mhdelano-ai/ELISA/cad/out/assembly/section_port_insert_P_in_P_byp.png

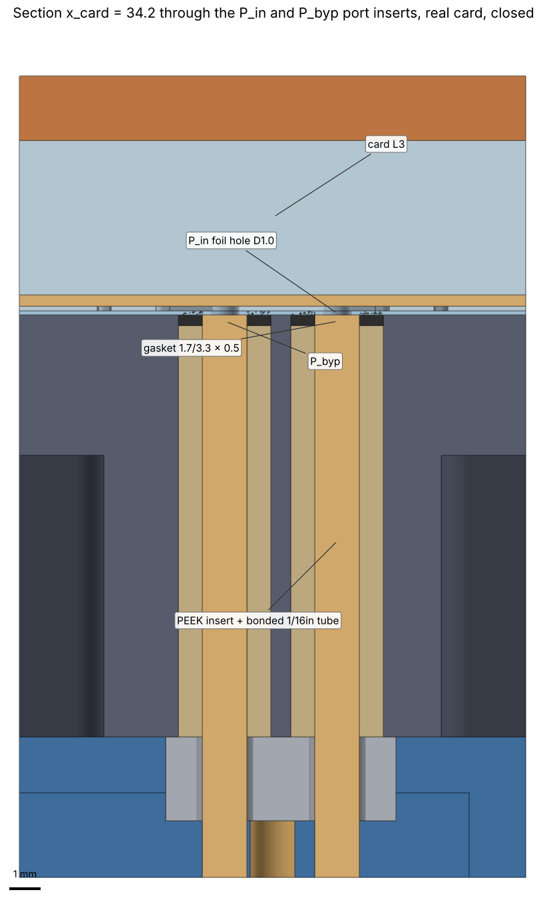
cad/out/assembly/section_port_insert_P_in_P_byp.png
