mhdelano-ai/ELISA/cad/out/assembly/section_cell_die_pogo_Md.png

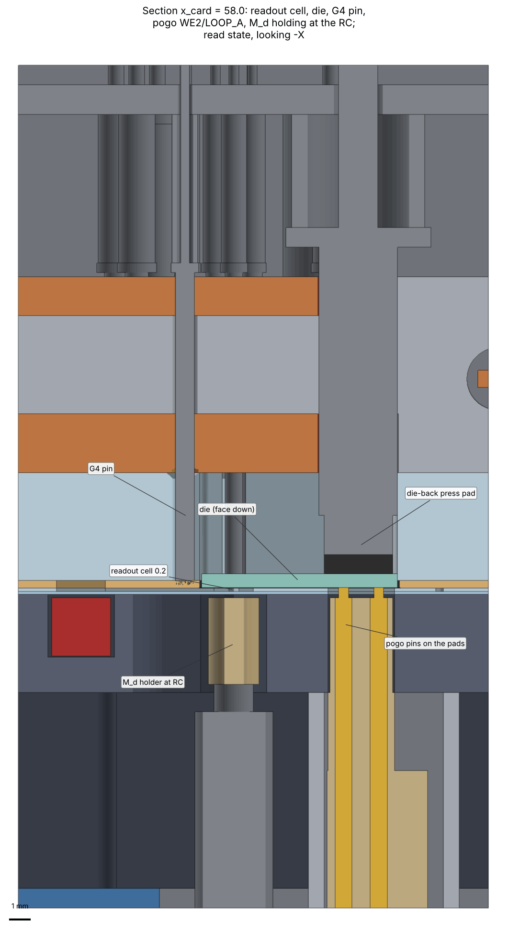
cad/out/assembly/section_cell_die_pogo_Md.png
