mhdelano-ai/ELISA/docs/25_session_record_physical_design.md

# Session record — physical design of cartridge A and its dock (2026-11-12/13)

A record of how docs/18–24 and `cad/` came about: what the user asked, every question put to the user and the answer
given, which agent did what, and where each output is. It contains no new technical claims; the authoritative tables
are in docs/23 (§8 choices, §9 deviations from docs/13, §10 open items) and docs/24 §8 (resolution of the review).

## 1. The request

> "Orchestrate Opus subagents to perform the physical design of the dock and the cartridges."

Followed by "Interview me if you have any questions." and, after the working branch was found to be behind `main`
(no cartridge documents yet), "Repo has been updated please retry".

## 2. Interview — every question and answer

| # | Question | Answer |
|---|---|---|
| 1 | Which cartridges? | A only (B and C′ not touched) |
| 2 | What is the deliverable? | 3D CAD, no automatic checks (STEP files, renders, design documents; one-off checks reported) |
| 3 | Which build stage? | C2 prototype (laminated card, CNC-milled COC upper body; dock from catalogue actuators and machined parts) |
| 4 | Which dock? | Dedicated A dock |
| 5 | Where does the dock stand? | Bench, beside the stack; no hard size limit, minimise footprint |
| 6 | How deep should the dock design go? | Mechanism + layout + enclosure (card bay detailed; pumps, bottles, electronics as placed envelope bodies) |
| 7 | Checkpoints? | No checkpoint (run to the end; agents' questions recorded as open items) |
| 8 | Who decides open points? | Agents decide and list the choices (docs/13 not edited; departures flagged as deviations) |

## 3. Agent tasks

All agents ran on the Opus model, in the background. `cad/elisa_cad/interface.py` was written first and is the single
source of truth for the geometry shared between the card and the dock.

| Phase | Agent task | Output |
|---|---|---|
| 1 | Card–dock interface definition | docs/18, `interface.py`, `cad/out/interface/` |
| 2 | Card physical design | docs/19, `cad/elisa_cad/card/` |
| 2 | Dock lid and head (valve plungers, pneumatics, clamp) | docs/20, `cad/elisa_cad/dock_upper/` |
| 2 | Dock lower bay (nest, anvil, magnets, electrode bay, thermal) | docs/21, `cad/elisa_cad/dock_lower/` |
| 2 | Dock base, fluidics layout, enclosure | docs/22, `cad/elisa_cad/dock_base/` |
| 3 | Integration: interface change requests, Revision B, top-level assembly, cross-module checks | docs/23, `cad/elisa_cad/assembly/` |
| 4 | Independent adversarial review (no edits to the design) | docs/24 §1–§7 |
| 5 | Resolution of the review findings, interface Revision C, full rebuild | docs/24 §8, edits in docs/18–23 and `cad/` |

Eight agent tasks. The four phase-2 agents worked in parallel against the phase-1 interface, which is why the
integration phase had about a dozen conflicts to settle (docs/23 §2).

## 4. Orchestrator decisions

The review ended with three questions for the user. Because the user had chosen "no checkpoint" and "agents decide",
the orchestrator set the direction for each and had them listed in docs/23 §8 as choices the user may overrule:

* **Carry-over:** the 1×10⁻⁴ criterion is fixed, so the design was changed until the paper budget of docs/13 §8.3
  closed again, rather than leaving the proof to the bench alone.
* **Reagent cold zone:** solve inside the 470 × 420 mm footprint first; a remote heat sink only as fallback.
* **Junction gates and drag slot:** local departures from docs/13 dimensions allowed, flagged as deviations.

## 5. Commits of the session

| Commit | Subject |
|---|---|
| `3d6dfdd` | Add card-dock interface definition for cartridge A (docs/18, cad/elisa_cad/interface.py) |
| `744bae3` | Add physical design of cartridge A for the C2 prototype (docs/19, cad/elisa_cad/card) |
| `39b167a` | Work in progress: dock lid, lower bay and base designs (agents still extending) |
| `2465d38` | Add dock lid and head design (docs/20, cad/elisa_cad/dock_upper); lower bay and base in progress |
| `853114a` | Work in progress: dock lower bay and base designs (agents still extending) |
| `e7f866e` | Add dock base, fluidics layout and enclosure design (docs/22, cad/elisa_cad/dock_base); lower bay in progress |
| `52fb70e` | Add dock lower bay design: nest, anvil, magnet bay, electrode bay (docs/21, cad/elisa_cad/dock_lower) |
| `d95b021` | Integrate card and dock modules (docs/23, interface Revision B, top-level assembly) |
| `7ed9bdc` | Add independent review of the dock and cartridge physical design (docs/24) |
| `fe7451d` | Resolve the review findings of the dock and cartridge design (interface Revision C, docs/24 §8) |

Plus the commit that adds this record and updates CLAUDE.md. Branch `claude/determined-hawking-8mvykx`; not merged
into `main`.

## 6. What is not in the repository

* The agents' full transcripts and the reviewer's scratch scripts (their results are in docs/24 §5).
* The optional `--all-states` STEP outputs (regenerate with the commands in `cad/README.md`); the default outputs in
  `cad/out/` match the code.
* Vendor pages and data sheets the agents opened (URLs are in the source sections of docs/18–24).
