mhdelano-ai/ELISA/results/design/inline_chamber.md

# One-step format with a timed in-line incubation chamber (approximation)

Revised after the final review (docs/08 S9, S13): thin-layer cell (Stage-3 default), stirred-capture factor sampled on [0.2, 1.0]/2.2 (mode 0.45), 1/0.96 transfer factor applied to every draw before P. '~' = chamber approximation.

| Variant | LOD nominal (pg/mL) | LOD median [5-95 %] | P(LOD<=1) | P(success) | time to result (min) | constraints |
|---|---|---|---|---|---|---|
| chamber, incubation 30 min, accumulation 10 min | 0.6 | 3.5 [0.51-1.6e+02] | ~0.17 | ~0.16 | 56.1 | ok |
| chamber, incubation 30 min, accumulation 7.5 min | 0.64 | 3.9 [0.54-1.8e+02] | ~0.16 | ~0.15 | 53.6 | ok |
| chamber, incubation 25 min, accumulation 10 min | 0.65 | 4.2 [0.57-1.7e+02] | ~0.15 | ~0.14 | 51.1 | ok |
| chamber, incubation 35 min, accumulation 5 min | 0.7 | 3.9 [0.55-1.9e+02] | ~0.16 | ~0.15 | 56.1 | ok |
