mhdelano-ai/ELISA/results/design/kill_thresholds.md

# Kill-threshold scenarios (bench-consistent; revised after the final review, docs/08 B3)

n = 1000; designs of final_designs.py (thin-layer default, S13 corrections). The decision rule is now on P (results/design/g1_decision_table.md); these thresholds are fast screens only.

| Design | Threshold scenario (bench-consistent) | LOD nominal | LOD median | P(success) |
|---|---|---|---|---|
| P-chamb | label factor 0.04 (docs/05 U1 confirm level) | 0.6 | 2.2 | 0.21 |
| P-chamb | label factor 0.15 (docs/05 U1 kill level) | 2 | 5.2 | 0.04 |
| P-chamb | free HQ 1e-4 (U3 kill) | 1.7 | 6.1 | 0.06 |
| P-chamb | free HQ 1e-5 (U3 accept) | 0.6 | 3 | 0.16 |
| B-bed | label factor 0.04 (docs/05 U1 confirm level) | 0.85 | 2.9 | 0.07 |
| B-bed | label factor 0.15 (docs/05 U1 kill level) | 2.8 | 8.3 | 0.01 |
| B-bed | free HQ 1e-4 (U3 kill) | 0.91 | 3.6 | 0.07 |
| B-bed | free HQ 1e-5 (U3 accept) | 0.85 | 3.3 | 0.09 |
| S-chamb | label factor 0.04 (docs/05 U1 confirm level) | 0.42 | 2 | 0.15 |
| S-chamb | label factor 0.15 (docs/05 U1 kill level) | 1.4 | 5.1 | 0.02 |
| S-chamb | free HQ 1e-4 (U3 kill) | 0.6 | 3.6 | 0.07 |
| S-chamb | free HQ 1e-5 (U3 accept) | 0.42 | 2.8 | 0.12 |
