mhdelano-ai/ELISA/results/design/recovery_options.md

# Automated recovery of simultaneous incubation (no reagent in sample vials)

n = 2000, seed 20261111; '~' = chamber approximation. Revised after the final review (docs/08 S9, S13): thin-layer cell, sampled stirring factor (route C keeps its pinned 0.09), 1/0.96 applied per draw before P.

| Option | Scenario | LOD nominal | LOD median [5-95 %] | P(LOD<=1) | P(success) | time to result |
|---|---|---|---|---|---|---|
| A SIA dispenser + stirred cup (one-step) | S0 audited | 0.6 | 3.5 [0.51-1.6e+02] | ~0.17 | ~0.16 | 56.1 |
| A SIA dispenser + stirred cup (one-step) | L6+L7 screening passed | 0.19 | 1.3 [0.34-9.3] | ~0.35 | ~0.32 | 56.1 |
| B SM-FL injects shared bead/conjugate vial into cup (bead dose CV 0.15) | S0 audited | 0.86 | 4.4 [0.63-1.6e+02] | ~0.12 | ~0.11 | 56.1 |
| B SM-FL injects shared bead/conjugate vial into cup (bead dose CV 0.15) | L6+L7 screening passed | 0.28 | 1.7 [0.42-15] | ~0.27 | ~0.25 | 56.1 |
| C unstirred held-up coil (capture factor 0.09) | S0 audited | 2.6 | 8.9 [1-3.3e+02] | ~0.04 | ~0.04 | 56.1 |
| C unstirred held-up coil (capture factor 0.09) | L6+L7 screening passed | 0.84 | 3.2 [0.66-26] | ~0.12 | ~0.12 | 56.1 |
| S sequential mode on hardware A | S0 audited | 0.42 | 3 [0.56-26] | ~0.16 | ~0.13 | 58.1 |
| S sequential mode on hardware A | L6+L7 screening passed | 0.34 | 2.1 [0.49-16] | ~0.21 | ~0.17 | 58.1 |
