mhdelano-ai/ELISA/results/design/final_designs.md

# Final candidate designs under the decisive scenarios

n = 2000, seed 20261111. Revised after the final review (docs/08). Detector: commercial single-channel thin-layer cell (Stage-3 default, docs/08 S9). '~': chamber approximation; stirred-capture factor sampled on [0.2, 1.0]/2.2 (mode 0.45) and the 1/0.96 transfer factor applied to every draw before P (S13). F-seq and P-vial put reagent in the sample vial (inadmissible, reference only).

| Design | Scenario | LOD nominal (pg/mL) | LOD median [5-95 %] (pg/mL) | P(LOD<=1) | P(success) | ULOQ nominal | time to result (min) | constraint flags |
|---|---|---|---|---|---|---|---|---|
| P-vial | S0 audited baseline | 0.33 | 1.4 [0.31-25] | 0.35 | 0.30 | 1.8e+03 | 59.5 | ok |
| P-vial | S2a detection reagent screened (koff 1e-4, <=1.9e-4 /s) | 0.14 | 0.96 [0.24-7] | 0.52 | 0.43 | 7.9e+02 | 59.5 | nominal ULOQ 794 < 1000 pg/mL |
| P-vial | S2b capture reagent unscreened (koff to 8.3e-3 /s) | 0.33 | 2 [0.36-45] | 0.28 | 0.24 | 1.8e+03 | 59.5 | ok |
| P-vial | S1 old NSB rate (label factor 1.0, 0.3-3; x25) | 7.9 | 23 [2.3-4.4e+02] | 0.01 | 0.00 | 1.8e+03 | 59.5 | ok |
| P-vial | S3a NSB partly reversible, fraction removed by washes = ma.design_levers.nsb_fra | 0.19 | 1.1 [0.24-17] | 0.47 | 0.41 | 1.8e+03 | 59.5 | ok |
| P-vial | S3b NSB irreversible and surfaces at high bound (tubing factor 30) | 0.51 | 1.8 [0.36-30] | 0.30 | 0.25 | 1.8e+03 | 59.5 | ok |
| P-vial | S4a free HQ in substrate 1e-3 (high bound) | 6.2 | 11 [1.2-1.9e+02] | 0.03 | 0.02 | 1.8e+03 | 59.5 | ok |
| P-vial | S4b free HQ in substrate 1e-7 (low bound) | 0.33 | 1.2 [0.28-16] | 0.41 | 0.35 | 1.8e+03 | 59.5 | ok |
| P-vial | S5 <=100 uL DRAWN: PLNO 75 uL on the 100 uL loop | 0.35 | 1.6 [0.33-25] | 0.33 | 0.29 | 3e+03 | 59.5 | ok |
| P-vial | C1 human-IgG contamination of blanks up to 1 pg/mL-equivalent (6.7 fM; nominal 0 | 0.33 | 2 [0.44-25] | 0.20 | 0.16 | 1.8e+03 | 59.5 | ok |
| P-vial | L6+L7 (reagent + substrate screening) | 0.14 | 0.86 [0.22-4.5] | 0.59 | 0.49 | 7.9e+02 | 59.5 | nominal ULOQ 794 < 1000 pg/mL |
| P-vial | L1+L3+L6+L7 | 0.074 | 0.68 [0.16-2.3] | 0.74 | 0.64 | 7.9e+02 | 59.5 | nominal ULOQ 794 < 1000 pg/mL |
| P-vial | L4 immune-complex transfer: NSB x0.1 / signal x0.7 => label factor x0.14 [OUTSID | 0.12 | 0.81 [0.16-11] | 0.60 | 0.54 | 1.8e+03 | 59.5 | ok |
| P-chamb | S0 audited baseline | 0.6 | 3.5 [0.51-1.6e+02] | ~0.17 | ~0.16 | 5.2e+03 | 56.1 | ok |
| P-chamb | S2a detection reagent screened (koff 1e-4, <=1.9e-4 /s) | 0.2 | 1.7 [0.39-18] | ~0.29 | ~0.26 | 1.8e+03 | 56.1 | ok |
| P-chamb | S2b capture reagent unscreened (koff to 8.3e-3 /s) | 0.6 | 5.8 [0.6-3.8e+02] | ~0.13 | ~0.12 | 5.2e+03 | 56.1 | ok |
| P-chamb | S1 old NSB rate (label factor 1.0, 0.3-3; x25) | 13 | 54 [4.5-2.4e+03] | ~0.00 | ~0.00 | 5.2e+03 | 56.1 | ok |
| P-chamb | S3a NSB partly reversible, fraction removed by washes = ma.design_levers.nsb_fra | 0.38 | 2.3 [0.4-1e+02] | ~0.24 | ~0.22 | 5.2e+03 | 56.1 | ok |
| P-chamb | S3b NSB irreversible and surfaces at high bound (tubing factor 30) | 0.9 | 4.4 [0.59-1.9e+02] | ~0.14 | ~0.13 | 5.2e+03 | 56.1 | ok |
| P-chamb | S4a free HQ in substrate 1e-3 (high bound) | 16 | 38 [3.1-1.3e+03] | ~0.00 | ~0.00 | 5.2e+03 | 56.1 | ok |
| P-chamb | S4b free HQ in substrate 1e-7 (low bound) | 0.58 | 2.6 [0.44-89] | ~0.21 | ~0.20 | 5.2e+03 | 56.1 | ok |
| P-chamb | S5 <=100 uL DRAWN: PLNO 75 uL on the 100 uL loop | 0.65 | 3.8 [0.55-1.5e+02] | ~0.14 | ~0.13 | 6.8e+03 | 56.1 | ok |
| P-chamb | C1 human-IgG contamination of blanks up to 1 pg/mL-equivalent (6.7 fM; nominal 0 | 0.6 | 3.6 [0.71-1.6e+02] | ~0.10 | ~0.09 | 5.2e+03 | 56.1 | ok |
| P-chamb | L6+L7 (reagent + substrate screening) | 0.19 | 1.3 [0.34-9.3] | ~0.35 | ~0.32 | 1.8e+03 | 56.1 | ok |
| P-chamb | L1+L3+L6+L7 | 0.11 | 0.98 [0.25-4.9] | ~0.51 | ~0.48 | 1.8e+03 | 56.1 | ok |
| P-chamb | L4 immune-complex transfer: NSB x0.1 / signal x0.7 => label factor x0.14 [OUTSID | 0.29 | 1.5 [0.28-70] | ~0.35 | ~0.33 | 5.2e+03 | 56.1 | ok |
| B-bed | S0 audited baseline | 0.85 | 3.4 [0.65-33] | 0.12 | 0.09 | 1e+03 | 51.5 | ok |
| B-bed | S2a detection reagent screened (koff 1e-4, <=1.9e-4 /s) | 0.71 | 3 [0.6-25] | 0.15 | 0.11 | 7.9e+02 | 51.5 | nominal ULOQ 794 < 1000 pg/mL |
| B-bed | S2b capture reagent unscreened (koff to 8.3e-3 /s) | 0.85 | 4.9 [0.78-1e+02] | 0.09 | 0.06 | 1e+03 | 51.5 | ok |
| B-bed | S1 old NSB rate (label factor 1.0, 0.3-3; x25) | 19 | 64 [6.6-7.8e+02] | 0.00 | 0.00 | 1e+03 | 51.5 | ok |
| B-bed | S3a NSB partly reversible, fraction removed by washes = ma.design_levers.nsb_fra | 0.57 | 2.3 [0.51-19] | 0.20 | 0.14 | 1e+03 | 51.5 | ok |
| B-bed | S3b NSB irreversible and surfaces at high bound (tubing factor 30) | 1.5 | 5 [0.87-45] | 0.06 | 0.04 | 1e+03 | 51.5 | ok |
| B-bed | S4a free HQ in substrate 1e-3 (high bound) | 3.2 | 9.3 [1.5-76] | 0.02 | 0.01 | 1e+03 | 51.5 | ok |
| B-bed | S4b free HQ in substrate 1e-7 (low bound) | 0.85 | 3.3 [0.67-29] | 0.13 | 0.09 | 1e+03 | 51.5 | ok |
| B-bed | S5 <=100 uL DRAWN: PLNO 75 uL on the 100 uL loop | 1.1 | 4.6 [0.88-42] | 0.07 | 0.06 | 1.4e+03 | 51.5 | ok |
| B-bed | C1 human-IgG contamination of blanks up to 1 pg/mL-equivalent (6.7 fM; nominal 0 | 0.85 | 3.6 [0.9-33] | 0.07 | 0.05 | 1e+03 | 51.5 | ok |
| B-bed | L6+L7 (reagent + substrate screening) | 0.71 | 2.8 [0.59-23] | 0.15 | 0.11 | 7.9e+02 | 51.5 | nominal ULOQ 794 < 1000 pg/mL |
| B-bed | L1+L3+L6+L7 | 0.46 | 1.7 [0.43-13] | 0.28 | 0.20 | 7.9e+02 | 51.5 | nominal ULOQ 794 < 1000 pg/mL |
| B-bed | L4 immune-complex transfer: NSB x0.1 / signal x0.7 => label factor x0.14 [OUTSID | 0.44 | 1.4 [0.36-10] | 0.34 | 0.26 | 1e+03 | 51.5 | ok |
| F-seq | S0 audited baseline | 0.36 | 1.8 [0.41-14] | 0.26 | 0.21 | 1.4e+03 | 58.5 | ok |
| F-seq | S2a detection reagent screened (koff 1e-4, <=1.9e-4 /s) | 0.29 | 1.5 [0.38-11] | 0.31 | 0.24 | 1e+03 | 58.5 | ok |
| F-seq | S2b capture reagent unscreened (koff to 8.3e-3 /s) | 0.36 | 2.7 [0.48-71] | 0.19 | 0.15 | 1.4e+03 | 58.5 | ok |
| F-seq | S1 old NSB rate (label factor 1.0, 0.3-3; x25) | 7.5 | 28 [3.4-2.8e+02] | 0.00 | 0.00 | 1.4e+03 | 58.5 | ok |
| F-seq | S3a NSB partly reversible, fraction removed by washes = ma.design_levers.nsb_fra | 0.24 | 1.3 [0.32-9.4] | 0.38 | 0.32 | 1e+03 | 58.5 | ok |
| F-seq | S3b NSB irreversible and surfaces at high bound (tubing factor 30) | 1.3 | 3.9 [0.71-33] | 0.10 | 0.07 | 1.4e+03 | 58.5 | ok |
| F-seq | S4a free HQ in substrate 1e-3 (high bound) | 3.7 | 8.2 [1.3-69] | 0.02 | 0.01 | 1.4e+03 | 58.5 | ok |
| F-seq | S4b free HQ in substrate 1e-7 (low bound) | 0.35 | 1.5 [0.4-11] | 0.30 | 0.24 | 1.4e+03 | 58.5 | ok |
| F-seq | S5 <=100 uL DRAWN: PLNO 75 uL on the 100 uL loop | 0.43 | 2 [0.49-16] | 0.21 | 0.18 | 1.8e+03 | 58.5 | ok |
| F-seq | C1 human-IgG contamination of blanks up to 1 pg/mL-equivalent (6.7 fM; nominal 0 | 0.36 | 2.3 [0.6-14] | 0.15 | 0.11 | 1.4e+03 | 58.5 | ok |
| F-seq | L6+L7 (reagent + substrate screening) | 0.29 | 1.3 [0.36-8.5] | 0.35 | 0.28 | 1e+03 | 58.5 | ok |
| F-seq | L1+L3+L6+L7 | 0.18 | 0.91 [0.26-3.6] | 0.57 | 0.48 | 1e+03 | 58.5 | ok |
| F-seq | L4 immune-complex transfer: NSB x0.1 / signal x0.7 => label factor x0.14 [OUTSID | 0.2 | 0.95 [0.24-6.3] | 0.53 | 0.45 | 1e+03 | 58.5 | ok |
| S-chamb | S0 audited baseline | 0.42 | 3 [0.56-26] | ~0.16 | ~0.13 | 1.4e+03 | 58.1 | ok |
| S-chamb | S2a detection reagent screened (koff 1e-4, <=1.9e-4 /s) | 0.35 | 2.4 [0.5-21] | ~0.19 | ~0.16 | 1e+03 | 58.1 | ok |
| S-chamb | S2b capture reagent unscreened (koff to 8.3e-3 /s) | 0.42 | 4.6 [0.64-2.3e+02] | ~0.11 | ~0.09 | 1.4e+03 | 58.1 | ok |
| S-chamb | S1 old NSB rate (label factor 1.0, 0.3-3; x25) | 9 | 47 [5.3-5.4e+02] | ~0.00 | ~0.00 | 1.4e+03 | 58.1 | ok |
| S-chamb | S3a NSB partly reversible, fraction removed by washes = ma.design_levers.nsb_fra | 0.29 | 2 [0.42-16] | ~0.24 | ~0.21 | 1.4e+03 | 58.1 | ok |
| S-chamb | S3b NSB irreversible and surfaces at high bound (tubing factor 30) | 1.5 | 6.4 [0.99-62] | ~0.05 | ~0.04 | 1.4e+03 | 58.1 | ok |
| S-chamb | S4a free HQ in substrate 1e-3 (high bound) | 4.3 | 14 [2-1.2e+02] | ~0.01 | ~0.00 | 1.4e+03 | 58.1 | ok |
| S-chamb | S4b free HQ in substrate 1e-7 (low bound) | 0.42 | 2.4 [0.55-20] | ~0.17 | ~0.14 | 1.4e+03 | 58.1 | ok |
| S-chamb | S5 <=100 uL DRAWN: PLNO 75 uL on the 100 uL loop | 0.5 | 3.3 [0.64-30] | ~0.12 | ~0.11 | 1.8e+03 | 58.1 | ok |
| S-chamb | C1 human-IgG contamination of blanks up to 1 pg/mL-equivalent (6.7 fM; nominal 0 | 0.42 | 3.2 [0.78-26] | ~0.09 | ~0.07 | 1.4e+03 | 58.1 | ok |
| S-chamb | L6+L7 (reagent + substrate screening) | 0.34 | 2.1 [0.49-16] | ~0.21 | ~0.17 | 1e+03 | 58.1 | ok |
| S-chamb | L1+L3+L6+L7 | 0.21 | 1.2 [0.34-6.9] | ~0.39 | ~0.33 | 1e+03 | 58.1 | ok |
| S-chamb | L4 immune-complex transfer: NSB x0.1 / signal x0.7 => label factor x0.14 [OUTSID | 0.23 | 1.3 [0.32-12] | ~0.38 | ~0.33 | 1.4e+03 | 58.1 | ok |
