mhdelano-ai/ELISA/results/design/gain_decomposition.md

# Cumulative gain decomposition of the optimised designs

n = 1000 per row.

## OS: One-step magnetic beads (beads + conjugate in the vial), flow IDA

| Step (cumulative) | value | LOD nominal | MC median | P(success) | feasible | gain rests on |
|---|---|---|---|---|---|---|
| audited baseline | - | 0.56 | 2.3 | 0.21 | yes | - |
| ma.geometry.reactor_connection_length | 0.01 | 0.45 | 1.9 | 0.25 | yes | tubing NSB surface factor UNVERIFIED (direction certain, size not) |
| chem.antibodies.conc_detection_antibody_typical | 3e-10 | 0.51 | 2 | 0.26 | yes | linear NSB (UNVERIFIED) and detection-antibody KD; in OS also keeps ULOQ >= 1000 via Pi inhibition (Ki INHERITED) |
| ma.geometry.magnetic_trap_tube_inner_diameter | 1.5 | 0.49 | 2 | 0.27 | yes | trap-wall NSB uses the tubing surface factor (UNVERIFIED) |
| hw.smfl.loop_flush_volumes_for_transfer | 2 | 0.48 | 1.9 | 0.27 | yes | loop-transfer model (verified vs Task 2 table); time saved is re-used elsewhere |
| hw.timing.accumulation_time | 15 | 0.4 | 1.7 | 0.30 | yes | more product vs fixed free-HQ impurity and drift (both UNVERIFIED); limited by Pi inhibition (ULOQ) |
| ma.readout.sweep_flow | 10 | 0.34 | 1.6 | 0.32 | yes | flow-IDA generator conversion (slit solution, verified limits) x IDA amplification held flow-independent (empirical) |
| hw.timing.readout_time | 1 | 0.33 | 1.5 | 0.33 | yes | shorter window = less integrated noise/drift; elution in window from tanks-in-series (UNVERIFIED tanks) |
| ma.timing.in_vial_incubation | 35 | 0.32 | 1.4 | 0.34 | yes | NSB assumed linear in time (UNVERIFIED); unstirred capture factor UNVERIFIED |

## SQ: Sequential magnetic beads (beads in the vial, conjugate injected), flow IDA

| Step (cumulative) | value | LOD nominal | MC median | P(success) | feasible | gain rests on |
|---|---|---|---|---|---|---|
| audited baseline | - | 2.6 | 12 | 0.02 | no | - |
| ma.timing.in_vial_incubation | 35 | 2.3 | 11 | 0.03 | no: time to result 65.5 min > 60 | NSB assumed linear in time (UNVERIFIED); unstirred capture factor UNVERIFIED |
| chem.antibodies.conc_detection_antibody_typical | 3e-09 | 2.3 | 9.4 | 0.04 | no: time to result 65.5 min > 60 | linear NSB (UNVERIFIED) and detection-antibody KD; in OS also keeps ULOQ >= 1000 via Pi inhibition (Ki INHERITED) |
| ma.geometry.magnetic_trap_volume | 0.5 | 1.8 | 7.2 | 0.04 | no: time to result 65.5 min > 60; nominal ULOQ 794 < 1000 pg/mL | trap efficiency at smaller volume UNVERIFIED |
| ma.geometry.magnetic_trap_tube_inner_diameter | 0.75 | 1.8 | 7 | 0.04 | no: time to result 65.5 min > 60; nominal ULOQ 794 < 1000 pg/mL | trap-wall NSB uses the tubing surface factor (UNVERIFIED) |
| hw.timing.accumulation_time | 5 | 1.8 | 7.6 | 0.03 | no: time to result 60.5 min > 60 | more product vs fixed free-HQ impurity and drift (both UNVERIFIED); limited by Pi inhibition (ULOQ) |
| ma.readout.sweep_flow | 10 | 1.7 | 7.1 | 0.04 | no: time to result 60.5 min > 60 | flow-IDA generator conversion (slit solution, verified limits) x IDA amplification held flow-independent (empirical) |
| hw.timing.readout_time | 1 | 1.7 | 7 | 0.05 | yes | shorter window = less integrated noise/drift; elution in window from tanks-in-series (UNVERIFIED tanks) |
| ma.geometry.reactor_connection_length | 0.01 | 0.39 | 1.9 | 0.25 | yes | tubing NSB surface factor UNVERIFIED (direction certain, size not) |
| chem.surfaces.bead_number_per_100uL_digital_ELISA | 1.5e+06 | 0.33 | 1.5 | 0.30 | no: nominal ULOQ 794 < 1000 pg/mL | bead NSB surface factor and unstirred capture factor UNVERIFIED |
| hw.timing.conjugate_stopped_flow_incubation | 3 | 0.31 | 1.5 | 0.32 | yes | linear irreversible NSB vs equilibrating labelling (koff_detection, unscreened) |
| hw.smfl.loop_flush_volumes_for_transfer | 4 | 0.3 | 1.5 | 0.32 | yes | loop-transfer model (verified vs Task 2 table); time saved is re-used elsewhere |

## FRB: Fixed packed micro-bed (regenerated), Scheme B, flow IDA

| Step (cumulative) | value | LOD nominal | MC median | P(success) | feasible | gain rests on |
|---|---|---|---|---|---|---|
| audited baseline | - | 19 | 49 | 0.00 | yes | - |
| hw.reactors.packed_microbed_10uL.bed_volume | 0.5 | 7.2 | 30 | 0.00 | yes | packed-bed surface factor UNVERIFIED |
| ma.geometry.packed_bed_column_inner_diameter | 0.25 | 6.9 | 29 | 0.00 | yes | geometry only (W-G film transfer); small effect |
| ma.geometry.reactor_connection_length | 0.01 | 5.1 | 19 | 0.01 | yes | tubing NSB surface factor UNVERIFIED (direction certain, size not) |
| hw.timing.sample_load_flow | 15 | 1.4 | 4.6 | 0.06 | no: nominal ULOQ 464 < 1000 pg/mL | bead traps: trap efficiency vs flow UNVERIFIED; beds: Wilson-Geankoplis (recalled) + kon/density |
| hw.timing.conjugate_stopped_flow_incubation | 2 | 1.6 | 4.9 | 0.06 | yes | linear irreversible NSB vs equilibrating labelling (koff_detection, unscreened) |
| hw.timing.accumulation_time | 15 | 1.4 | 4.5 | 0.06 | no: nominal ULOQ 794 < 1000 pg/mL | more product vs fixed free-HQ impurity and drift (both UNVERIFIED); limited by Pi inhibition (ULOQ) |
| hw.reactors.packed_microbed_10uL.bead_diameter | 50 | 1.5 | 4.9 | 0.06 | yes | packed-bed surface factor UNVERIFIED; capture via Wilson-Geankoplis |
| ma.readout.sweep_flow | 10 | 1 | 4.1 | 0.09 | yes | flow-IDA generator conversion (slit solution, verified limits) x IDA amplification held flow-independent (empirical) |
| hw.timing.readout_time | 1 | 0.94 | 3.8 | 0.11 | yes | shorter window = less integrated noise/drift; elution in window from tanks-in-series (UNVERIFIED tanks) |

## FRC: Fixed chip bead bed upstream of an on-chip IDA (regenerated), Scheme C

| Step (cumulative) | value | LOD nominal | MC median | P(success) | feasible | gain rests on |
|---|---|---|---|---|---|---|
| audited baseline | - | 8.7 | 34 | 0.00 | yes | - |
| ma.geometry.chip_bead_bed_inner_diameter | 0.2 | 8.5 | 33 | 0.00 | yes | geometry only (bed area unchanged); small effect |
| ma.geometry.chip_channel_length | 3 | 7.6 | 29 | 0.00 | yes | chip-wall NSB area (chip surface factor UNVERIFIED, 1-100) |
| ma.geometry.chip_channel_width | 0.2 | 7.4 | 27 | 0.00 | yes | chip-wall NSB area (chip surface factor UNVERIFIED, 1-100) |
| hw.timing.sample_load_flow | 10 | 2.9 | 7.5 | 0.03 | no: time to result 60.5 min > 60; nominal ULOQ 794 < 1000 pg/mL | bead traps: trap efficiency vs flow UNVERIFIED; beds: Wilson-Geankoplis (recalled) + kon/density |
| ma.delivery.conjugate_injection_volume | 10 | 2.9 | 7.7 | 0.04 | no: time to result 60.5 min > 60 | linear NSB (UNVERIFIED); plug dispersion from loop model (verified) |
| hw.timing.conjugate_stopped_flow_incubation | 2 | 2.7 | 7.9 | 0.03 | yes | linear irreversible NSB vs equilibrating labelling (koff_detection, unscreened) |
| ma.geometry.chip_bead_bed_volume | 0.1 | 0.92 | 4 | 0.11 | yes | packed-bed and chip surface factors UNVERIFIED |
| hw.reactors.packed_microbed_10uL.bead_diameter | 10 | 0.97 | 3.6 | 0.11 | no: nominal ULOQ 794 < 1000 pg/mL | packed-bed surface factor UNVERIFIED; capture via Wilson-Geankoplis |
| hw.smfl.loop_flush_volumes_for_transfer | 2 | 0.94 | 3.6 | 0.11 | no: nominal ULOQ 794 < 1000 pg/mL | loop-transfer model (verified vs Task 2 table); time saved is re-used elsewhere |
| hw.timing.accumulation_time | 7.5 | 0.95 | 3.7 | 0.11 | yes | more product vs fixed free-HQ impurity and drift (both UNVERIFIED); limited by Pi inhibition (ULOQ) |
