mhdelano-ai/ELISA/cad/out/card/card_exploded.png

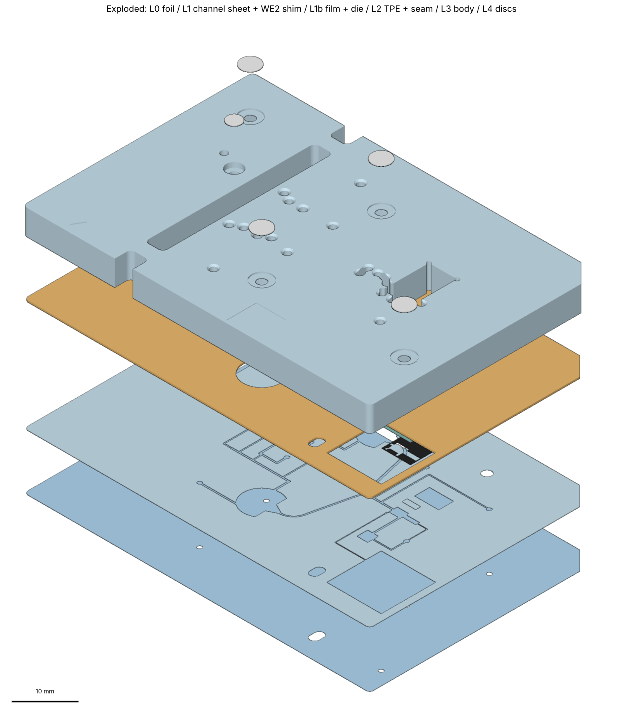
cad/out/card/card_exploded.png
