mhdelano-ai/ELISA/cad/out/card/card_iso_bottom.png

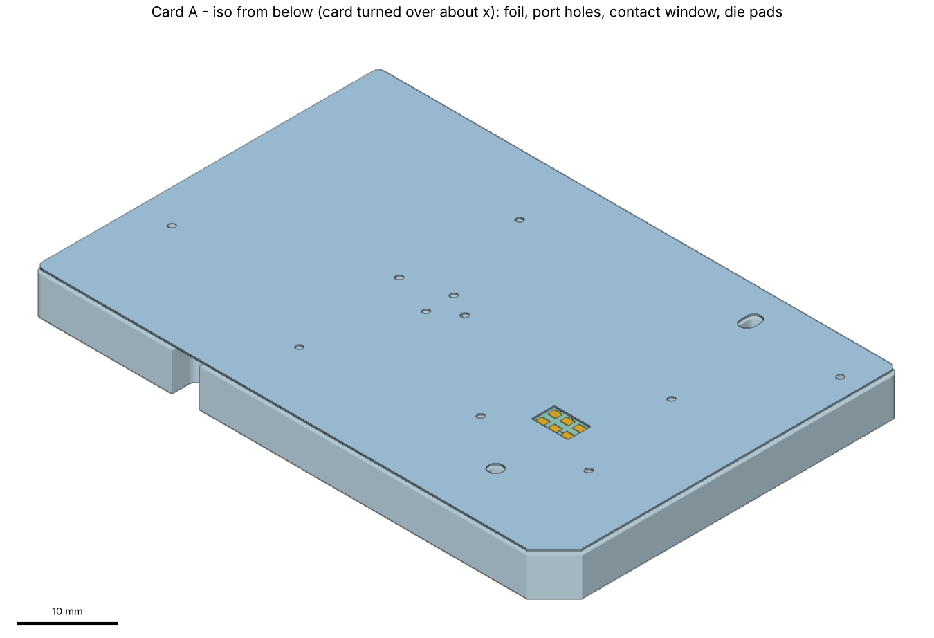
cad/out/card/card_iso_bottom.png
