mhdelano-ai/ELISA/cad/out/card/card_iso_top.png

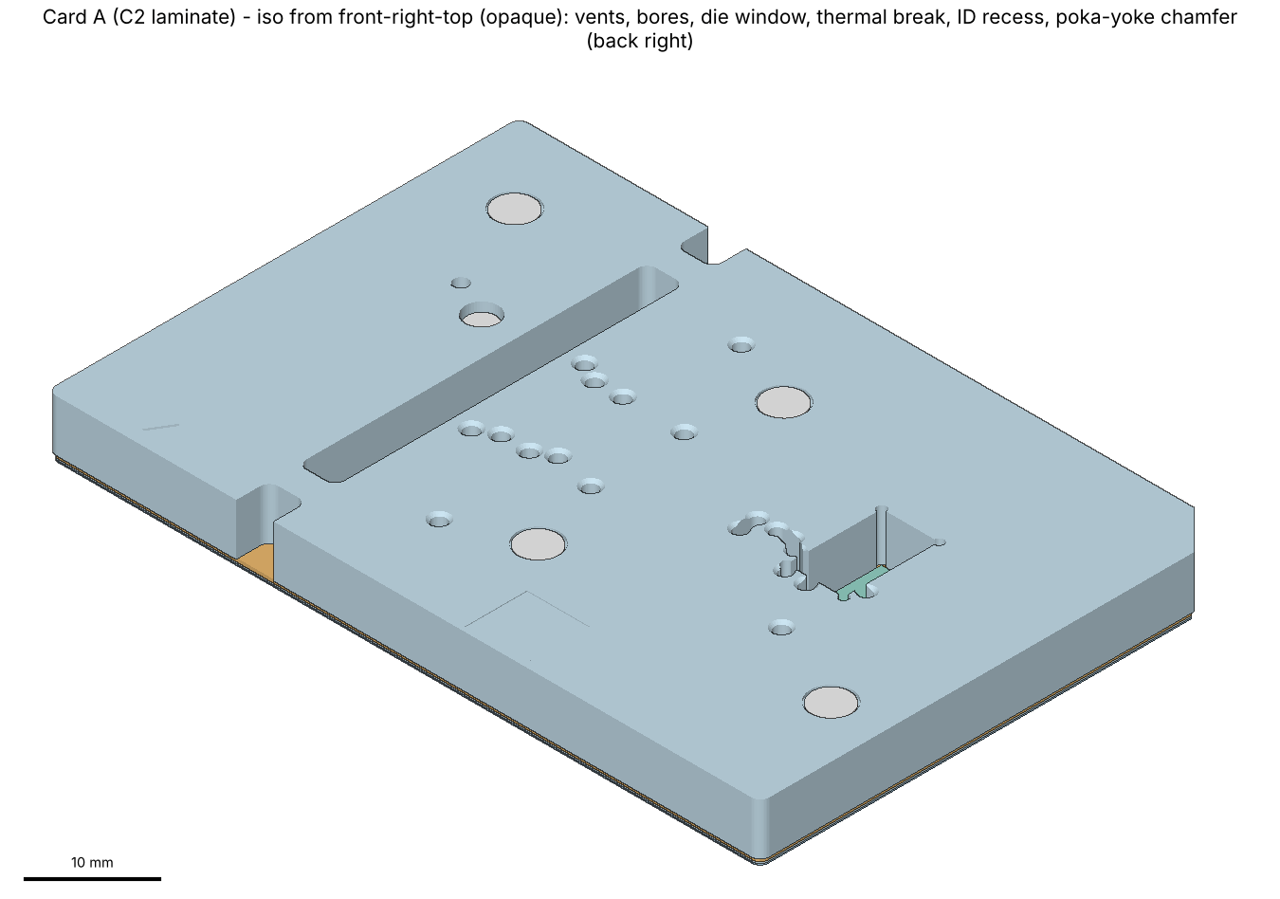
cad/out/card/card_iso_top.png
