mhdelano-ai/ELISA/cad/out/card/plan_L1.png

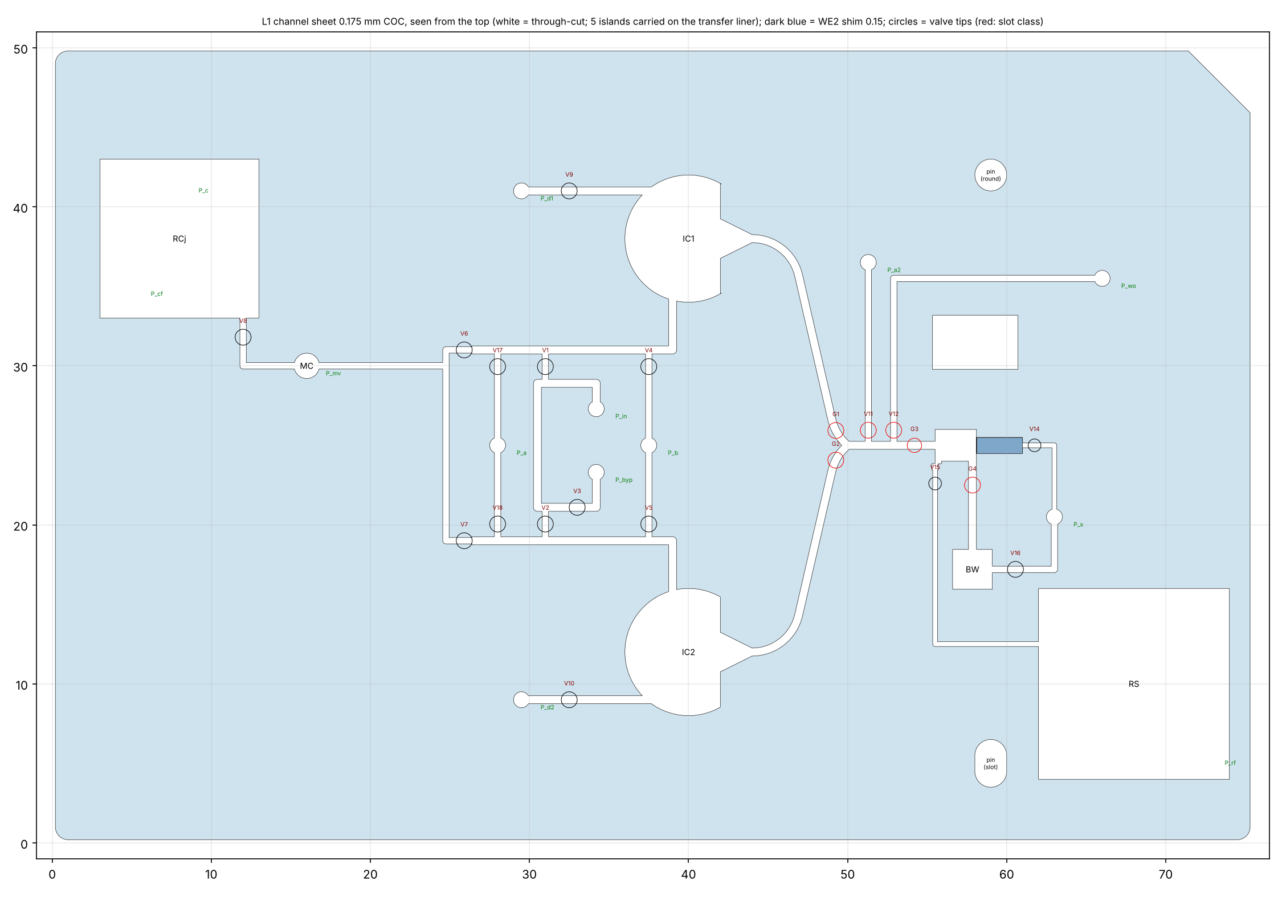
cad/out/card/plan_L1.png
