mhdelano-ai/ELISA/cad/out/card/section_cell_y25.png

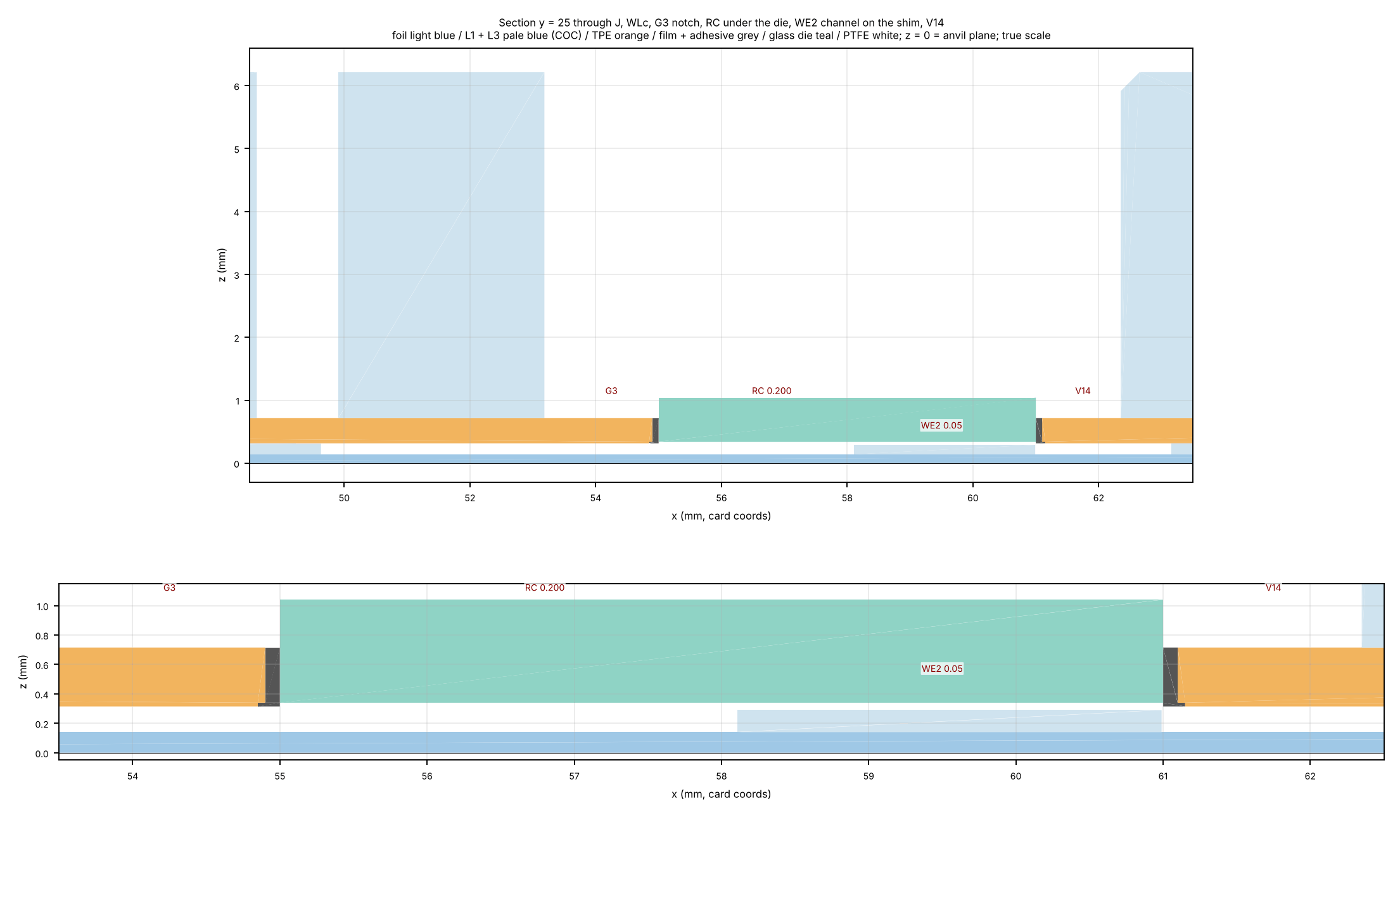
cad/out/card/section_cell_y25.png
