mhdelano-ai/ELISA/cad/out/card/section_chamber_IC1_y38.6.png

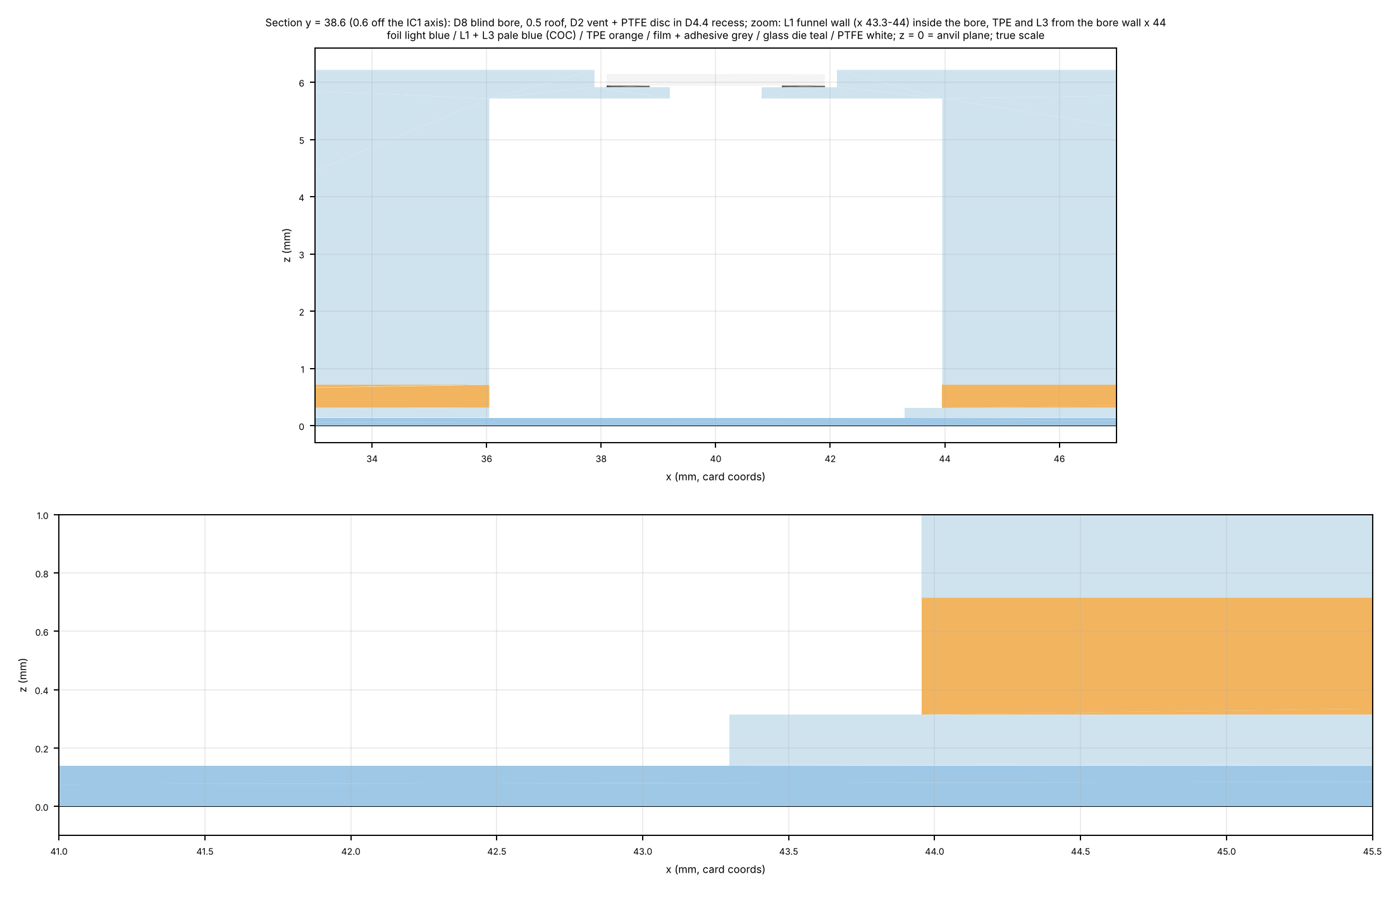
cad/out/card/section_chamber_IC1_y38.6.png
