mhdelano-ai/ELISA/cad/out/card/section_die_x57.85.png

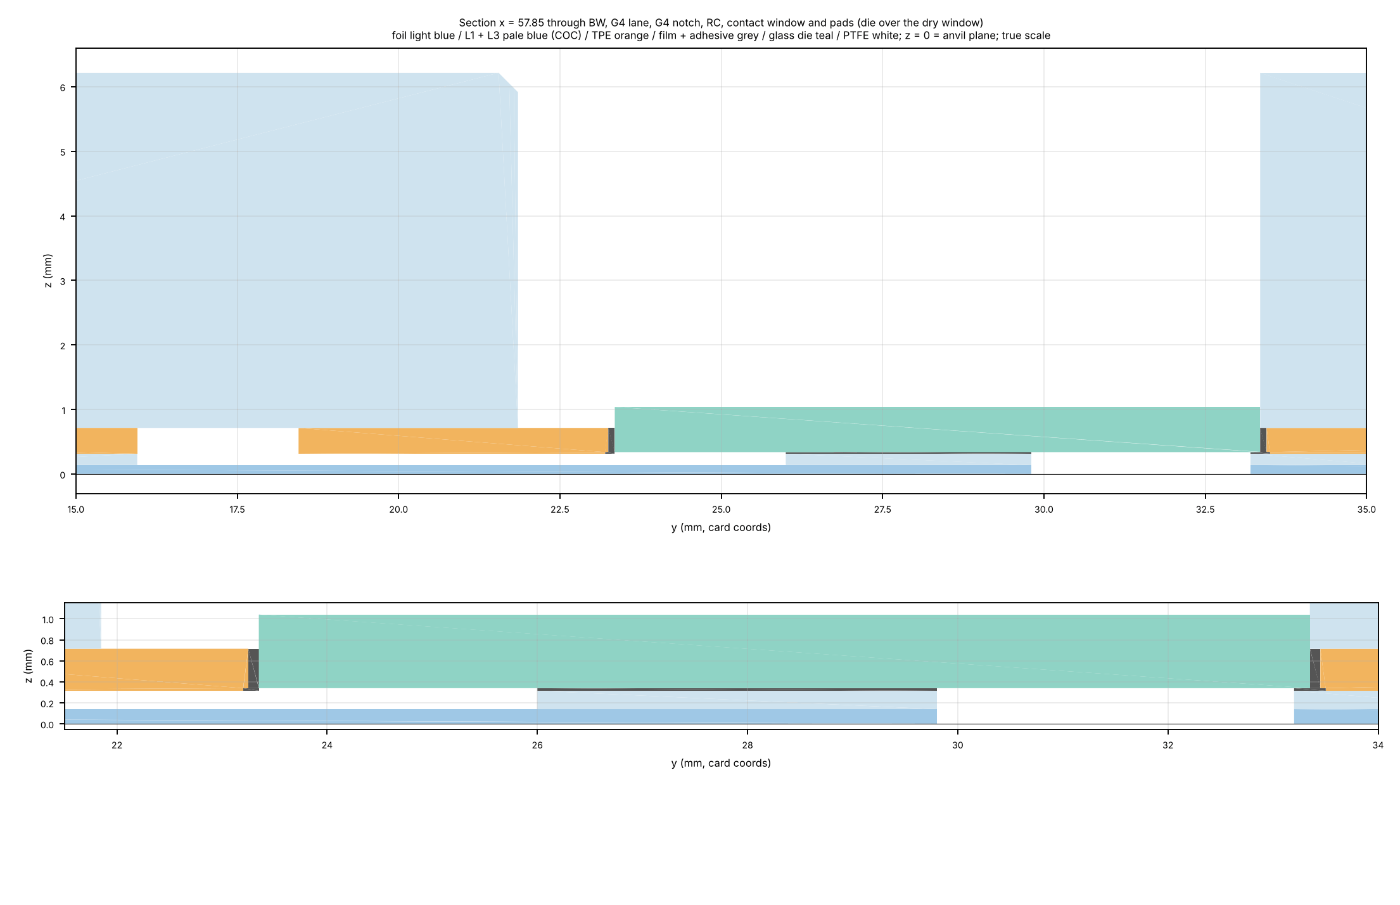
cad/out/card/section_die_x57.85.png
