mhdelano-ai/ELISA/cad/out/card/section_valves_y29.95.png

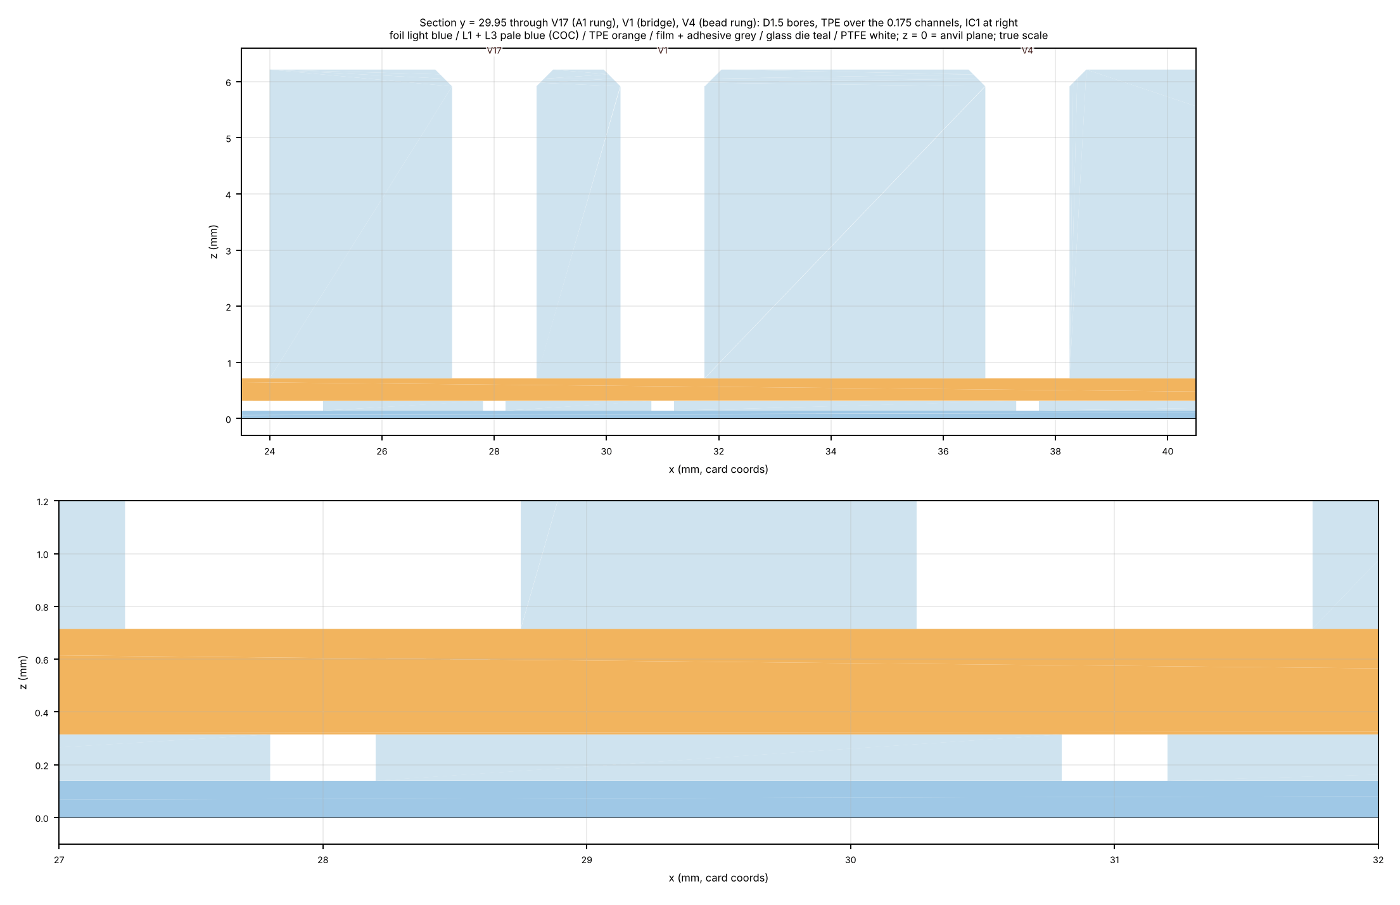
cad/out/card/section_valves_y29.95.png
