mhdelano-ai/ELISA/cad/out/card/zoom_cell_electrodes.png

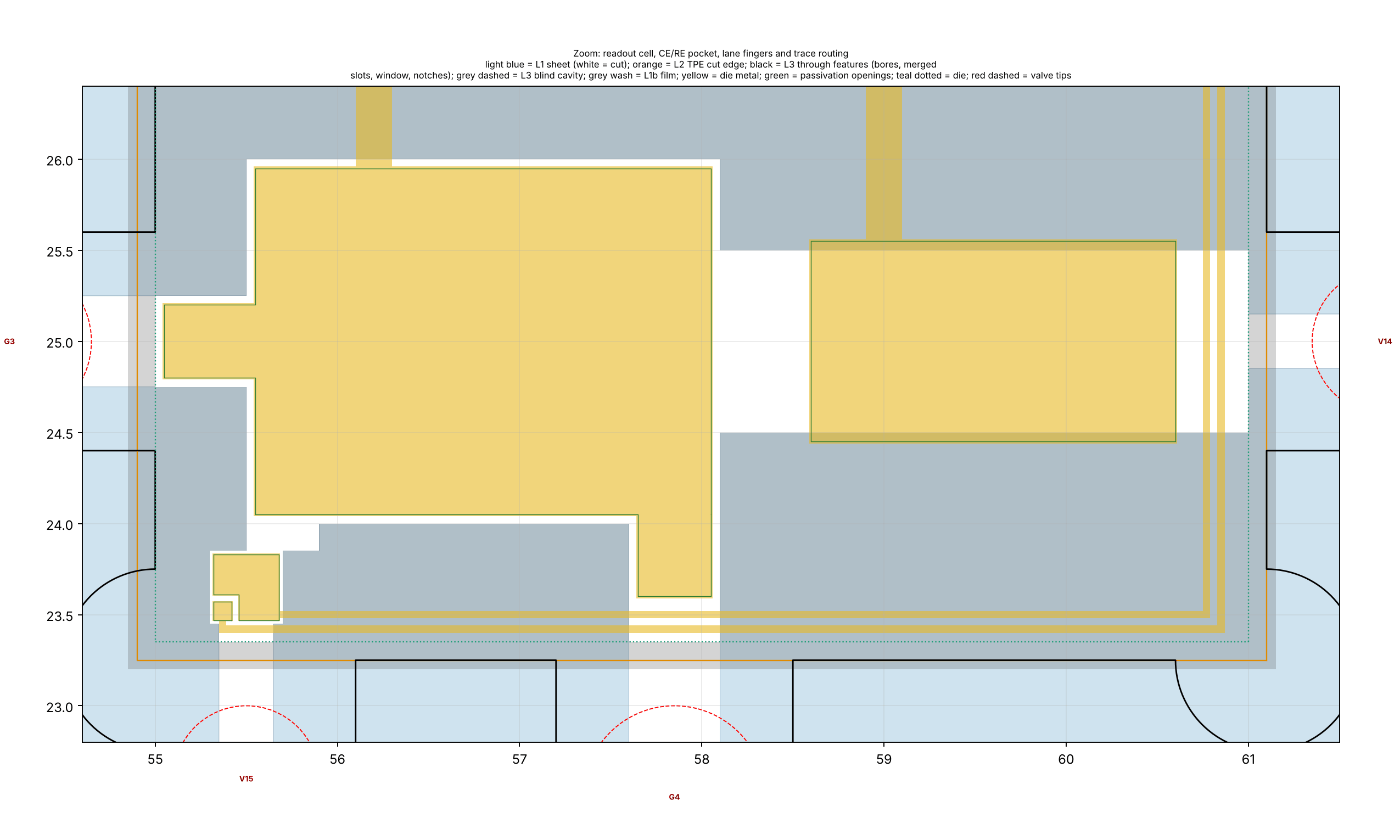
cad/out/card/zoom_cell_electrodes.png
