mhdelano-ai/ELISA/cad/out/card/zoom_junction_cell.png

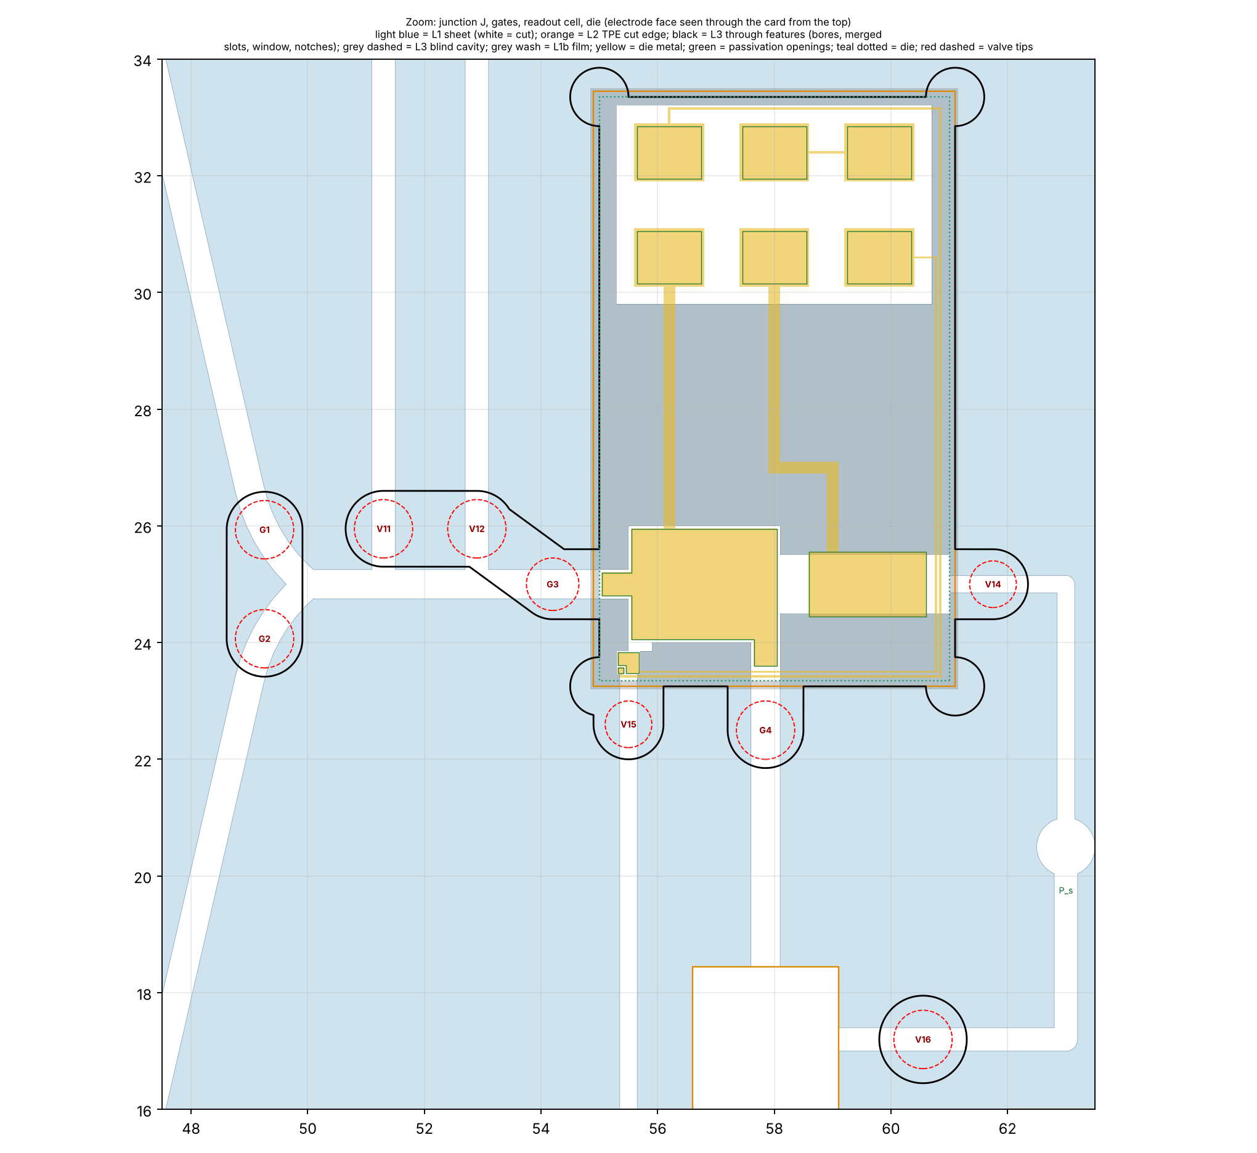
cad/out/card/zoom_junction_cell.png
