mhdelano-ai/ELISA/cad/out/card/zoom_valve_island.png

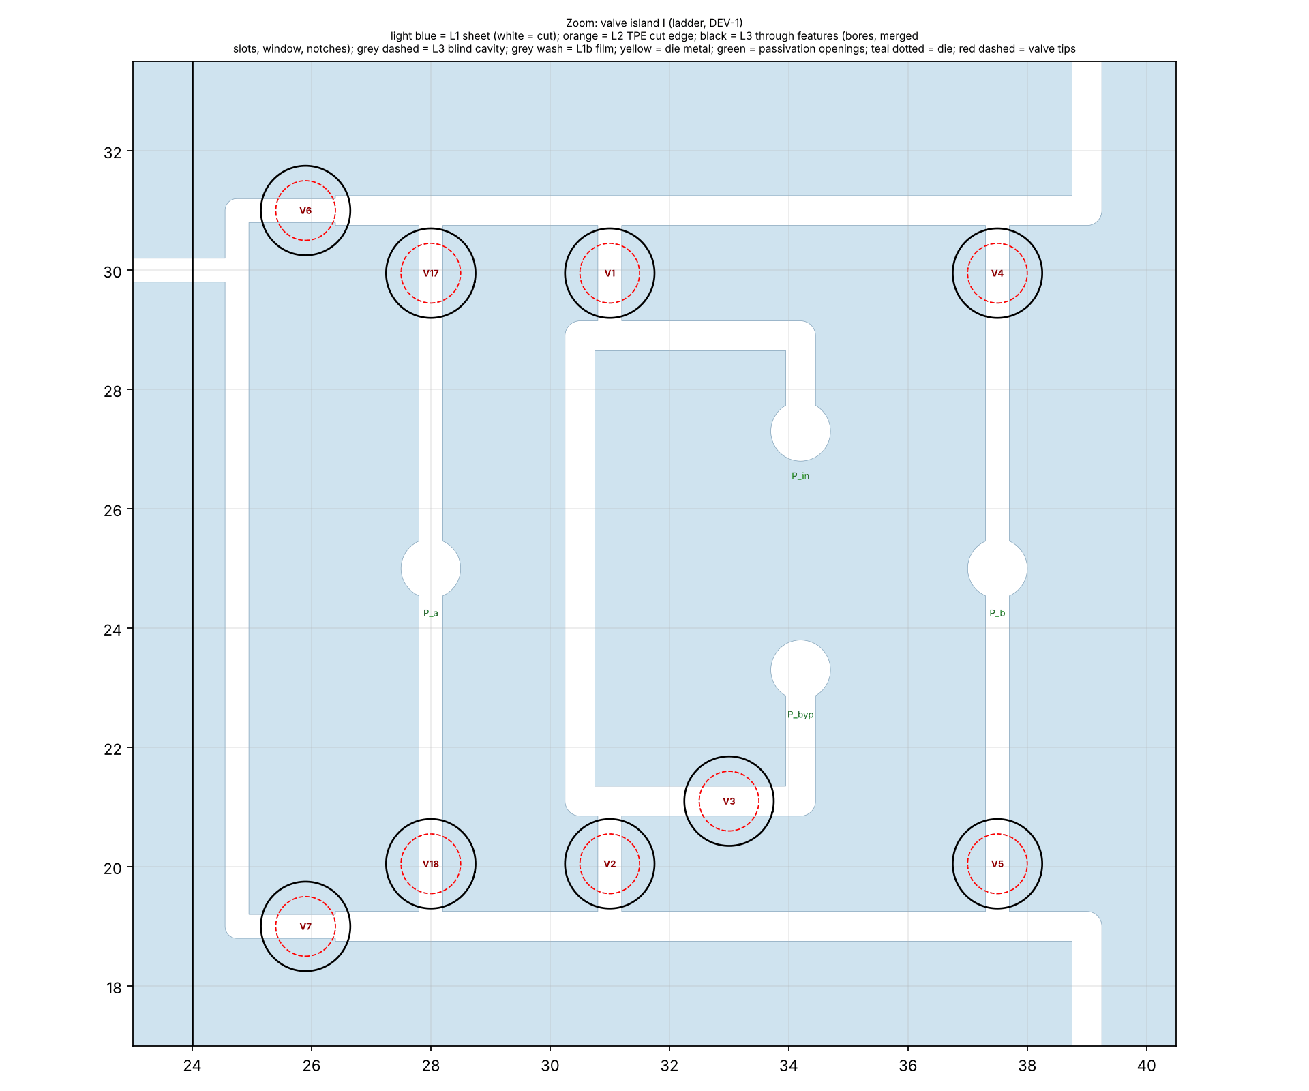
cad/out/card/zoom_valve_island.png
