mhdelano-ai/ELISA/cad/out/dock_base/fluidic_schematic.png

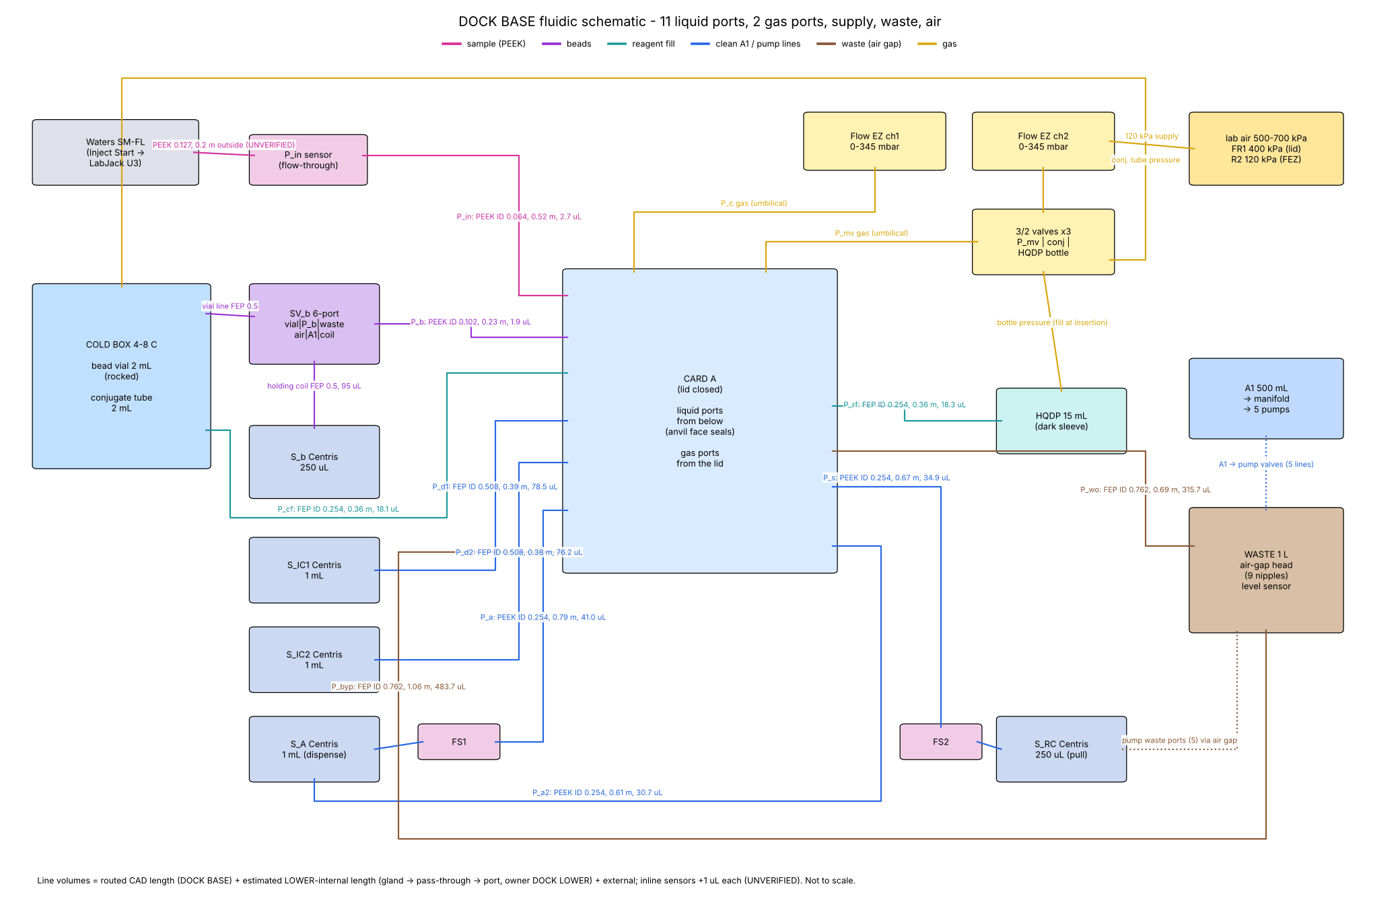
cad/out/dock_base/fluidic_schematic.png
