mhdelano-ai/ELISA/cad/out/dock_base/plan_bench_layout.png

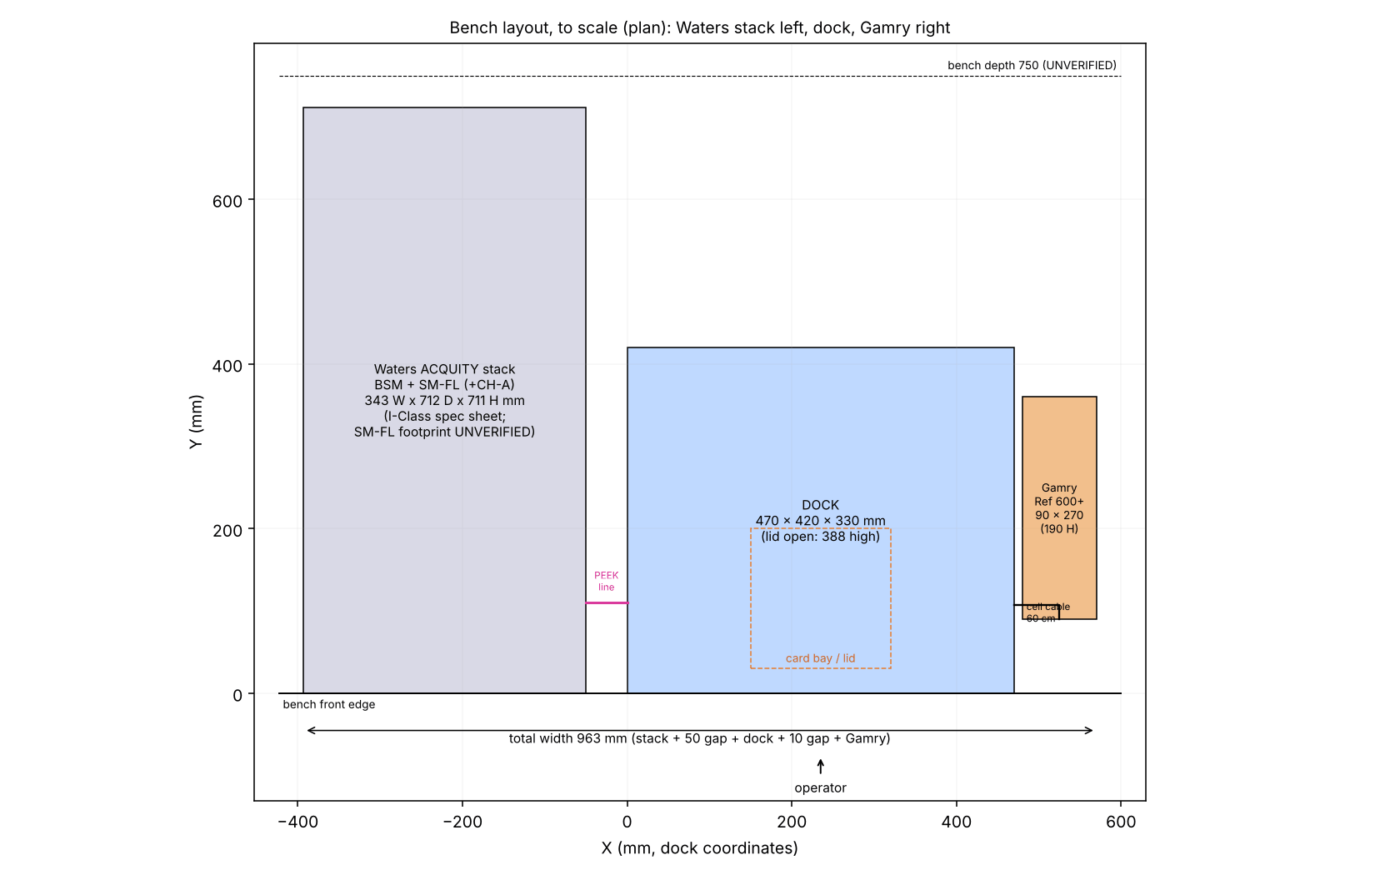
cad/out/dock_base/plan_bench_layout.png
