mhdelano-ai/ELISA/cad/out/dock_base/plan_top_labelled.png

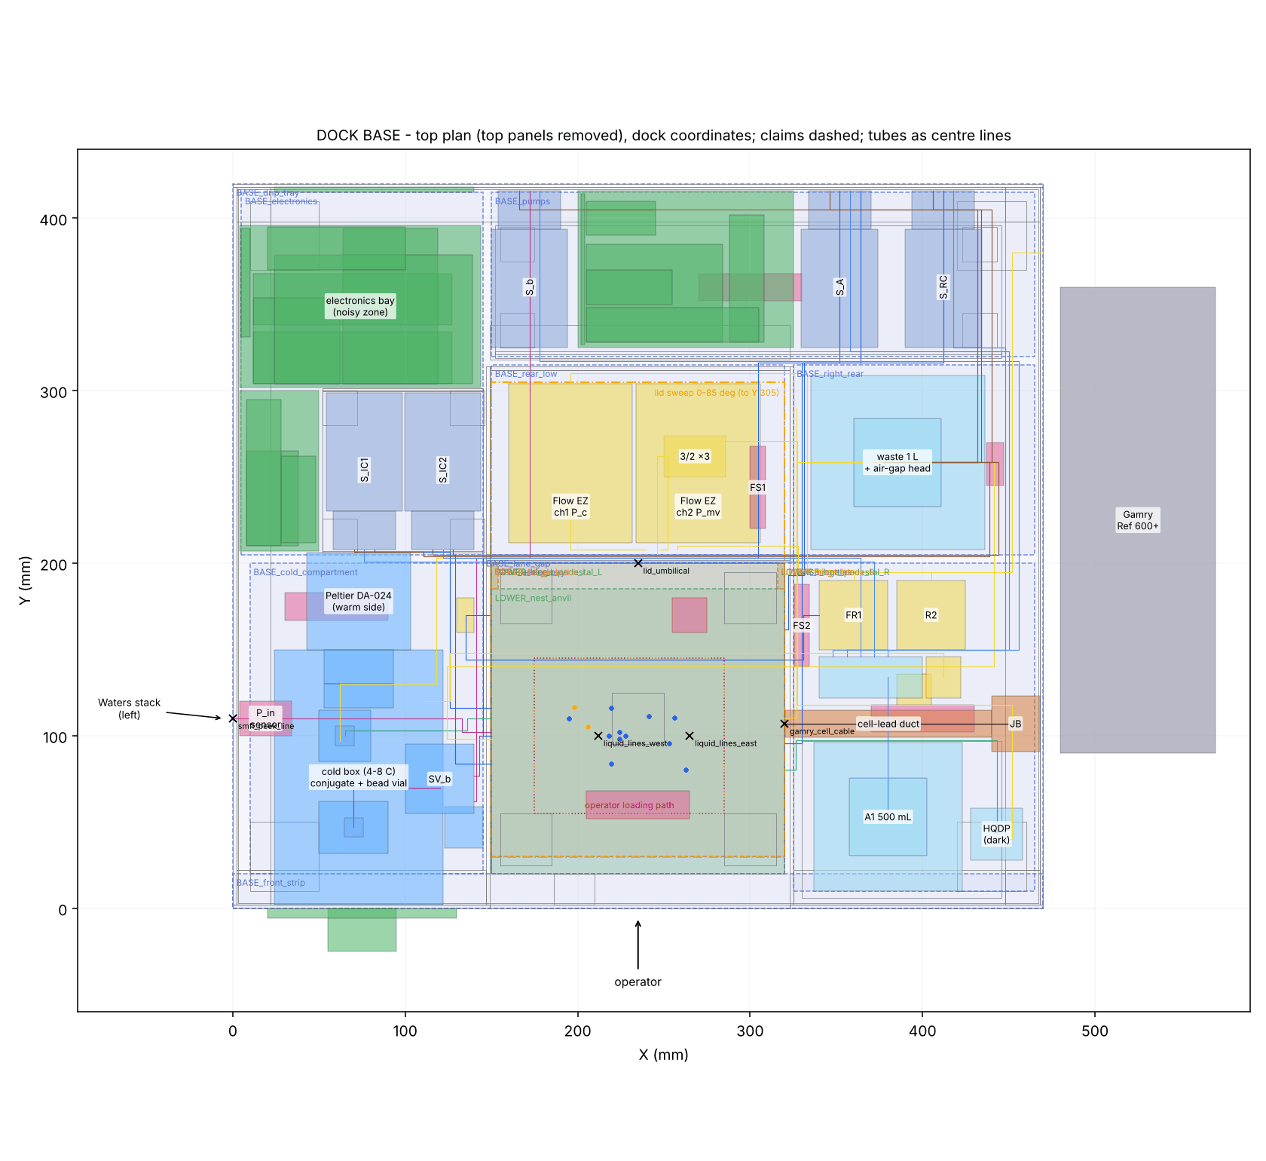
cad/out/dock_base/plan_top_labelled.png
