mhdelano-ai/ELISA/cad/out/dock_base/view_cold_compartment.png

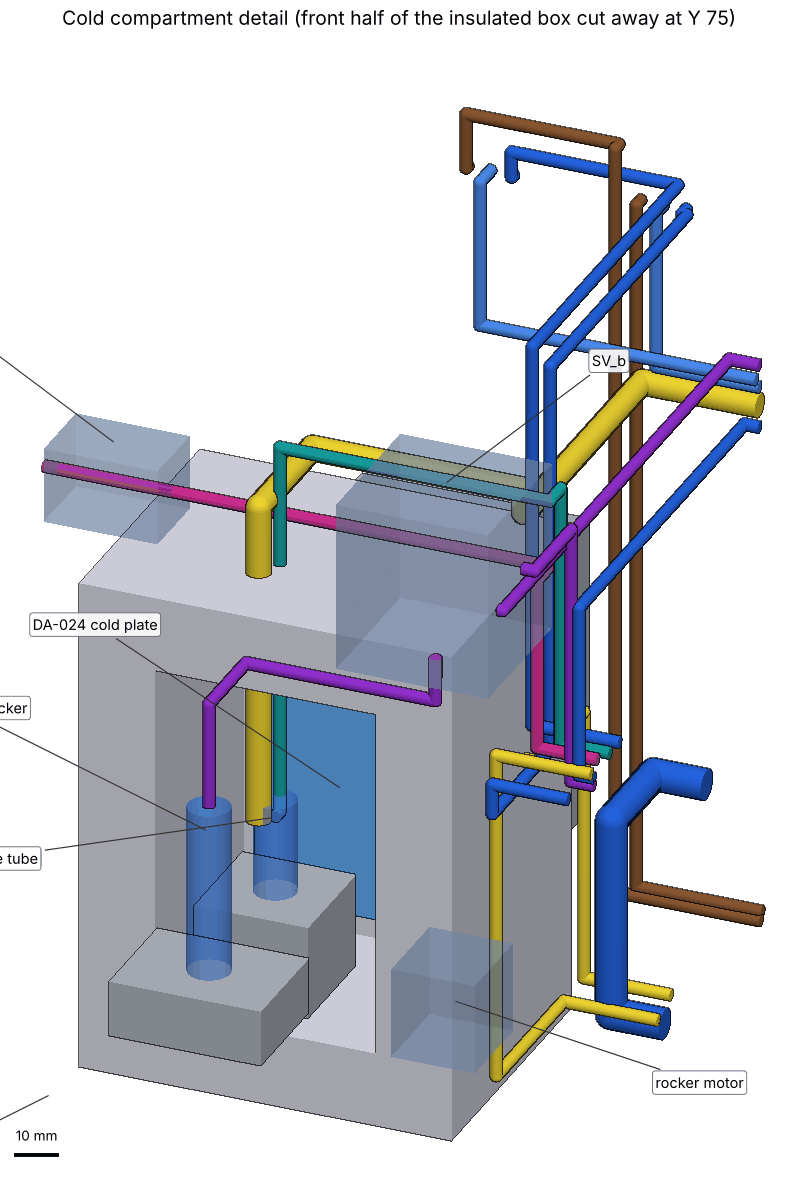
cad/out/dock_base/view_cold_compartment.png
