mhdelano-ai/ELISA/cad/out/dock_base/view_electronics_bay.png

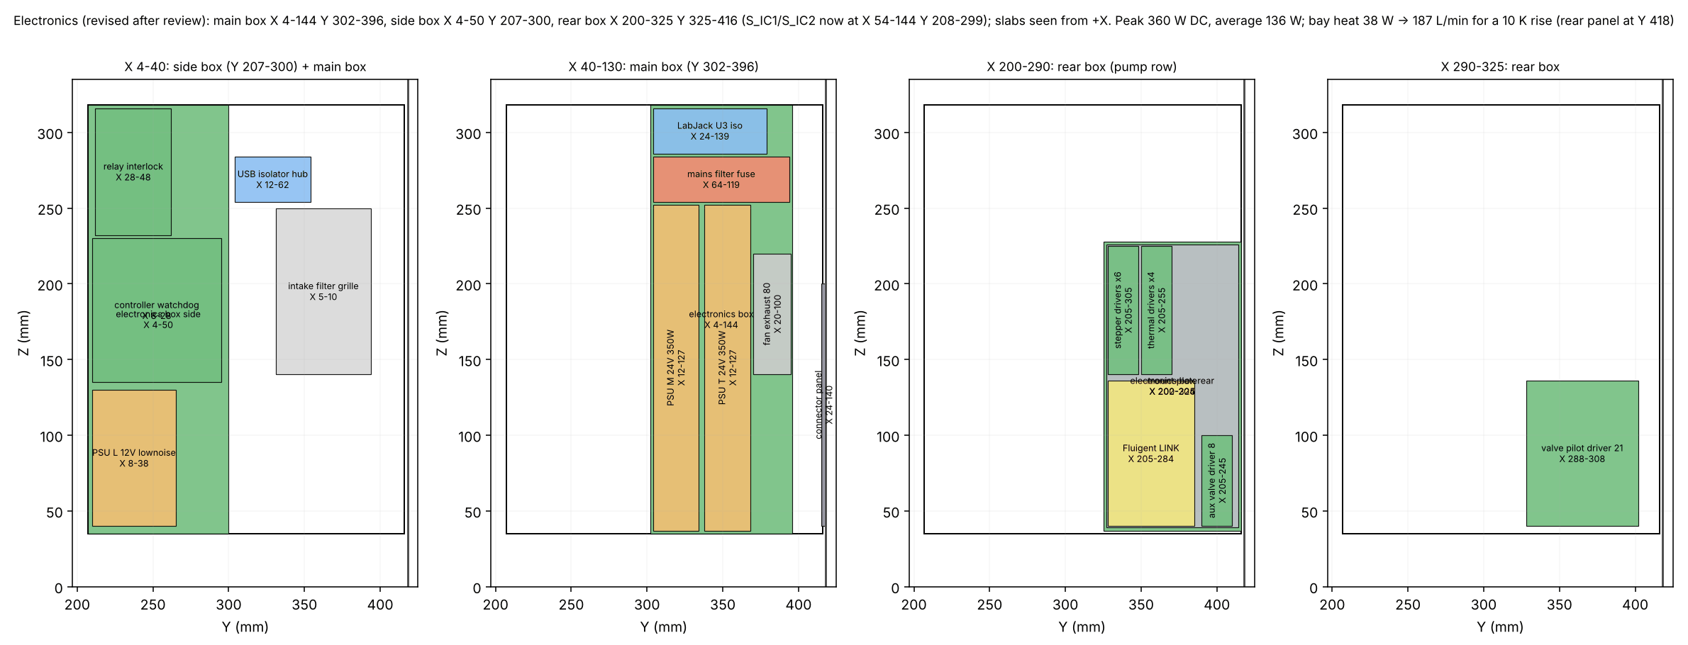
cad/out/dock_base/view_electronics_bay.png
