mhdelano-ai/ELISA/cad/out/dock_base/view_fluidics_no_enclosure.png

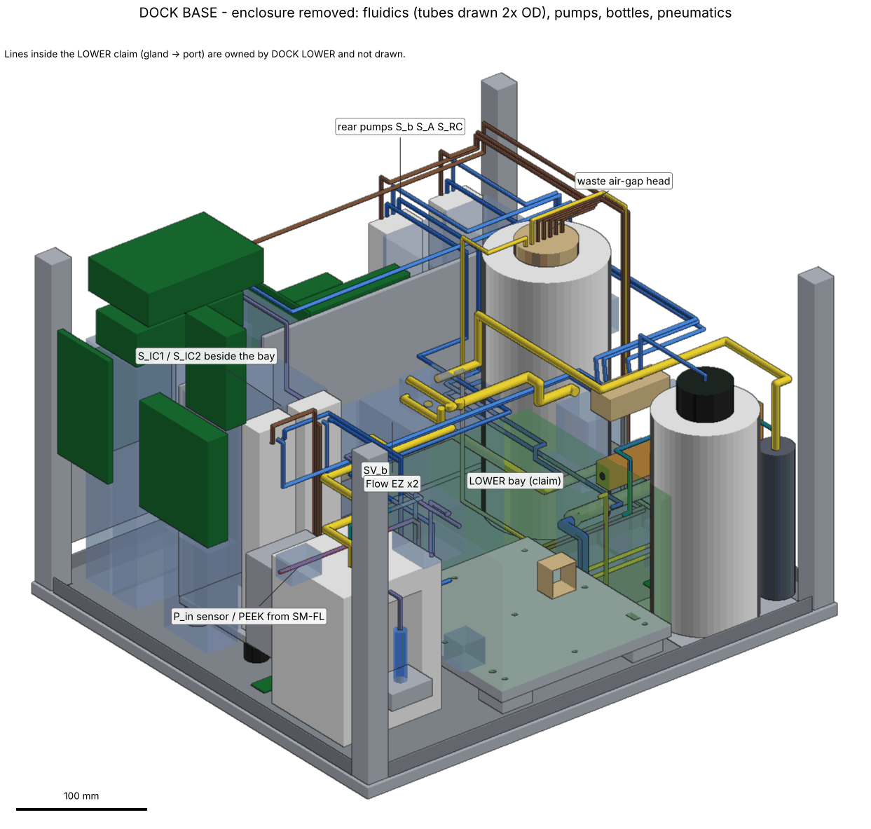
cad/out/dock_base/view_fluidics_no_enclosure.png
