mhdelano-ai/ELISA/cad/out/dock_base/view_fluidics_rear_left.png

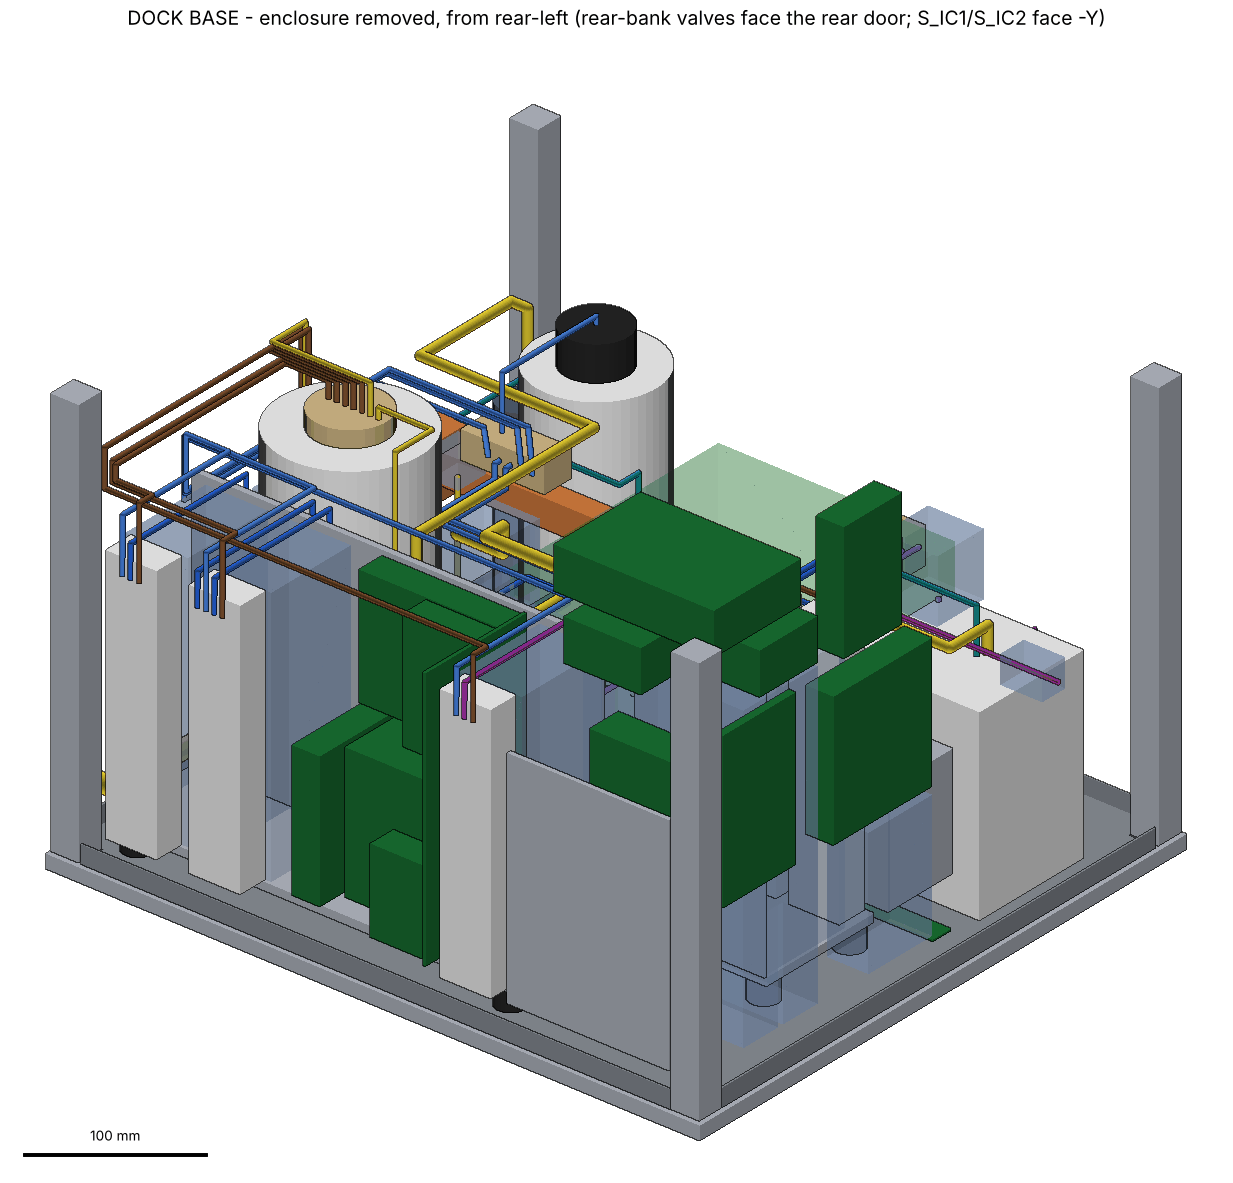
cad/out/dock_base/view_fluidics_rear_left.png
