mhdelano-ai/ELISA/cad/out/dock_base/view_front_elevation.png

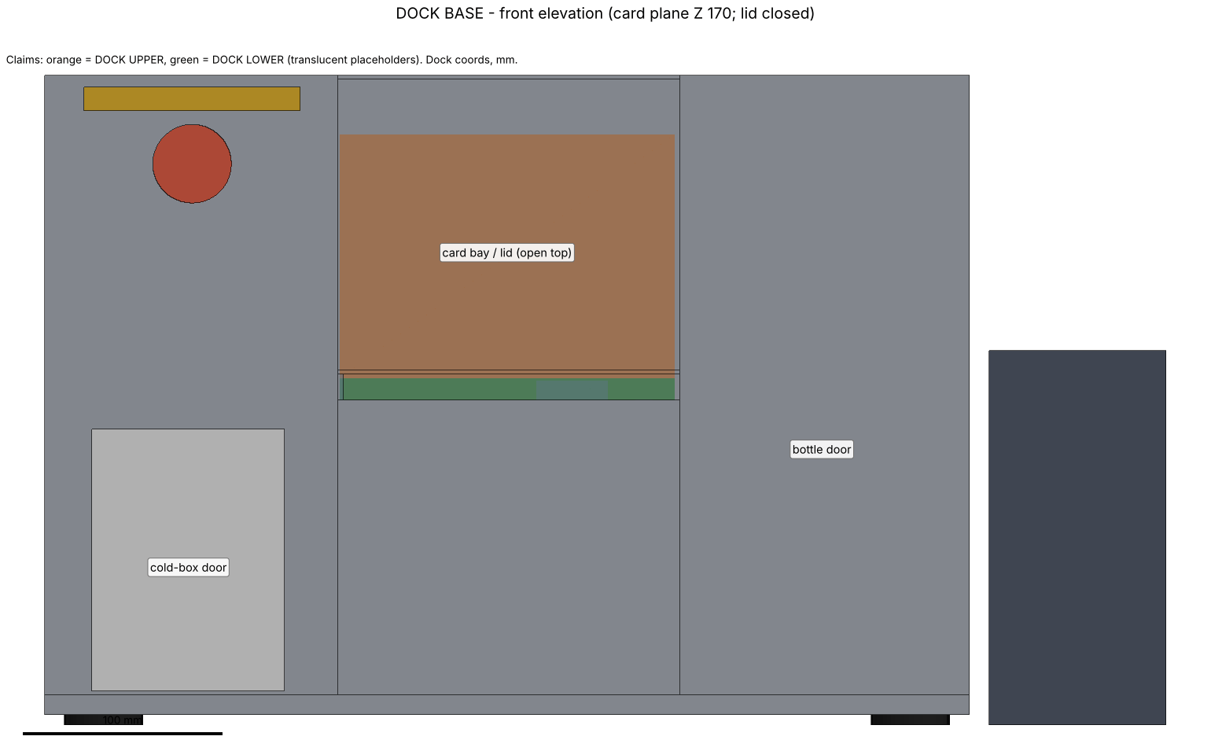
cad/out/dock_base/view_front_elevation.png
