mhdelano-ai/ELISA/cad/out/dock_base/view_iso_front_left.png

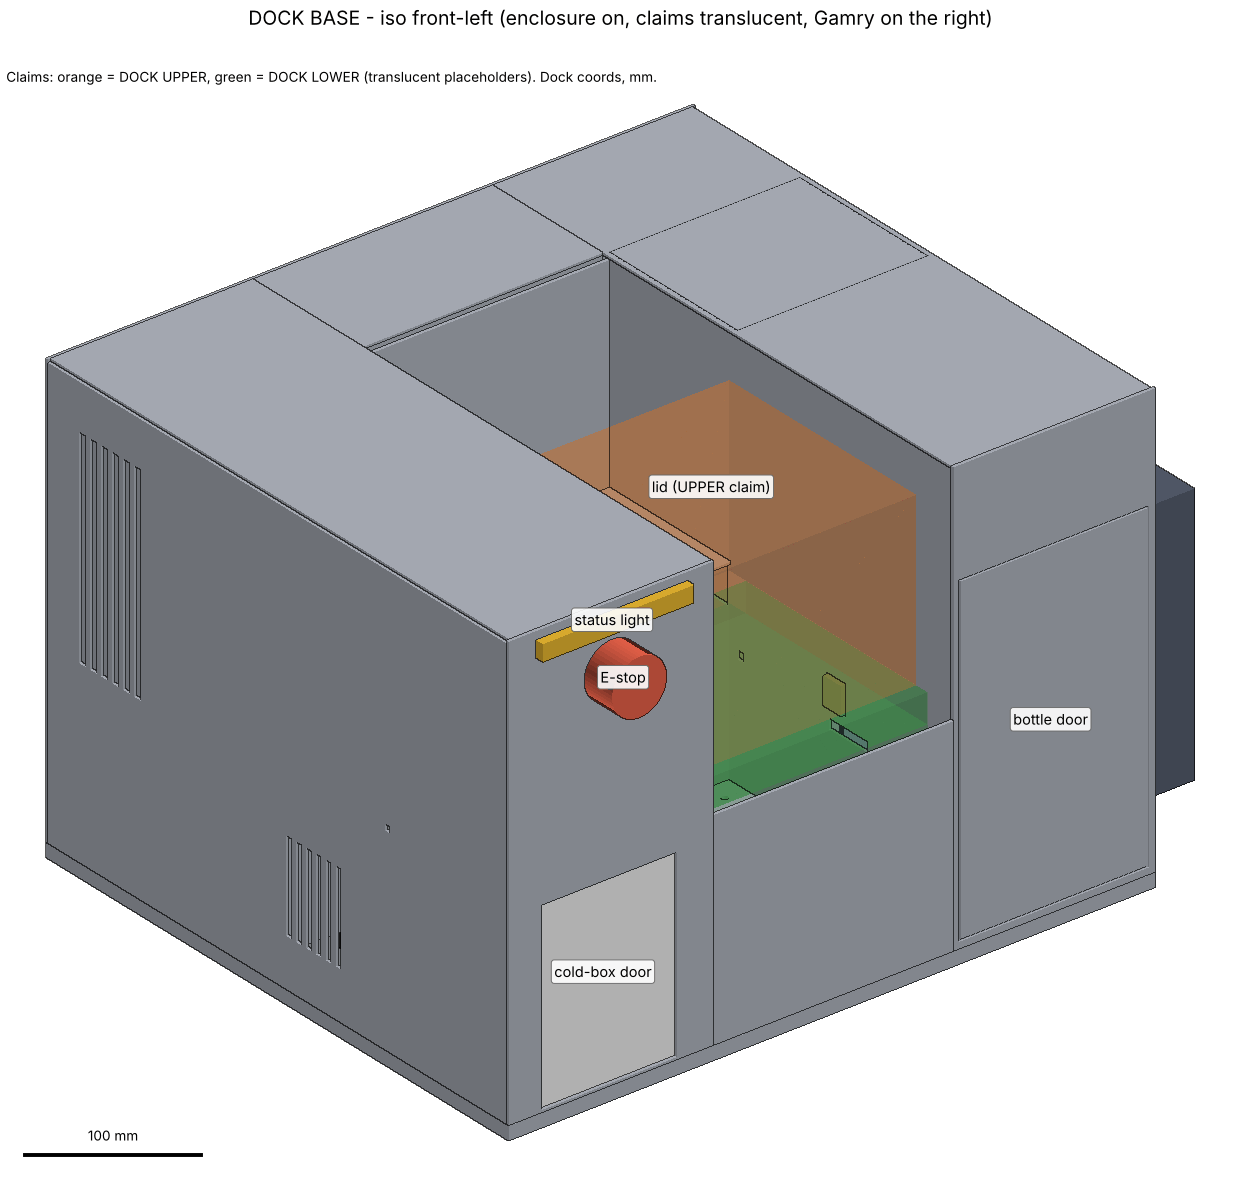
cad/out/dock_base/view_iso_front_left.png
