mhdelano-ai/ELISA/cad/out/dock_base/view_iso_front_right.png

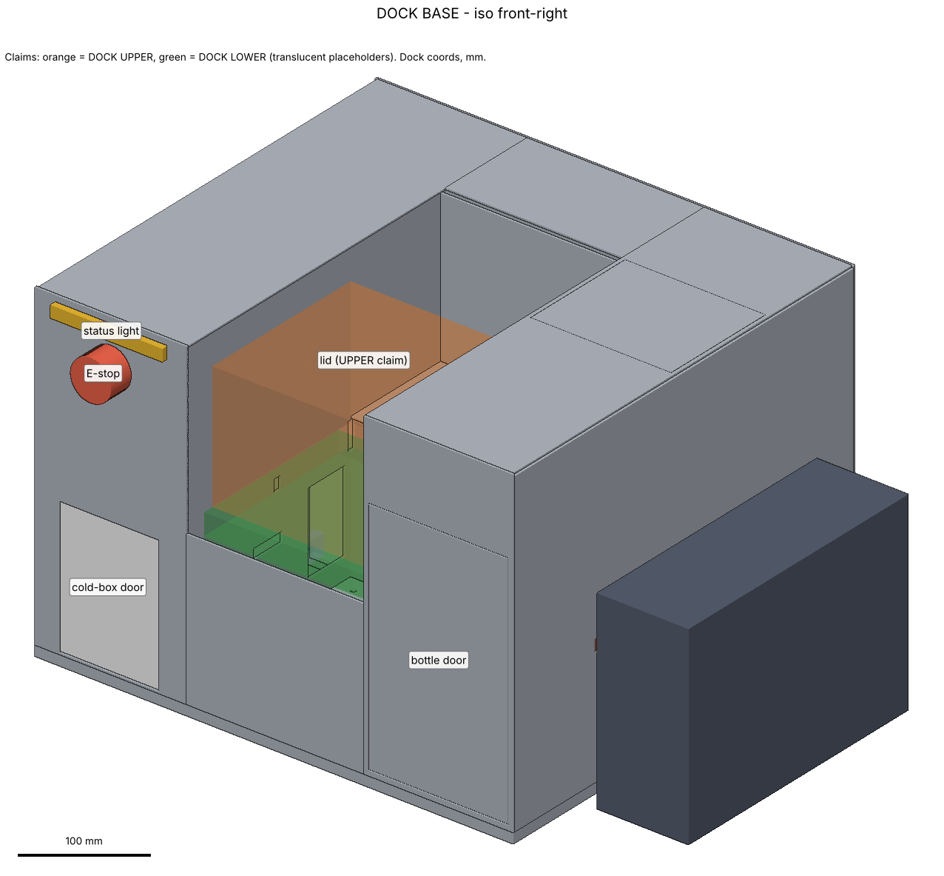
cad/out/dock_base/view_iso_front_right.png
