mhdelano-ai/ELISA/cad/out/dock_base/view_rear.png

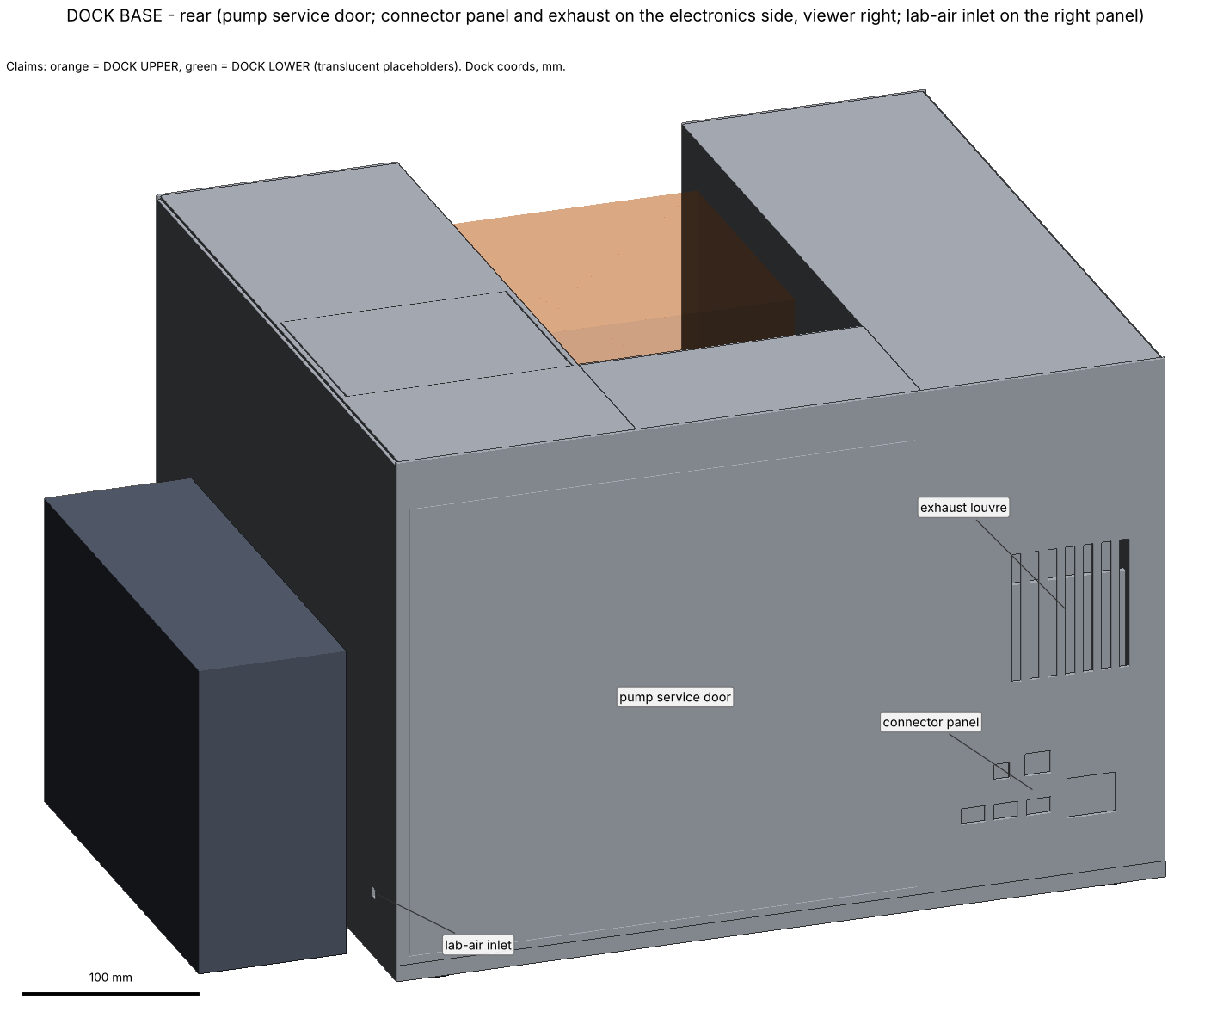
cad/out/dock_base/view_rear.png
