mhdelano-ai/ELISA/cad/out/dock_base/view_right_elevation_lid_sweep.png

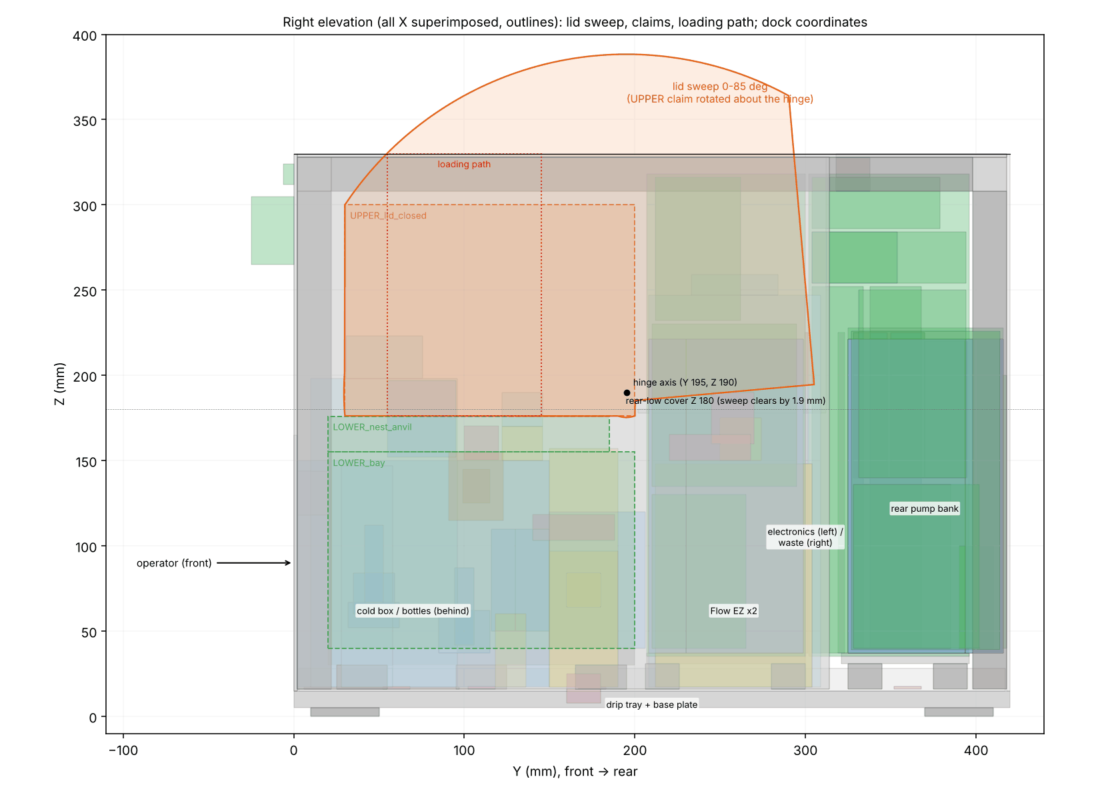
cad/out/dock_base/view_right_elevation_lid_sweep.png
