mhdelano-ai/ELISA/cad/out/dock_lower/anvil_plan.png

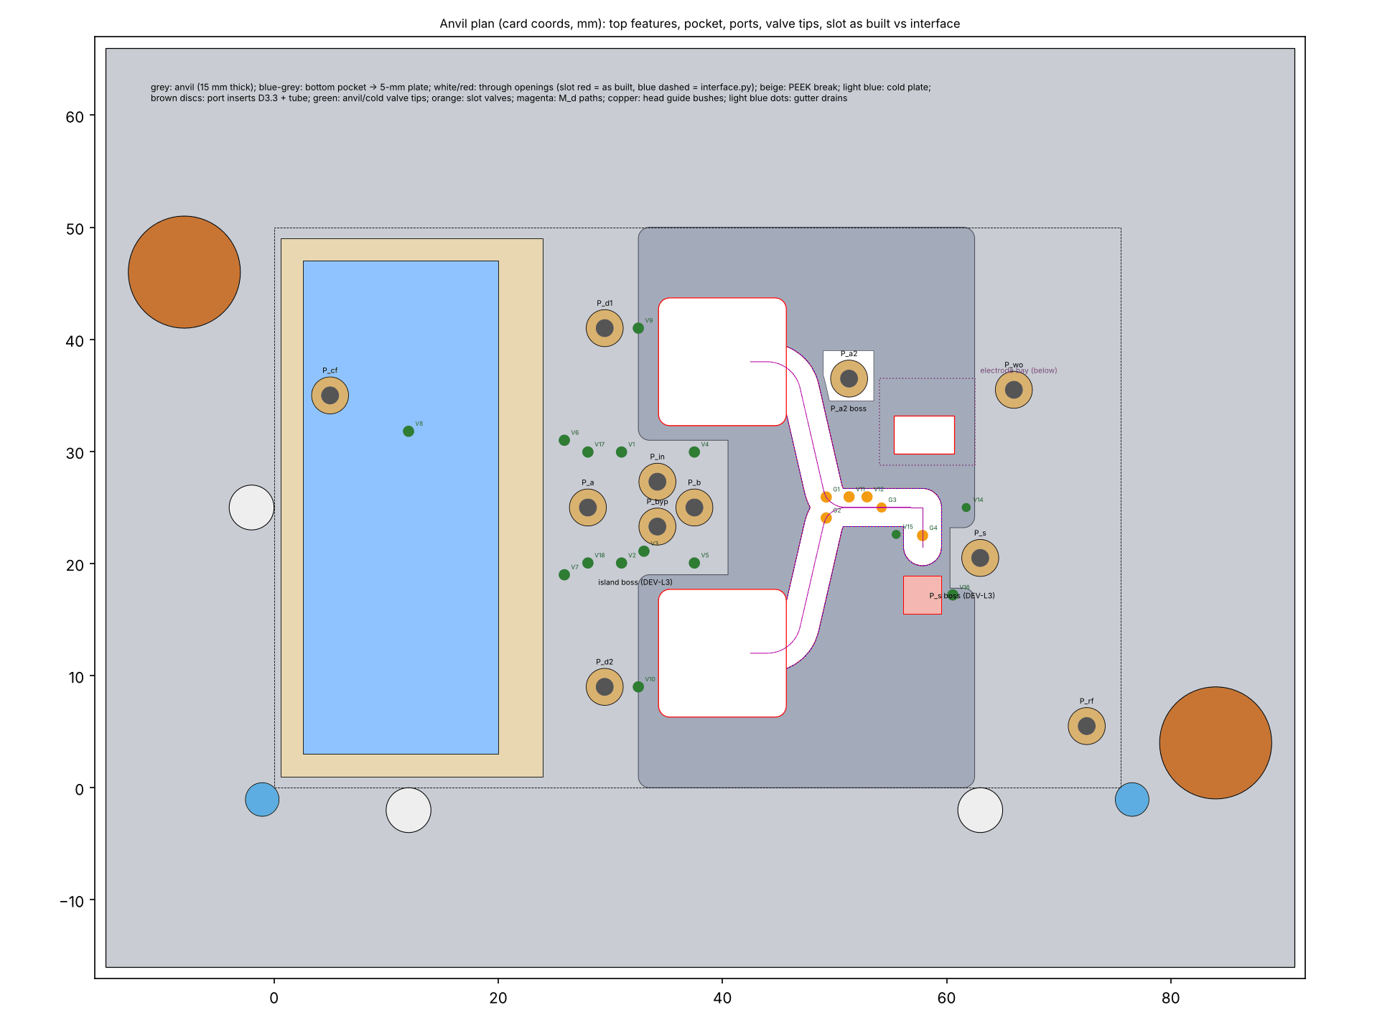
cad/out/dock_lower/anvil_plan.png
