mhdelano-ai/ELISA/cad/out/dock_lower/anvil_underside.png

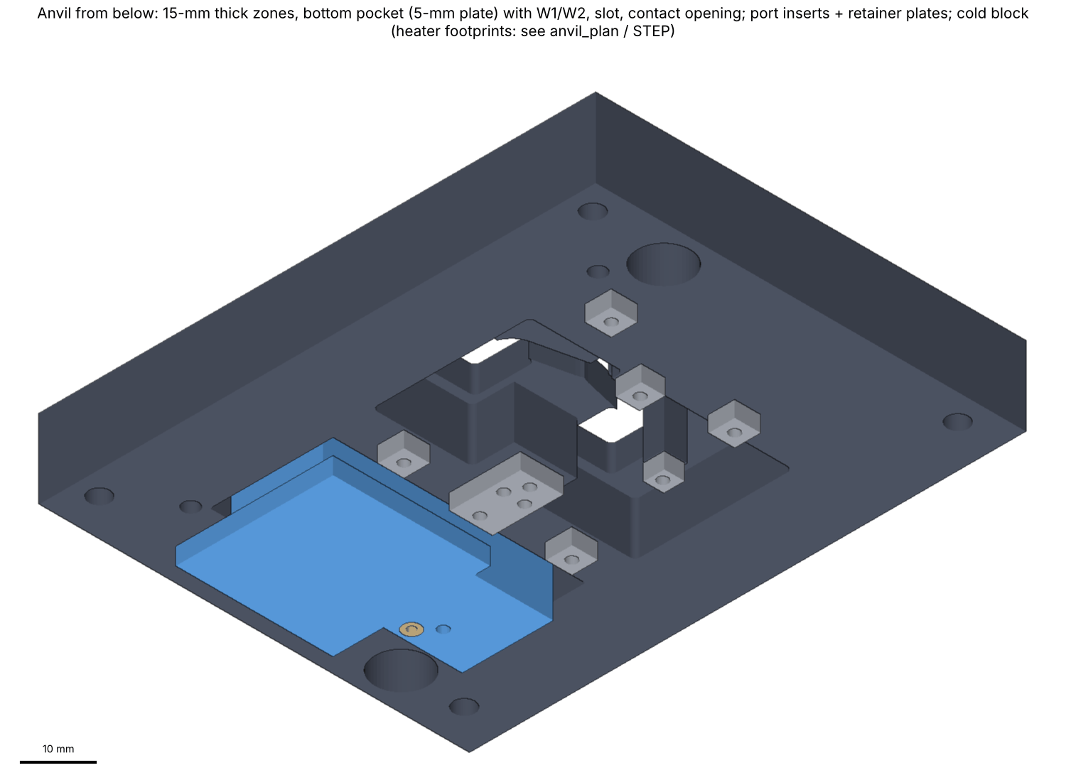
cad/out/dock_lower/anvil_underside.png
