mhdelano-ai/ELISA/cad/out/dock_lower/exploded_iso.png

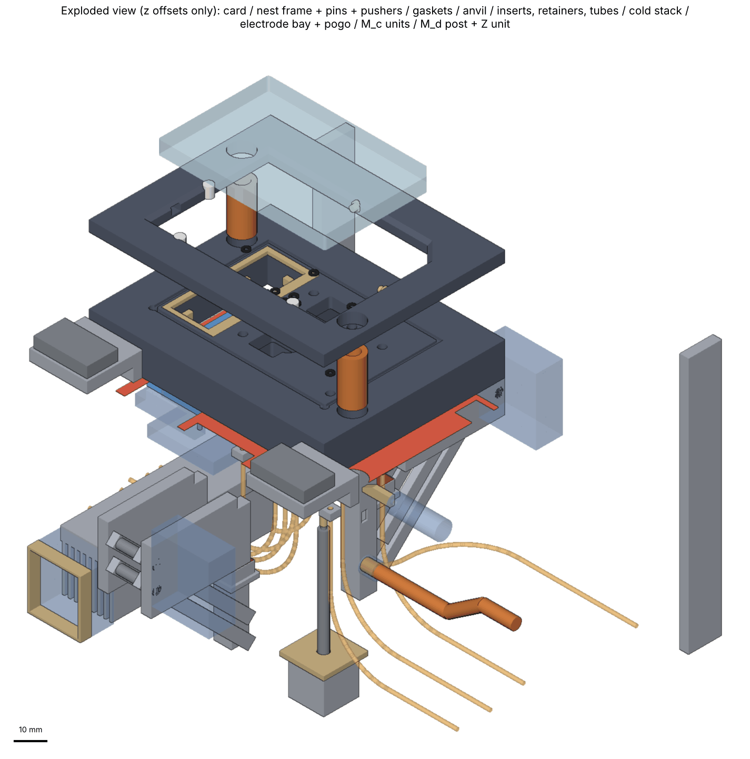
cad/out/dock_lower/exploded_iso.png
