mhdelano-ai/ELISA/cad/out/dock_lower/magnet_bay_iso_collect_IC1.png

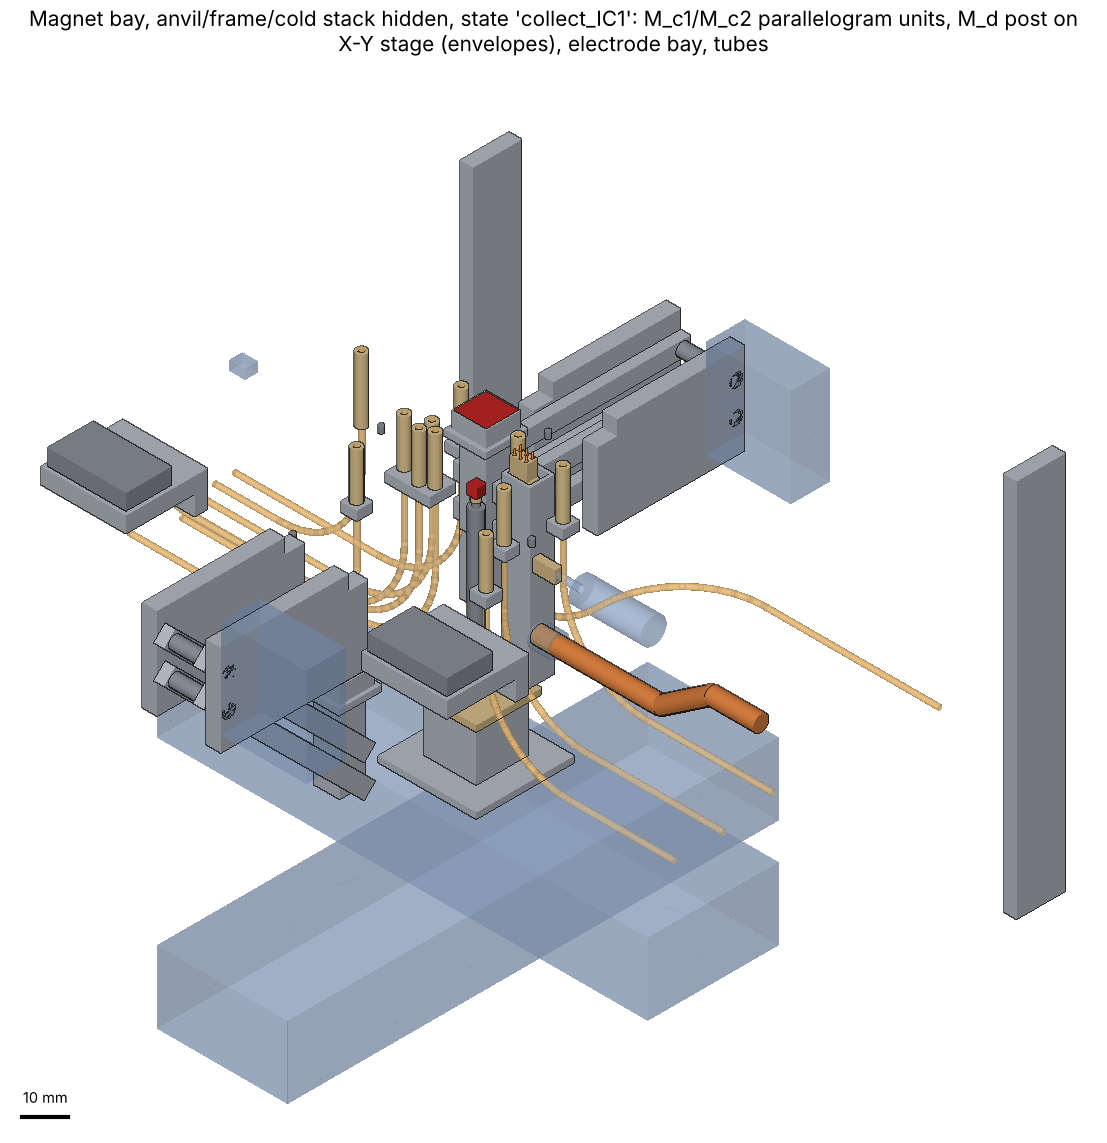
cad/out/dock_lower/magnet_bay_iso_collect_IC1.png
