mhdelano-ai/ELISA/cad/out/dock_lower/nest_anvil_iso.png

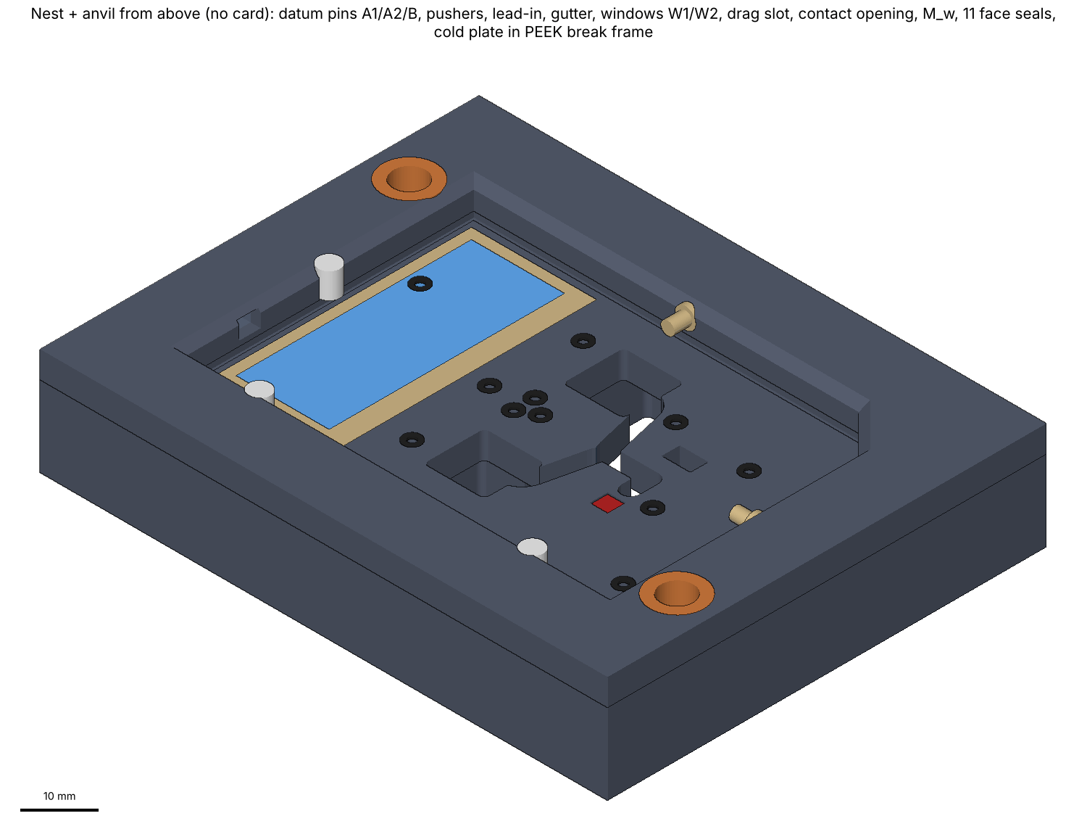
cad/out/dock_lower/nest_anvil_iso.png
