mhdelano-ai/ELISA/cad/out/dock_lower/section_beadout_Mw_ebay.png

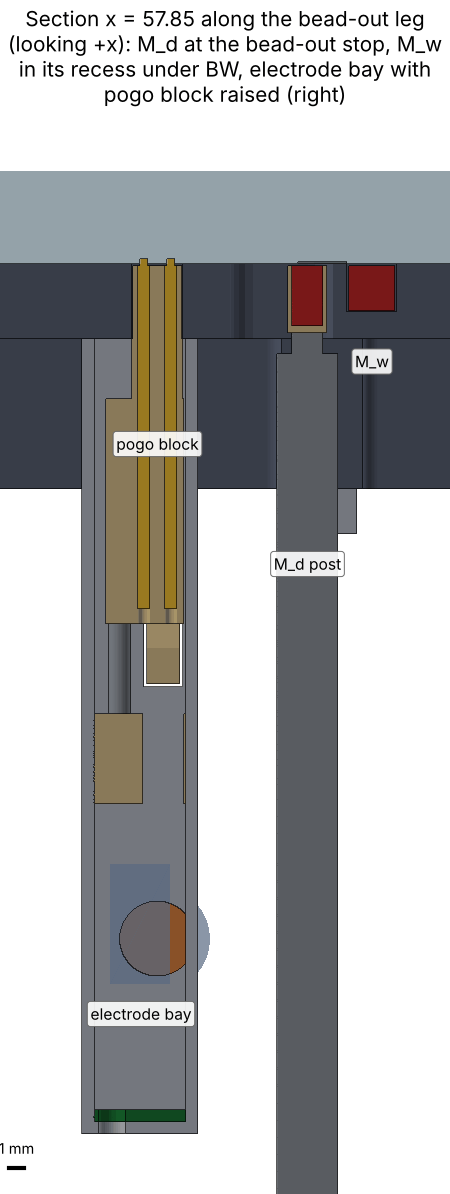
cad/out/dock_lower/section_beadout_Mw_ebay.png
