mhdelano-ai/ELISA/cad/out/dock_lower/section_cold_stack.png

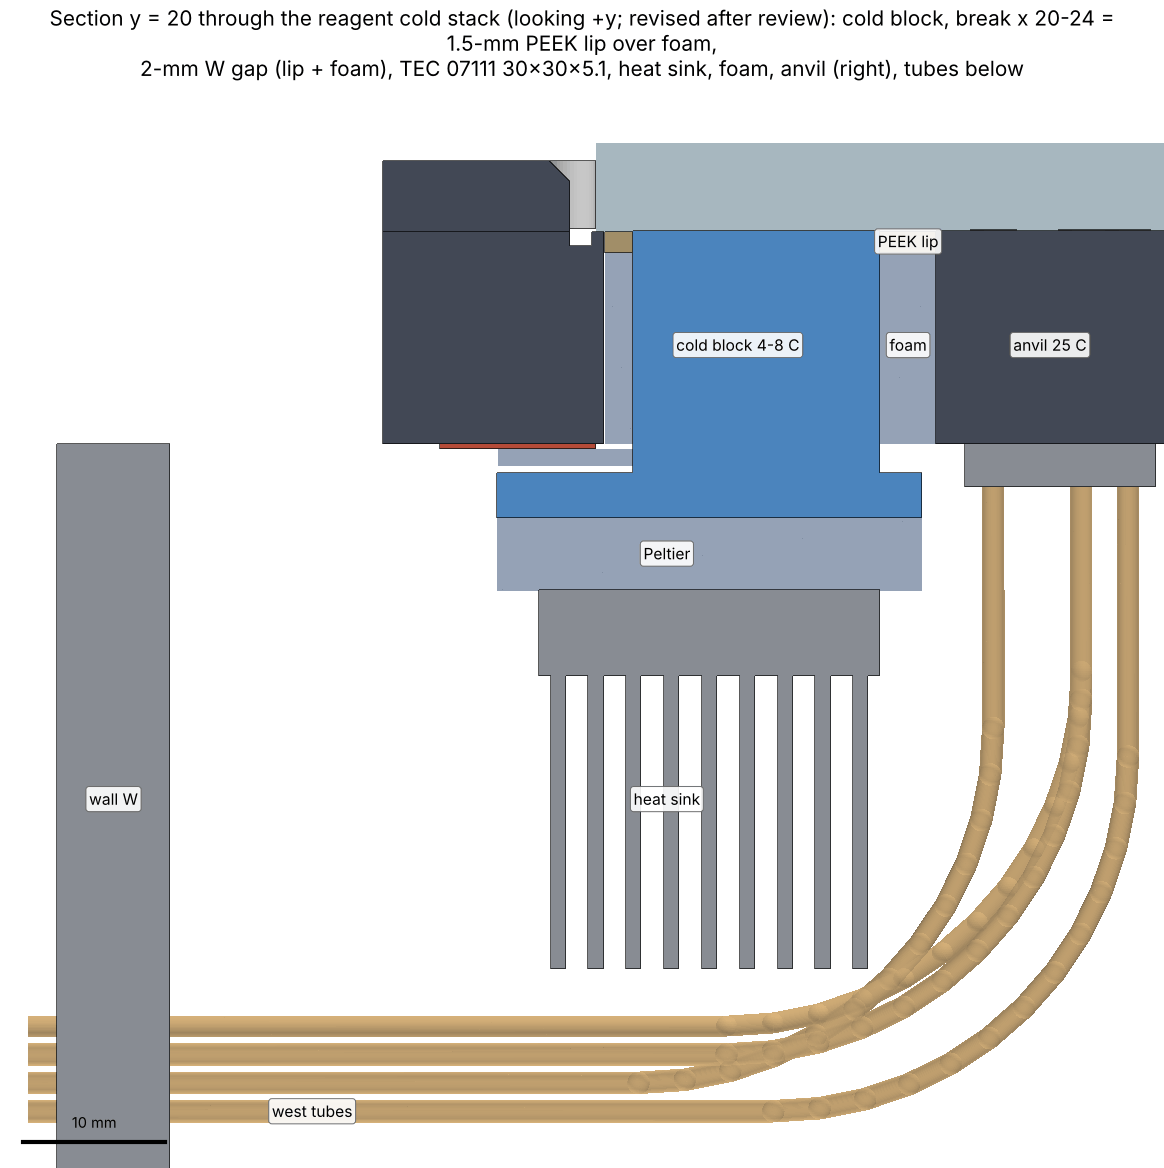
cad/out/dock_lower/section_cold_stack.png
