mhdelano-ai/ELISA/cad/out/dock_lower/section_drag_slot_Md_hold.png

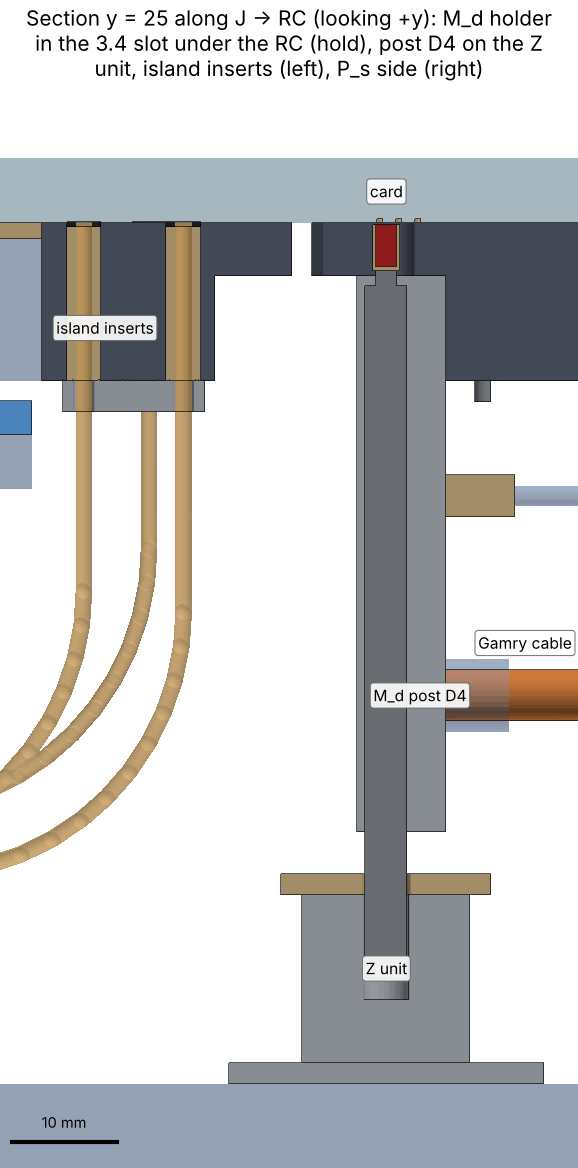
cad/out/dock_lower/section_drag_slot_Md_hold.png
