mhdelano-ai/ELISA/cad/out/dock_lower/section_ebay_pogo_down.png

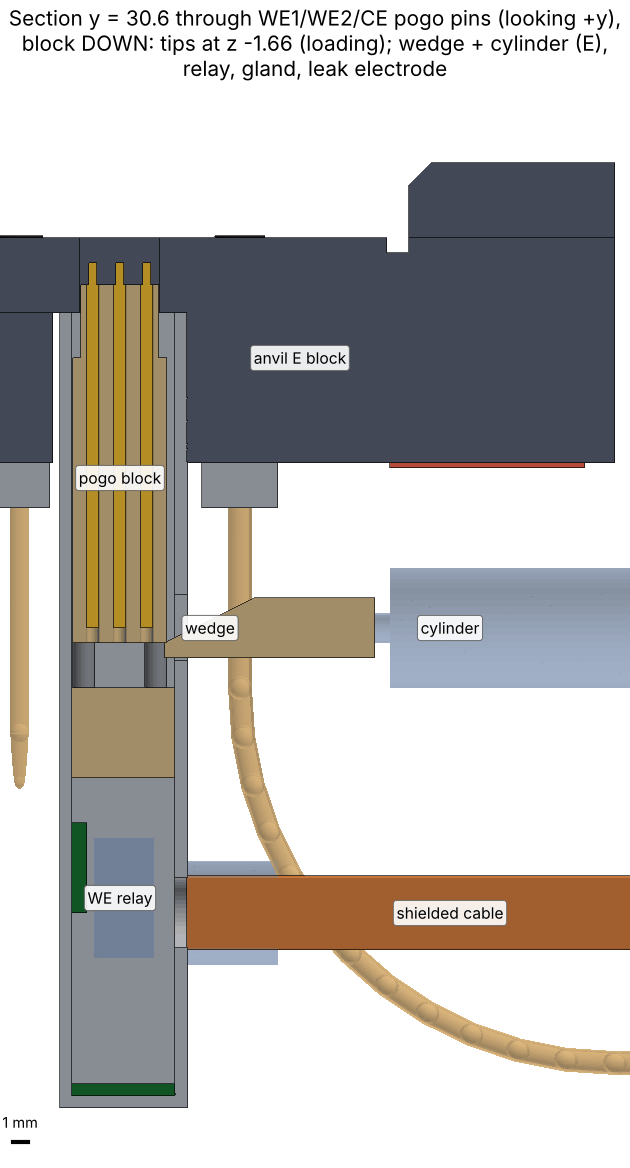
cad/out/dock_lower/section_ebay_pogo_down.png
