mhdelano-ai/ELISA/cad/out/dock_lower/section_port_insert.png

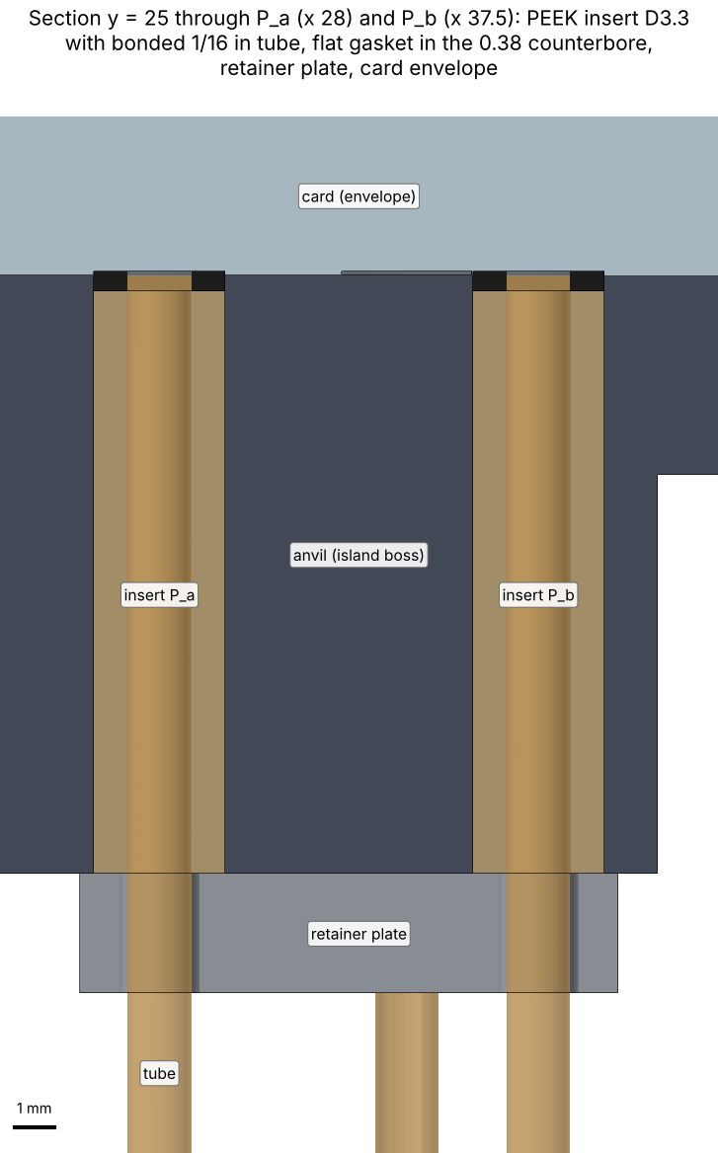
cad/out/dock_lower/section_port_insert.png
