mhdelano-ai/ELISA/cad/out/dock_lower/section_W1_Mc_up.png

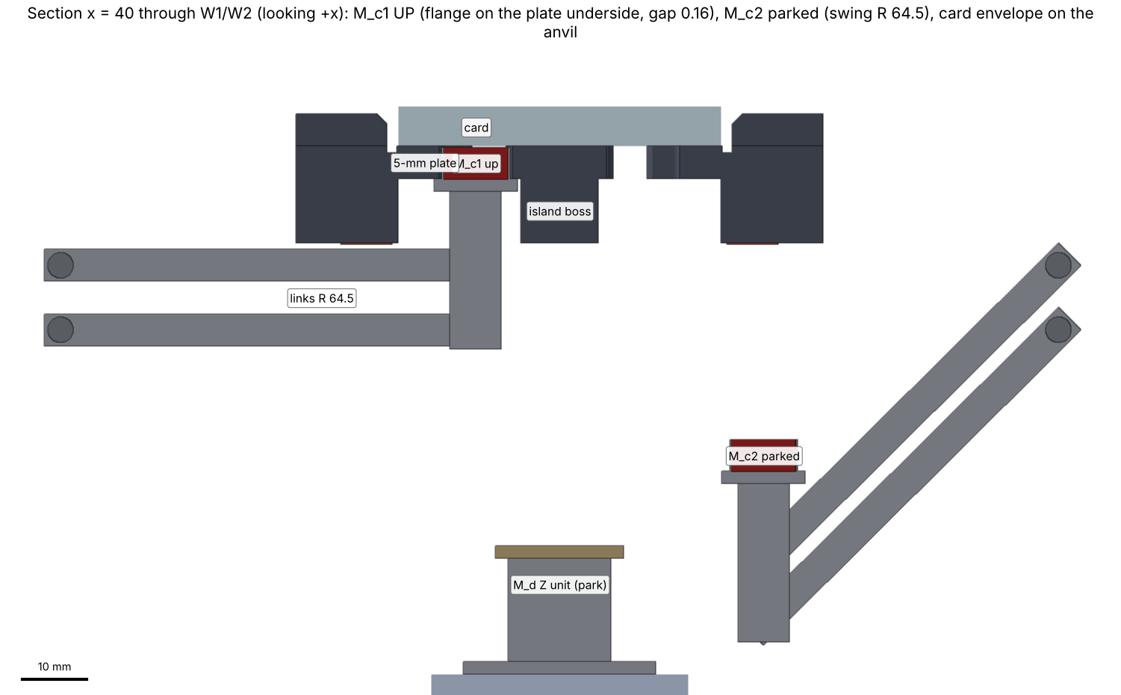
cad/out/dock_lower/section_W1_Mc_up.png
