mhdelano-ai/ELISA/cad/out/dock_upper/exploded_head.png

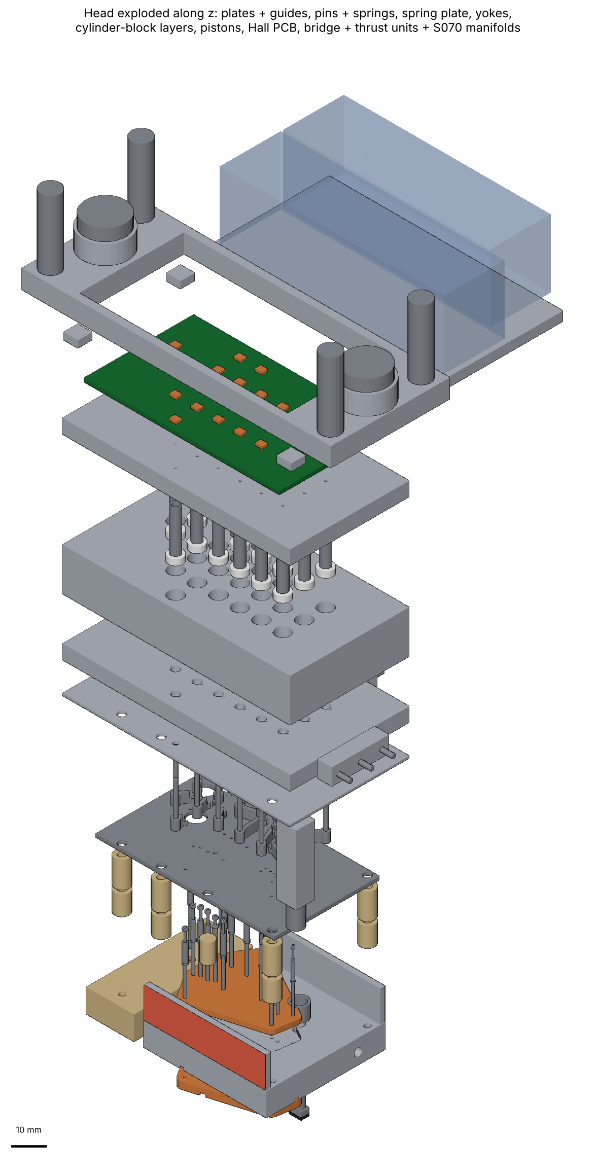
cad/out/dock_upper/exploded_head.png
