mhdelano-ai/ELISA/cad/out/dock_upper/head_underside.png

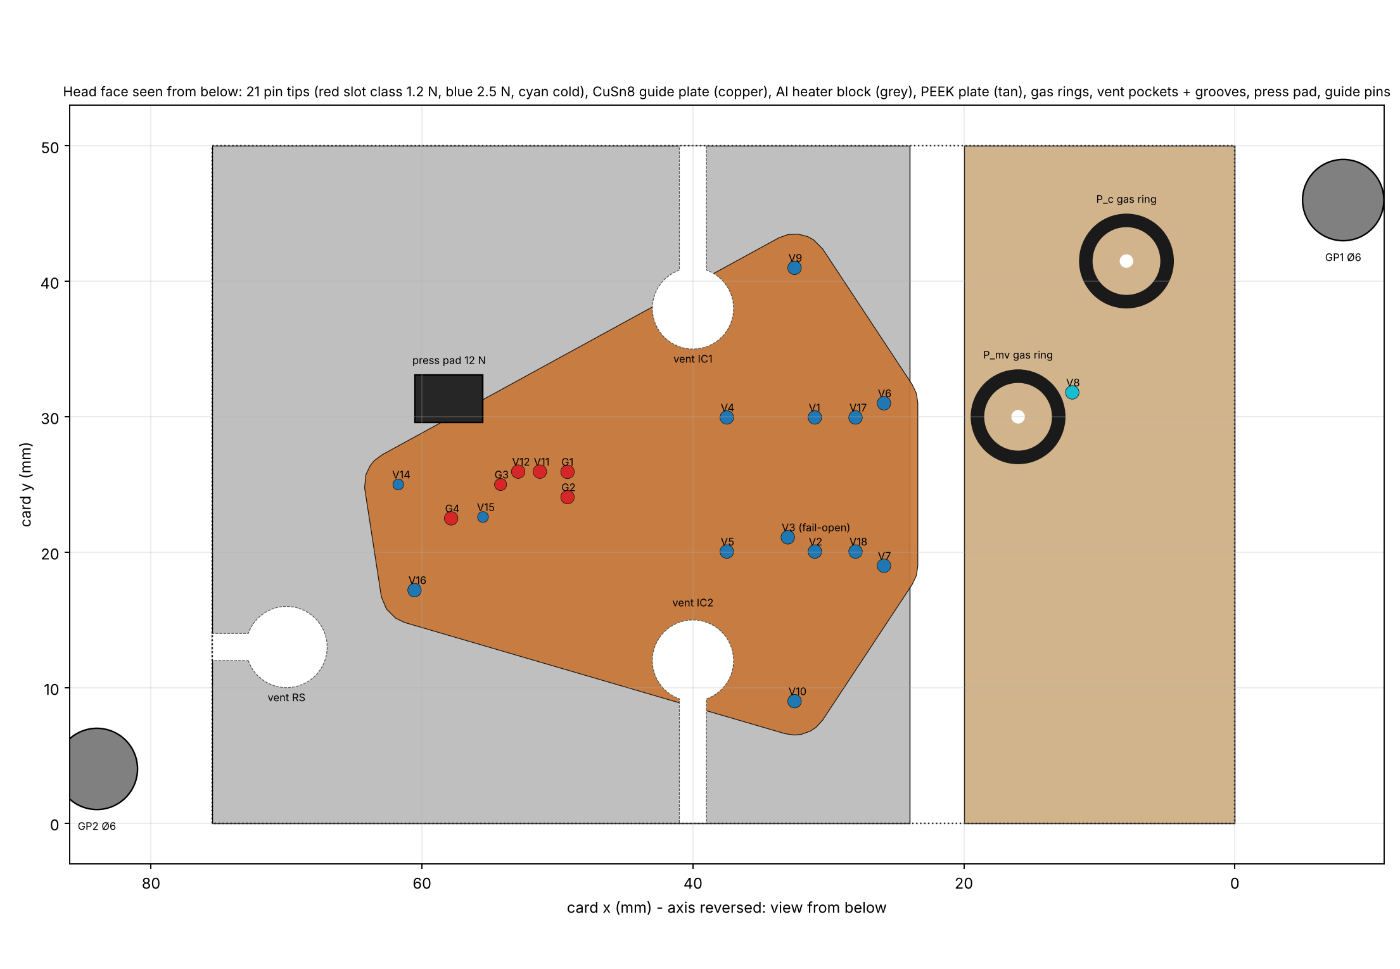
cad/out/dock_upper/head_underside.png
