mhdelano-ai/ELISA/cad/out/dock_upper/head_underside_zoom_J_cell.png

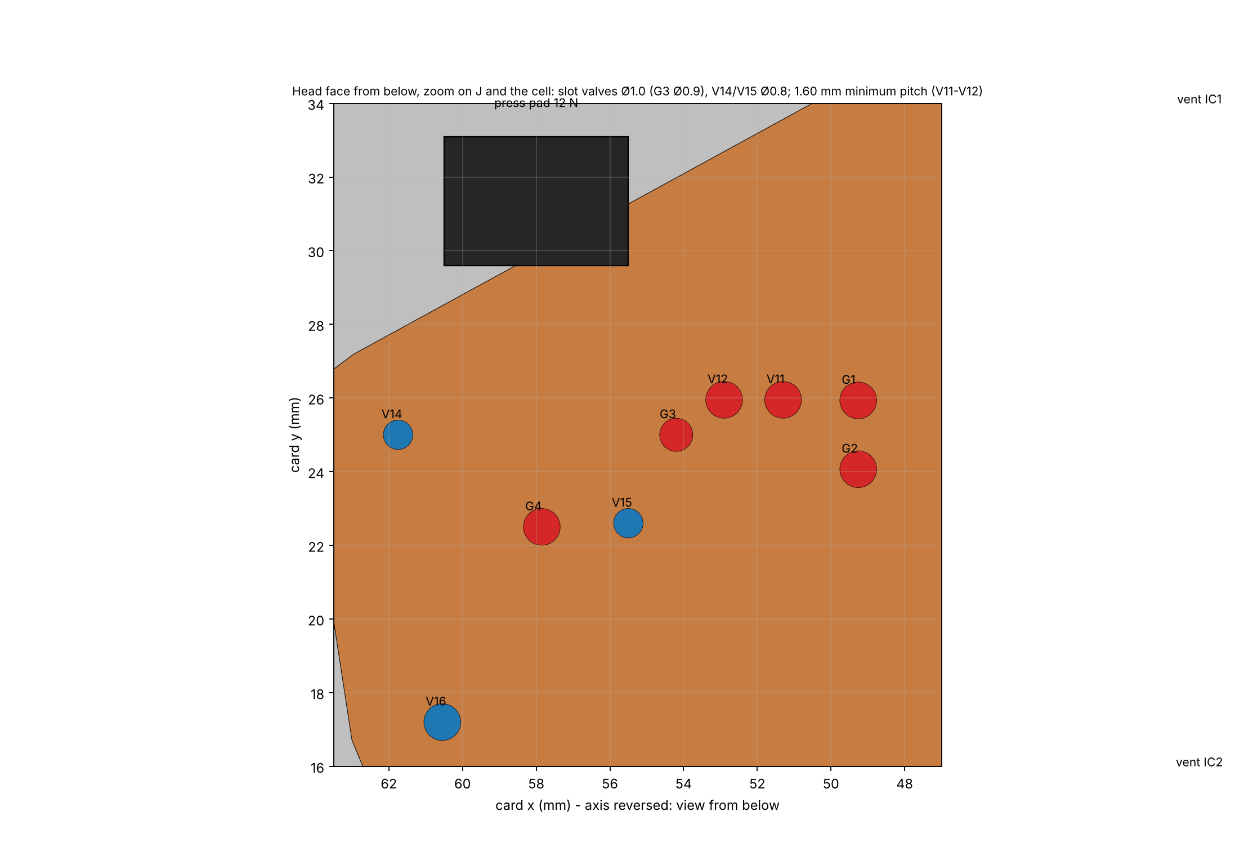
cad/out/dock_upper/head_underside_zoom_J_cell.png
