mhdelano-ai/ELISA/cad/out/dock_upper/iso_closed.png

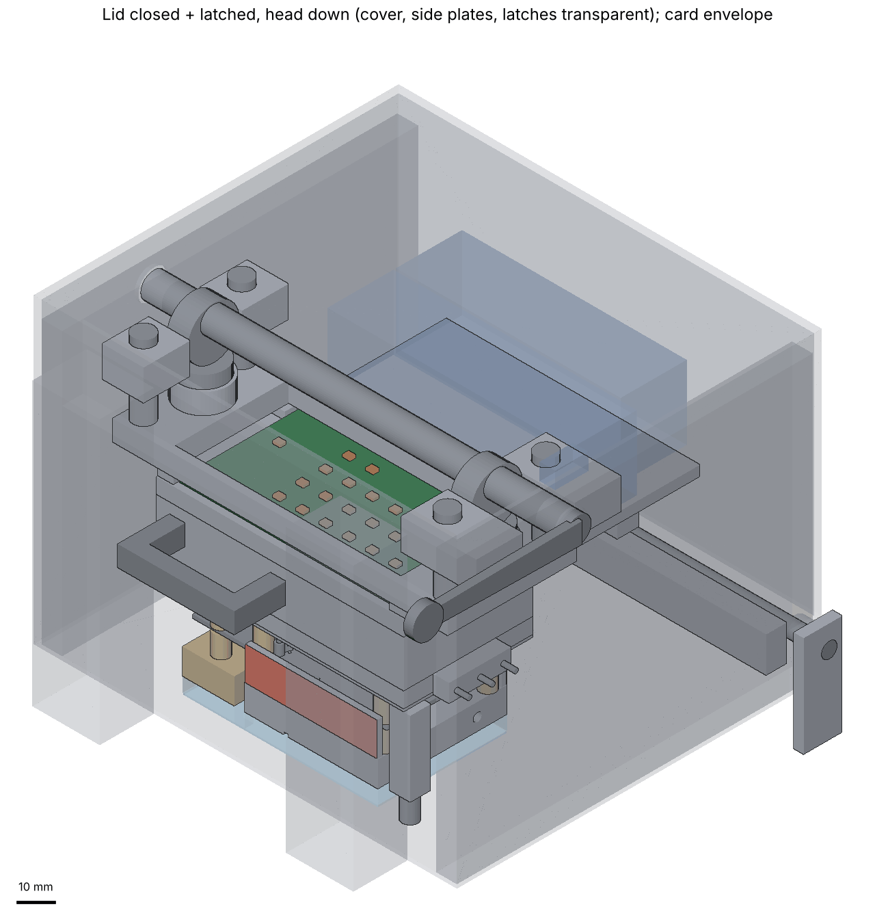
cad/out/dock_upper/iso_closed.png
