mhdelano-ai/ELISA/cad/out/dock_upper/iso_head_closed.png

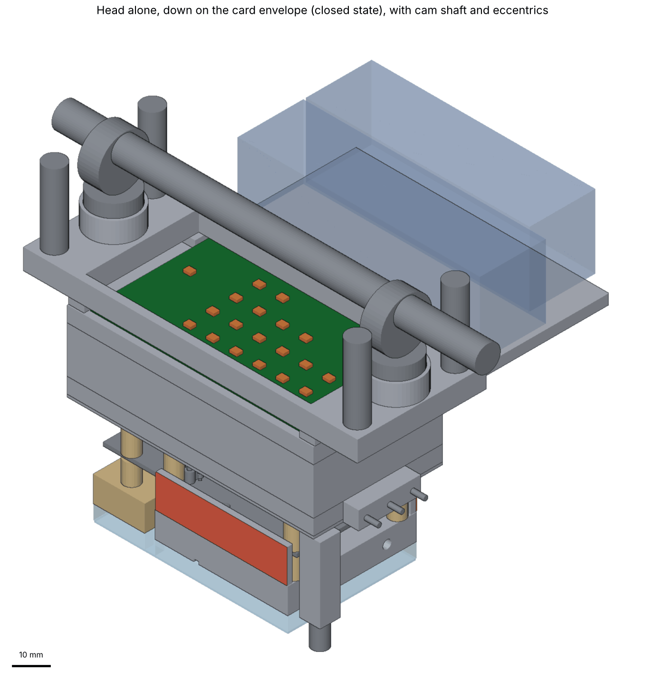
cad/out/dock_upper/iso_head_closed.png
