mhdelano-ai/ELISA/cad/out/dock_upper/iso_open.png

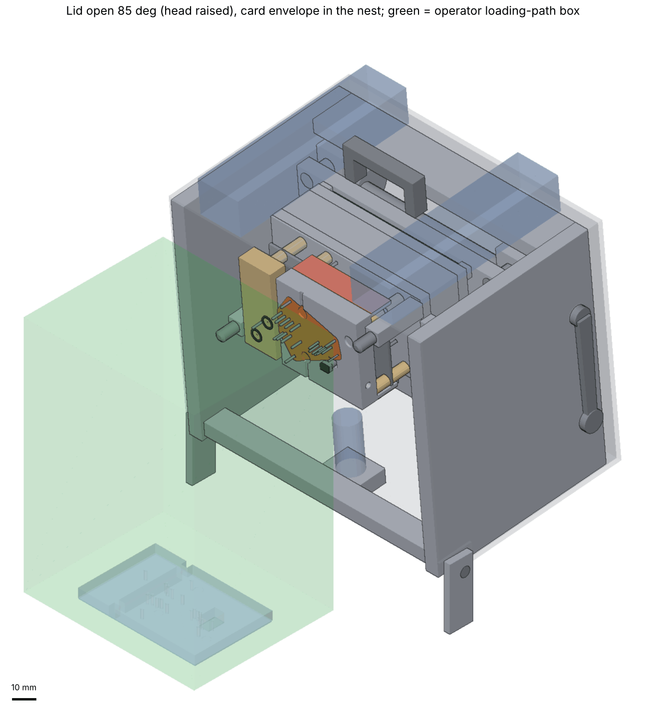
cad/out/dock_upper/iso_open.png
