mhdelano-ai/ELISA/cad/out/dock_upper/kinematics_side.png

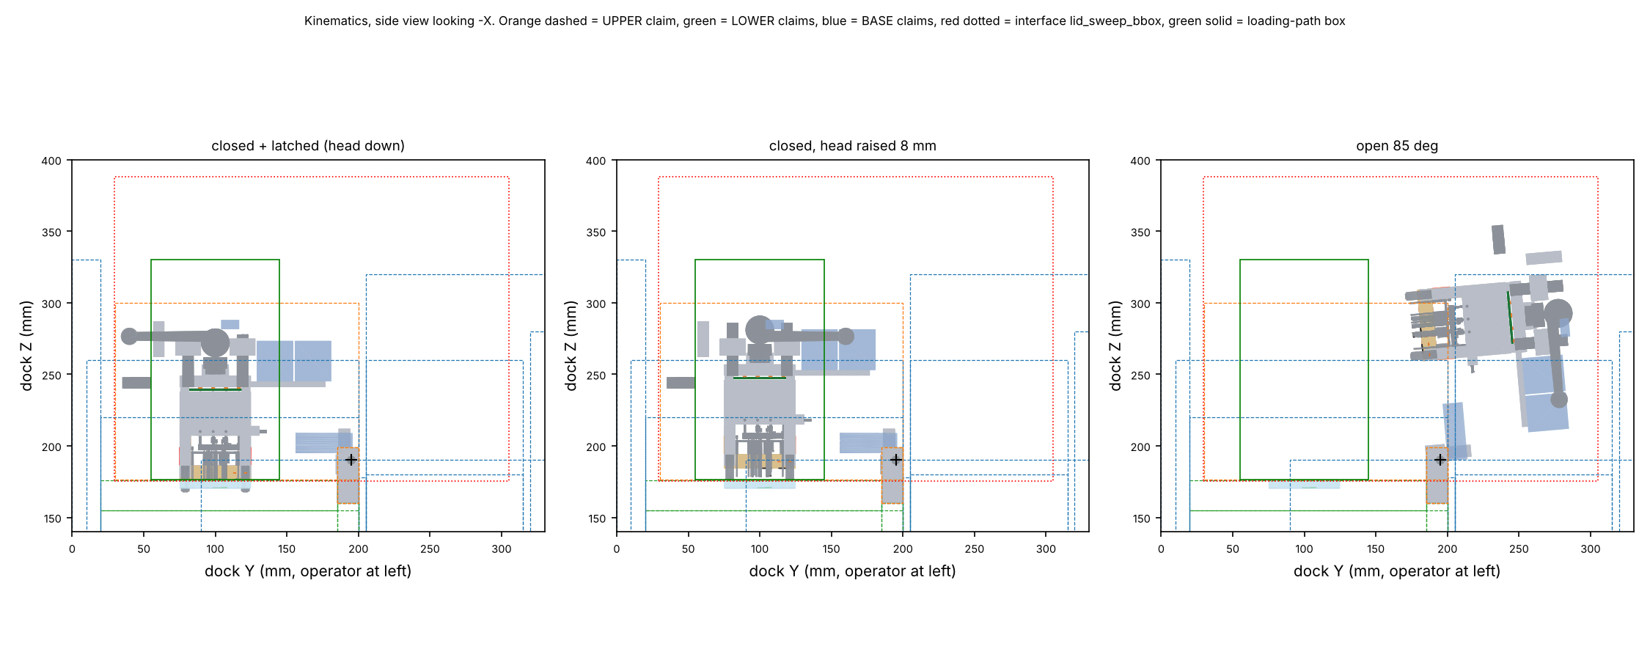
cad/out/dock_upper/kinematics_side.png
