mhdelano-ai/ELISA/cad/out/dock_upper/plan_air_galleries.png

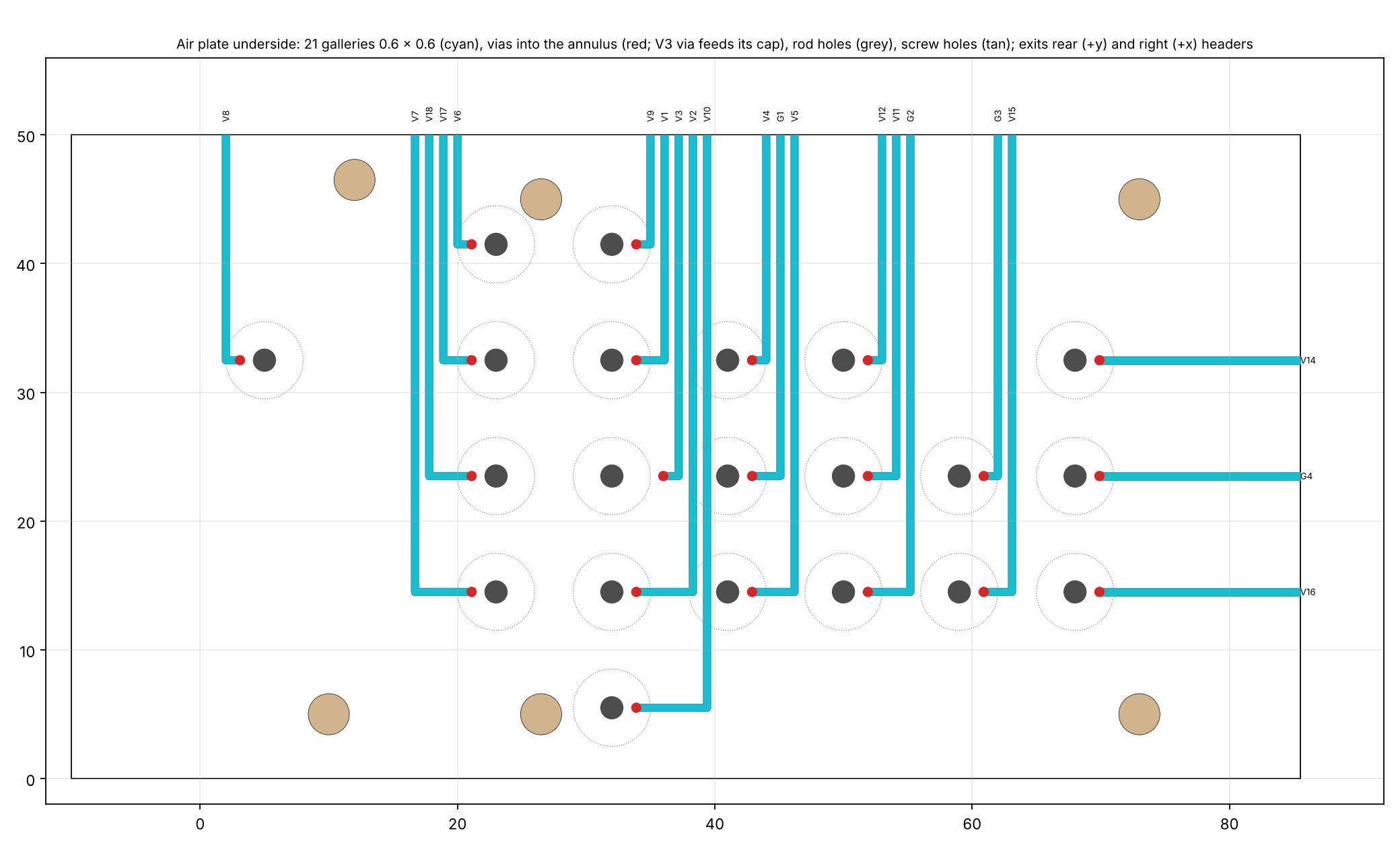
cad/out/dock_upper/plan_air_galleries.png
