mhdelano-ai/ELISA/cad/out/dock_upper/plan_cylinders_yokes.png

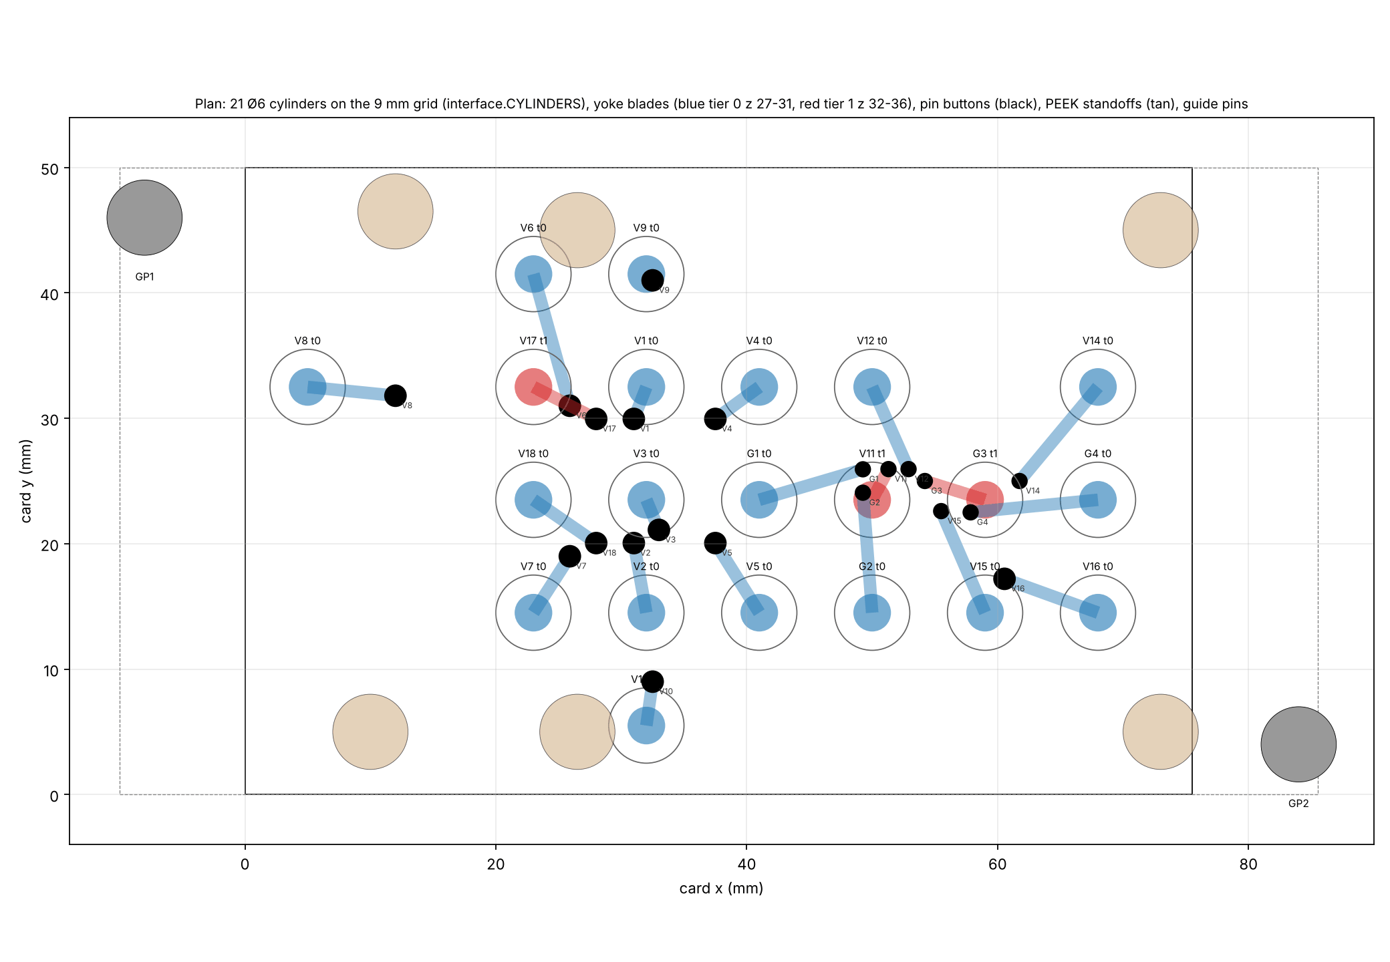
cad/out/dock_upper/plan_cylinders_yokes.png
