mhdelano-ai/ELISA/cad/out/dock_upper/section_pin_G4.png

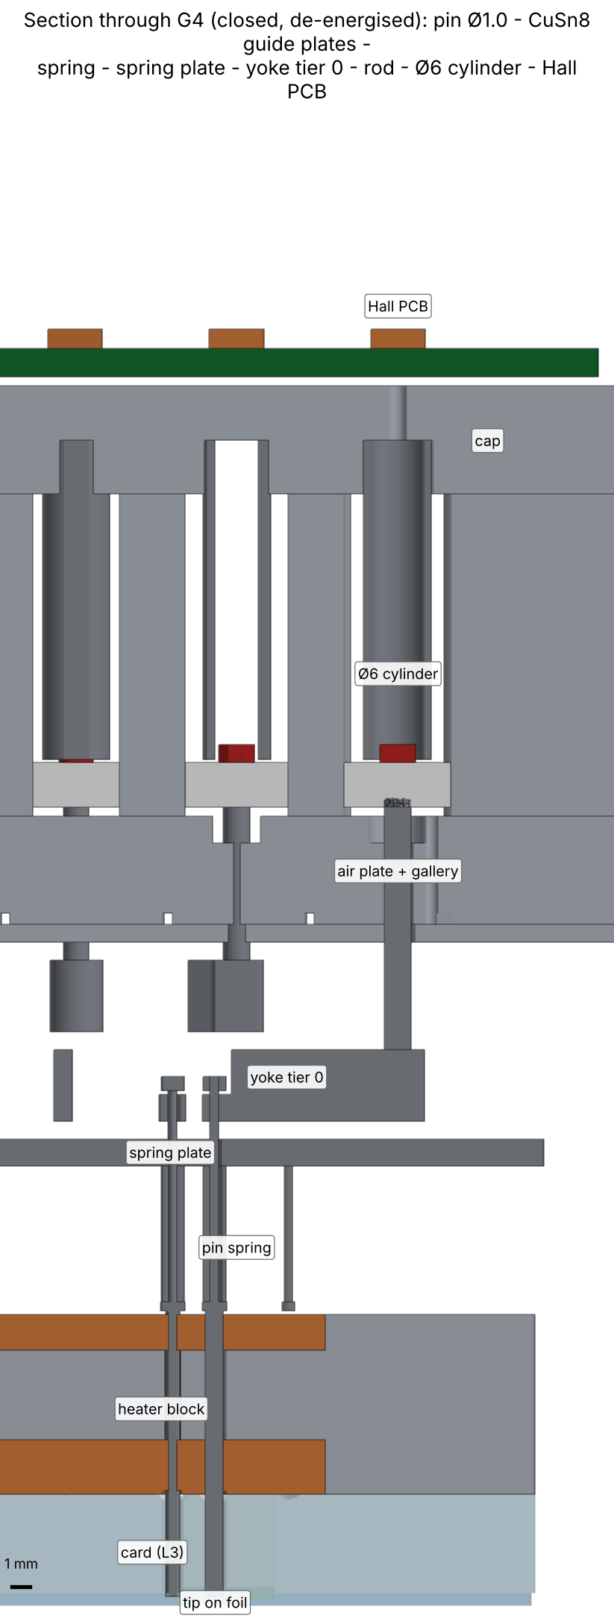
cad/out/dock_upper/section_pin_G4.png
