mhdelano-ai/ELISA/cad/out/dock_upper/section_tightest_pair_V11_V12.png

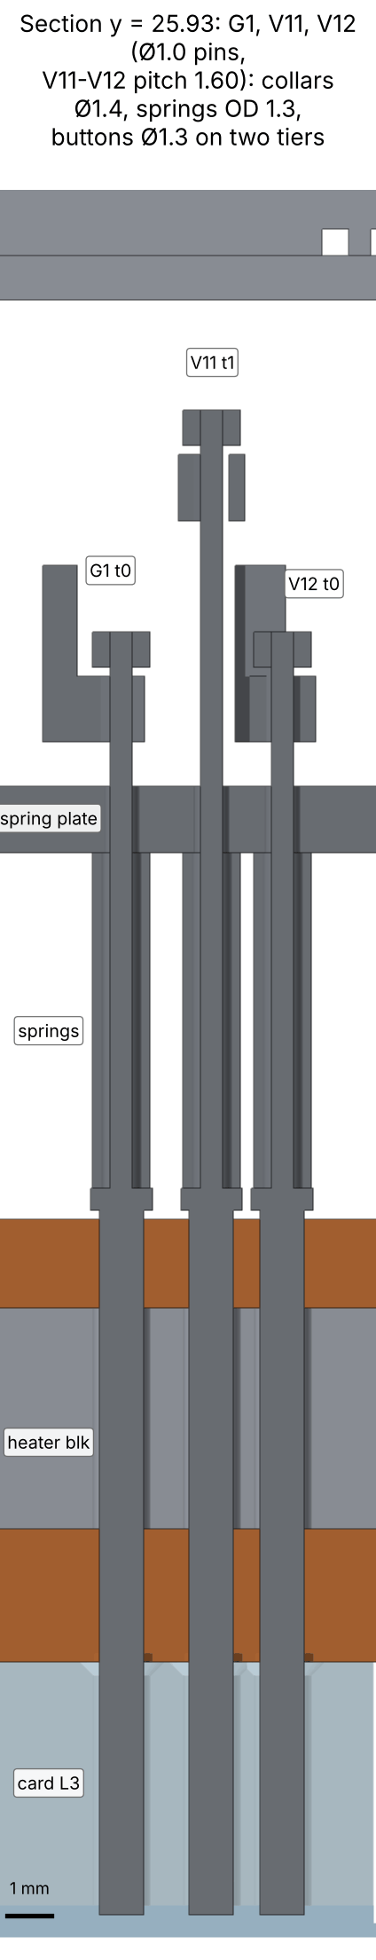
cad/out/dock_upper/section_tightest_pair_V11_V12.png
