mhdelano-ai/ELISA/cad/out/interface/card_envelope_iso.png

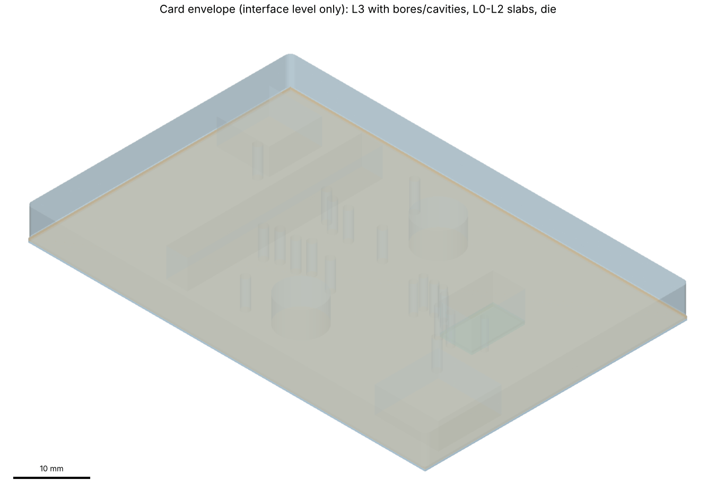
cad/out/interface/card_envelope_iso.png
