mhdelano-ai/ELISA/cad/out/interface/card_interface_plan.png

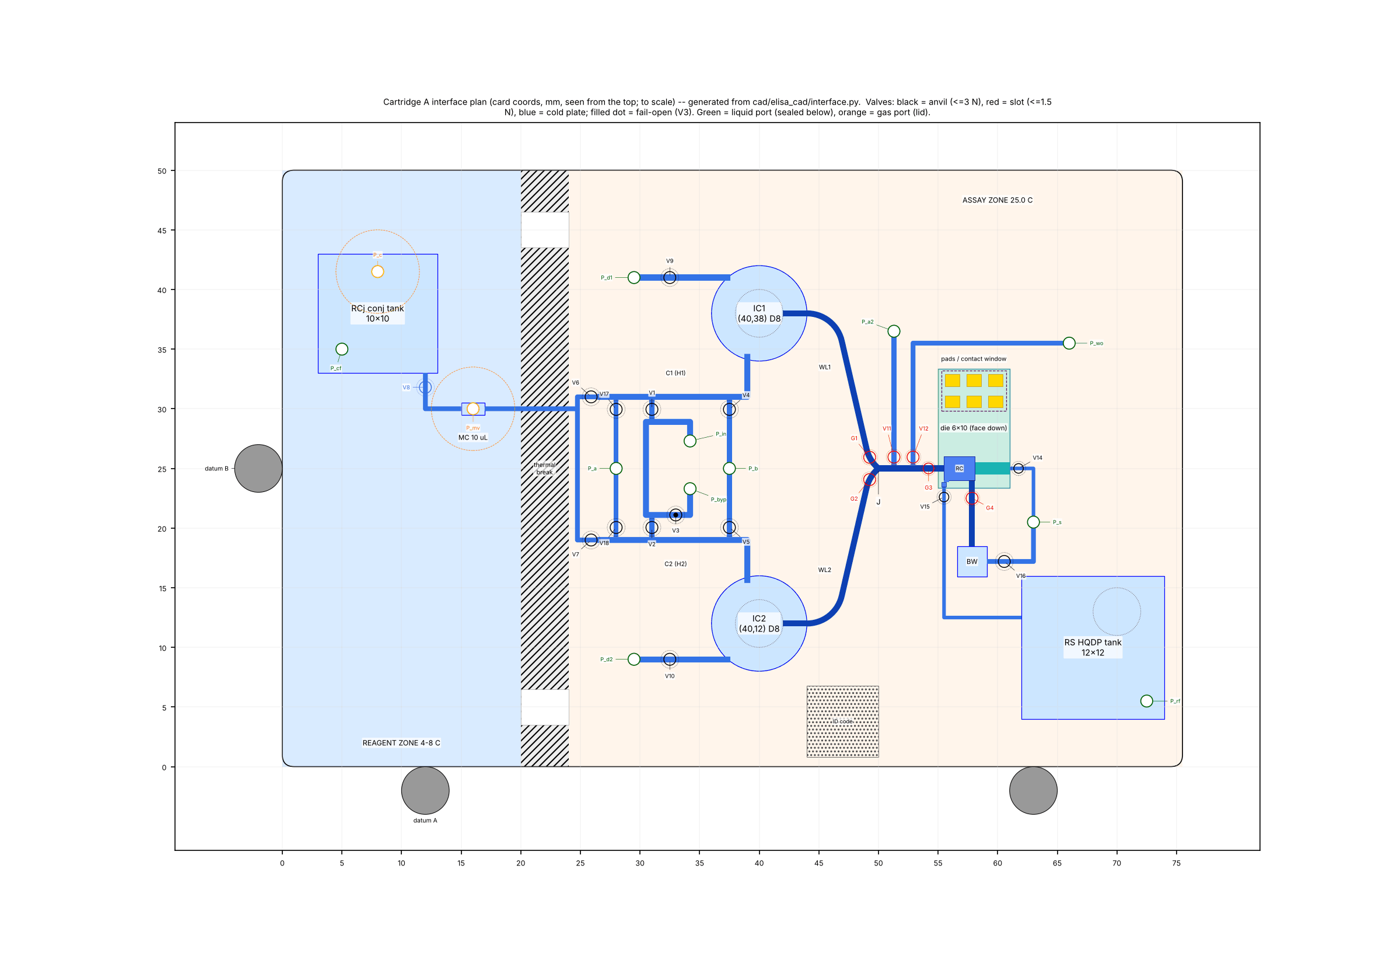
cad/out/interface/card_interface_plan.png
