mhdelano-ai/ELISA/cad/out/interface/dock_overlay_plan.png

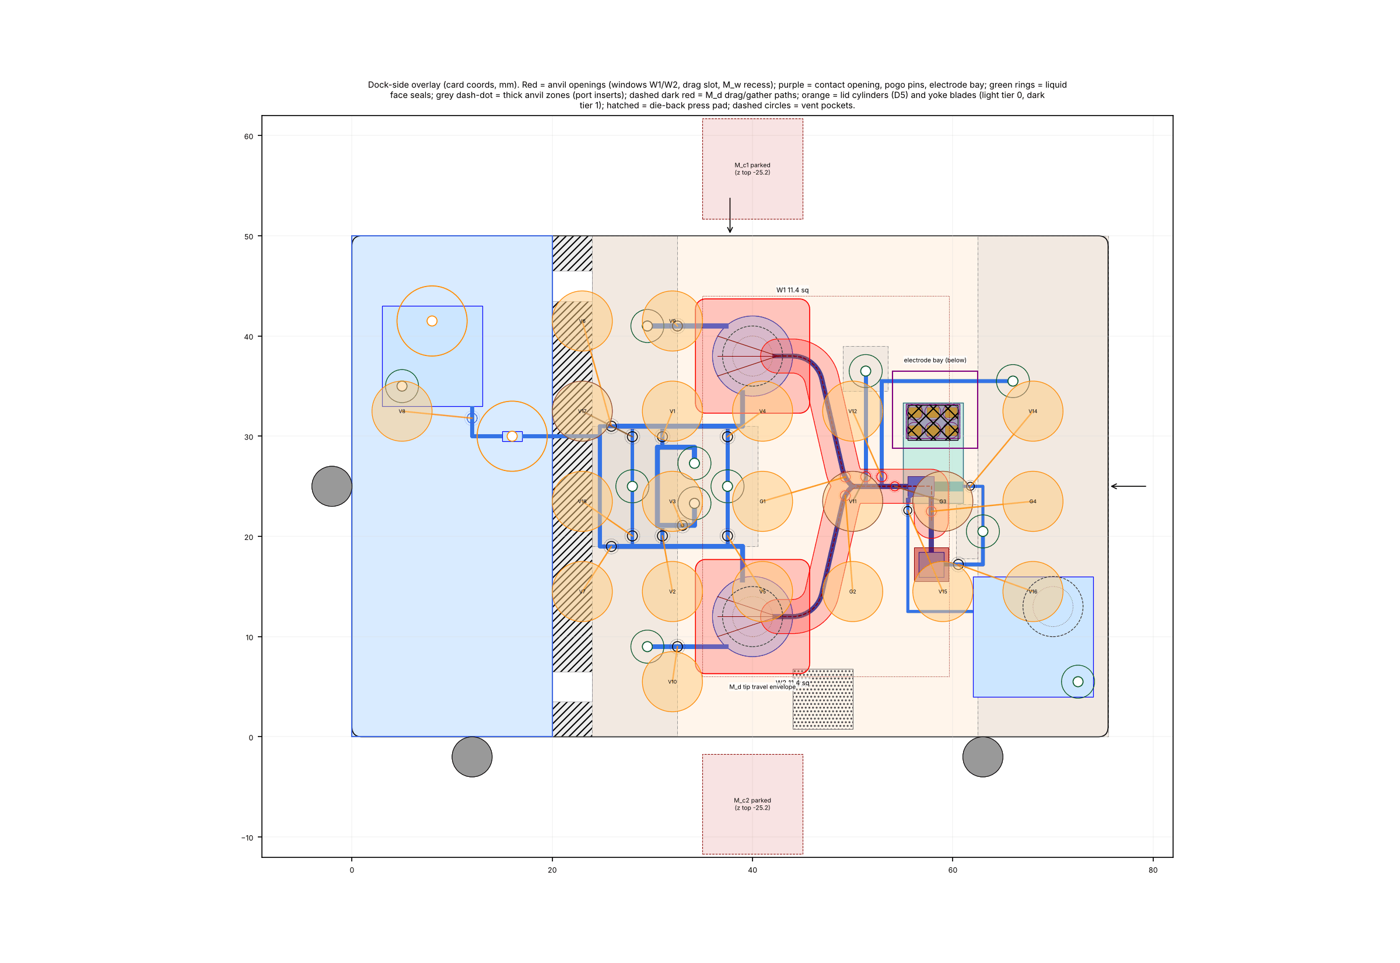
cad/out/interface/dock_overlay_plan.png
