mhdelano-ai/ELISA/cad/out/interface/dock_space_claims_iso.png

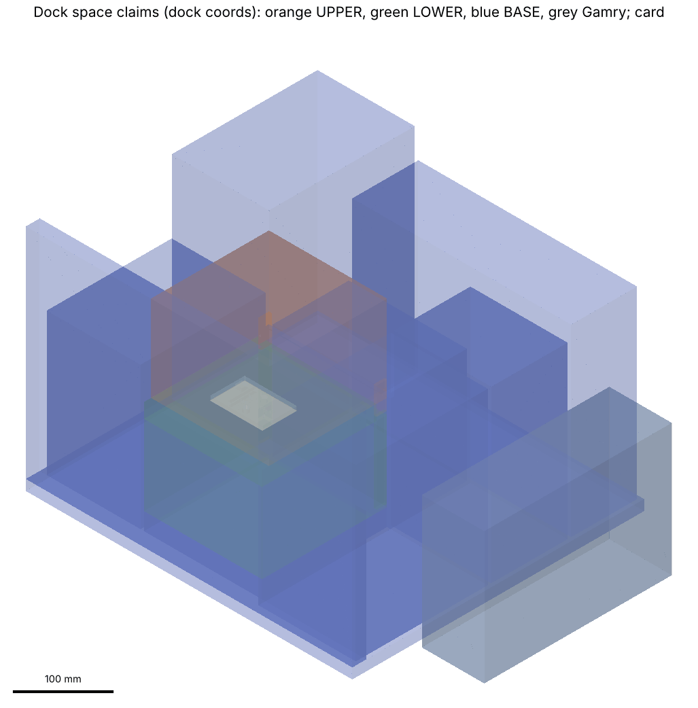
cad/out/interface/dock_space_claims_iso.png
