mhdelano-ai/ELISA/cad/out/interface/dock_space_claims_right.png

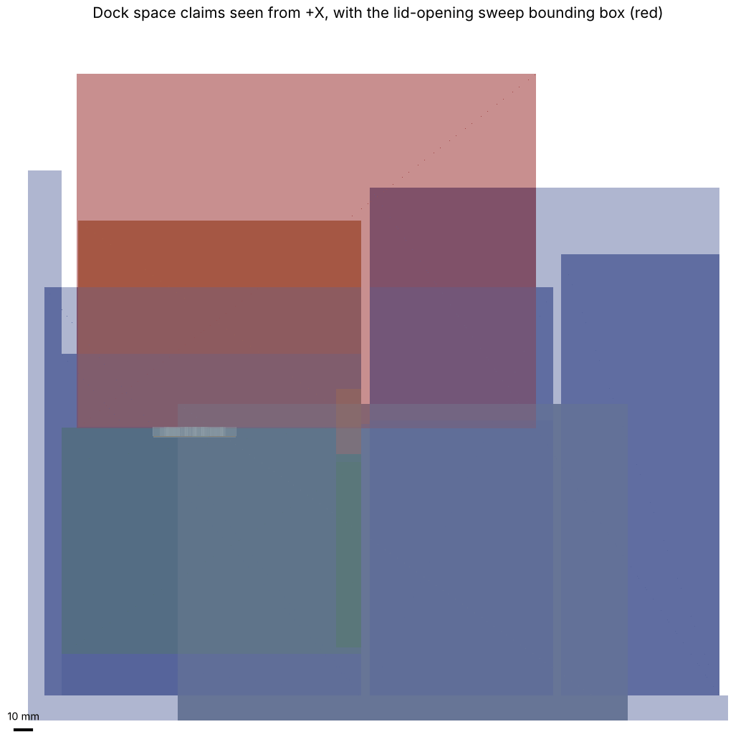
cad/out/interface/dock_space_claims_right.png
