mhdelano-ai/ELISA/cad/out/interface/zoom_cell_J.png

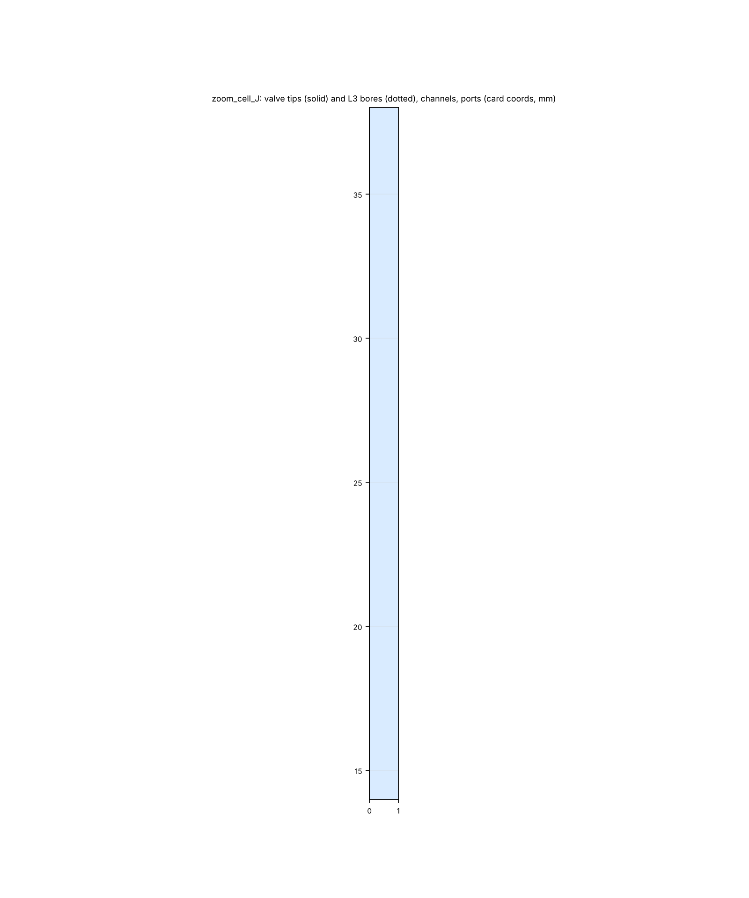
cad/out/interface/zoom_cell_J.png
