mhdelano-ai/ELISA/cad/out/dock_upper/lid_assembly_closed.step

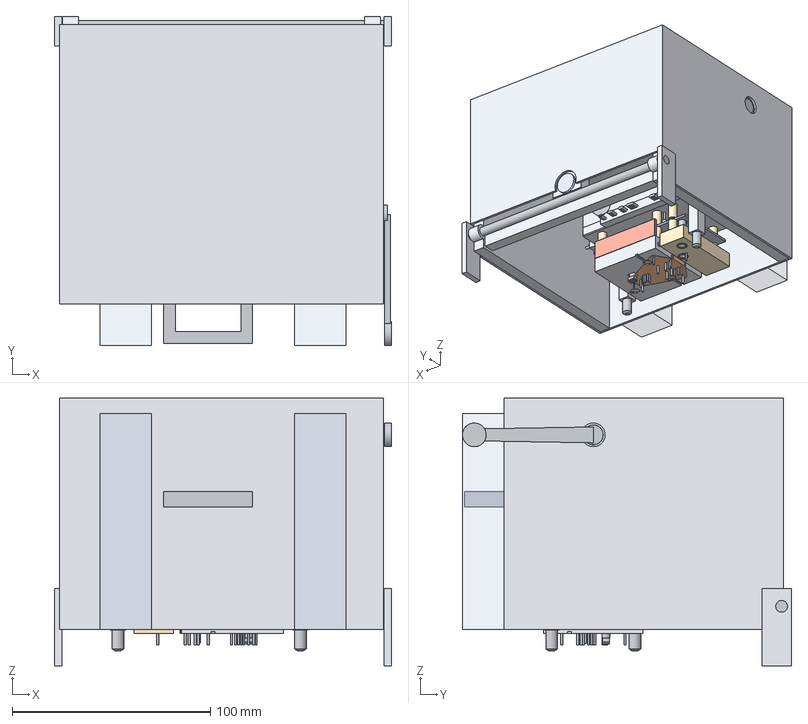
[picture p54: CAD file, 2026-11-13]
cad/out/dock_upper/lid_assembly_closed.step
170.0 x 166.0 x 135.0 mm
heater_block
guide_plate_lower
guide_plate_upper
peek_plate
V8_bush
spring_plate
standoff_00
standoff_01
standoff_02
standoff_03
standoff_04
standoff_05
standoff_06
standoff_07
standoff_08
standoff_09
standoff_10
standoff_11
standoff_12
standoff_13
ENV_gas_ring_P_c_ID5_OD7_t1
ENV_gas_ring_P_mv_ID5_OD7_t1
ENV_gas_barb_M3_P_c
ENV_gas_barb_M3_P_mv
press_pad_stem_foot
press_pad_silicone
ENV_press_pad_spring
pin_V1
button_V1
ENV_spring_V1
yoke_V1
pin_V2
button_V2
ENV_spring_V2
yoke_V2
pin_V3
button_V3
ENV_spring_V3
yoke_V3
pin_V4
button_V4
ENV_spring_V4
yoke_V4
pin_V5
button_V5
ENV_spring_V5
yoke_V5
pin_V6
button_V6
ENV_spring_V6
yoke_V6
pin_V7
button_V7
ENV_spring_V7
yoke_V7
pin_V8
button_V8
ENV_spring_V8
yoke_V8
pin_V9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
