mhdelano-ai/ELISA/cad/out/dock_upper/subassy_lid_frame_closed.step

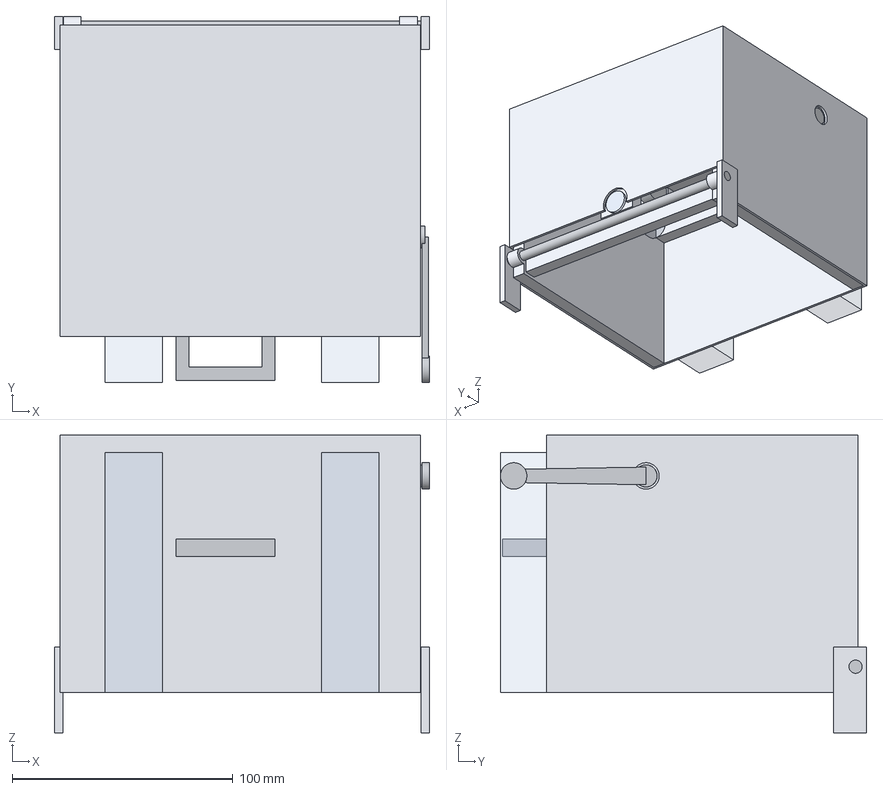
[picture p55: CAD file, 2026-11-13]
cad/out/dock_upper/subassy_lid_frame_closed.step
170.0 x 166.0 x 135.0 mm
lid_side_plate_L
lid_side_plate_R
lid_front_beam
lid_rear_beam
lid_post_block_-21_6
lid_post_block_-21_44
lid_post_block_96_6
lid_post_block_96_44
cover
cam_shaft
cam_eccentrics
cam_lever
lid_handle
ENV_latch_Kipp_K0045.1541092_X173
ENV_latch_Kipp_K0045.1541092_X271
ENV_lid_switch_Omron_D2F-class
umbilical_clamp
ENV_umbilical_bundle_D14
hinge_block_L
hinge_block_R
hinge_pin_D6
