mhdelano-ai/ELISA/cad/out/card/card_A_assembly.step

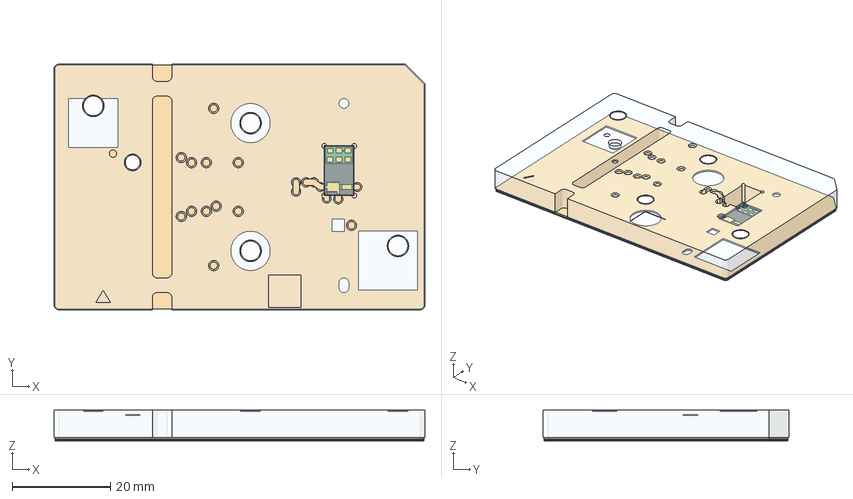
[picture p56: CAD file, 2026-11-13]
cad/out/card/card_A_assembly.step
75.5 x 50.0 x 6.21 mm
L0_foil
L1_channel_sheet
L1s_WE2_shim
L1b_die_film
L2_TPE
seam_adhesive
L3_body
die_glass
die_metal
die_passivation
L4_vent_IC1_adh
L4_vent_IC1
L4_vent_IC2_adh
L4_vent_IC2
L4_vent_RS_adh
L4_vent_RS
L4_vent_P_c_adh
L4_vent_P_c
L4_MC_stop_adh
L4_MC_stop
