mhdelano-ai/ELISA/cad/out/dock_lower/assy_lower_bay_hold_RC.step

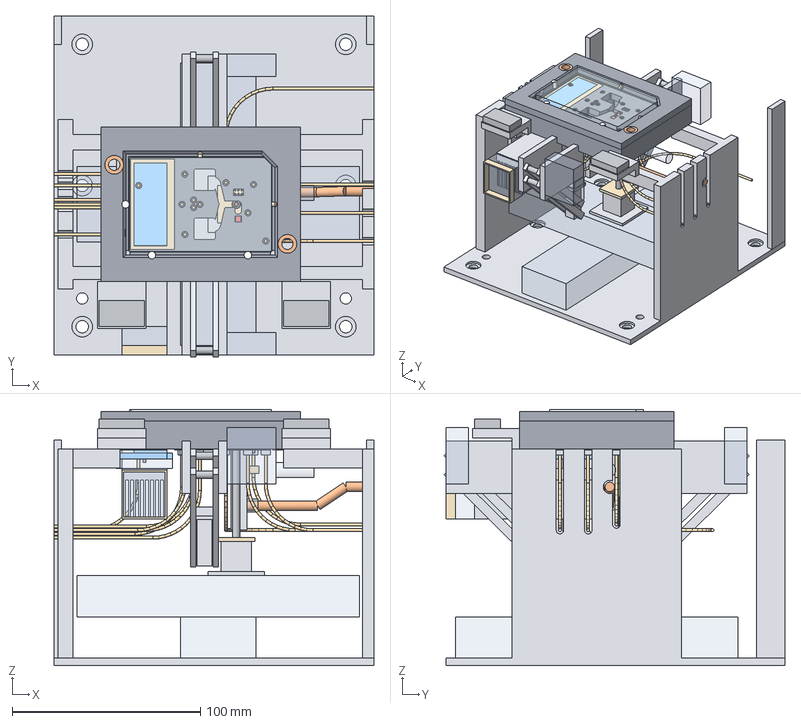
[picture p57: CAD file, 2026-11-13]
cad/out/dock_lower/assy_lower_bay_hold_RC.step
170.0 x 181.0 x 136.2 mm
anvil
nest_frame
peek_break_frame
cold_block
peltier_module
heatsink_env
fan_env
exhaust_duct
foam_insulation
M_w_magnet
bay_frame
ebay_enclosure
gamry_cable
card_presence_env
latch_bracket_1
latch_catch_plate_env_1
latch_bracket_2
latch_catch_plate_env_2
hinge_pedestal_L
hinge_pedestal_R
heater_hW
heater_hE
heater_hS
heater_hN
datum_pin_A1
datum_pin_A2
datum_pin_B
guide_bush_1
guide_bush_2
insert_P_in
gasket_P_in
tube_P_in
insert_P_byp
gasket_P_byp
tube_P_byp
insert_P_b
gasket_P_b
tube_P_b
insert_P_a
gasket_P_a
tube_P_a
insert_P_a2
gasket_P_a2
tube_P_a2
insert_P_d1
gasket_P_d1
tube_P_d1
insert_P_d2
gasket_P_d2
tube_P_d2
insert_P_wo
gasket_P_wo
tube_P_wo
insert_P_s
gasket_P_s
tube_P_s
insert_P_rf
gasket_P_rf
tube_P_rf
insert_P_cf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
