mhdelano-ai/ELISA/cad/out/card/cut_L1b_die_film.dxf

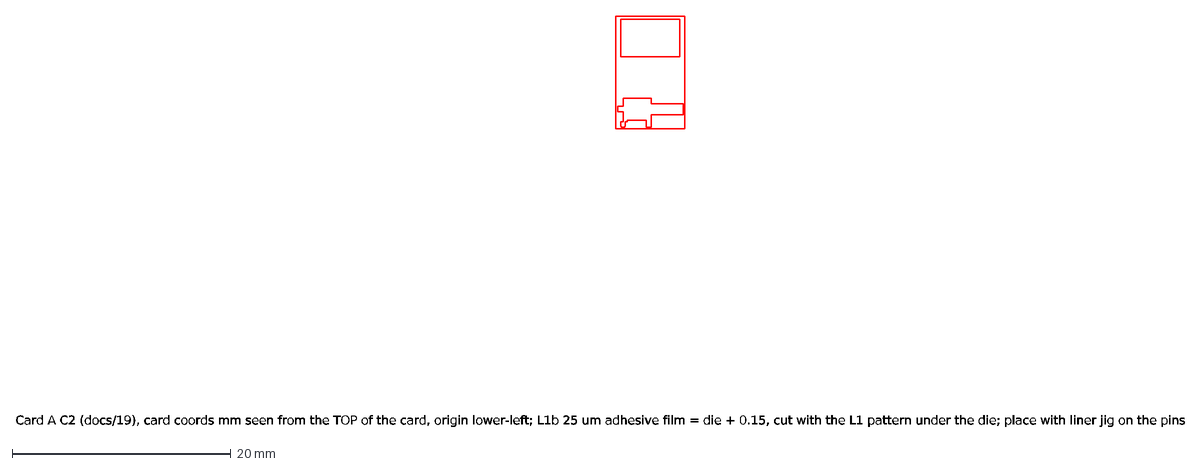
[picture p59: CAD file, 2026-11-13]
cad/out/card/cut_L1b_die_film.dxf
Card A C2 (docs/19), card coords mm seen from the TOP of the card, origin lower-left; L1b 25 um adhesive film = die + 0.15, cut with the L1 pattern under the di
