mhdelano-ai/ELISA/cad/out/dock_base/base_pumps.step

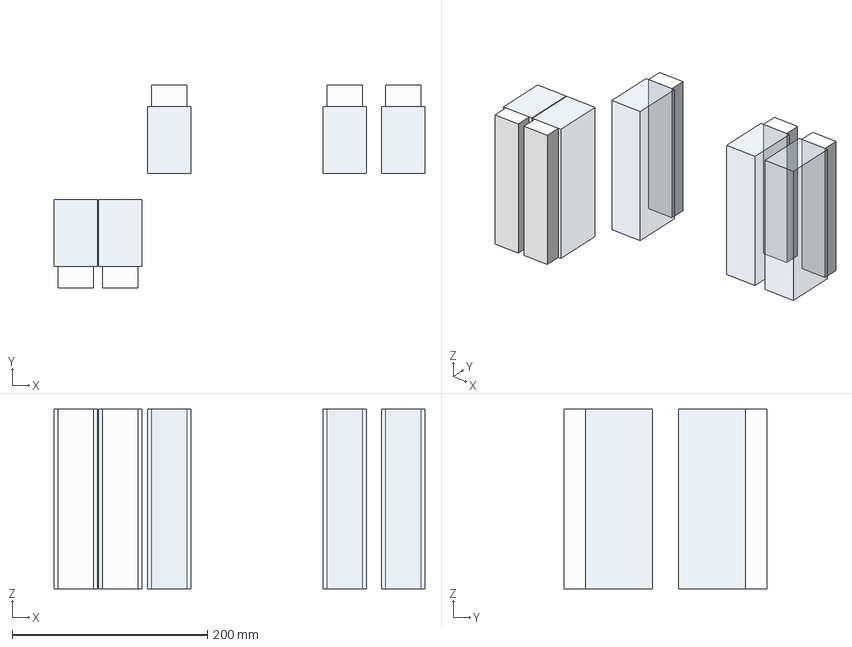
[picture p60: CAD file, 2026-11-13]
cad/out/dock_base/base_pumps.step
380.2 x 207.8 x 184.2 mm
S_IC1_body
S_IC1_valve_syringe
S_IC2_body
S_IC2_valve_syringe
S_b_body
S_b_valve_syringe
S_A_body
S_A_valve_syringe
S_RC_body
S_RC_valve_syringe
