mhdelano-ai/ELISA/cad/out/dock_lower/part_exhaust_duct.step

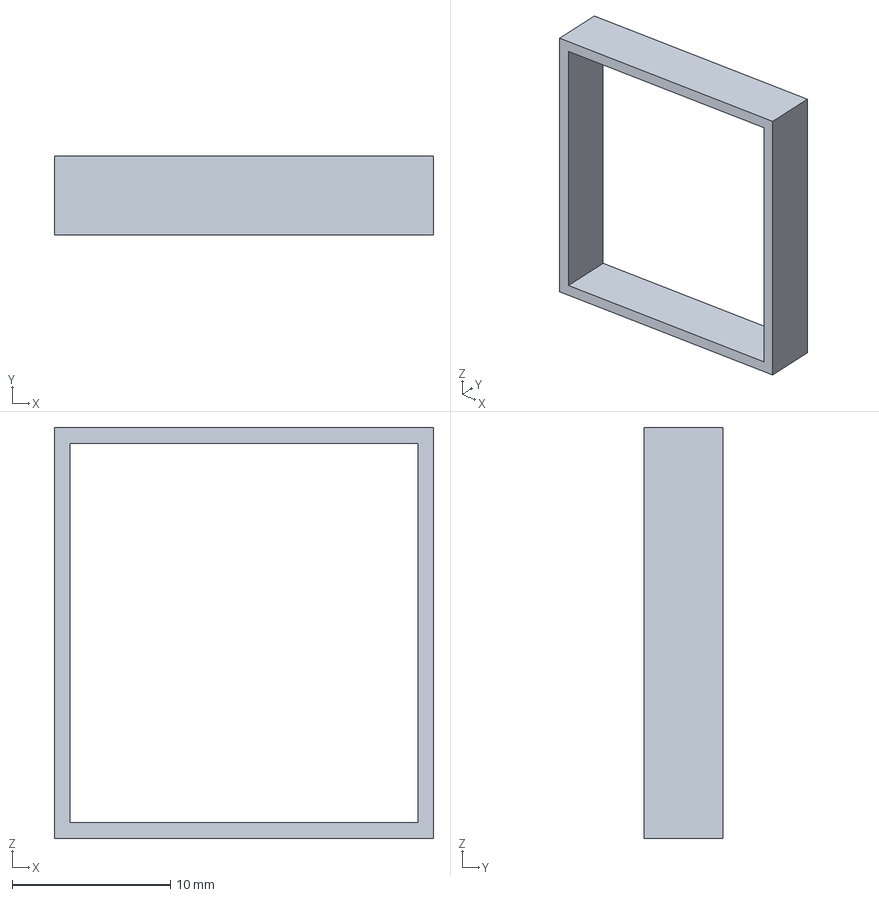
[picture p61: CAD file, 2026-11-13]
cad/out/dock_lower/part_exhaust_duct.step
24.0 x 5.00 x 26.0 mm
