mhdelano-ai/ELISA/cad/out/dock_upper/parts/thrust_family.step

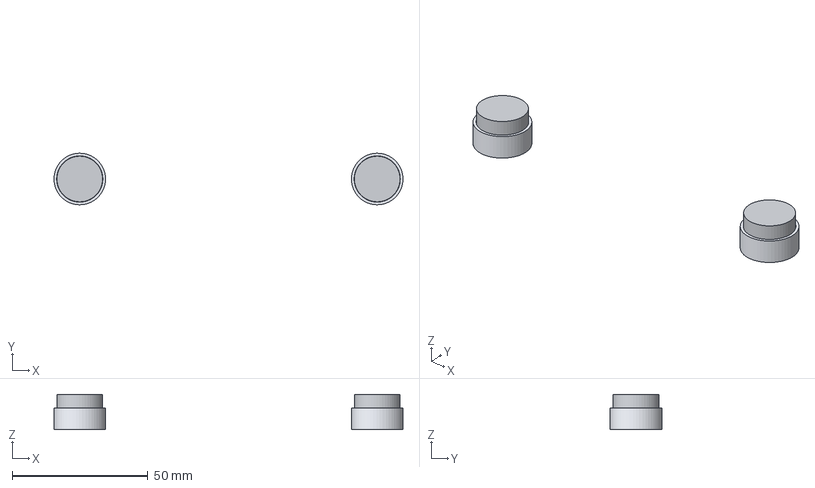
[picture p62: CAD file, 2026-11-13]
cad/out/dock_upper/parts/thrust_family.step
128.5 x 19.0 x 13.0 mm
thrust_housing_0
thrust_cap_0
thrust_housing_1
thrust_cap_1
