mhdelano-ai/ELISA/cad/out/interface/card_envelope.step

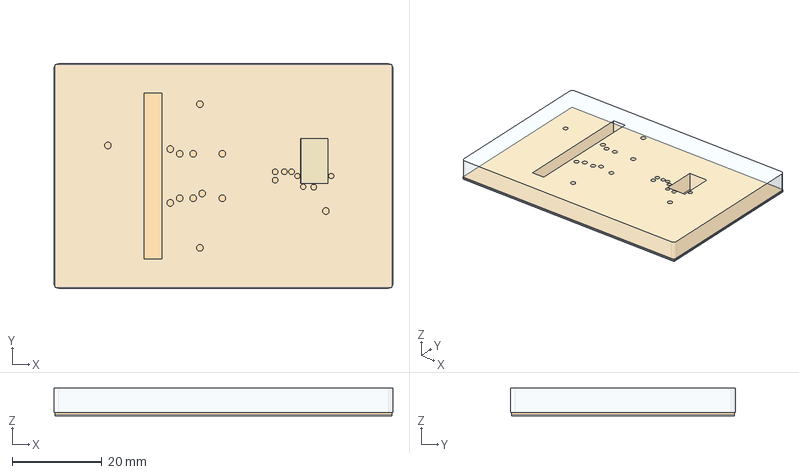
[picture p63: CAD file, 2026-11-13]
cad/out/interface/card_envelope.step
75.5 x 50.0 x 6.21 mm
card_L3_envelope
L0
L1
L2
die
