mhdelano-ai/ELISA/cad/out/assembly/dock_open_loading.step

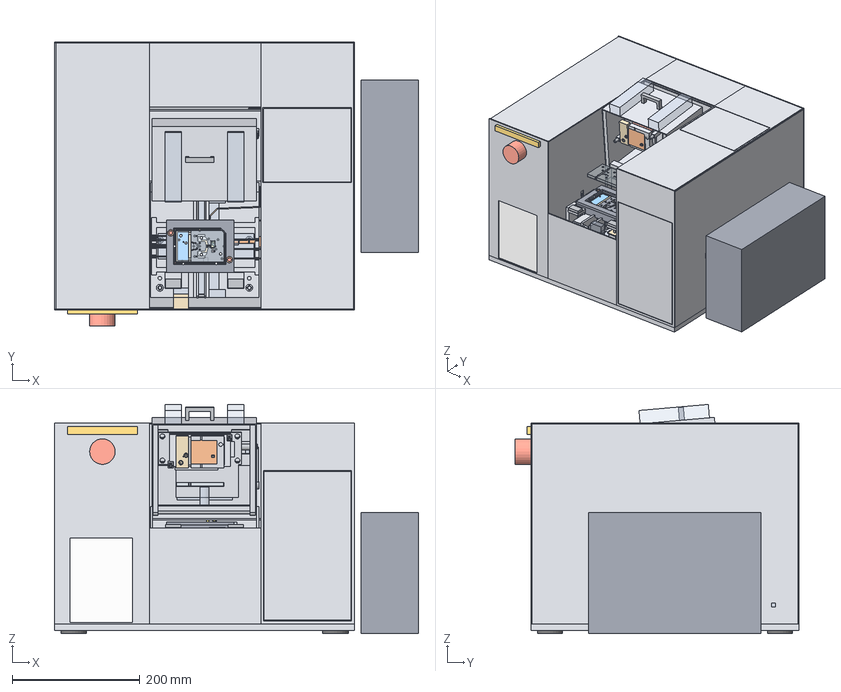
[picture p64: CAD file, 2026-11-13]
cad/out/assembly/dock_open_loading.step
570.0 x 445.0 x 358.9 mm
LOWER__anvil_slot_simplified
LOWER__nest_frame
LOWER__peek_break_frame
LOWER__cold_block
LOWER__peltier_module
LOWER__heatsink_env_envelope
LOWER__fan_env
LOWER__exhaust_duct
LOWER__foam_insulation
LOWER__M_w_magnet
LOWER__bay_frame
LOWER__ebay_enclosure
LOWER__gamry_cable
LOWER__card_presence_env
LOWER__latch_bracket_1
LOWER__latch_catch_plate_env_1
LOWER__latch_bracket_2
LOWER__latch_catch_plate_env_2
LOWER__hinge_pedestal_L
LOWER__hinge_pedestal_R
LOWER__heater_hW_envelope
LOWER__heater_hE_envelope
LOWER__heater_hS_envelope
LOWER__heater_hN_envelope
LOWER__datum_pin_A1
LOWER__datum_pin_A2
LOWER__datum_pin_B
LOWER__guide_bush_1
LOWER__guide_bush_2
LOWER__insert_P_in
LOWER__gasket_P_in
LOWER__tube_P_in
LOWER__insert_P_byp
LOWER__gasket_P_byp
LOWER__tube_P_byp
LOWER__insert_P_b
LOWER__gasket_P_b
LOWER__tube_P_b
LOWER__insert_P_a
LOWER__gasket_P_a
LOWER__tube_P_a
LOWER__insert_P_a2
LOWER__gasket_P_a2
LOWER__tube_P_a2
LOWER__insert_P_d1
LOWER__gasket_P_d1
LOWER__tube_P_d1
LOWER__insert_P_d2
LOWER__gasket_P_d2
LOWER__tube_P_d2
LOWER__insert_P_wo
LOWER__gasket_P_wo
LOWER__tube_P_wo
LOWER__insert_P_s
LOWER__gasket_P_s
LOWER__tube_P_s
LOWER__insert_P_rf
LOWER__gasket_P_rf
LOWER__tube_P_rf
LOWER__insert_P_cf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
