mhdelano-ai/ELISA/cad/out/card/die_mask_layers.dxf

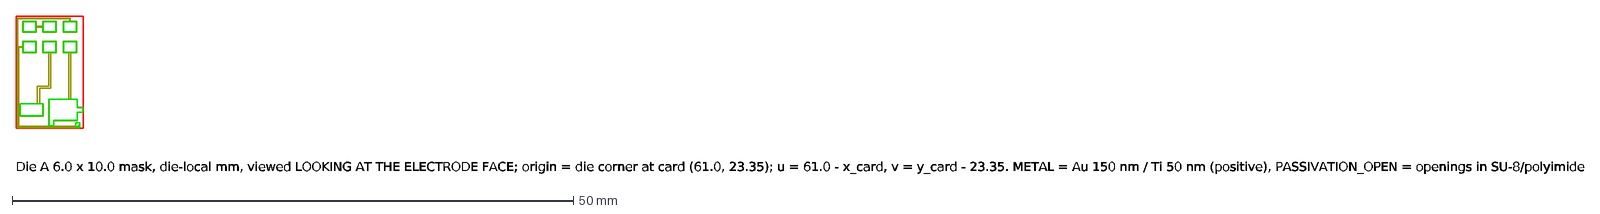
[picture p65: CAD file, 2026-11-13]
cad/out/card/die_mask_layers.dxf
Die A 6.0 x 10.0 mask, die-local mm, viewed LOOKING AT THE ELECTRODE FACE; origin = die corner at card (61.0, 23.35); u = 61.0 - x_card, v = y_card - 23.35. MET
