mhdelano-ai/ELISA/cad/out/dock_base/base_tubing.step

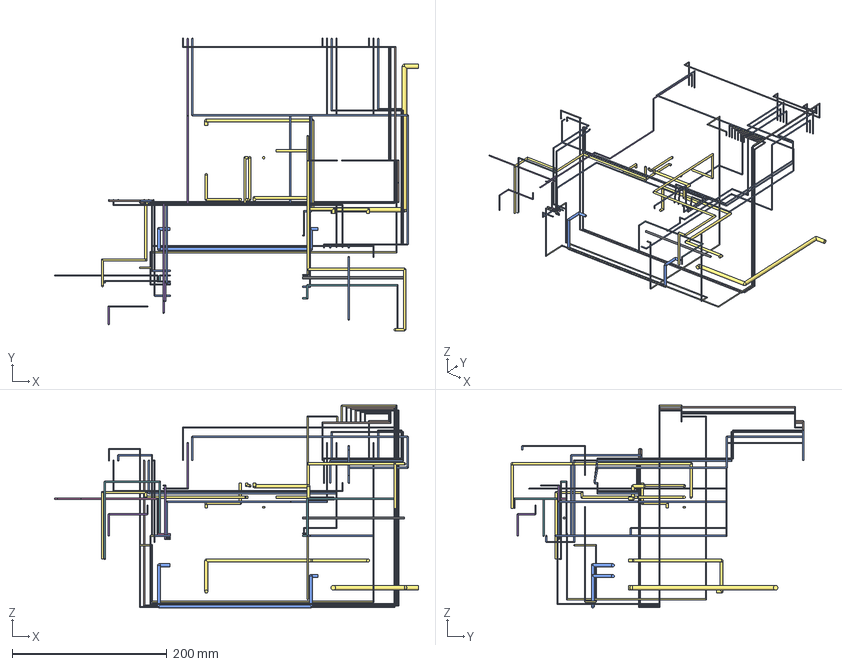
[picture p66: CAD file, 2026-11-13]
cad/out/dock_base/base_tubing.step
470.0 x 378.2 x 261.8 mm
P_in
P_b
P_cf
P_d1_coil
P_d2_coil
P_a
P_byp
P_s
P_a2
P_wo
P_rf
P_c_gas
P_mv_gas
gas_-_conjugate_tube
gas_-_HQDP_tube
S_b_holding_coil
vial_line
A1_-_S_IC1
S_IC1_-_waste
A1_-_S_IC2
S_IC2_-_waste
A1_-_S_b
S_b_-_waste
A1_-_S_A
S_A_-_waste
A1_-_S_RC
S_RC_-_waste
A1_bottle_-_manifold
lab_air_-_FR1
FR1_400_kPa_-_lid_pilots
R2_120_kPa_-_Flow_EZ_supplies
Flow_EZ_ch2_-_switch_valves
FR1_400_kPa_-_pogo-lift_valve_-_LOWER_cable_window
dry-air_purge_-_cold_box
cell_leads
