mhdelano-ai/ELISA/cad/out/dock_lower/part_Md_post.step

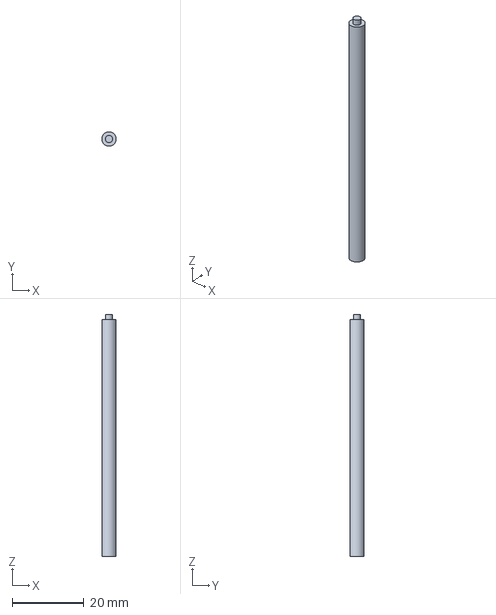
[picture p67: CAD file, 2026-11-13]
cad/out/dock_lower/part_Md_post.step
4.00 x 4.00 x 67.4 mm
