mhdelano-ai/ELISA/cad/out/dock_upper/parts/lid_post_block_family.step

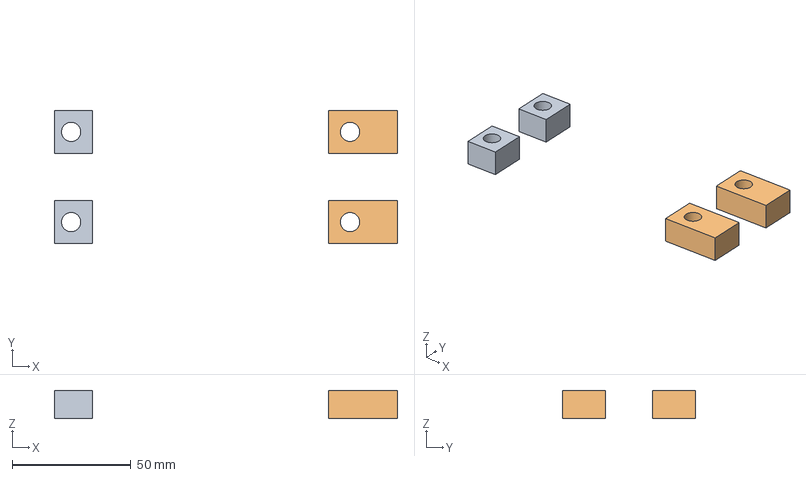
[picture p68: CAD file, 2026-11-13]
cad/out/dock_upper/parts/lid_post_block_family.step
144.5 x 56.0 x 12.0 mm
lid_post_block_-21_6
lid_post_block_-21_44
lid_post_block_96_6
lid_post_block_96_44
