mhdelano-ai/ELISA/cad/out/interface/dock_space_claims.step

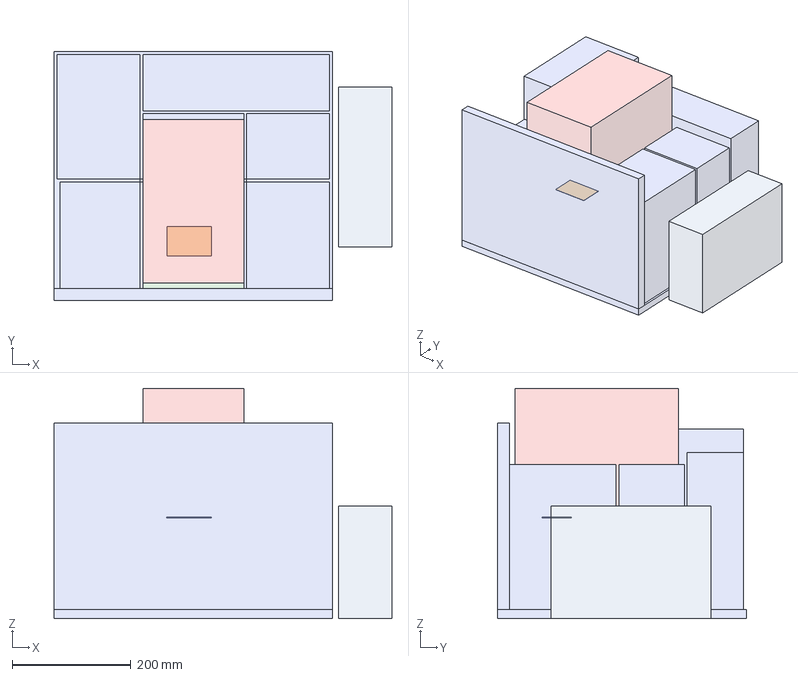
[picture p69: CAD file, 2026-11-13]
cad/out/interface/dock_space_claims.step
570.0 x 420.0 x 388.2 mm
UPPER_lid_closed
LOWER_nest_anvil
LOWER_bay
BASE_drip_tray
BASE_cold_compartment
BASE_under_bay
BASE_bottles
BASE_rear_low
BASE_pumps
BASE_electronics
BASE_right_rear
BENCH_gamry
BASE_front_strip
BASE_lane_gap
LOWER_hinge_pedestal_L
LOWER_hinge_pedestal_R
UPPER_hinge_block_L
UPPER_hinge_block_R
UPPER_lid_open_sweep_bbox
card_L3_envelope
L0
L1
L2
die
