mhdelano-ai/ELISA/cad/out/card/card_L1_channel_sheet.step

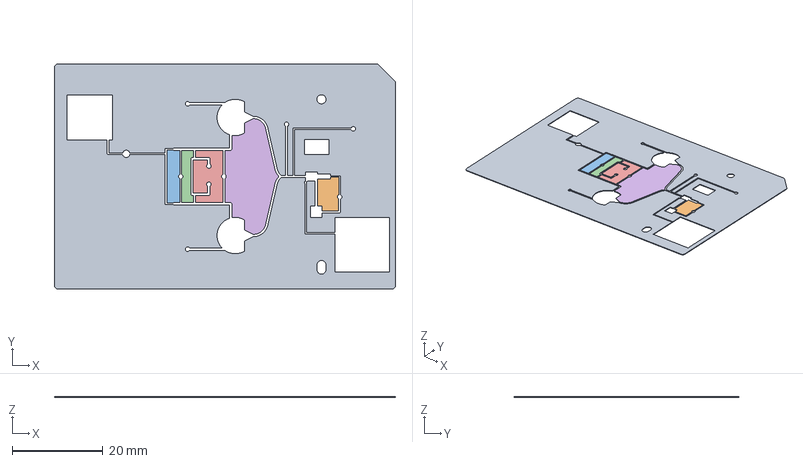
[picture p70: CAD file, 2026-11-13]
cad/out/card/card_L1_channel_sheet.step
75.1 x 49.6 x 0.175 mm
