mhdelano-ai/ELISA/cad/out/dock_base/base_frame.step

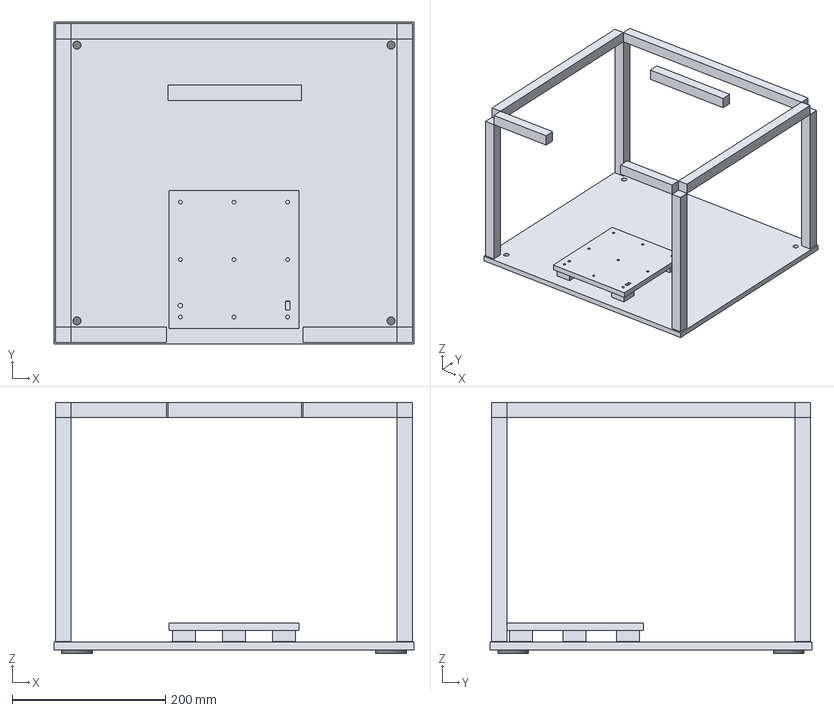
[picture p71: CAD file, 2026-11-13]
cad/out/dock_base/base_frame.step
470.0 x 420.0 x 328.0 mm
base_plate
foot_1
foot_2
foot_3
foot_4
post_1
post_2
post_3
post_4
rail_left
rail_right
rail_rear
rail_front_left
rail_front_right
rail_well_rear
bay_deck
deck_spacer_1
deck_spacer_2
deck_spacer_3
deck_spacer_4
deck_spacer_5
