mhdelano-ai/ELISA/cad/out/dock_lower/part_Mc1_carrier.step

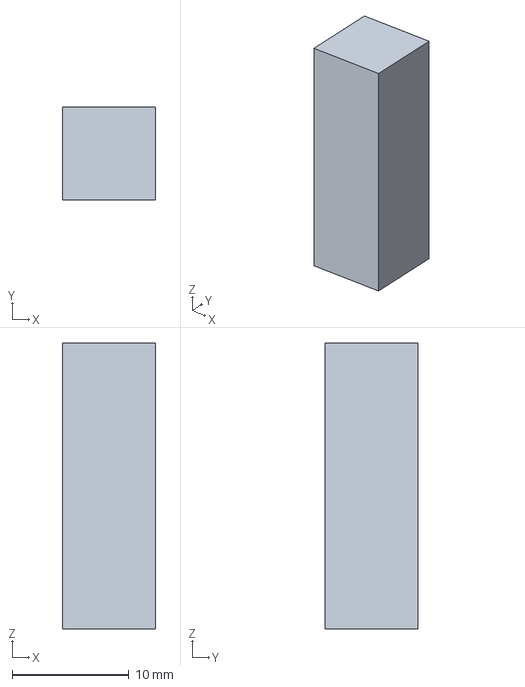
[picture p72: CAD file, 2026-11-13]
cad/out/dock_lower/part_Mc1_carrier.step
8.00 x 8.00 x 24.5 mm
