mhdelano-ai/ELISA/cad/out/dock_upper/card_envelope_ref.step

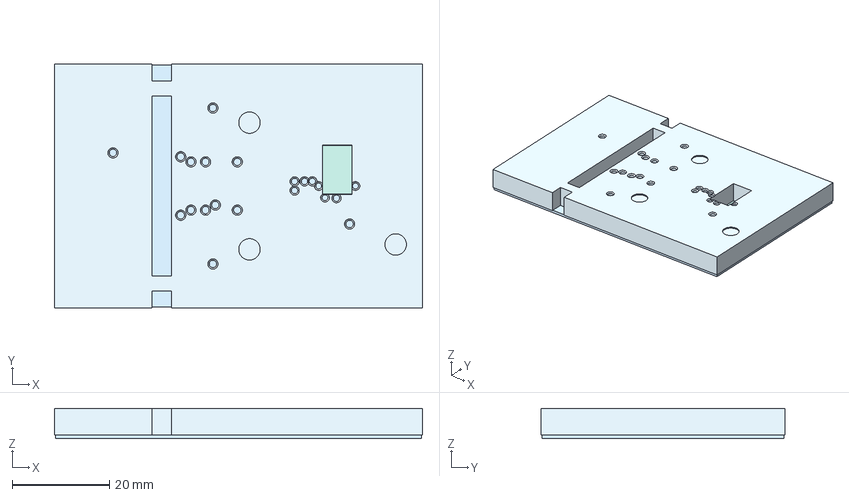
[picture p73: CAD file, 2026-11-13]
cad/out/dock_upper/card_envelope_ref.step
75.5 x 50.0 x 6.22 mm
CARD_ENV_L3
CARD_ENV_L0-L2
CARD_ENV_die
