mhdelano-ai/ELISA/cad/out/dock_upper/parts/guide_post_family.step

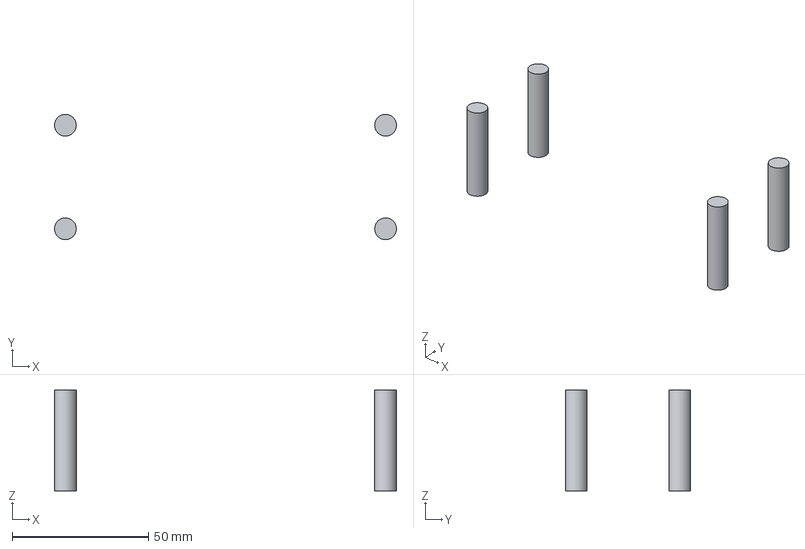
[picture p74: CAD file, 2026-11-13]
cad/out/dock_upper/parts/guide_post_family.step
125.5 x 46.0 x 37.0 mm
guide_post_0
guide_post_1
guide_post_2
guide_post_3
