mhdelano-ai/ELISA/cad/out/card/card_L1s_WE2_shim.step

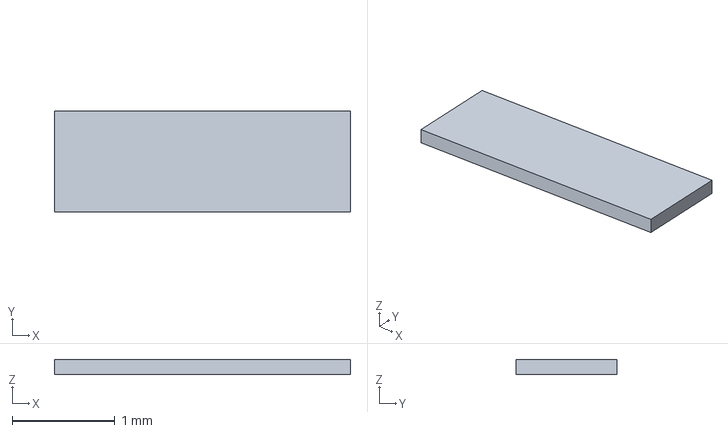
[picture p75: CAD file, 2026-11-13]
cad/out/card/card_L1s_WE2_shim.step
2.88 x 0.98 x 0.15 mm
