mhdelano-ai/ELISA/cad/out/dock_base/base_sensors.step

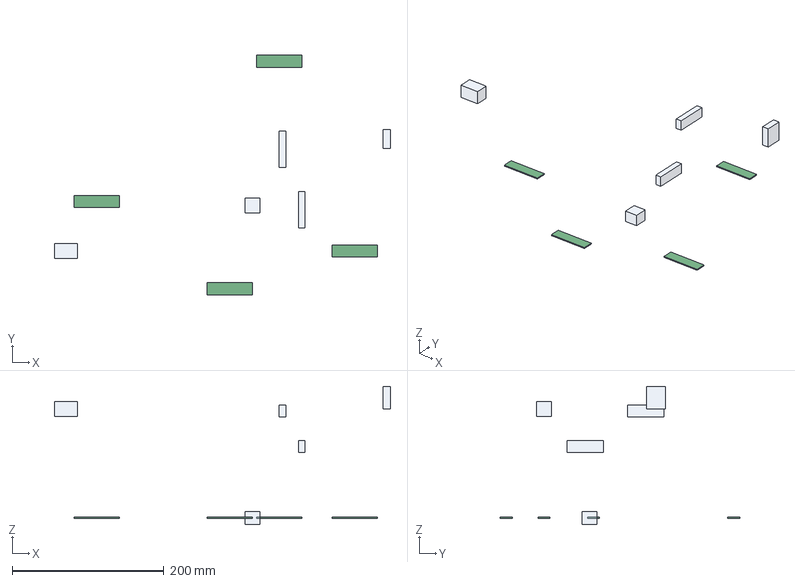
[picture p76: CAD file, 2026-11-13]
cad/out/dock_base/base_sensors.step
443.0 x 316.0 x 182.0 mm
leak_level_switch
leak_electrode_1
leak_electrode_2
leak_electrode_3
leak_electrode_4
P_in_pressure_sensor
waste_level_sensor
FS1_SLF3S_P_a
FS2_P_s
