mhdelano-ai/ELISA/cad/out/dock_lower/part_hinge_pedestal.step

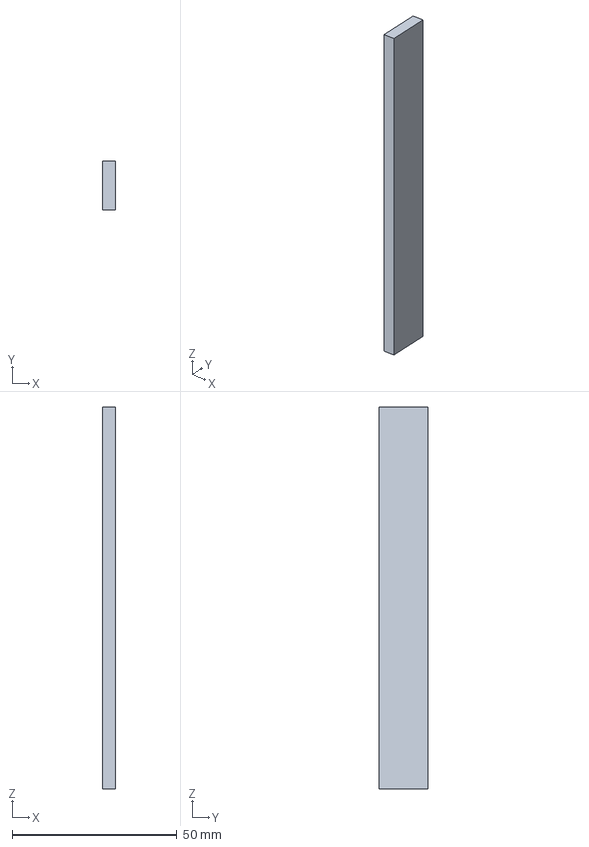
[picture p77: CAD file, 2026-11-13]
cad/out/dock_lower/part_hinge_pedestal.step
4.00 x 15.0 x 116.0 mm
