mhdelano-ai/ELISA/cad/out/dock_upper/parts/guide_ear_family.step

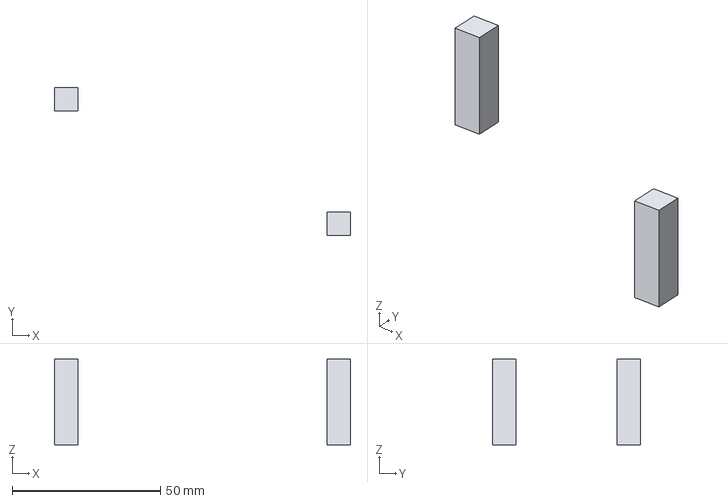
[picture p78: CAD file, 2026-11-13]
cad/out/dock_upper/parts/guide_ear_family.step
100.0 x 50.0 x 29.0 mm
guide_ear_GP1
guide_ear_GP2
