mhdelano-ai/ELISA/cad/out/card/card_L0_foil.step

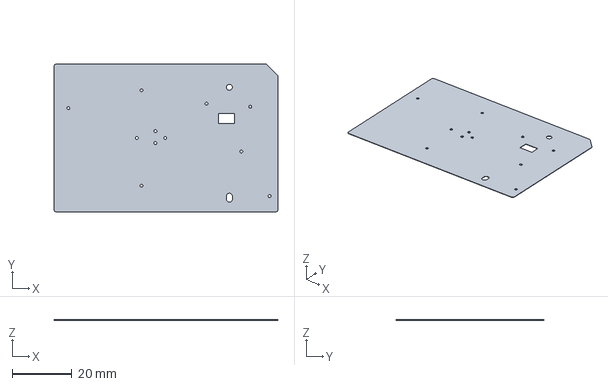
[picture p79: CAD file, 2026-11-13]
cad/out/card/card_L0_foil.step
75.1 x 49.6 x 0.14 mm
