mhdelano-ai/ELISA/cad/out/dock_base/base_electronics.step

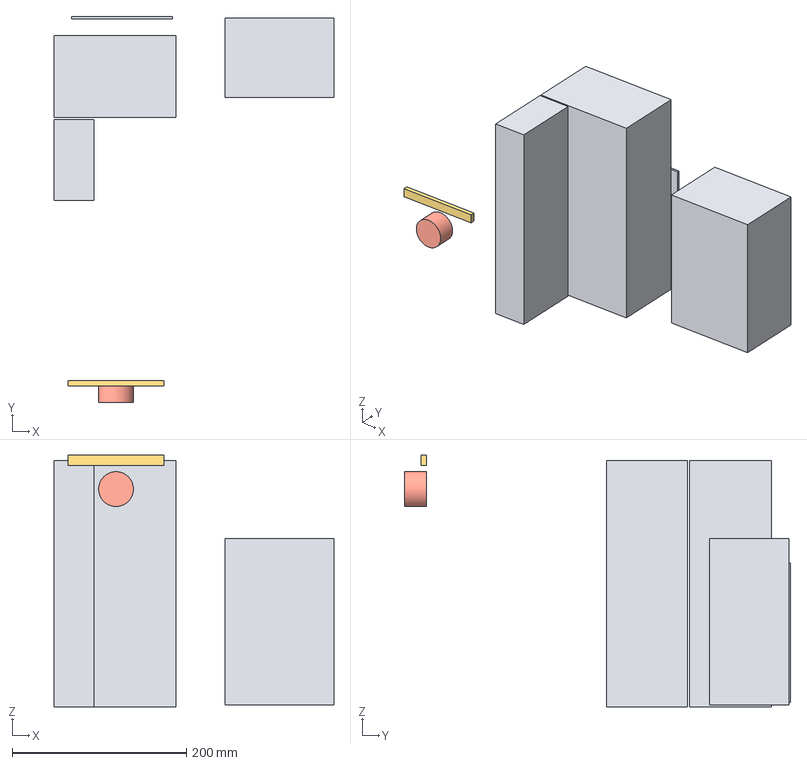
[picture p80: CAD file, 2026-11-13]
cad/out/dock_base/base_electronics.step
321.0 x 443.0 x 289.0 mm
electronics_box
electronics_box_side
electronics_box_rear
PSU_M_24V_350W
PSU_T_24V_350W
USB_isolator_hub
mains_filter_fuse
LabJack_U3_iso
intake_filter_grille
fan_exhaust_80
PSU_L_12V_lownoise
controller_watchdog
relay_interlock
mount_plate
Fluigent_LINK
valve_pilot_driver_21
aux_valve_driver_8
stepper_drivers_x6
thermal_drivers_x4
connector_panel
estop
status_light
