mhdelano-ai/ELISA/cad/out/dock_lower/part_face_gasket.step

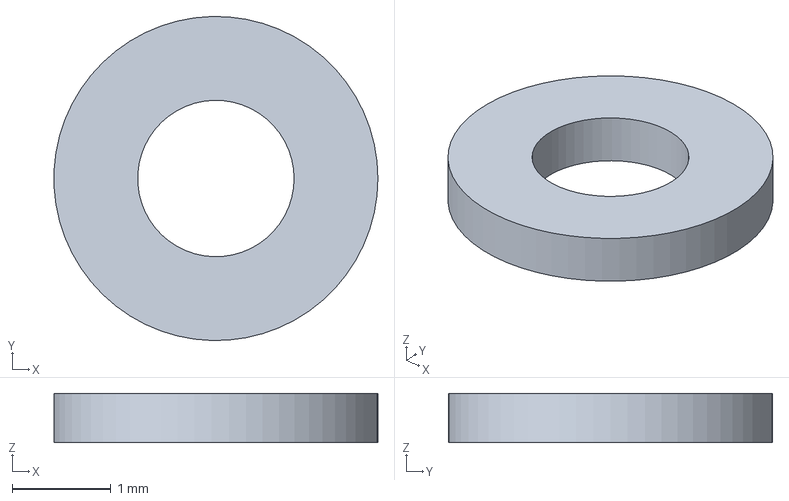
[picture p81: CAD file, 2026-11-13]
cad/out/dock_lower/part_face_gasket.step
3.29 x 3.29 x 0.5 mm
