mhdelano-ai/ELISA/cad/out/dock_upper/parts/peek_plate.step

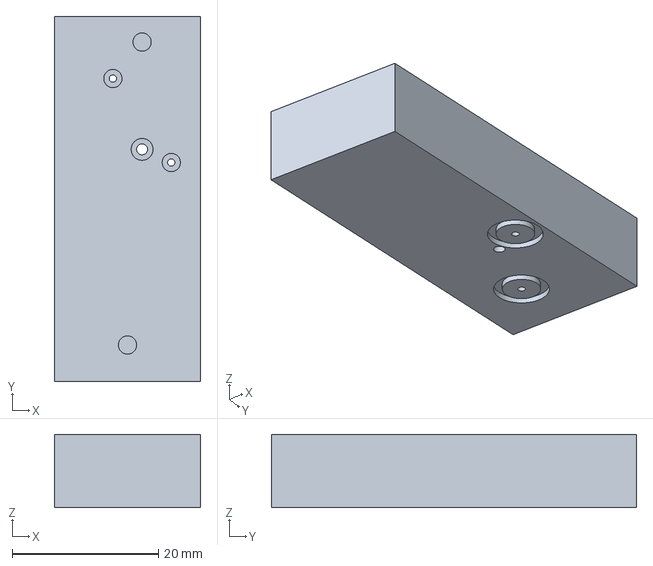
[picture p82: CAD file, 2026-11-13]
cad/out/dock_upper/parts/peek_plate.step
20.0 x 50.0 x 10.0 mm
