mhdelano-ai/ELISA/cad/out/dock_base/base_bottles_pneumatics.step

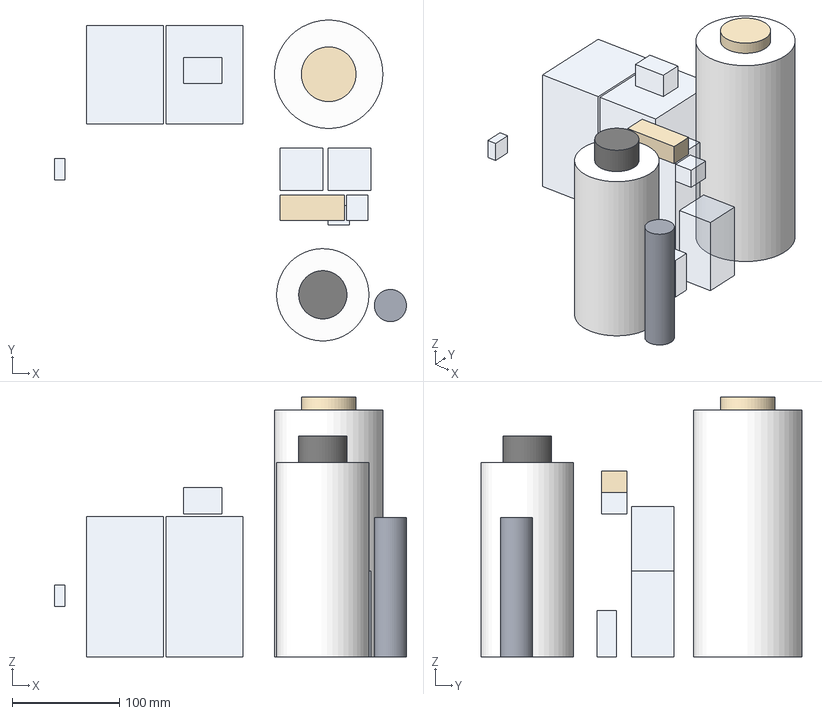
[picture p83: CAD file, 2026-11-13]
cad/out/dock_base/base_bottles_pneumatics.step
328.0 x 299.0 x 242.0 mm
A1_bottle_500mL
A1_cap
HQDP_holder
waste_bottle_1L
waste_airgap_head
FR1_filter_regulator
R2_precision_reg
air_pressure_switch
pogo_lift_valve
switch_valves_3x3-2
A1_manifold
purge_restrictor
FEZ_ch1_P_c
FEZ_ch2_P_mv_bottles
