mhdelano-ai/ELISA/cad/out/dock_lower/part_Md_umbrella.step

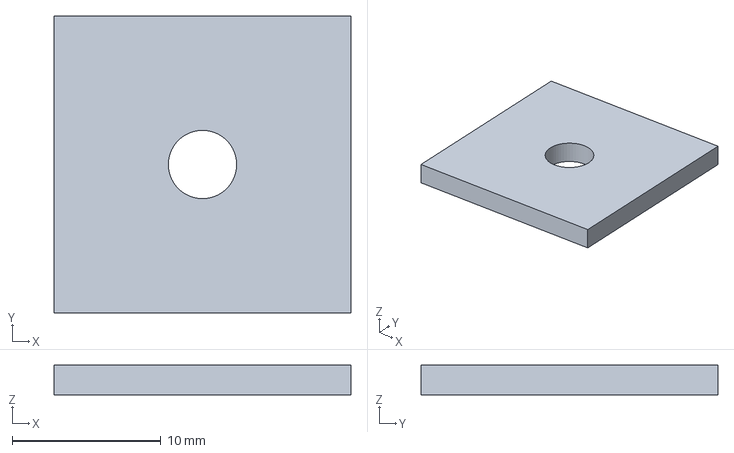
[picture p84: CAD file, 2026-11-13]
cad/out/dock_lower/part_Md_umbrella.step
20.0 x 20.0 x 2.00 mm
