mhdelano-ai/ELISA/cad/out/dock_upper/parts/gallery_header_right.step

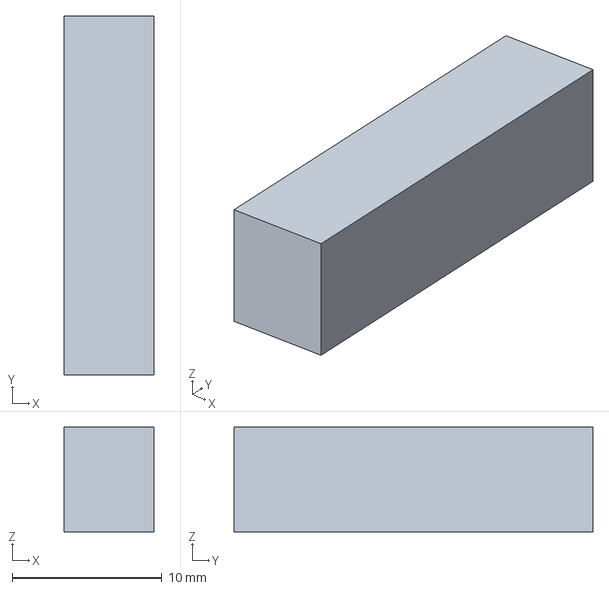
[picture p85: CAD file, 2026-11-13]
cad/out/dock_upper/parts/gallery_header_right.step
6.00 x 24.0 x 7.00 mm
