mhdelano-ai/ELISA/cad/out/card/cut_L2_TPE.dxf

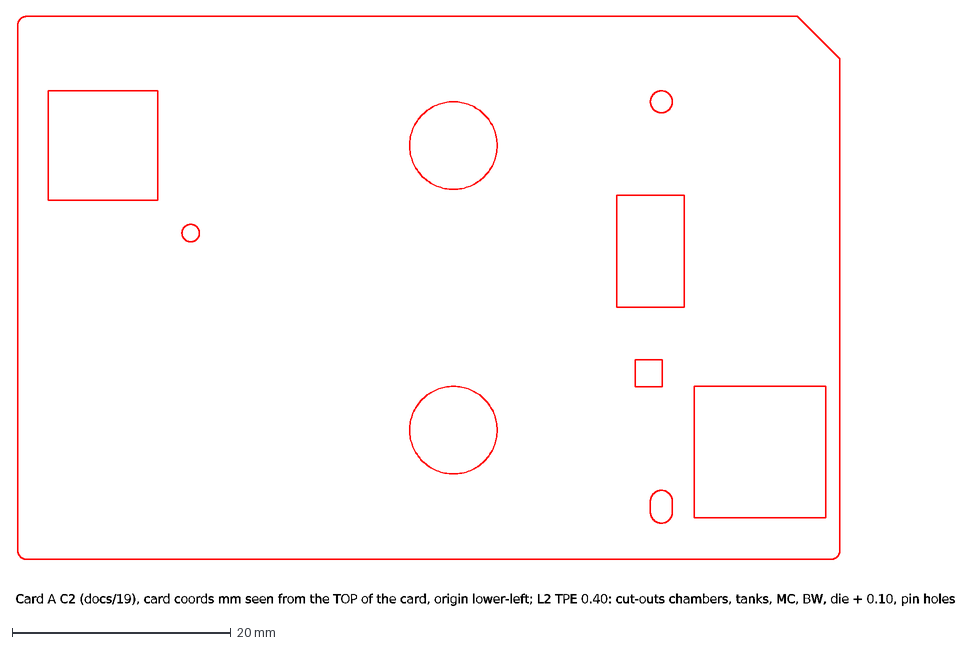
[picture p86: CAD file, 2026-11-13]
cad/out/card/cut_L2_TPE.dxf
Card A C2 (docs/19), card coords mm seen from the TOP of the card, origin lower-left; L2 TPE 0.40: cut-outs chambers, tanks, MC, BW, die + 0.10, pin holes
