mhdelano-ai/ELISA/cad/out/dock_base/base_brackets.step

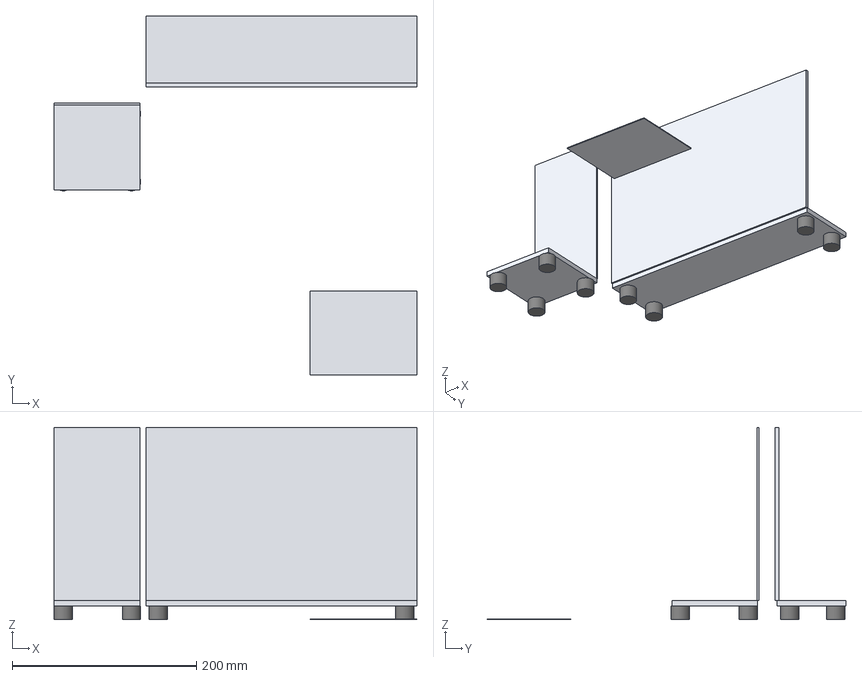
[picture p87: CAD file, 2026-11-13]
cad/out/dock_base/base_brackets.step
394.0 x 390.0 x 209.0 mm
pump_shelf
pump_back_plate
pump_isolator_1
pump_isolator_2
pump_isolator_3
pump_isolator_4
pump_shelf_front
pump_back_plate_front
pump_isolator_front_1
pump_isolator_front_2
pump_isolator_front_3
pump_isolator_front_4
bottle_rack
