mhdelano-ai/ELISA/cad/out/dock_lower/part_ebay_leak_electrode.step

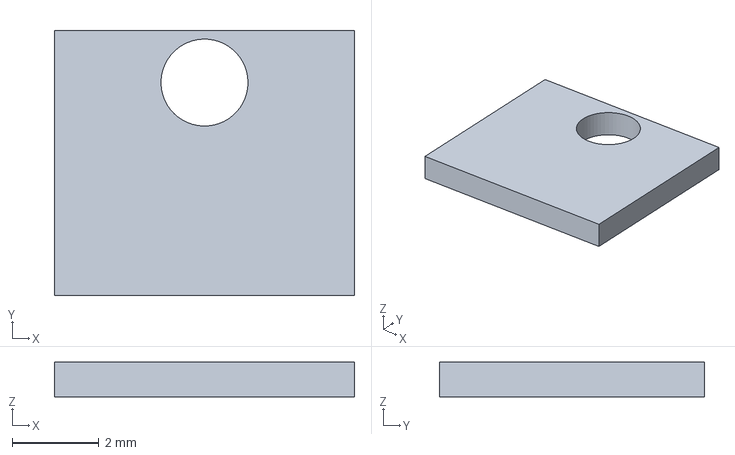
[picture p88: CAD file, 2026-11-13]
cad/out/dock_lower/part_ebay_leak_electrode.step
6.90 x 6.10 x 0.8 mm
