mhdelano-ai/ELISA/cad/out/dock_upper/parts/bridge_spacers.step

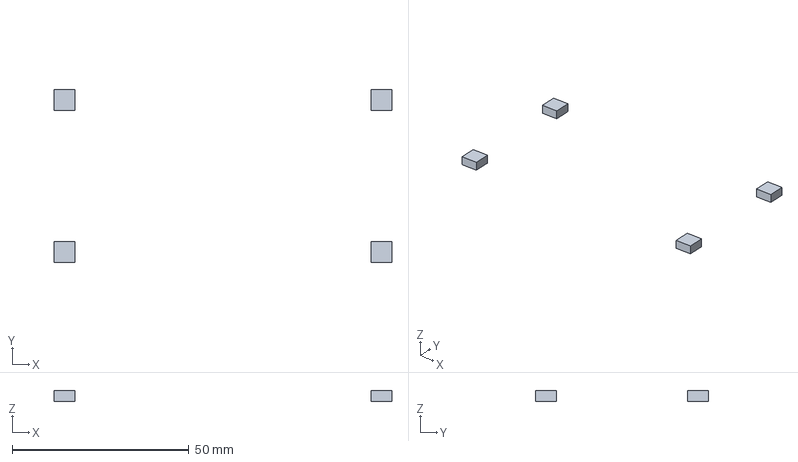
[picture p89: CAD file, 2026-11-13]
cad/out/dock_upper/parts/bridge_spacers.step
95.5 x 49.0 x 3.00 mm
