mhdelano-ai/ELISA/cad/out/card/cut_L1s_WE2_shim.dxf

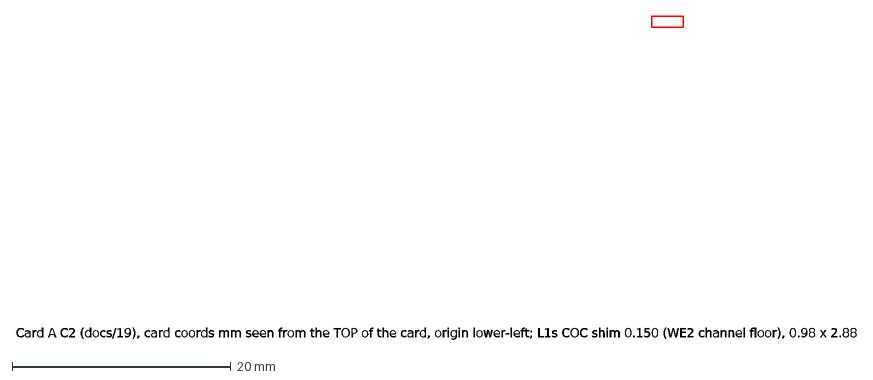
[picture p90: CAD file, 2026-11-13]
cad/out/card/cut_L1s_WE2_shim.dxf
Card A C2 (docs/19), card coords mm seen from the TOP of the card, origin lower-left; L1s COC shim 0.150 (WE2 channel floor), 0.98 x 2.88
