mhdelano-ai/ELISA/cad/out/dock_base/base_enclosure_panels.step

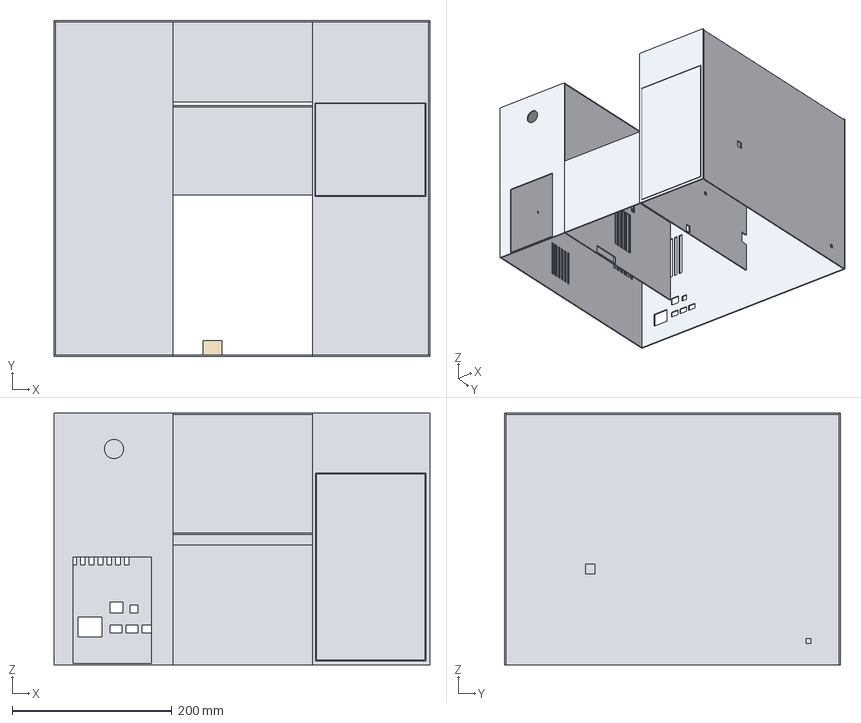
[picture p91: CAD file, 2026-11-13]
cad/out/dock_base/base_enclosure_panels.step
470.0 x 420.0 x 315.0 mm
partition_left
partition_right
rear_low_cover
well_rear_wall
panel_left
panel_right
panel_front_left
panel_front_bay
peltier_exhaust_ext
panel_front_right
panel_rear
panel_top_left
panel_top_right
panel_top_rear
