mhdelano-ai/ELISA/cad/out/dock_lower/part_retainer_island.step

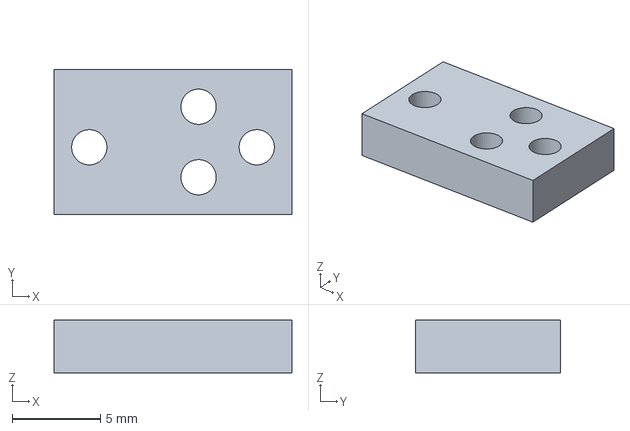
[picture p92: CAD file, 2026-11-13]
cad/out/dock_lower/part_retainer_island.step
13.5 x 8.20 x 3.00 mm
