mhdelano-ai/ELISA/cad/out/dock_upper/parts/V8_bush.step

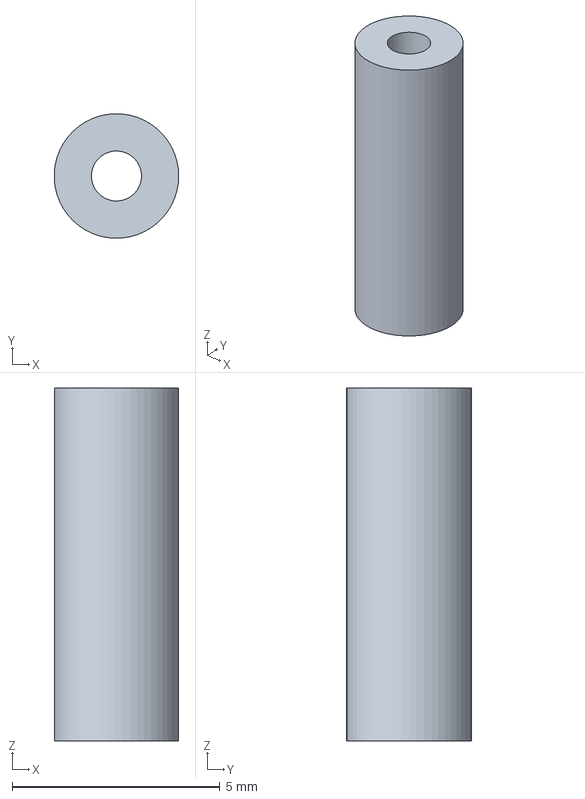
[picture p93: CAD file, 2026-11-13]
cad/out/dock_upper/parts/V8_bush.step
3.00 x 3.00 x 8.50 mm
