mhdelano-ai/ELISA/cad/out/card/cut_L0_foil.dxf

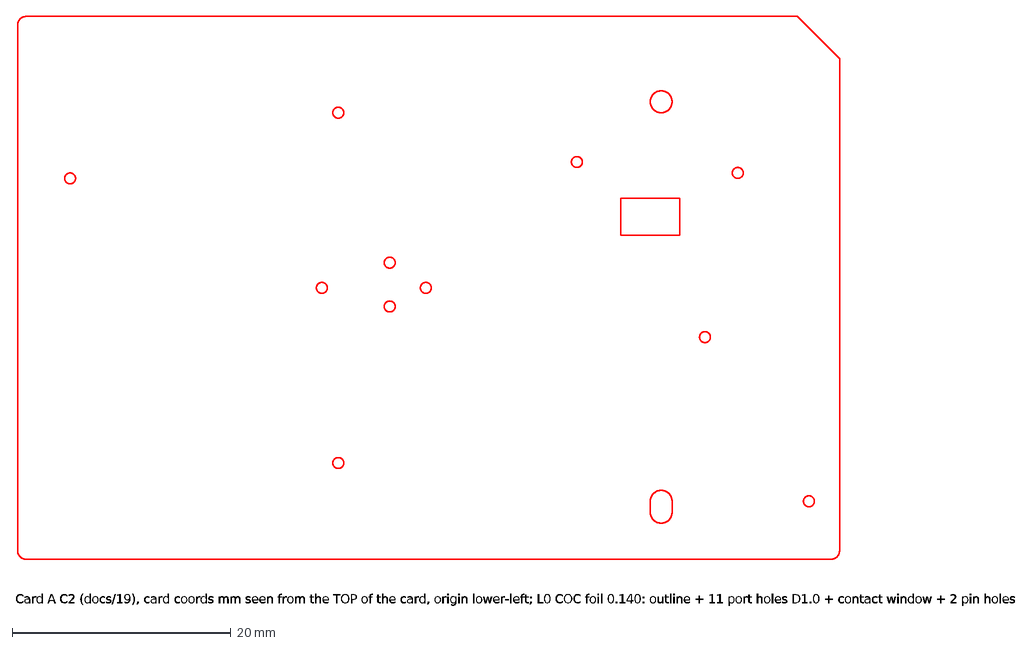
[picture p94: CAD file, 2026-11-13]
cad/out/card/cut_L0_foil.dxf
Card A C2 (docs/19), card coords mm seen from the TOP of the card, origin lower-left; L0 COC foil 0.140: outline + 11 port holes D1.0 + contact window + 2 pin h
