mhdelano-ai/ELISA/cad/out/dock_base/base_gamry_route_bench.step

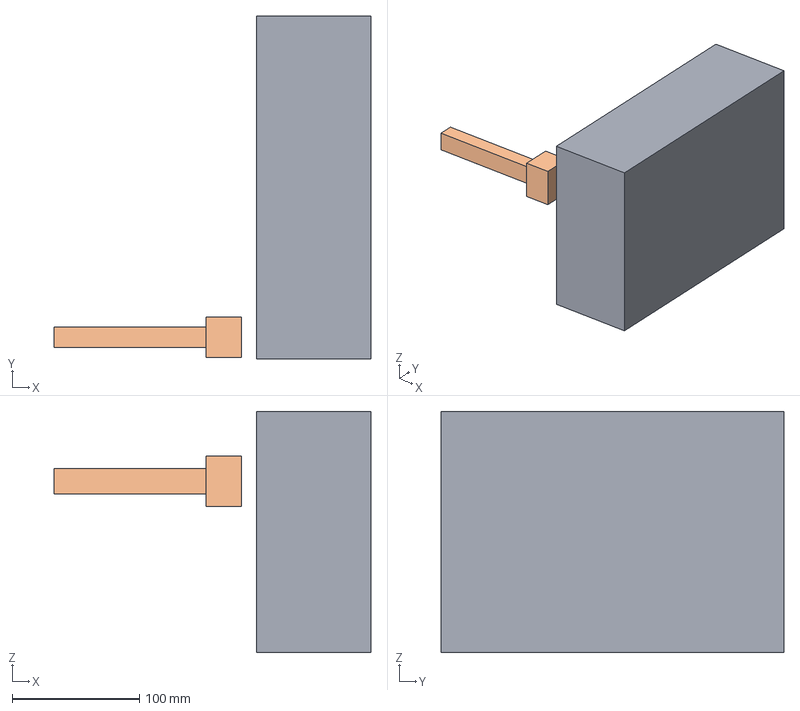
[picture p95: CAD file, 2026-11-13]
cad/out/dock_base/base_gamry_route_bench.step
249.5 x 270.0 x 190.0 mm
gamry_lead_duct
gamry_junction_box
Gamry_Ref600plus
