mhdelano-ai/ELISA/cad/out/dock_lower/part_pogo_block.step

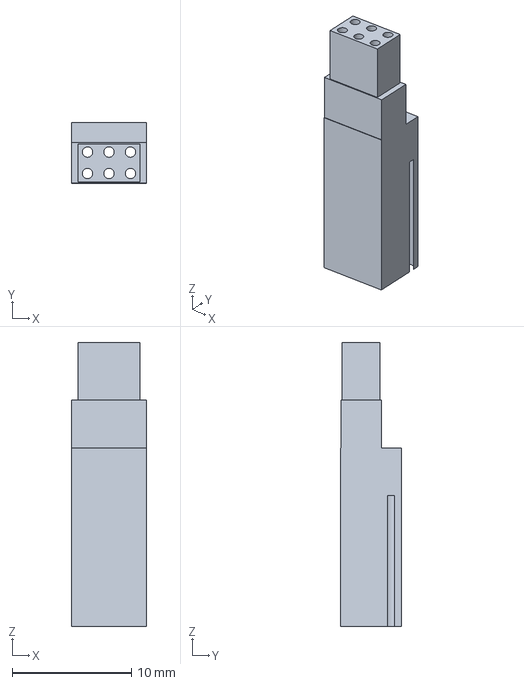
[picture p96: CAD file, 2026-11-13]
cad/out/dock_lower/part_pogo_block.step
6.30 x 5.15 x 23.8 mm
