mhdelano-ai/ELISA/cad/out/dock_upper/parts/piston_family.step

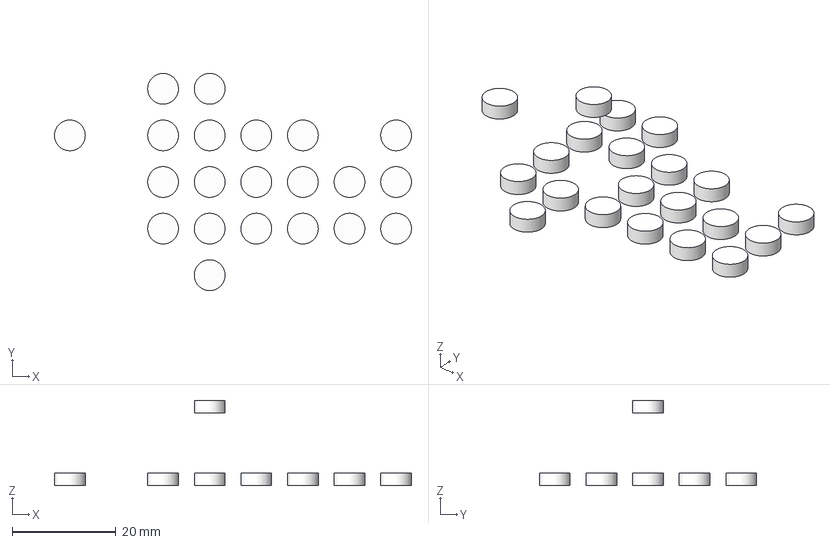
[picture p97: CAD file, 2026-11-13]
cad/out/dock_upper/parts/piston_family.step
68.9 x 41.9 x 16.5 mm
piston_V1
piston_V2
piston_V3
piston_V4
piston_V5
piston_V6
piston_V7
piston_V8
piston_V9
piston_V10
piston_V11
piston_V12
piston_V14
piston_V15
piston_V16
piston_V17
piston_V18
piston_G1
piston_G2
piston_G3
piston_G4
