mhdelano-ai/ELISA/cad/out/card/card_L3_body.step

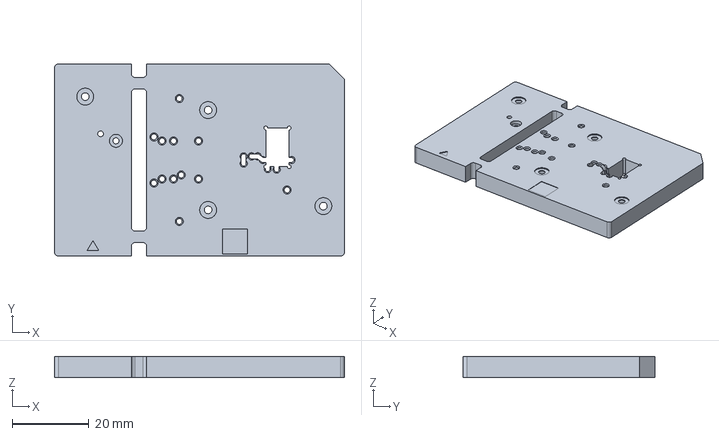
[picture p98: CAD file, 2026-11-13]
cad/out/card/card_L3_body.step
75.5 x 50.0 x 5.50 mm
