mhdelano-ai/ELISA/cad/out/dock_base/base_cold_compartment.step

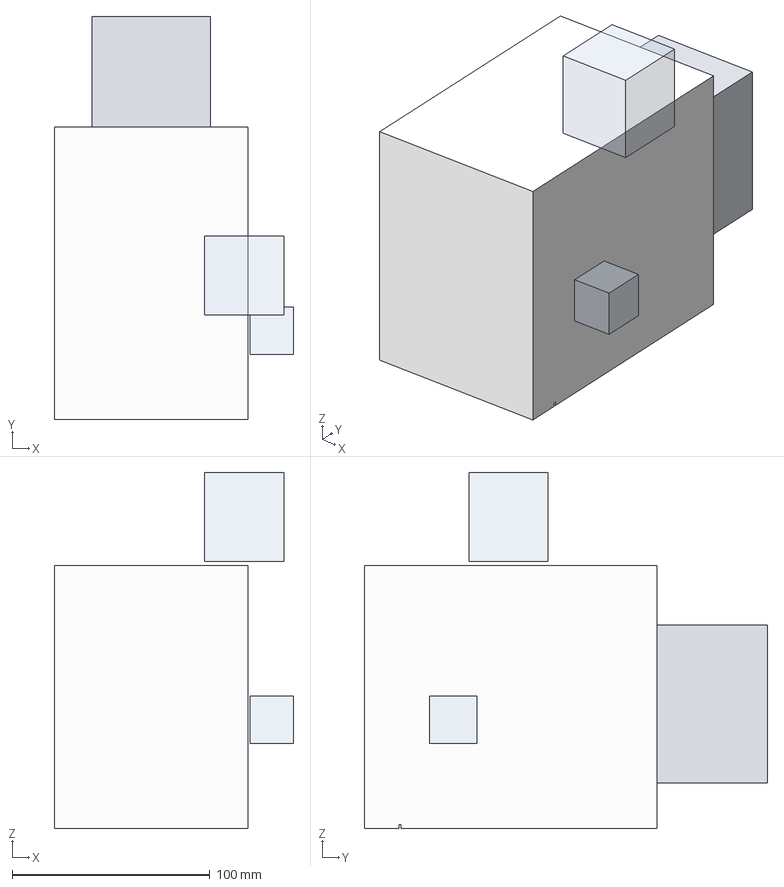
[picture p99: CAD file, 2026-11-13]
cad/out/dock_base/base_cold_compartment.step
121.0 x 204.0 x 180.0 mm
cold_box
cooler_DA024_warm
cooler_DA024_cold
cooler_spacer
bead_rocker_cradle
bead_vial_2mL
rocker_motor
conj_holder_block
conj_tube_2mL
SV_b_selection_valve
