mhdelano-ai/ELISA/cad/out/dock_lower/part_anvil.step

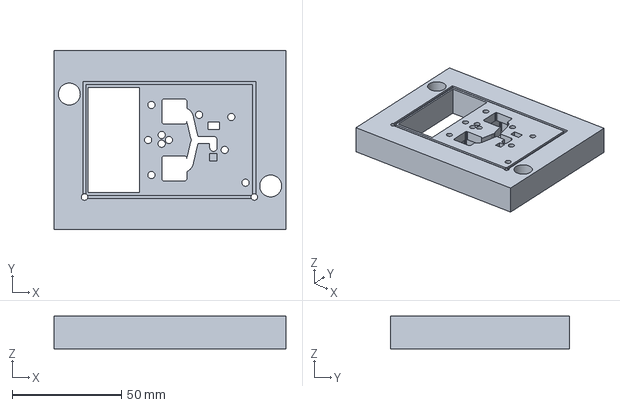
[picture p100: CAD file, 2026-11-13]
cad/out/dock_lower/part_anvil.step
106.0 x 82.0 x 15.0 mm
