mhdelano-ai/ELISA/cad/out/dock_upper/parts/cyl_block_family.step

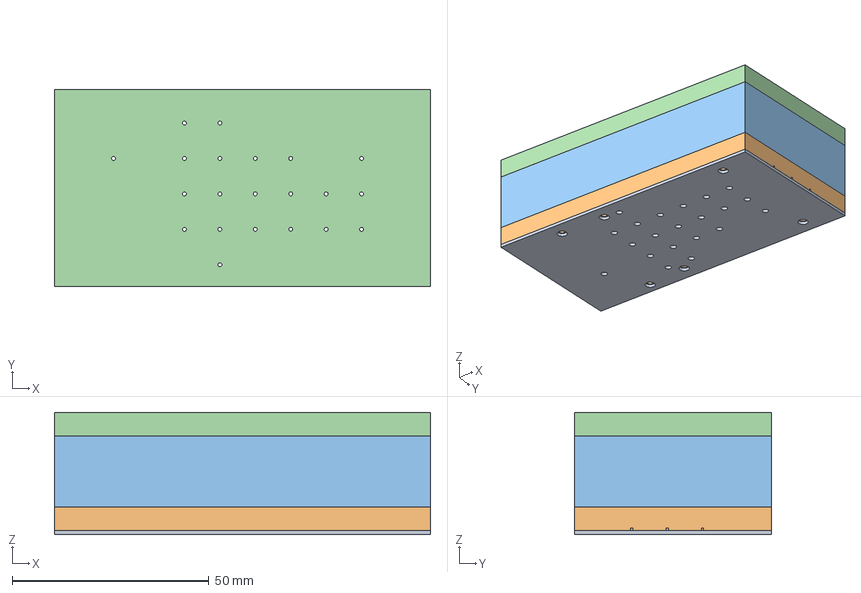
[picture p101: CAD file, 2026-11-13]
cad/out/dock_upper/parts/cyl_block_family.step
95.5 x 50.0 x 31.0 mm
cyl_block_cover
cyl_block_air_plate
cyl_block_bore_block
cyl_block_cap
