mhdelano-ai/ELISA/cad/out/card/card_L1b_die_film.step

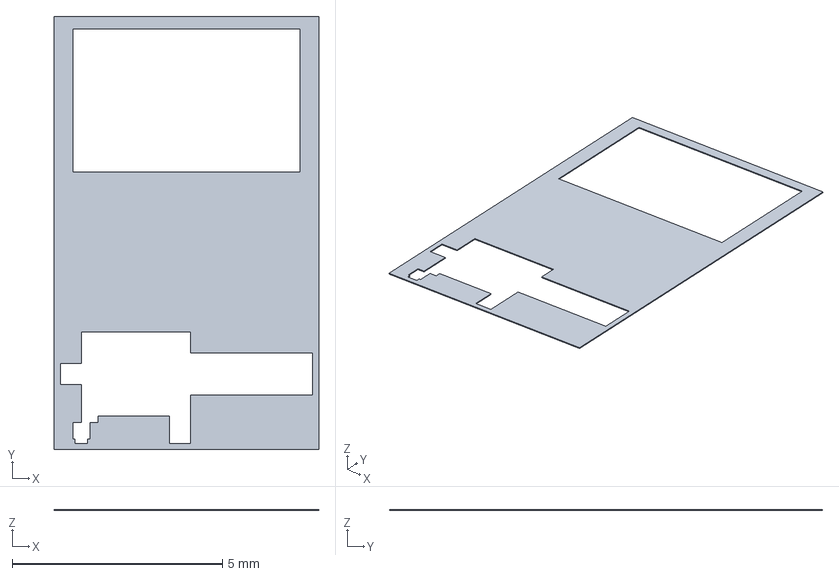
[picture p102: CAD file, 2026-11-13]
cad/out/card/card_L1b_die_film.step
6.30 x 10.3 x 0.025 mm
