mhdelano-ai/ELISA/cad/out/dock_base/base_drip_tray.step

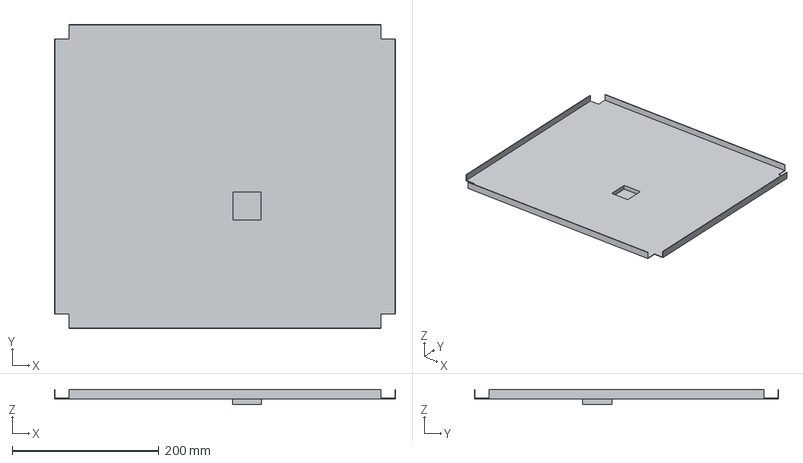
[picture p103: CAD file, 2026-11-13]
cad/out/dock_base/base_drip_tray.step
464.0 x 414.0 x 21.0 mm
