mhdelano-ai/ELISA/cad/out/dock_lower/part_latch_bracket.step

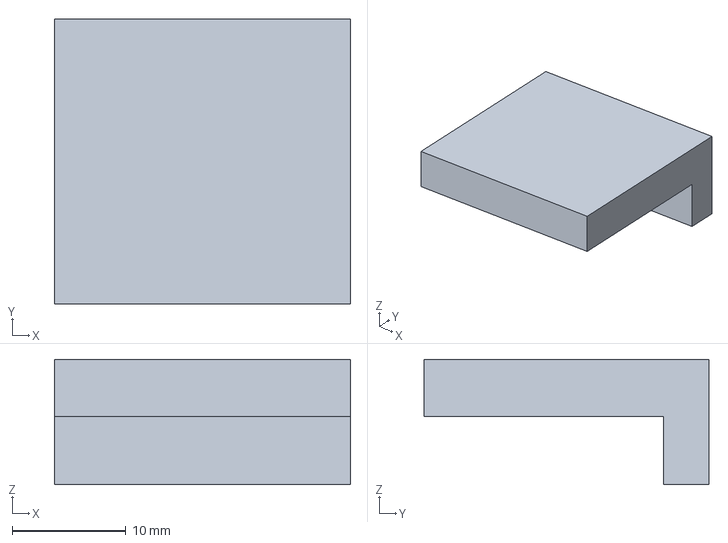
[picture p104: CAD file, 2026-11-13]
cad/out/dock_lower/part_latch_bracket.step
26.0 x 25.0 x 11.0 mm
