mhdelano-ai/ELISA/cad/out/dock_upper/parts/rod_family.step

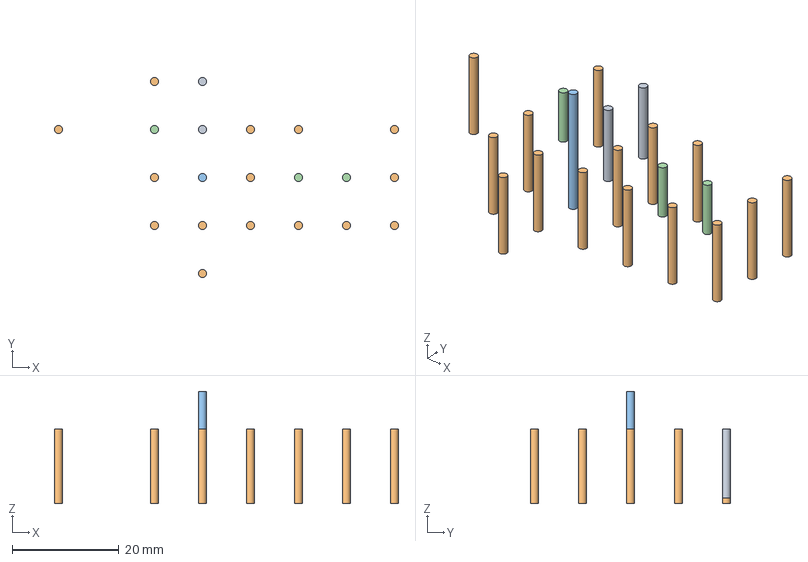
[picture p105: CAD file, 2026-11-13]
cad/out/dock_upper/parts/rod_family.step
64.5 x 37.5 x 21.0 mm
rod_V1
rod_V2
rod_V3
rod_V4
rod_V5
rod_V6
rod_V7
rod_V8
rod_V9
rod_V10
rod_V11
rod_V12
rod_V14
rod_V15
rod_V16
rod_V17
rod_V18
rod_G1
rod_G2
rod_G3
rod_G4
