mhdelano-ai/ELISA/cad/out/card/card_die.step

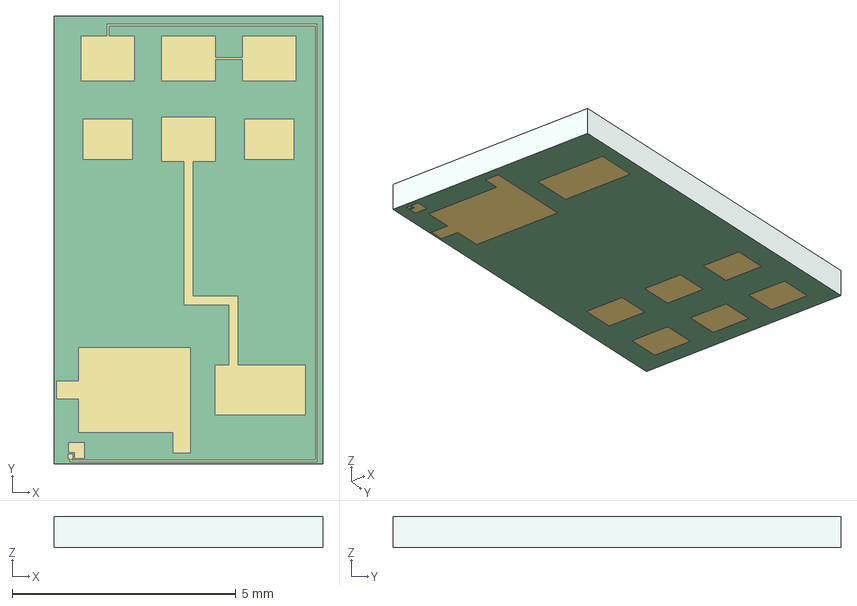
[picture p106: CAD file, 2026-11-13]
cad/out/card/card_die.step
6.00 x 10.0 x 0.701 mm
die_glass
die_metal
die_passivation
