mhdelano-ai/ELISA/cad/out/dock_lower/part_guide_bush.step

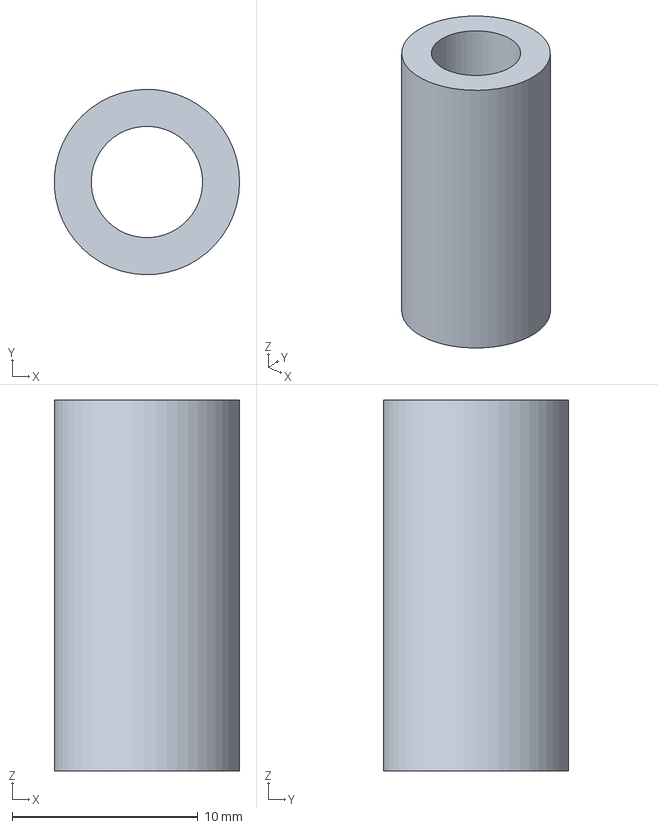
[picture p107: CAD file, 2026-11-13]
cad/out/dock_lower/part_guide_bush.step
9.98 x 9.99 x 20.0 mm
