mhdelano-ai/ELISA/cad/out/dock_upper/parts/lid_front_beam.step

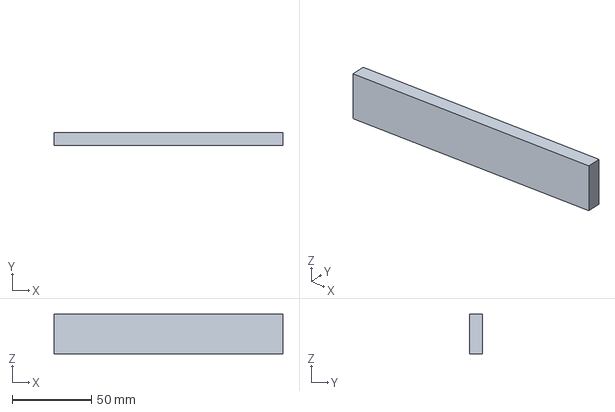
[picture p108: CAD file, 2026-11-13]
cad/out/dock_upper/parts/lid_front_beam.step
144.5 x 8.00 x 25.0 mm
