mhdelano-ai/ELISA/cad/out/card/card_L4_discs.step

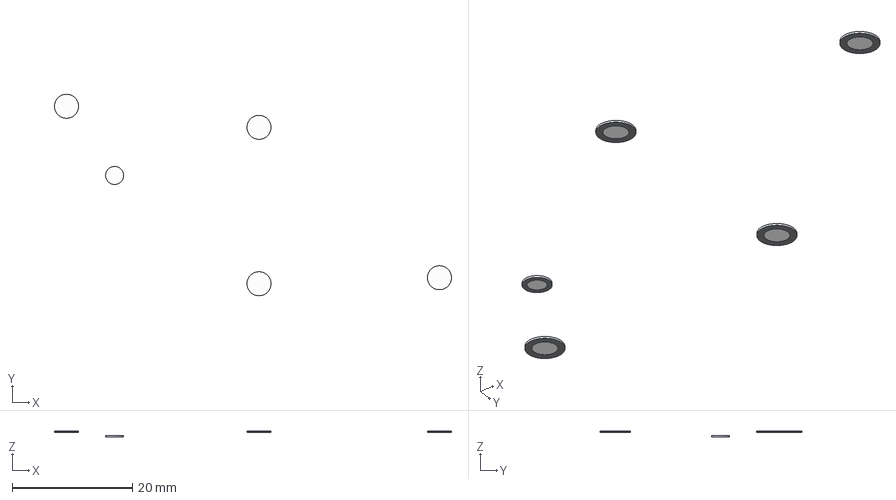
[picture p109: CAD file, 2026-11-13]
cad/out/card/card_L4_discs.step
66.0 x 33.5 x 1.02 mm
L4_vent_IC1_adh
L4_vent_IC1
L4_vent_IC2_adh
L4_vent_IC2
L4_vent_RS_adh
L4_vent_RS
L4_vent_P_c_adh
L4_vent_P_c
L4_MC_stop_adh
L4_MC_stop
