mhdelano-ai/ELISA/cad/out/dock_lower/part_Mc1_holder.step

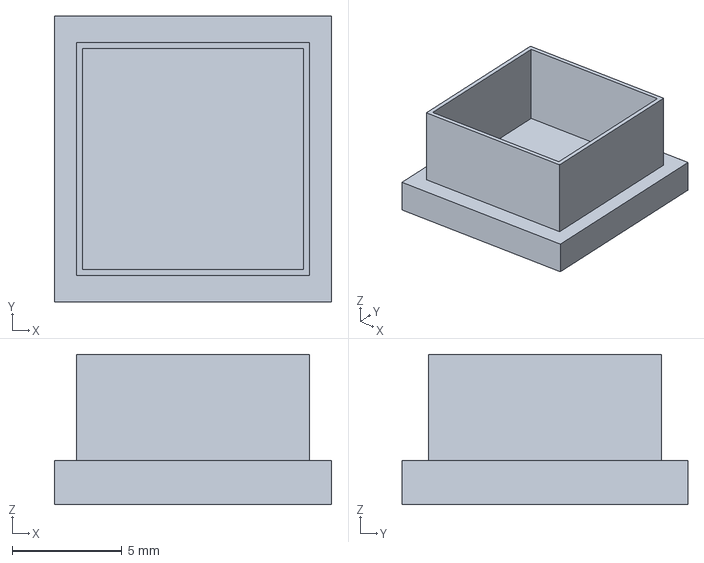
[picture p110: CAD file, 2026-11-13]
cad/out/dock_lower/part_Mc1_holder.step
12.6 x 13.0 x 6.84 mm
