mhdelano-ai/ELISA/cad/out/dock_upper/parts/lid_side_plate_family.step

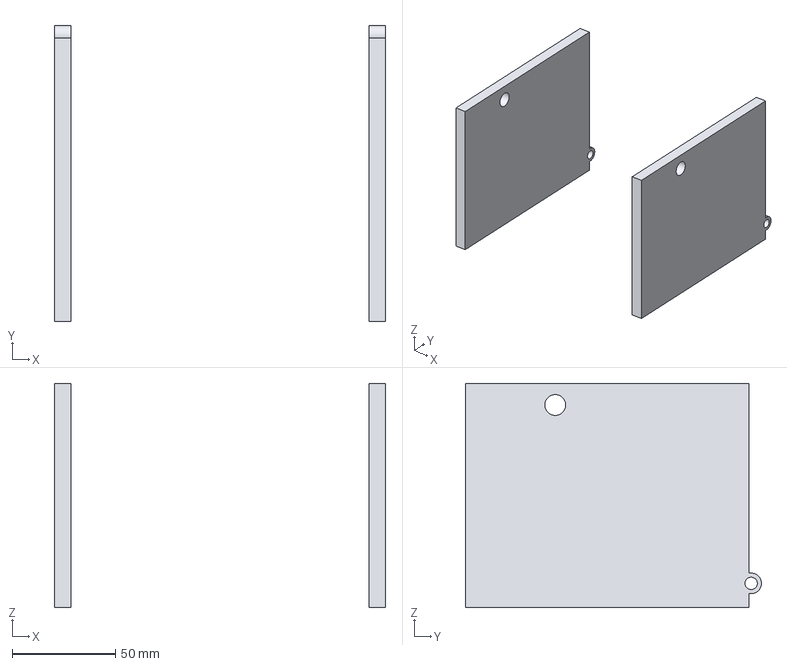
[picture p111: CAD file, 2026-11-13]
cad/out/dock_upper/parts/lid_side_plate_family.step
160.5 x 143.5 x 108.8 mm
lid_side_plate_L
lid_side_plate_R
