mhdelano-ai/ELISA/cad/out/card/cut_L1_channel_sheet.dxf

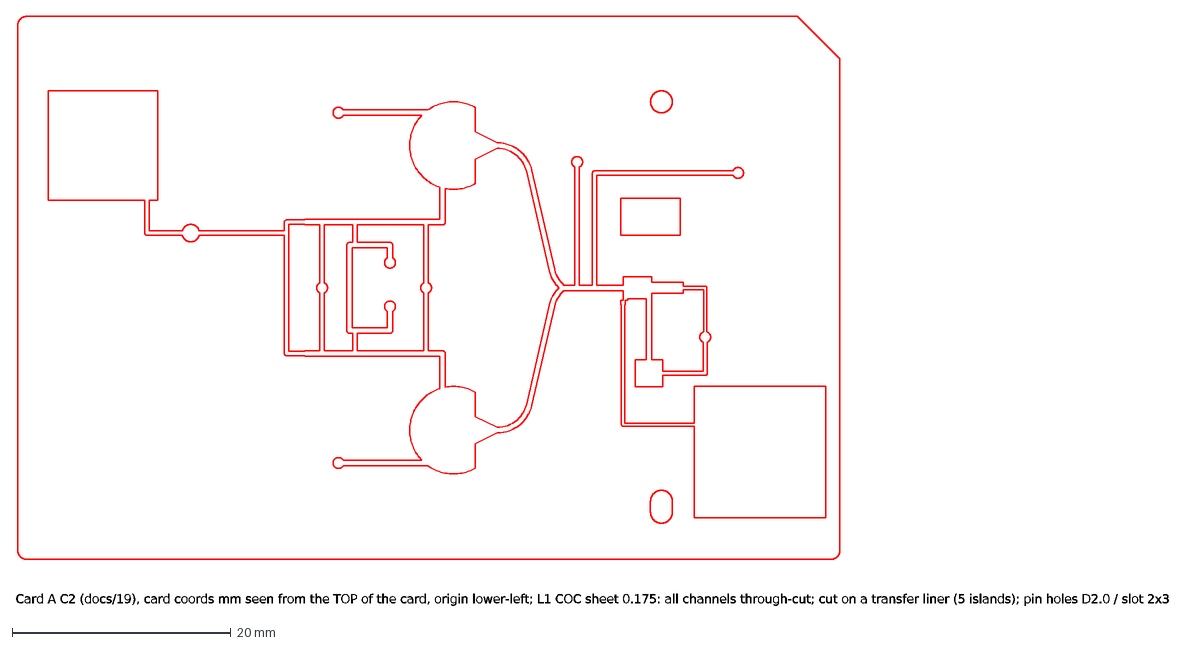
[picture p112: CAD file, 2026-11-13]
cad/out/card/cut_L1_channel_sheet.dxf
Card A C2 (docs/19), card coords mm seen from the TOP of the card, origin lower-left; L1 COC sheet 0.175: all channels through-cut; cut on a transfer liner (5 i
