mhdelano-ai/ELISA/cad/out/dock_lower/part_peek_break_frame.step

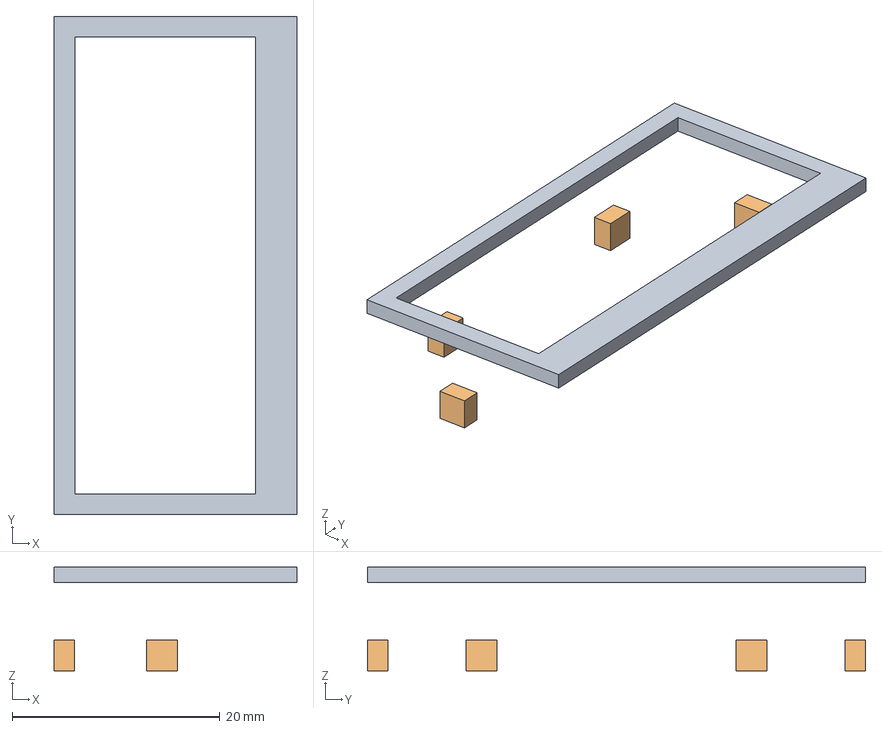
[picture p113: CAD file, 2026-11-13]
cad/out/dock_lower/part_peek_break_frame.step
23.4 x 48.0 x 10.0 mm
