mhdelano-ai/ELISA/cad/out/dock_upper/parts/umbilical_clamp.step

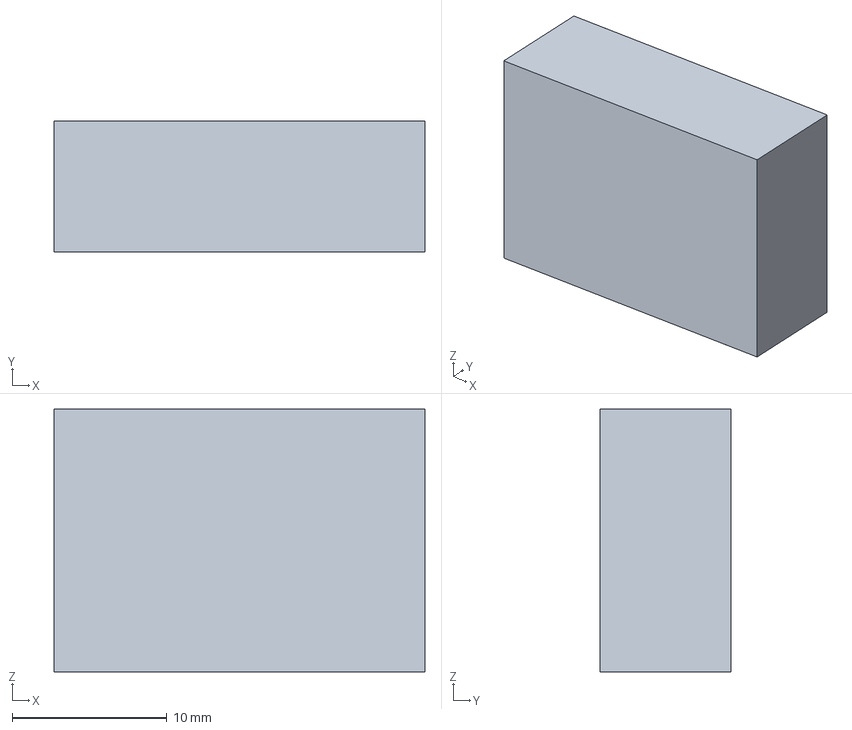
[picture p114: CAD file, 2026-11-13]
cad/out/dock_upper/parts/umbilical_clamp.step
24.0 x 8.50 x 17.0 mm
