mhdelano-ai/ELISA/cad/out/card/card_L2_TPE.step

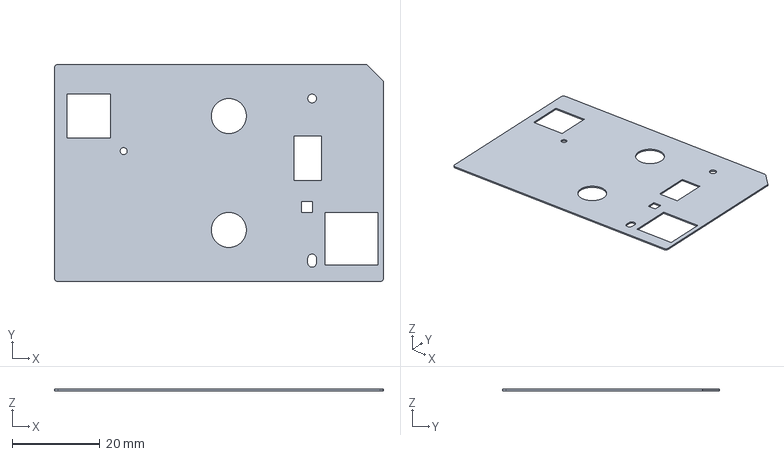
[picture p115: CAD file, 2026-11-13]
cad/out/card/card_L2_TPE.step
75.1 x 49.6 x 0.4 mm
