mhdelano-ai/ELISA/cad/out/dock_lower/part_Md_adapter.step

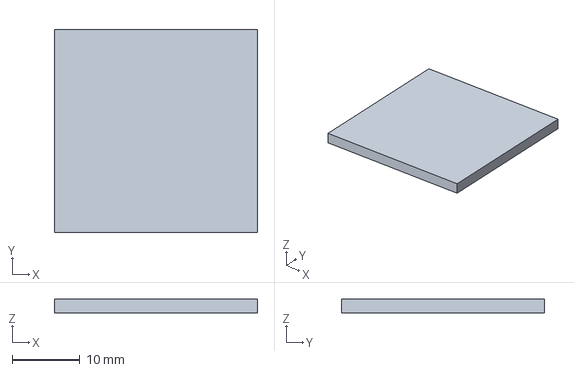
[picture p116: CAD file, 2026-11-13]
cad/out/dock_lower/part_Md_adapter.step
30.0 x 30.0 x 2.00 mm
