mhdelano-ai/ELISA/cad/out/dock_upper/parts/lid_handle.step

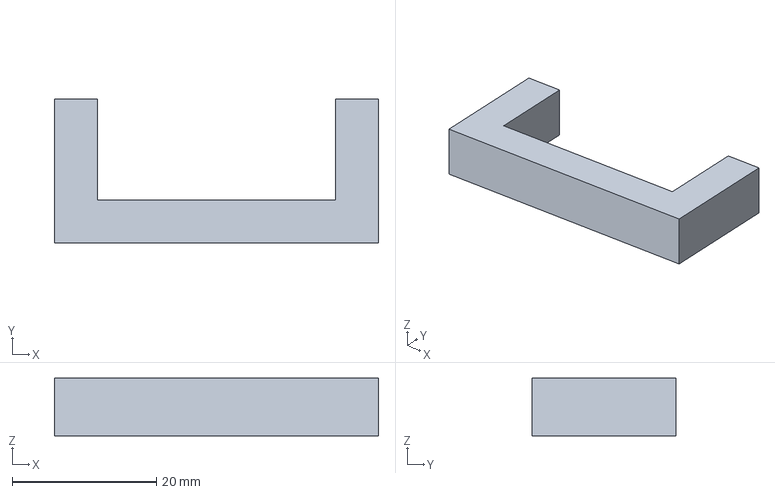
[picture p117: CAD file, 2026-11-13]
cad/out/dock_upper/parts/lid_handle.step
45.0 x 20.0 x 8.00 mm
