mhdelano-ai/ELISA/cad/out/card/card_seam_adhesive.step

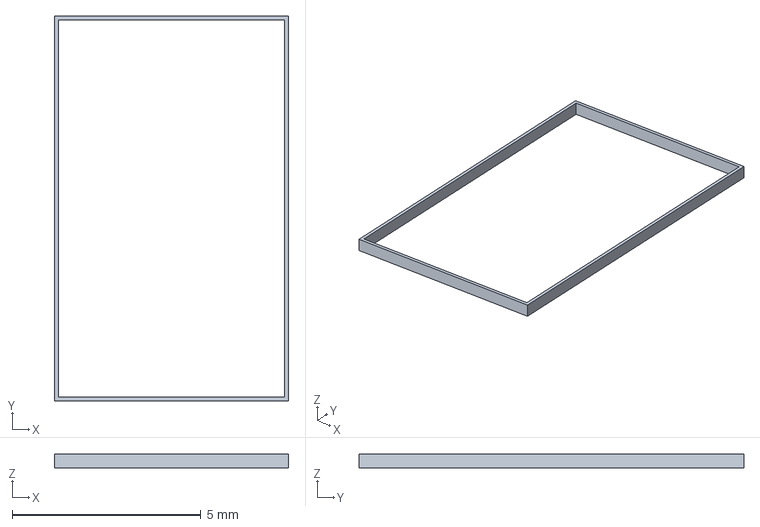
[picture p118: CAD file, 2026-11-13]
cad/out/card/card_seam_adhesive.step
6.20 x 10.2 x 0.375 mm
