mhdelano-ai/ELISA/cad/out/dock_lower/part_Mc1_link_lower.step

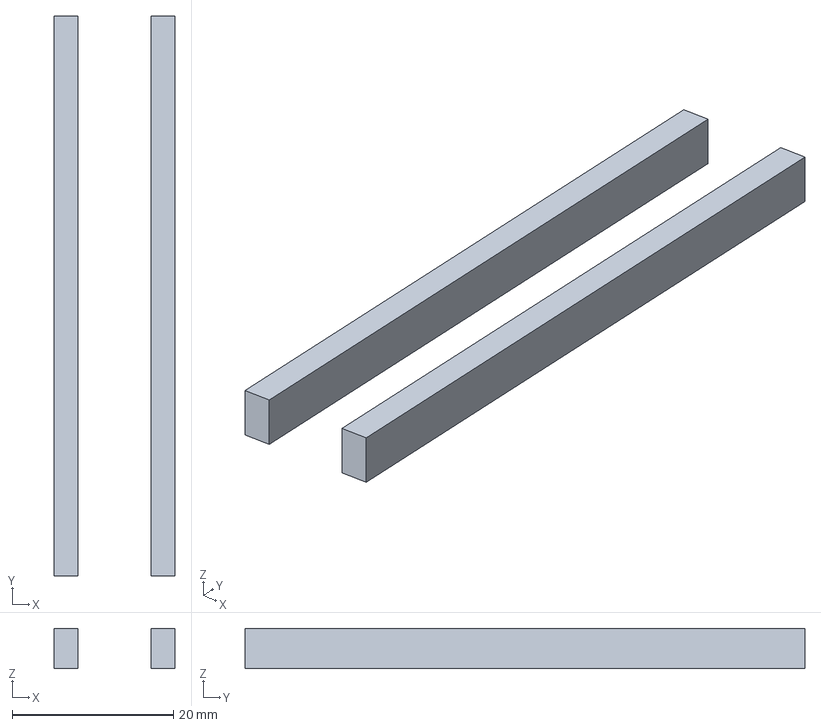
[picture p119: CAD file, 2026-11-13]
cad/out/dock_lower/part_Mc1_link_lower.step
15.0 x 69.5 x 5.00 mm
