mhdelano-ai/ELISA/cad/out/dock_upper/parts/heater_block.step

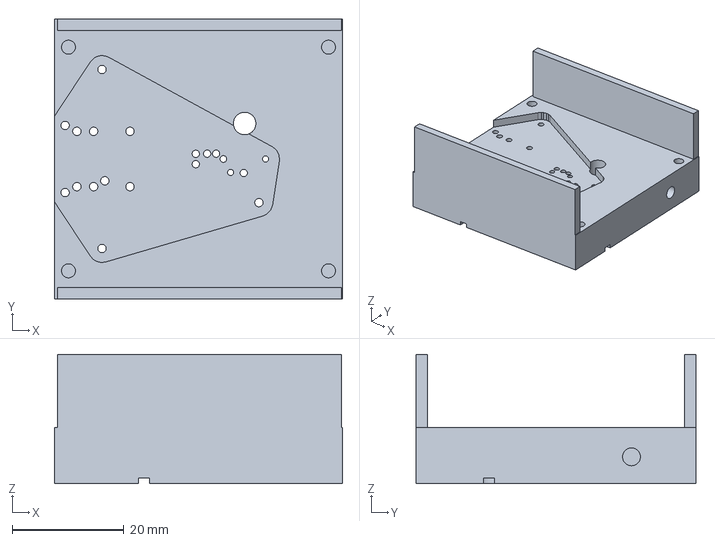
[picture p120: CAD file, 2026-11-13]
cad/out/dock_upper/parts/heater_block.step
51.5 x 50.0 x 23.1 mm
