mhdelano-ai/ELISA/cad/out/dock_lower/part_bay_frame.step

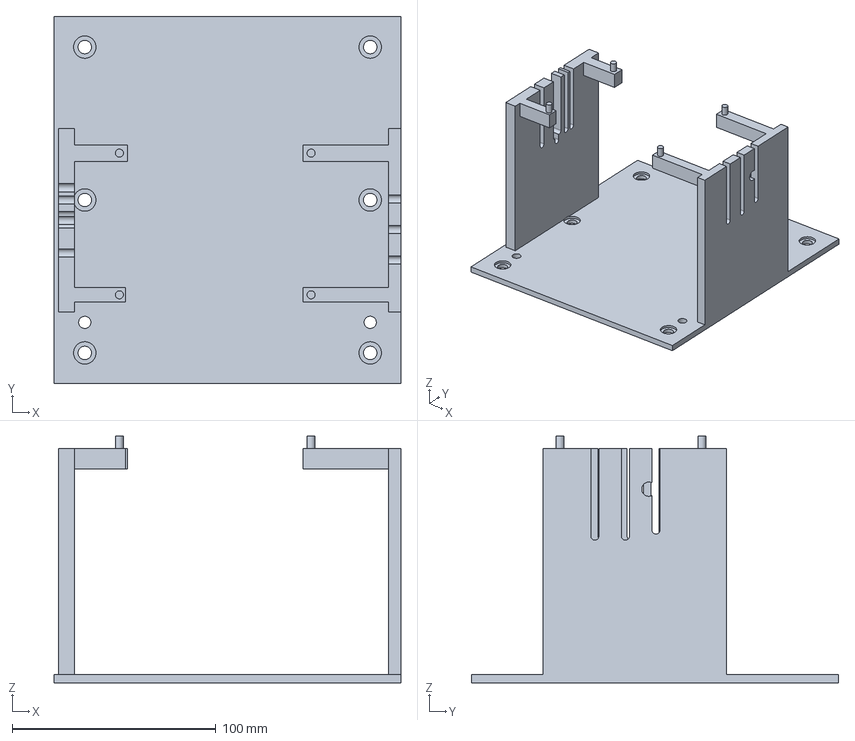
[picture p121: CAD file, 2026-11-13]
cad/out/dock_lower/part_bay_frame.step
170.0 x 180.0 x 121.0 mm
