mhdelano-ai/ELISA/cad/out/dock_upper/parts/hinge_block_family.step

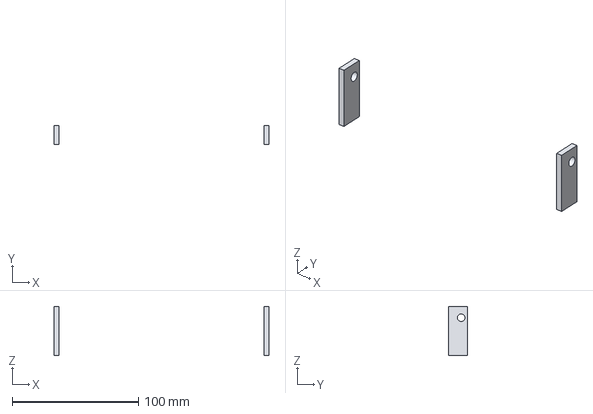
[picture p122: CAD file, 2026-11-13]
cad/out/dock_upper/parts/hinge_block_family.step
170.0 x 15.0 x 39.0 mm
hinge_block_L
hinge_block_R
