mhdelano-ai/ELISA/cad/out/dock_lower/part_pogo_wedge.step

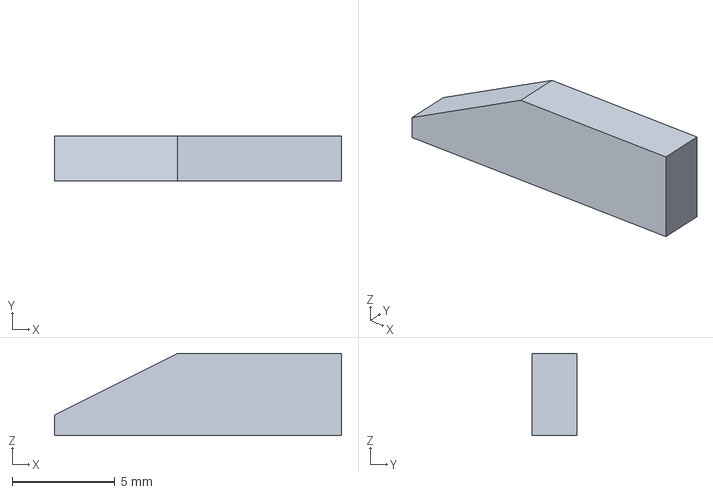
[picture p123: CAD file, 2026-11-13]
cad/out/dock_lower/part_pogo_wedge.step
14.0 x 2.20 x 4.00 mm
