mhdelano-ai/ELISA/cad/out/dock_upper/parts/standoff_family.step

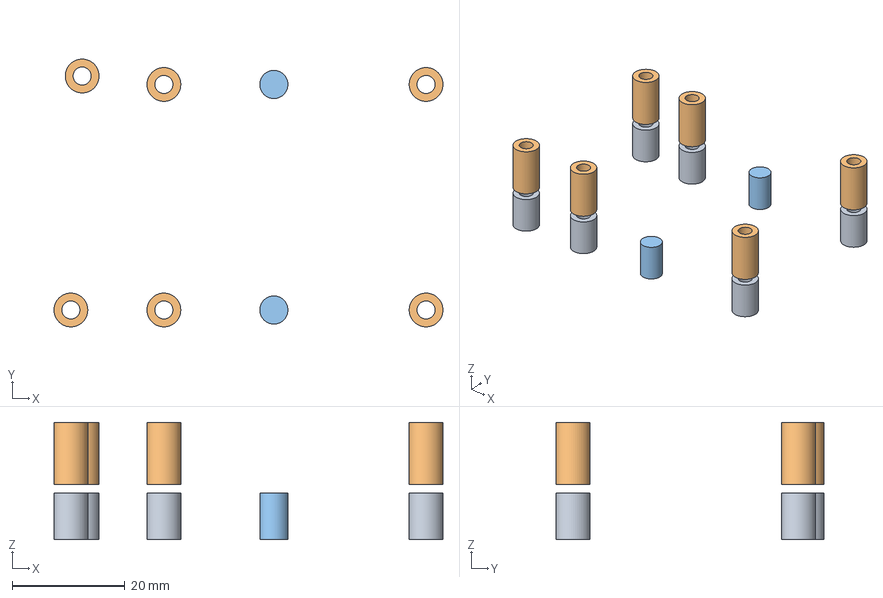
[picture p124: CAD file, 2026-11-13]
cad/out/dock_upper/parts/standoff_family.step
69.0 x 47.5 x 20.8 mm
standoff_00
standoff_01
standoff_02
standoff_03
standoff_04
standoff_05
standoff_06
standoff_07
standoff_08
standoff_09
standoff_10
standoff_11
standoff_12
standoff_13
