mhdelano-ai/ELISA/cad/out/dock_lower/part_nest_frame.step

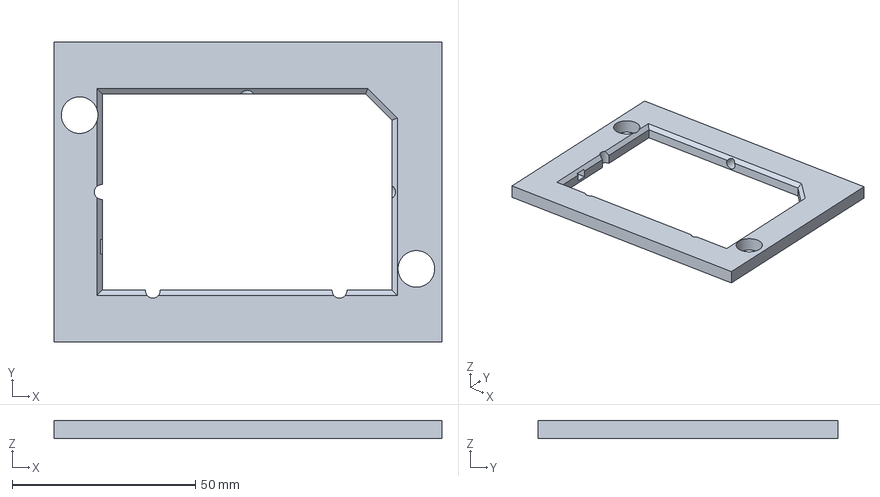
[picture p125: CAD file, 2026-11-13]
cad/out/dock_lower/part_nest_frame.step
106.0 x 82.0 x 5.00 mm
