mhdelano-ai/ELISA/cad/out/dock_upper/parts/cam_lever.step

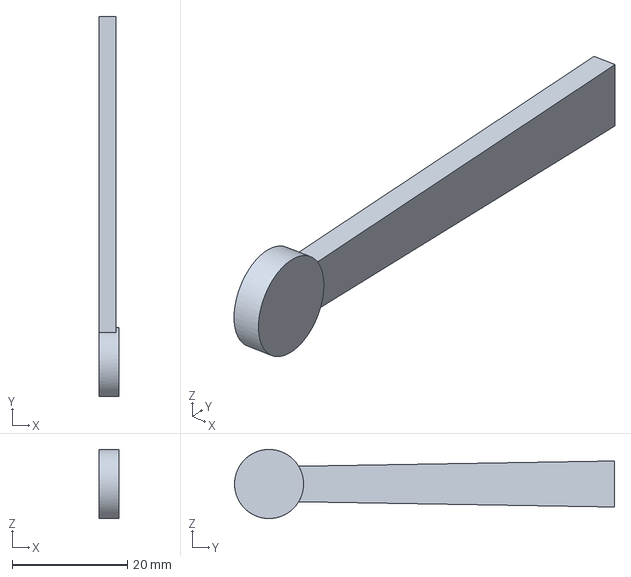
[picture p126: CAD file, 2026-11-13]
cad/out/dock_upper/parts/cam_lever.step
3.50 x 66.0 x 12.0 mm
