mhdelano-ai/ELISA/cad/out/dock_lower/part_port_insert_P_cf.step

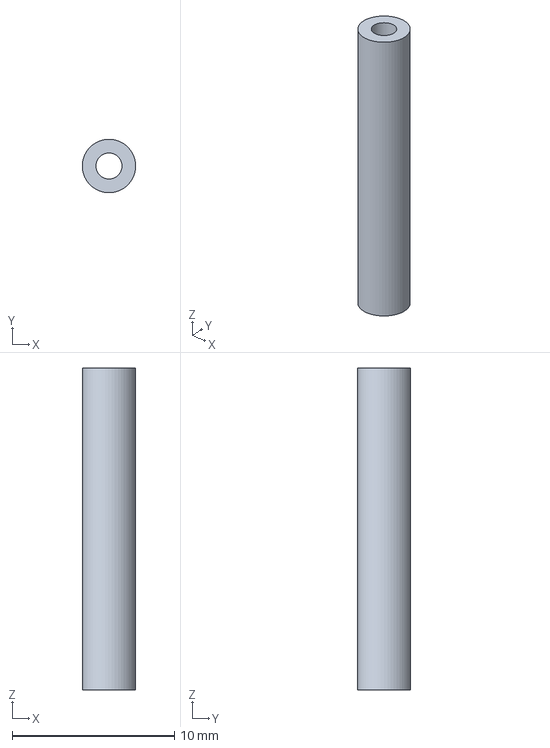
[picture p127: CAD file, 2026-11-13]
cad/out/dock_lower/part_port_insert_P_cf.step
3.29 x 3.29 x 19.8 mm
