mhdelano-ai/ELISA/cad/out/dock_upper/parts/spring_plate.step

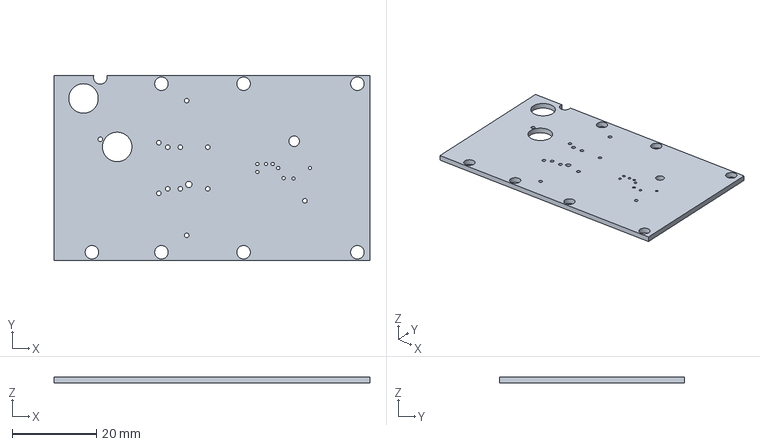
[picture p128: CAD file, 2026-11-13]
cad/out/dock_upper/parts/spring_plate.step
75.0 x 44.0 x 1.50 mm
