mhdelano-ai/ELISA/cad/out/dock_lower/part_cold_block.step

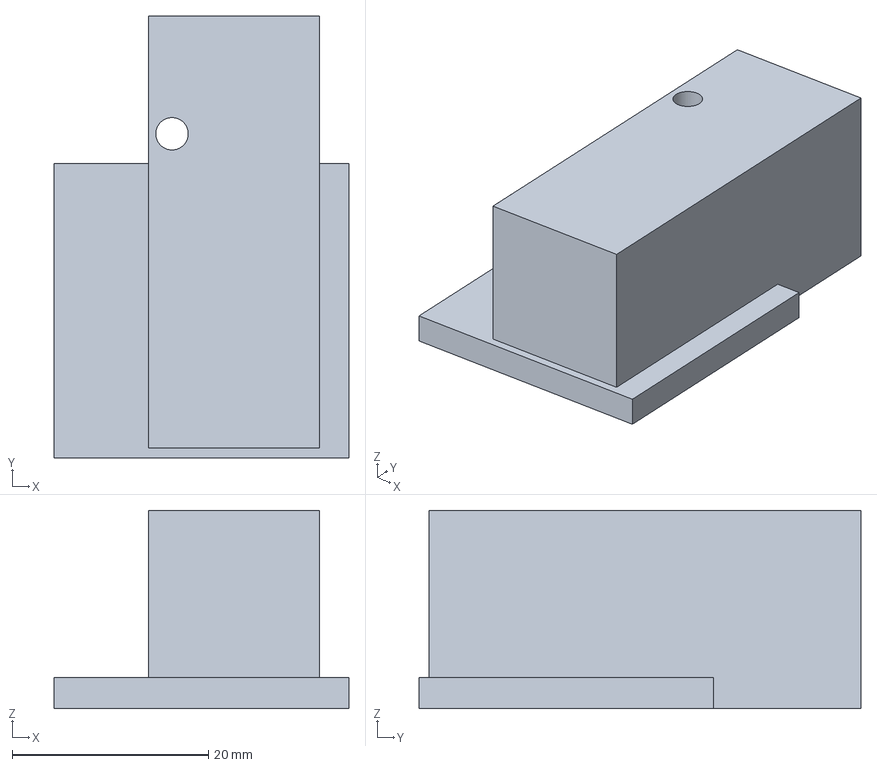
[picture p129: CAD file, 2026-11-13]
cad/out/dock_lower/part_cold_block.step
30.0 x 45.0 x 20.2 mm
