mhdelano-ai/ELISA/cad/out/dock_upper/parts/cover.step

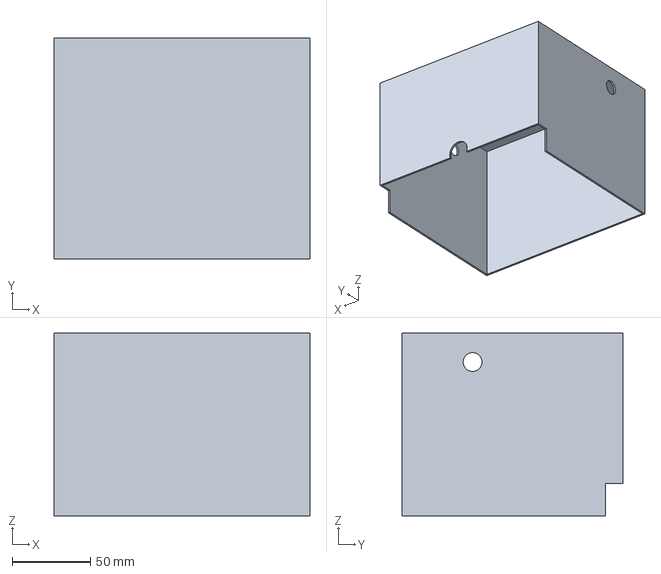
[picture p130: CAD file, 2026-11-13]
cad/out/dock_upper/parts/cover.step
163.5 x 141.0 x 116.8 mm
