mhdelano-ai/ELISA/cad/out/dock_lower/part_Md_holder.step

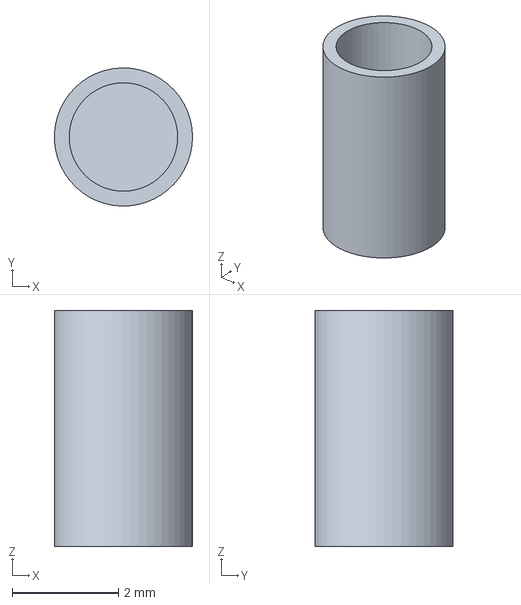
[picture p131: CAD file, 2026-11-13]
cad/out/dock_lower/part_Md_holder.step
2.60 x 2.60 x 4.44 mm
