mhdelano-ai/ELISA/cad/out/dock_upper/parts/cam_shaft.step

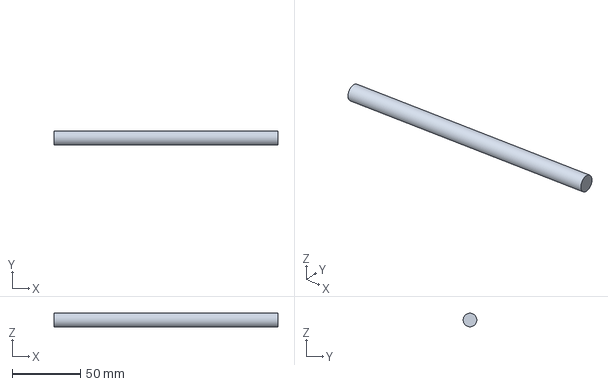
[picture p132: CAD file, 2026-11-13]
cad/out/dock_upper/parts/cam_shaft.step
164.0 x 9.99 x 10.00 mm
