mhdelano-ai/ELISA/cad/out/dock_lower/part_foam_insulation.step

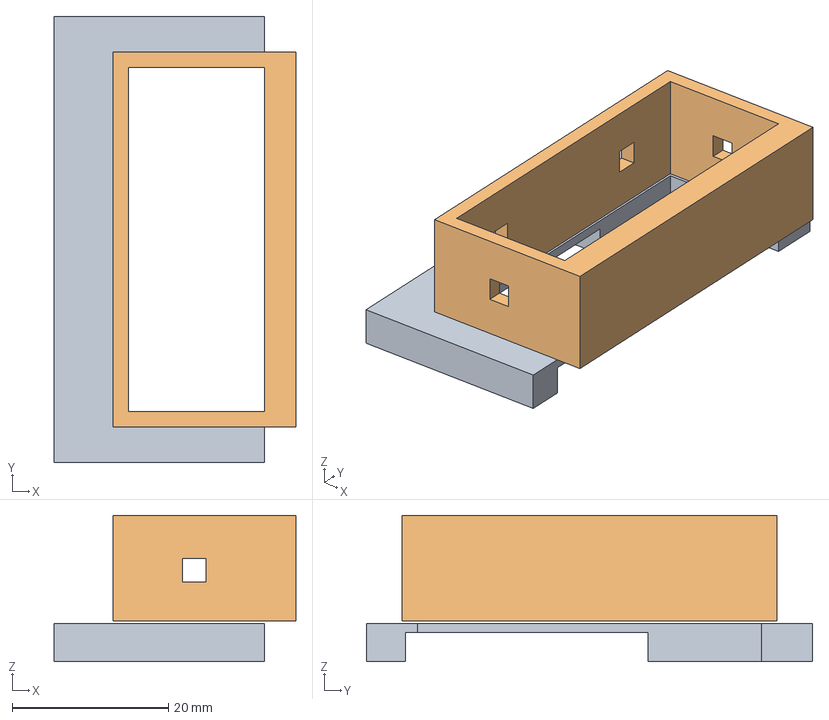
[picture p133: CAD file, 2026-11-13]
cad/out/dock_lower/part_foam_insulation.step
30.9 x 57.0 x 18.7 mm
