mhdelano-ai/ELISA/cad/out/dock_upper/parts/yoke_family.step

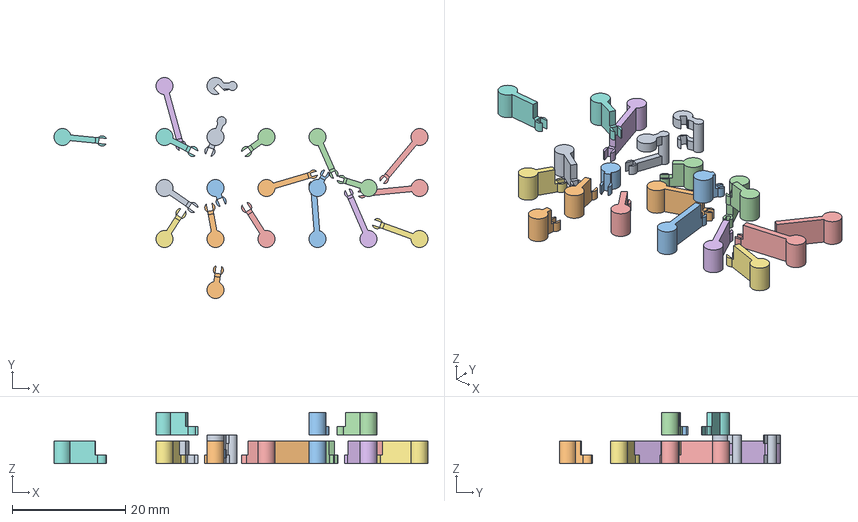
[picture p134: CAD file, 2026-11-13]
cad/out/dock_upper/parts/yoke_family.step
66.0 x 39.0 x 9.00 mm
yoke_V1
yoke_V2
yoke_V3
yoke_V4
yoke_V5
yoke_V6
yoke_V7
yoke_V8
yoke_V9
yoke_V10
yoke_V11
yoke_V12
yoke_V14
yoke_V15
yoke_V16
yoke_V17
yoke_V18
yoke_G1
yoke_G2
yoke_G3
yoke_G4
