mhdelano-ai/ELISA/cad/out/dock_upper/parts/gallery_header_rear.step

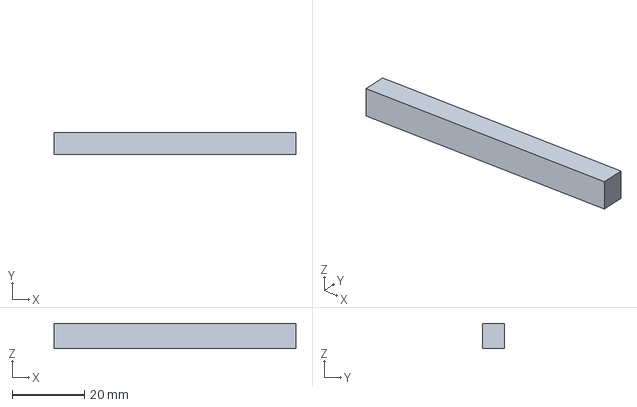
[picture p135: CAD file, 2026-11-13]
cad/out/dock_upper/parts/gallery_header_rear.step
67.1 x 6.00 x 7.00 mm
