mhdelano-ai/ELISA/cad/out/dock_lower/part_Md_Zunit.step

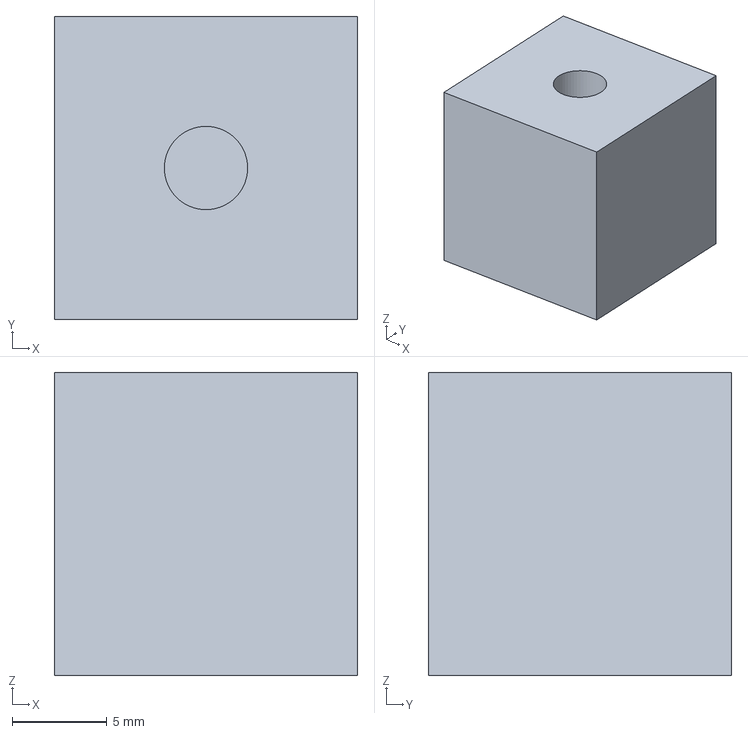
[picture p136: CAD file, 2026-11-13]
cad/out/dock_lower/part_Md_Zunit.step
16.0 x 16.0 x 16.0 mm
