mhdelano-ai/ELISA/cad/out/dock_upper/parts/press_pad_silicone.step

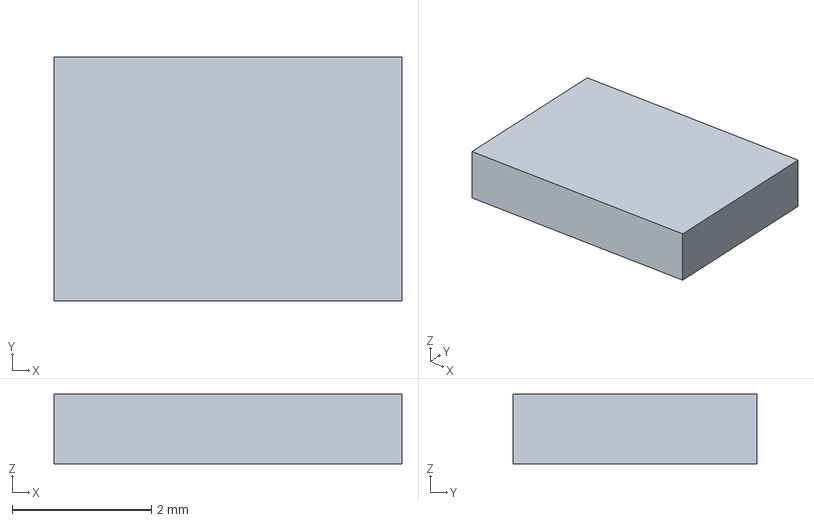
[picture p137: CAD file, 2026-11-13]
cad/out/dock_upper/parts/press_pad_silicone.step
5.00 x 3.50 x 1.00 mm
