mhdelano-ai/ELISA/cad/out/dock_lower/part_port_insert_P_in.step

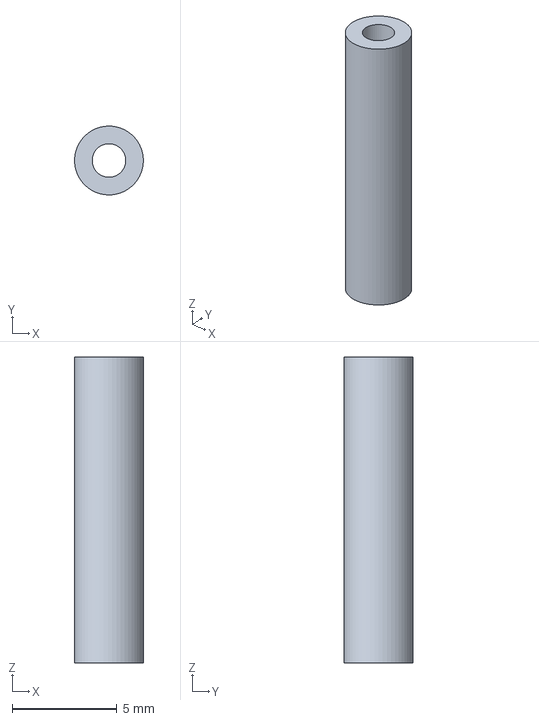
[picture p138: CAD file, 2026-11-13]
cad/out/dock_lower/part_port_insert_P_in.step
3.29 x 3.29 x 14.6 mm
