mhdelano-ai/ELISA/cad/out/dock_upper/parts/lid_rear_beam.step

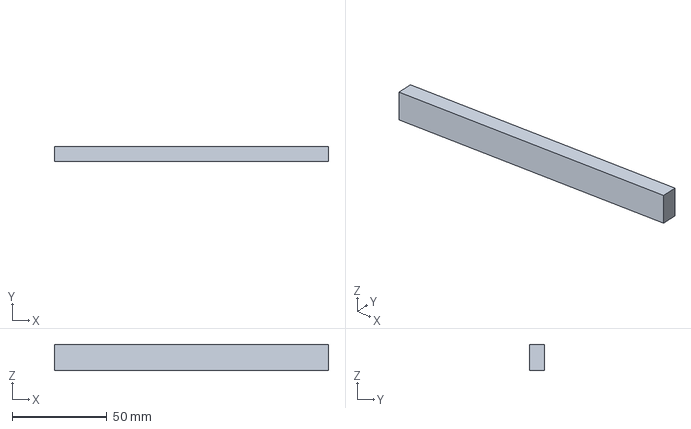
[picture p139: CAD file, 2026-11-13]
cad/out/dock_upper/parts/lid_rear_beam.step
144.5 x 8.00 x 13.8 mm
