mhdelano-ai/ELISA/cad/out/dock_lower/part_pogo_guide_block.step

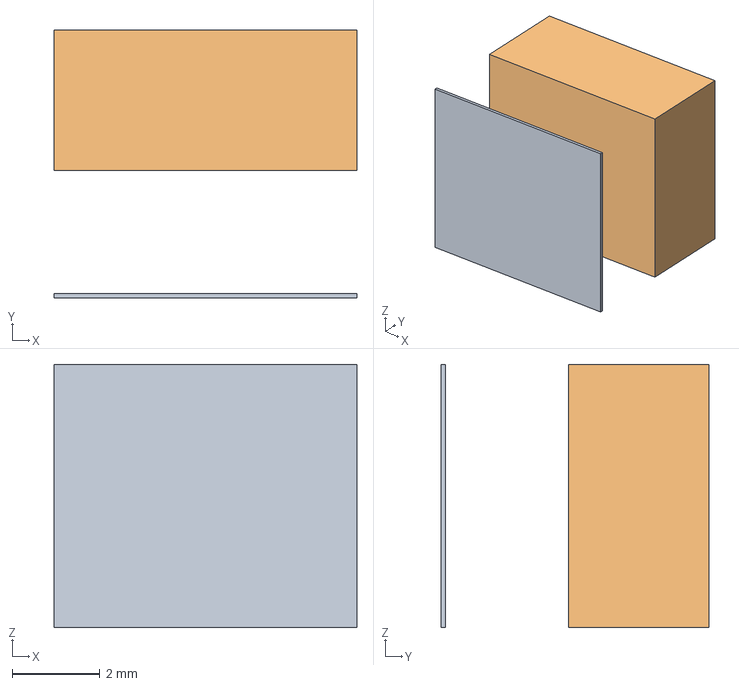
[picture p140: CAD file, 2026-11-13]
cad/out/dock_lower/part_pogo_guide_block.step
6.90 x 6.10 x 6.00 mm
