mhdelano-ai/ELISA/cad/out/dock_upper/parts/bridge.step

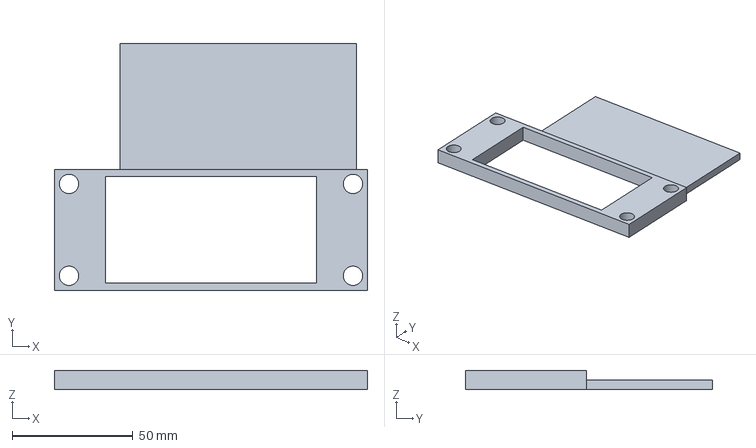
[picture p141: CAD file, 2026-11-13]
cad/out/dock_upper/parts/bridge.step
129.5 x 102.0 x 8.00 mm
