mhdelano-ai/ELISA/cad/out/dock_lower/part_retainer_Ps.step

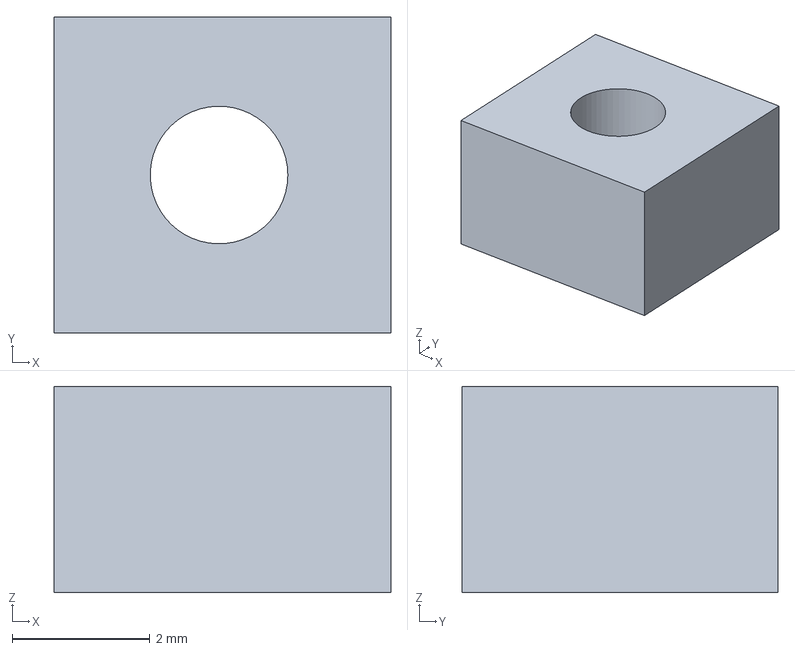
[picture p142: CAD file, 2026-11-13]
cad/out/dock_lower/part_retainer_Ps.step
4.90 x 4.60 x 3.00 mm
