mhdelano-ai/ELISA/cad/out/dock_upper/parts/hinge_pin_D6.step

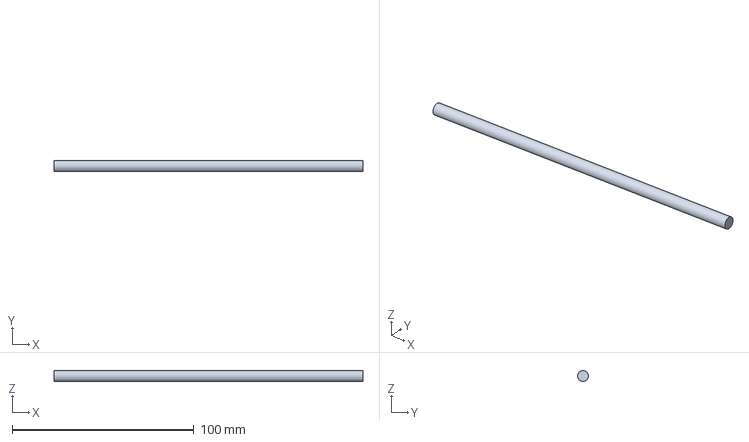
[picture p143: CAD file, 2026-11-13]
cad/out/dock_upper/parts/hinge_pin_D6.step
170.0 x 5.99 x 6.00 mm
