mhdelano-ai/ELISA/cad/out/dock_lower/part_Mc1_bracket.step

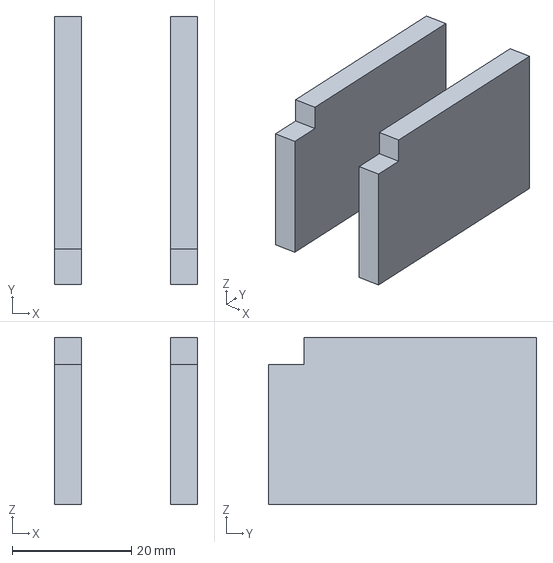
[picture p144: CAD file, 2026-11-13]
cad/out/dock_lower/part_Mc1_bracket.step
24.0 x 45.0 x 28.0 mm
