mhdelano-ai/ELISA/cad/out/dock_upper/parts/guide_plate_lower.step

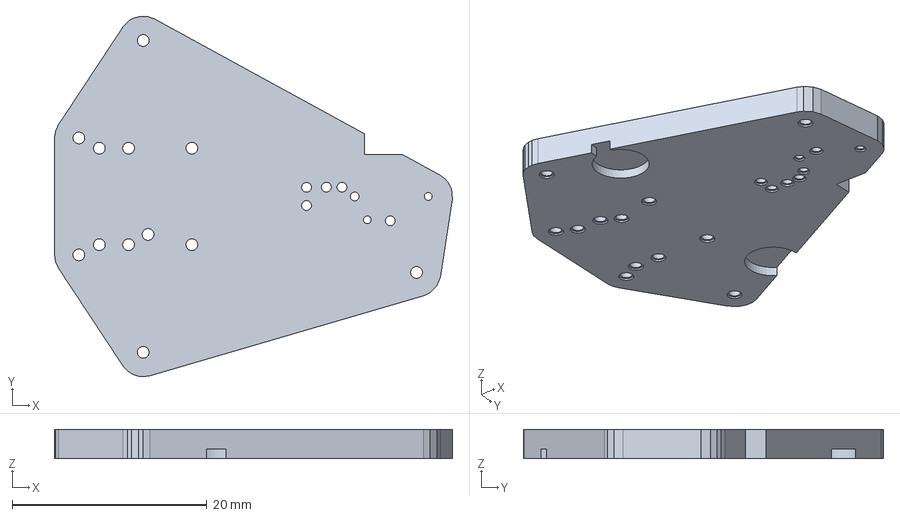
[picture p145: CAD file, 2026-11-13]
cad/out/dock_upper/parts/guide_plate_lower.step
40.8 x 37.0 x 3.00 mm
