mhdelano-ai/ELISA/cad/out/dock_upper/parts/pin_family.step

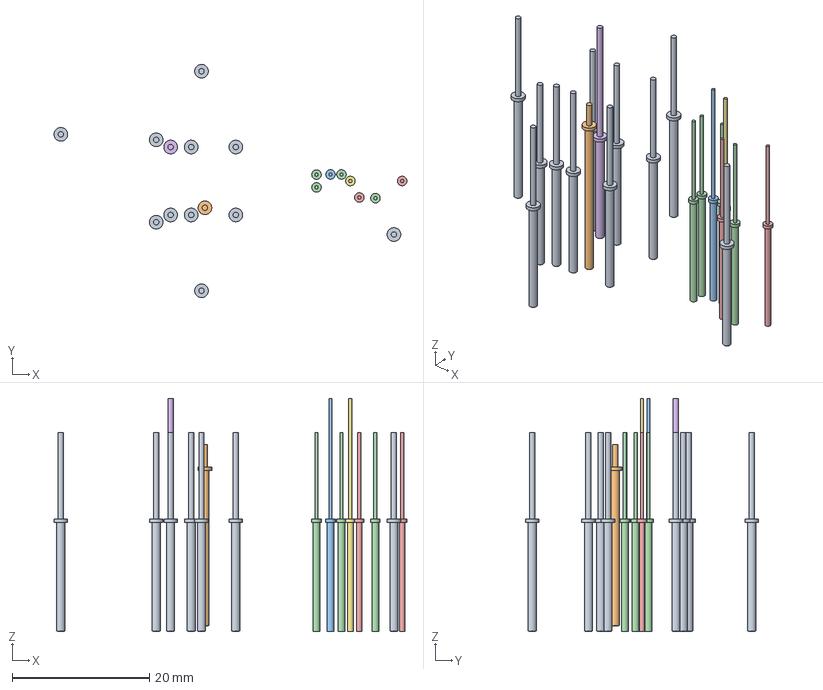
[picture p146: CAD file, 2026-11-13]
cad/out/dock_upper/parts/pin_family.step
51.4 x 34.0 x 34.0 mm
pin_V1
pin_V2
pin_V3
pin_V4
pin_V5
pin_V6
pin_V7
pin_V8
pin_V9
pin_V10
pin_V11
pin_V12
pin_V14
pin_V15
pin_V16
pin_V17
pin_V18
pin_G1
pin_G2
pin_G3
pin_G4
