mhdelano-ai/ELISA/cad/out/dock_lower/part_ebay_enclosure.step

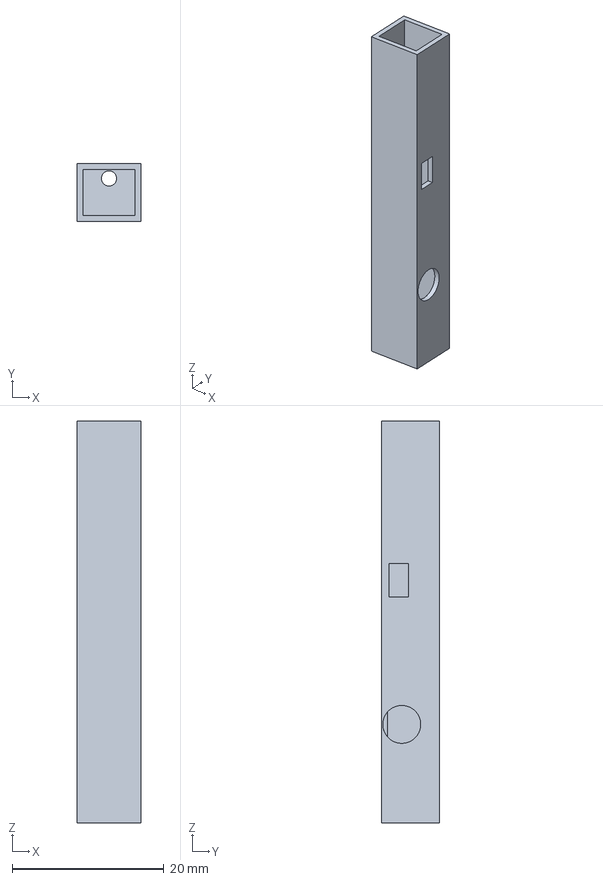
[picture p147: CAD file, 2026-11-13]
cad/out/dock_lower/part_ebay_enclosure.step
8.50 x 7.70 x 53.0 mm
