mhdelano-ai/ELISA/cad/out/dock_upper/parts/guide_plate_upper.step

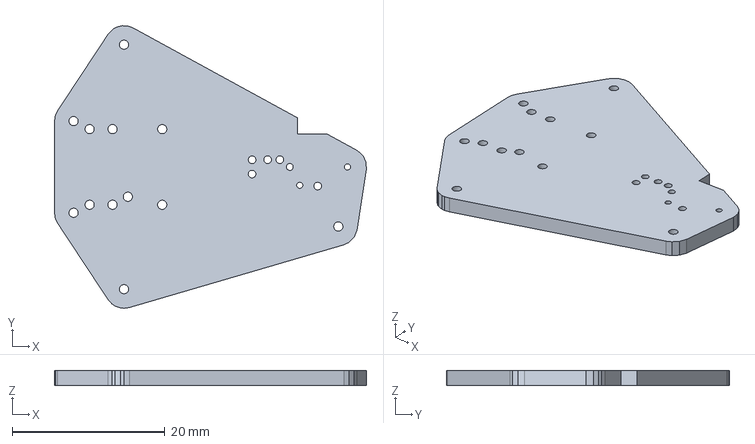
[picture p148: CAD file, 2026-11-13]
cad/out/dock_upper/parts/guide_plate_upper.step
40.8 x 37.0 x 2.00 mm
