mhdelano-ai/ELISA/cad/out/dock_upper/parts/button_family.step

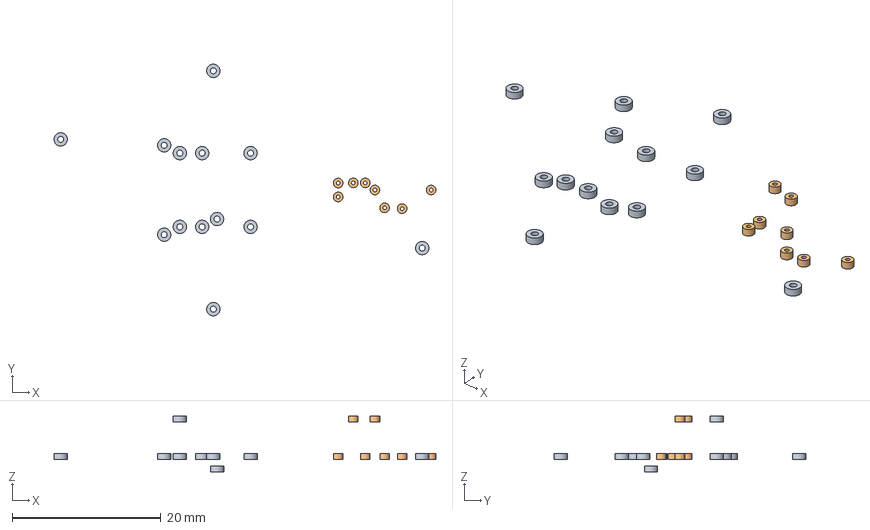
[picture p149: CAD file, 2026-11-13]
cad/out/dock_upper/parts/button_family.step
51.3 x 33.8 x 7.50 mm
button_V1
button_V2
button_V3
button_V4
button_V5
button_V6
button_V7
button_V8
button_V9
button_V10
button_V11
button_V12
button_V14
button_V15
button_V16
button_V17
button_V18
button_G1
button_G2
button_G3
button_G4
