mhdelano-ai/ELISA/cad/out/dock_upper/parts/cam_eccentrics.step

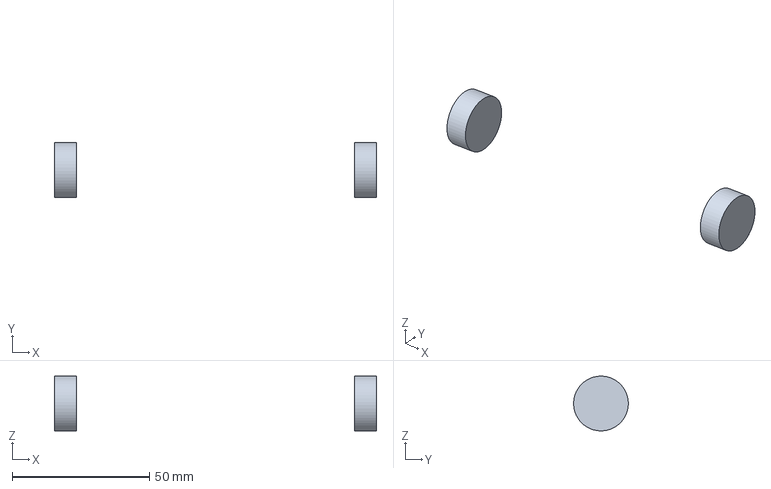
[picture p150: CAD file, 2026-11-13]
cad/out/dock_upper/parts/cam_eccentrics.step
117.5 x 20.0 x 20.0 mm
