mhdelano-ai/ELISA/cad/out/dock_upper/parts/press_pad_stem_foot.step

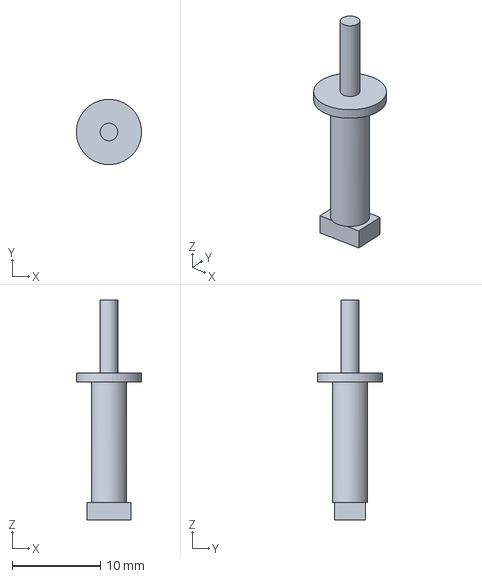
[picture p151: CAD file, 2026-11-13]
cad/out/dock_upper/parts/press_pad_stem_foot.step
7.39 x 7.40 x 25.0 mm
