mhdelano-ai/ELISA/cad/out/dock_upper/parts/guide_pin_family.step

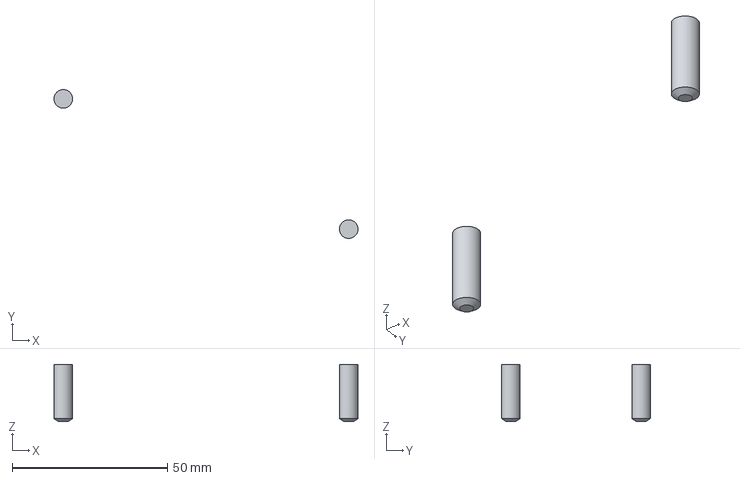
[picture p152: CAD file, 2026-11-13]
cad/out/dock_upper/parts/guide_pin_family.step
98.0 x 48.0 x 18.5 mm
guide_pin_GP1
guide_pin_GP2
