mhdelano-ai/ELISA/(list of files, cad)

Other CAD files:
cad/out/dock_lower/part_Mc1_link_upper.step
