mhdelano-ai/ELISA/cad/out/assembly/bench_layout_top.png

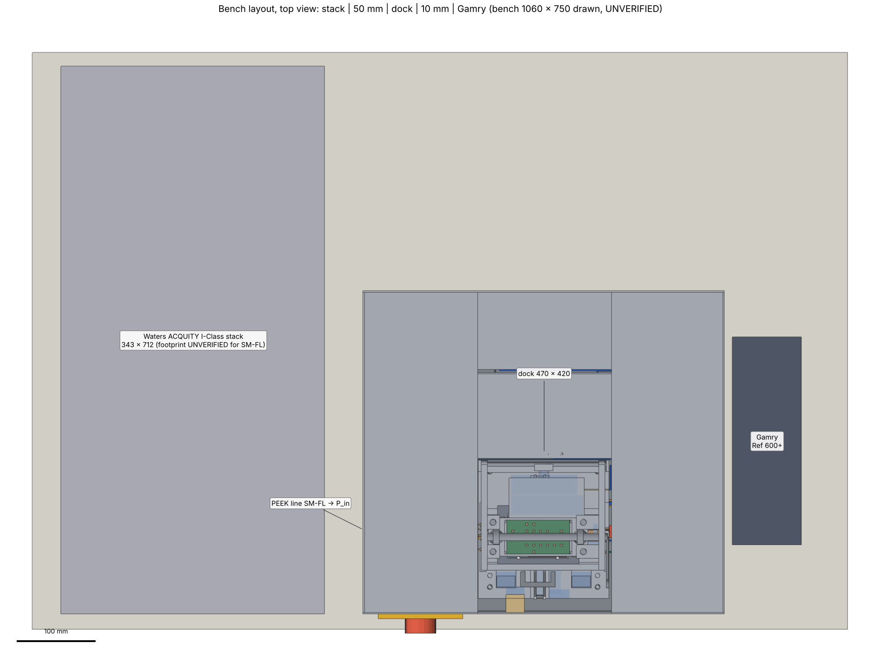
cad/out/assembly/bench_layout_top.png
