mhdelano-ai/ELISA/cad/out/assembly/dock_open_loading.png

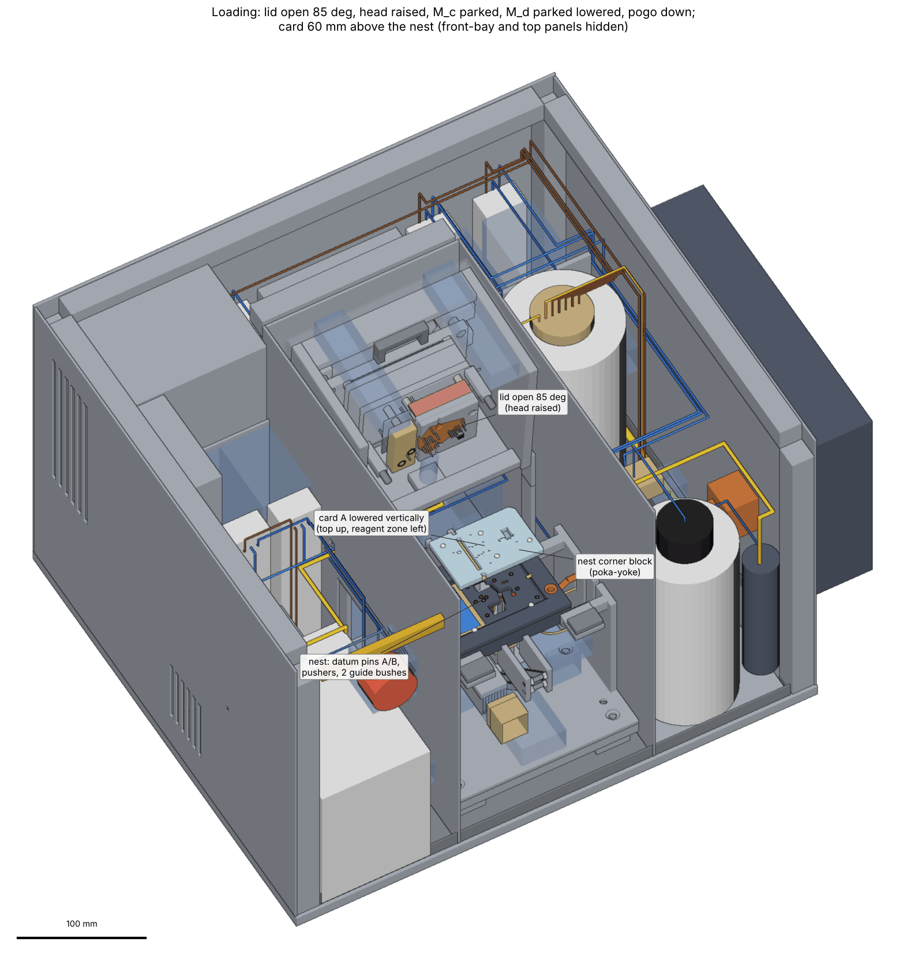
cad/out/assembly/dock_open_loading.png
