mhdelano-ai/ELISA/cad/out/assembly/exploded_four_modules.png

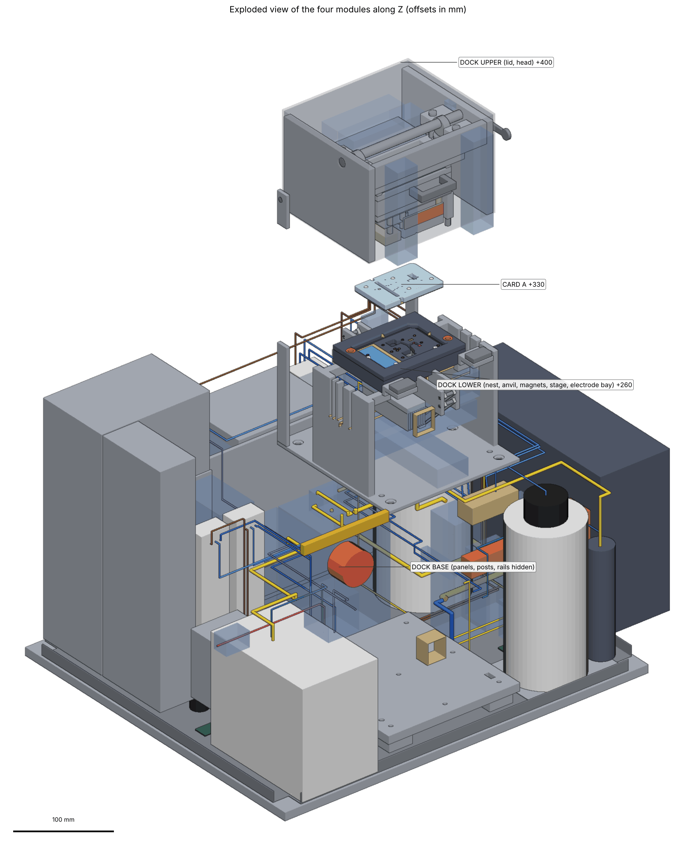
cad/out/assembly/exploded_four_modules.png
