mhdelano-ai/ELISA/cad/out/assembly/section_chamber_full_height.png

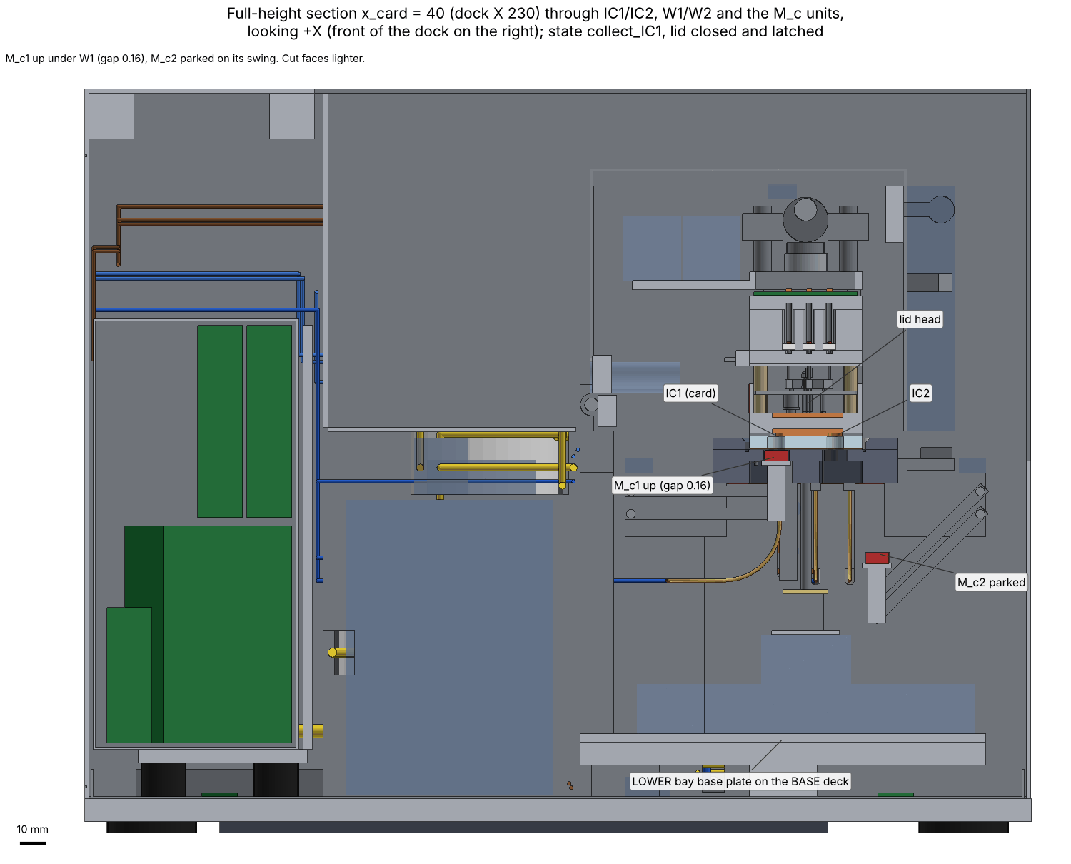
cad/out/assembly/section_chamber_full_height.png
