mhdelano-ai/ELISA/cad/out/assembly/section_chamber_zoom_collect_IC1.png

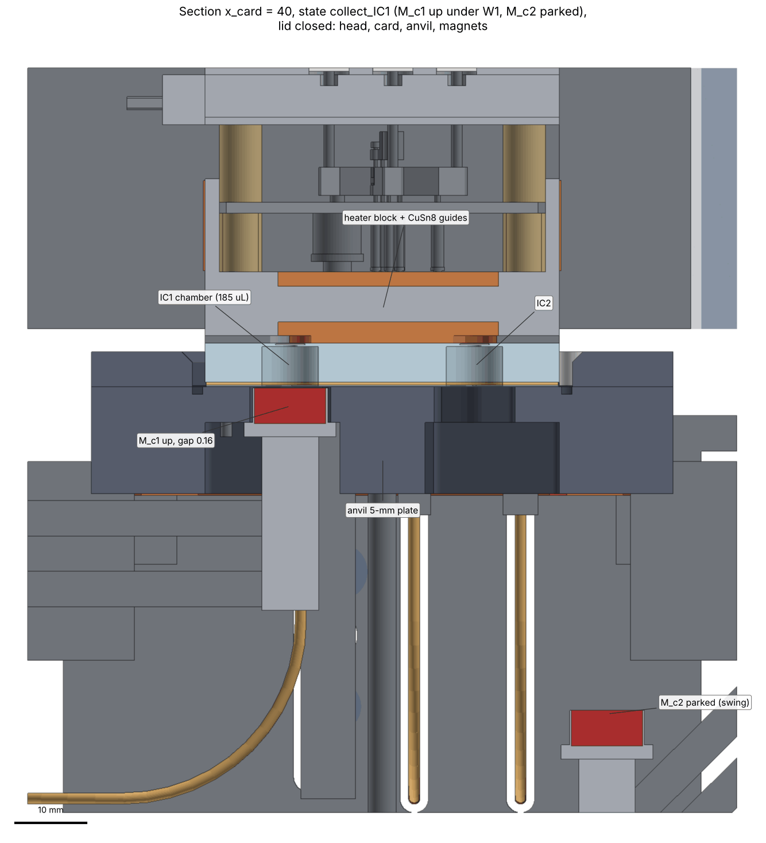
cad/out/assembly/section_chamber_zoom_collect_IC1.png
