mhdelano-ai/ELISA/results/baseline_table.md

| Architecture | LOD nominal (pg/mL) | LOD median [5-95 %] (pg/mL) | P(LOD<=1) | LOD, SbG-equivalent NSB (pre-audit, pg/mL) | Blank equiv. B (pg/mL) | ULOQ (pg/mL) | Cycle / to result (min) | Limiting term |
|---|---|---|---|---|---|---|---|---|
| B-mag1-IDA/alp_hqdp/PLNO75 | 0.57 | 2.3 [0.47-39] | 0.236 | 14 | 1.7 | 1.4e+03 | 21.5 / 51.5 | nsb_variability |
| B-mag1-IDA/alp_hqdp | 0.56 | 2.3 [0.39-35] | 0.246 | 14 | 1.7 | 1.4e+03 | 21.5 / 51.5 | nsb_variability |
| B-mag1-IDA/hrp_tmb | 0.81 | 4.3 [0.66-70] | 0.116 | 18 | 2 | 3.4e+04 | 21.5 / 51.5 | electrode_sensitivity |
| B-mag1-IDA/alp_papp | 1 | 6.8 [0.88-1.3e+02] | 0.076 | 19 | 2.5 | 4e+03 | 21.5 / 51.5 | electrode_sensitivity |
| B-mag-IDA/alp_hqdp | 2.6 | 12 [1.5-1.7e+02] | 0.022 | 61 | 7.9 | 1.2e+04 | 30.5 / 60.5 | nsb_variability |
| B-mag-IDA/alp_hqdp/PLNO75 | 3.5 | 17 [1.7-2.1e+02] | 0.019 | 82 | 11 | 1.2e+04 | 30.5 / 60.5 | nsb_variability |
| B-mag-TL/alp_hqdp | 3.9 | 18 [2.3-1.7e+02] | 0.010 | 61 | 7.9 | 1.2e+04 | 30.5 / 60.5 | baseline_drift |
| B-mag-IDA/hrp_tmb | 4 | 29 [3.1-3.5e+02] | 0.007 | 84 | 10 | 1e+05 | 30.5 / 60.5 | electrode_sensitivity |
| B-mag-TL/hrp_tmb | 4.2 | 31 [3.6-3.5e+02] | 0.002 | 84 | 10 | 1e+05 | 30.5 / 60.5 | electrode_sensitivity |
| C-bed-IDA/alp_hqdp | 8.7 | 34 [3.4-4.3e+02] | 0.004 | 2.4e+02 | 21 | 2.3e+03 | 33.5 / 33.5 | nsb_variability |
| C-bed-IDA/hrp_tmb | 8.7 | 38 [4.2-4.7e+02] | 0.001 | 2.2e+02 | 21 | 5.8e+04 | 33.5 / 33.5 | electrode_sensitivity |
| C-bed-IDA/alp_papp | 8.9 | 42 [5-5.2e+02] | 0.000 | 2.3e+02 | 22 | 6.8e+03 | 33.5 / 33.5 | electrode_sensitivity |
| B-bed-TL/alp_hqdp | 19 | 44 [5.6-5.8e+02] | 0.000 | 5.5e+02 | 63 | 6.8e+03 | 33.5 / 33.5 | nsb_variability |
| B-bed-IDA/alp_hqdp | 19 | 49 [5.2-6.1e+02] | 0.000 | 5.5e+02 | 63 | 6.8e+03 | 33.5 / 33.5 | nsb_variability |
| B-bed-COUL/alp_hqdp | 19 | 49 [5.5-6.1e+02] | 0.000 | 5.5e+02 | 63 | 6.8e+03 | 33.5 / 33.5 | nsb_variability |
| B-mag-TL/alp_papp | 6.5 | 55 [5.1-7.2e+02] | 0.001 | 85 | 14 | 3.4e+04 | 30.5 / 60.5 | electrode_sensitivity |
| B-mag-IDA/alp_papp | 5.9 | 55 [5.2-7e+02] | 0.000 | 85 | 14 | 3.4e+04 | 30.5 / 60.5 | electrode_sensitivity |
| B-bed-TL/alp_hqdp/PLNO75 | 26 | 63 [6.7-8e+02] | 0.000 | 7.3e+02 | 85 | 6.8e+03 | 33.5 / 33.5 | nsb_variability |
| B-bed-WJ/alp_hqdp | 26 | 65 [10-6.2e+02] | 0.000 | 5.5e+02 | 63 | 6.8e+03 | 33.5 / 33.5 | nsb_variability |
| B-mag-TL/alp_aap | 22 | 67 [4.7-1.8e+03] | 0.003 | 65 | 12 | 6.8e+03 | 30.5 / 60.5 | substrate_background |
| B-bed-TL/alp_hqdp/injected-substrate | 30 | 71 [11-1.3e+03] | 0.000 | 7.7e+02 | 99 | 6.8e+03 | 39.5 / 39.5 | nsb_variability |
| B-bed-TL/alp_hqdp/untreated-sample | 31 | 78 [8.6-1e+03] | 0.000 | 8.7e+02 | 1e+02 | 6.8e+03 | 33.5 / 33.5 | nsb_variability |
| B-bed-SPE/alp_hqdp | 29 | 79 [11-7.8e+02] | 0.000 | 7.6e+02 | 63 | 6.8e+03 | 33.5 / 33.5 | nsb_variability |
| B-bed-TL/alp_aap | 23 | 82 [9.9-1.1e+03] | 0.000 | 5.7e+02 | 66 | 4e+03 | 33.5 / 33.5 | nsb_variability |
| B-bed-TL/hrp_tmb | 27 | 83 [11-1e+03] | 0.000 | 6.7e+02 | 64 | 1e+05 | 33.5 / 33.5 | electrode_sensitivity |
| B-bed-SPE/hrp_tmb | 27 | 84 [13-8.9e+02] | 0.000 | 6.7e+02 | 64 | 1e+05 | 33.5 / 33.5 | electrode_sensitivity |
| B-bed-IDA/hrp_tmb | 27 | 87 [11-1e+03] | 0.000 | 6.7e+02 | 64 | 1e+05 | 33.5 / 33.5 | electrode_sensitivity |
| B-bed-COUL/hrp_tmb | 27 | 87 [11-1e+03] | 0.000 | 6.7e+02 | 64 | 1e+05 | 33.5 / 33.5 | electrode_sensitivity |
| B-bed-WJ/alp_aap | 23 | 88 [8.5-1.1e+03] | 0.000 | 5.7e+02 | 66 | 4e+03 | 33.5 / 33.5 | nsb_variability |
| B-bed-WJ/hrp_tmb | 28 | 91 [14-9.7e+02] | 0.000 | 6.7e+02 | 64 | 1e+05 | 33.5 / 33.5 | electrode_sensitivity |
| B-cap-TL/alp_hqdp | 25 | 93 [13-8.4e+02] | 0.000 | 4.4e+02 | 56 | 2e+04 | 33.5 / 33.5 | baseline_drift |
| B-bed-COUL/alp_aap | 23 | 94 [8.1-1e+03] | 0.000 | 5.7e+02 | 66 | 4e+03 | 33.5 / 33.5 | nsb_variability |
| B-bed-SPE/alp_papp | 29 | 97 [14-9.3e+02] | 0.000 | 7e+02 | 66 | 2e+04 | 33.5 / 33.5 | electrode_sensitivity |
| B-bed-IDA/alp_papp | 27 | 98 [11-9e+02] | 0.000 | 7e+02 | 66 | 2e+04 | 33.5 / 33.5 | electrode_sensitivity |
| B-bed-COUL/alp_papp | 27 | 98 [11-9e+02] | 0.000 | 7e+02 | 66 | 2e+04 | 33.5 / 33.5 | electrode_sensitivity |
| B-bed-TL/alp_papp | 27 | 99 [12-9.9e+02] | 0.000 | 7e+02 | 66 | 2e+04 | 33.5 / 33.5 | electrode_sensitivity |
| B-bed-WJ/alp_papp | 31 | 1e+02 [15-9.1e+02] | 0.000 | 7e+02 | 66 | 2e+04 | 33.5 / 33.5 | electrode_sensitivity |
| B-bed-SPE/alp_aap | 30 | 1.2e+02 [13-1.1e+03] | 0.000 | 8e+02 | 66 | 4e+03 | 33.5 / 33.5 | electrode_sensitivity |
| B-cap-TL/hrp_tmb | 26 | 1.5e+02 [22-1.5e+03] | 0.000 | 6e+02 | 61 | 1e+05 | 33.5 / 33.5 | electrode_sensitivity |
| B-cap-TL/alp_papp | 33 | 1.8e+02 [26-2e+03] | 0.000 | 6.1e+02 | 71 | 5.8e+04 | 33.5 / 33.5 | electrode_sensitivity |
| B-cap-TL/alp_aap | 55 | 1.9e+02 [19-3.7e+03] | 0.000 | 4.5e+02 | 67 | 2e+04 | 33.5 / 33.5 | substrate_background |
| C-planar-IDA/alp_hqdp | 1.5e+02 | 4e+02 [31-7.2e+03] | 0.000 | 4.1e+03 | 3.6e+02 | 5.8e+04 | 33.5 / 33.5 | nsb_variability |
| C-planar-IDA/hrp_tmb | 1.5e+02 | 5.5e+02 [47-6.5e+03] | 0.000 | 3.8e+03 | 3.6e+02 | 1e+05 | 33.5 / 33.5 | electrode_sensitivity |
| C-planar-IDA/alp_papp | 1.6e+02 | 6.4e+02 [58-8.2e+03] | 0.000 | 3.9e+03 | 3.9e+02 | 1e+05 | 33.5 / 33.5 | electrode_sensitivity |
| A-bed-TL/alp_hqdp | 4e+02 | 1.2e+03 [71-2.3e+04] | 0.000 | 6.5e+02 | 2.5e+03 | 1e+05 | 20.5 / 20.5 | substrate_background |
| B-mono-TL/alp_hqdp | 1.3e+03 | 2.7e+03 [3.2e+02-3.9e+04] | 0.000 | 4.3e+04 | 4.2e+03 | 1e+05 | 33.5 / 33.5 | nsb_variability |
| B-mag-IDA/sa_polyhrp_tmb | 9.2e+02 | 3.3e+03 [2.1e+02-inf] | 0.000 | 1.1e+03 | 2.2e+03 | 1e+05 | 39.5 / 69.5 | electrode_sensitivity |
| B-mono-TL/alp_aap | 1.3e+03 | 3.5e+03 [4.4e+02-3.7e+04] | 0.000 | 4.5e+04 | 4.3e+03 | 5.8e+04 | 33.5 / 33.5 | nsb_variability |
| B-mag-TL/sa_polyhrp_tmb | 9.2e+02 | 3.5e+03 [2e+02-inf] | 0.000 | 1.1e+03 | 2.2e+03 | 1e+05 | 39.5 / 69.5 | electrode_sensitivity |
| C-bed-IDA/sbg_papg | 8.3e+02 | 4e+03 [3.4e+02-inf] | 0.000 | 1.2e+03 | 1.9e+03 | 1e+05 | 42.5 / 42.5 | electrode_sensitivity |
| B-mono-TL/hrp_tmb | 1.7e+03 | 4.5e+03 [5.8e+02-6.5e+04] | 0.000 | 4.3e+04 | 4.1e+03 | 1e+05 | 33.5 / 33.5 | electrode_sensitivity |
| B-mono-TL/alp_papp | 1.7e+03 | 4.7e+03 [5.7e+02-5.2e+04] | 0.000 | 5.1e+04 | 4.1e+03 | 1e+05 | 33.5 / 33.5 | electrode_sensitivity |
| B-mag1-IDA/sa_polyhrp_tmb | 1.2e+03 | 4.7e+03 [3.1e+02-inf] | 0.000 | 1.2e+03 | 2.8e+03 | 5.8e+04 | 21.5 / 51.5 | nsb_variability |
| B-mag-IDA/sbg_papg | 1.3e+03 | 5.9e+03 [3.6e+02-inf] | 0.000 | 1.3e+03 | 9.5e+02 | 1e+05 | 39.5 / 69.5 | substrate_background |
| B-mag-TL/sbg_papg | 1.6e+03 | 6.9e+03 [5.4e+02-inf] | 0.000 | 1.6e+03 | 9.5e+02 | 1e+05 | 39.5 / 69.5 | substrate_background |
| B-bed-IDA/sbg_papg | 2.5e+03 | 8.5e+03 [8.2e+02-inf] | 0.000 | 3.6e+03 | 5.8e+03 | 1e+05 | 42.5 / 42.5 | electrode_sensitivity |
| B-bed-COUL/sbg_papg | 2.5e+03 | 8.5e+03 [8.4e+02-inf] | 0.000 | 3.6e+03 | 5.8e+03 | 1e+05 | 42.5 / 42.5 | electrode_sensitivity |
| B-bed-TL/sbg_papg | 2.5e+03 | 8.9e+03 [8.2e+02-inf] | 0.000 | 3.6e+03 | 5.8e+03 | 1e+05 | 42.5 / 42.5 | electrode_sensitivity |
| C-bed-IDA/sa_polyhrp_tmb | 2.4e+03 | 9.3e+03 [4.3e+02-inf] | 0.000 | 2.7e+03 | 5.6e+03 | 1e+05 | 42.5 / 42.5 | nsb_variability |
| B-mag1-IDA/sbg_papg | 2.6e+03 | 9.9e+03 [8.7e+02-inf] | 0.000 | 2.6e+03 | 6.1e+03 | 1e+05 | 21.5 / 51.5 | nsb_variability |
| B-bed-SPE/sbg_papg | 4.1e+03 | 1.1e+04 [1.5e+03-inf] | 0.000 | 4.8e+03 | 5.8e+03 | 1e+05 | 42.5 / 42.5 | baseline_drift |
| B-bed-WJ/sbg_papg | 5.8e+03 | 1.3e+04 [1.7e+03-inf] | 0.000 | 6.3e+03 | 5.8e+03 | 1e+05 | 42.5 / 42.5 | baseline_drift |
| A-bed-COUL/alp_hqdp | 6e+03 | 1.5e+04 [6.4e+02-inf] | 0.000 | 6.1e+03 | 3.7e+04 | 1e+05 | 20.5 / 20.5 | substrate_background |
| B-bed-SPE/sa_polyhrp_tmb | 7.4e+03 | 1.7e+04 [1.2e+03-inf] | 0.000 | 8.5e+03 | 1.7e+04 | 1e+05 | 42.5 / 42.5 | nsb_variability |
| B-bed-WJ/sa_polyhrp_tmb | 7.4e+03 | 1.8e+04 [1.3e+03-inf] | 0.000 | 8.5e+03 | 1.7e+04 | 1e+05 | 42.5 / 42.5 | nsb_variability |
| B-bed-IDA/sa_polyhrp_tmb | 7.4e+03 | 1.9e+04 [1.2e+03-inf] | 0.000 | 8.5e+03 | 1.7e+04 | 1e+05 | 42.5 / 42.5 | nsb_variability |
| B-bed-COUL/sa_polyhrp_tmb | 7.4e+03 | 1.9e+04 [1.2e+03-inf] | 0.000 | 8.5e+03 | 1.7e+04 | 1e+05 | 42.5 / 42.5 | nsb_variability |
| B-bed-TL/sa_polyhrp_tmb | 7.4e+03 | 2e+04 [1.5e+03-inf] | 0.000 | 8.5e+03 | 1.7e+04 | 1e+05 | 42.5 / 42.5 | nsb_variability |
| A-bed-TL/hrp_tmb | 5.7e+03 | 2.1e+04 [1.1e+03-inf] | 0.000 | 6.2e+03 | 1.7e+04 | 1e+05 | 20.5 / 20.5 | electrode_sensitivity |
| B-cap-TL/sbg_papg | 6.8e+03 | 2.3e+04 [2.8e+03-inf] | 0.000 | 7.2e+03 | 5.7e+03 | 1e+05 | 42.5 / 42.5 | baseline_drift |
| B-cap-TL/sa_polyhrp_tmb | 6.6e+03 | 2.4e+04 [1.5e+03-inf] | 0.000 | 7.5e+03 | 1.6e+04 | 1e+05 | 42.5 / 42.5 | nsb_variability |
| A-bed-TL/alp_papp | 1.7e+04 | 6.1e+04 [3.8e+03-inf] | 0.000 | 1.7e+04 | 5e+04 | 1e+05 | 20.5 / 20.5 | electrode_sensitivity |
| C-planar-IDA/sbg_papg | 1.5e+04 | 6.2e+04 [4.7e+03-inf] | 0.000 | 2.1e+04 | 3.3e+04 | 1e+05 | 42.5 / 42.5 | electrode_sensitivity |
| A-bed-TL/alp_aap | 2.8e+04 | 6.3e+04 [2.4e+03-inf] | 0.000 | 2.8e+04 | inf | 1e+05 | 20.5 / 20.5 | substrate_background |
| A-bed-COUL/alp_aap | inf | inf [2.9e+04-inf] | 0.000 | inf | inf | 1e+05 | 20.5 / 20.5 | substrate_background |
| A-bed-COUL/sbg_papg | inf | inf [inf-inf] | 0.000 | inf | inf | 1e+05 | 24.5 / 24.5 | electrode_sensitivity |
| A-bed-COUL/alp_papp | inf | inf [6.6e+04-inf] | 0.000 | inf | inf | 1e+05 | 20.5 / 20.5 | electrode_sensitivity |
| A-bed-COUL/hrp_tmb | 8.6e+04 | inf [1.6e+04-inf] | 0.000 | 8.6e+04 | inf | 1e+05 | 20.5 / 20.5 | electrode_sensitivity |
| A-bed-COUL/sa_polyhrp_tmb | inf | inf [inf-inf] | 0.000 | inf | inf | 1e+05 | 24.5 / 24.5 | electrode_sensitivity |
| A-bed-TL/sbg_papg | inf | inf [inf-inf] | 0.000 | inf | inf | 1e+05 | 24.5 / 24.5 | electrode_sensitivity |
| A-bed-TL/sa_polyhrp_tmb | inf | inf [3.4e+04-inf] | 0.000 | inf | inf | 1e+05 | 24.5 / 24.5 | electrode_sensitivity |
| B-mono-TL/sbg_papg | inf | inf [3.5e+04-inf] | 0.000 | inf | inf | 1e+05 | 42.5 / 42.5 | electrode_sensitivity |
| B-mono-TL/sa_polyhrp_tmb | inf | inf [9.1e+04-inf] | 0.000 | inf | inf | 1e+05 | 42.5 / 42.5 | nsb_variability |
| C-planar-IDA/sa_polyhrp_tmb | 4.2e+04 | inf [4.8e+03-inf] | 0.000 | 4.8e+04 | 9.9e+04 | 1e+05 | 42.5 / 42.5 | nsb_variability |
