mhdelano-ai/ELISA/results/scenarios.md

| Architecture | Scenario | LOD nominal (pg/mL) | LOD median [5-95 %] (pg/mL) | P(LOD<=1) |
|---|---|---|---|---|
| B-mag1-IDA/alp_hqdp/PLNO75 | audited baseline | 0.57 | 2.3 [0.47-39] | 0.236 |
| B-mag1-IDA/alp_hqdp/PLNO75 | SbG-equivalent NSB (pre-audit factor 1) | 14 | 47 [5.9-8.6e+02] | 0.001 |
| B-mag1-IDA/alp_hqdp/PLNO75 | unscreened capture reagent (koff to 8.3e-3 /s) | 0.57 | 3 [0.52-83] | 0.193 |
| B-mag1-IDA/alp_hqdp | audited baseline | 0.56 | 2.3 [0.39-35] | 0.246 |
| B-mag1-IDA/alp_hqdp | SbG-equivalent NSB (pre-audit factor 1) | 14 | 51 [5.8-7.7e+02] | 0.001 |
| B-mag1-IDA/alp_hqdp | unscreened capture reagent (koff to 8.3e-3 /s) | 0.56 | 3.1 [0.46-72] | 0.191 |
| B-mag1-IDA/hrp_tmb | audited baseline | 0.81 | 4.3 [0.66-70] | 0.116 |
| B-mag1-IDA/hrp_tmb | SbG-equivalent NSB (pre-audit factor 1) | 18 | 74 [8.6-1e+03] | 0.000 |
| B-mag1-IDA/hrp_tmb | unscreened capture reagent (koff to 8.3e-3 /s) | 0.81 | 6.1 [0.74-1.3e+02] | 0.089 |
| B-mag1-IDA/alp_papp | audited baseline | 1 | 6.8 [0.88-1.3e+02] | 0.076 |
| B-mag1-IDA/alp_papp | SbG-equivalent NSB (pre-audit factor 1) | 19 | 72 [9.9-1.3e+03] | 0.000 |
| B-mag1-IDA/alp_papp | unscreened capture reagent (koff to 8.3e-3 /s) | 1 | 9.8 [0.99-2.3e+02] | 0.052 |
| B-mag-IDA/alp_hqdp | audited baseline | 2.6 | 12 [1.5-1.7e+02] | 0.022 |
| B-mag-IDA/alp_hqdp | SbG-equivalent NSB (pre-audit factor 1) | 61 | 2.6e+02 [26-3.2e+03] | 0.000 |
| B-mag-IDA/alp_hqdp | unscreened capture reagent (koff to 8.3e-3 /s) | 2.6 | 19 [1.7-7.7e+02] | 0.019 |
| B-mag-IDA/alp_hqdp/PLNO75 | audited baseline | 3.5 | 17 [1.7-2.1e+02] | 0.019 |
| B-mag-IDA/alp_hqdp/PLNO75 | SbG-equivalent NSB (pre-audit factor 1) | 82 | 3.4e+02 [32-4.8e+03] | 0.000 |
| B-mag-IDA/alp_hqdp/PLNO75 | unscreened capture reagent (koff to 8.3e-3 /s) | 3.5 | 26 [2.3-1.2e+03] | 0.012 |
| B-bed-TL/alp_hqdp | audited baseline | 19 | 44 [5.6-5.8e+02] | 0.000 |
| B-bed-TL/alp_hqdp | SbG-equivalent NSB (pre-audit factor 1) | 5.5e+02 | 1.4e+03 [1.5e+02-1.6e+04] | 0.000 |
| B-bed-TL/alp_hqdp | unscreened capture reagent (koff to 8.3e-3 /s) | 19 | 57 [6.9-9.4e+02] | 0.000 |
