mhdelano-ai/ELISA/results/baseline_results.csv

architecture | scheme | capture | chemistry | detector | injection | substrate_delivery | labelling_format | chemical_cycling | sample_treatment | lod_nominal_pgml | lod_median_pgml | lod_p05_pgml | lod_p95_pgml | p_lod_le_1pgml | p_lod_and_range | lod_nominal_nsb_sbg_equivalent_pgml | blank_equiv_nominal_pgml | blank_equiv_median_pgml | uloq_nominal_pgml | dynamic_range_decades_nominal | cycle_time_min | time_to_result_min | meets_time | limiting_term_nominal | limiting_term_mc | limiting_term_mc_share | signal_at_1pgml_C | blank_sd_nominal_C | blank_mean_nominal_C | capture_fraction | label_fraction | enzymes_per_pgml | nsb_enzymes | carry_enzymes | cell_conversion | accumulation_volume_uL | conjugate_peak_dilution | carryover_after_top_pgml | varfrac_nominal_nsb_variability | varfrac_nominal_label_counting | varfrac_nominal_carryover | varfrac_nominal_substrate_background | varfrac_nominal_electrode_sensitivity | varfrac_nominal_electrochemical_noise | varfrac_nominal_baseline_drift | varfrac_nominal_contamination
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
