mhdelano-ai/ELISA/results/reuse.csv

architecture | surface | capacity_loss_per_cycle | electrode_loss_per_cycle | cycles_to_slope_change_tolerance | slope_after_100_cycles | residual_label_per_cycle | carryover_after_top_standard_pgml | lod_nominal_pgml
B-mag1-IDA/alp_hqdp/PLNO75 | renewed beads | 0 | 0.001 | 105 | 0.905 | 3.58e-05 | 0.0357 | 0.575
B-mag1-IDA/alp_hqdp | renewed beads | 0 | 0.001 | 105 | 0.905 | 3.52e-05 | 0.0352 | 0.558
B-mag1-IDA/hrp_tmb | renewed beads | 0 | 0.01 | 10.5 | 0.366 | 3.52e-05 | 0.0352 | 0.806
B-mag1-IDA/alp_papp | renewed beads | 0 | 0.01 | 10.5 | 0.366 | 3.52e-05 | 0.0352 | 1.01
B-mag-IDA/alp_hqdp | renewed beads | 0 | 0.001 | 105 | 0.905 | 9.42e-05 | 0.0942 | 2.62
B-mag-IDA/alp_hqdp/PLNO75 | renewed beads | 0 | 0.001 | 105 | 0.905 | 9.57e-05 | 0.0957 | 3.53
B-mag-TL/alp_hqdp | renewed beads | 0 | 0.001 | 105 | 0.905 | 9.42e-05 | 0.0942 | 3.89
B-mag-IDA/hrp_tmb | renewed beads | 0 | 0.01 | 10.5 | 0.366 | 9.42e-05 | 0.0942 | 4.01
B-mag-TL/hrp_tmb | renewed beads | 0 | 0.01 | 10.5 | 0.366 | 9.42e-05 | 0.0942 | 4.18
C-bed-IDA/alp_hqdp | regenerated | 0.005 | 0.01 | 6.99 | 0.222 | 0 | 1e-09 | 8.69
C-bed-IDA/hrp_tmb | regenerated | 0.005 | 0.01 | 6.99 | 0.222 | 1e-05 | 0.01 | 8.71
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
