mhdelano-ai/ELISA/automation/templates/blanks_calibration.csv

sample_type | conc_pgml | signal
blank | 0 | 4.8485
blank | 0 | 5.4624
blank | 0 | 5.0163
blank | 0 | 4.8843
blank | 0 | 4.2609
blank | 0 | 4.6564
blank | 0 | 4.8694
blank | 0 | 5.3298
blank | 0 | 5.1225
blank | 0 | 4.6516
standard | 1 | 10.4090
standard | 1 | 10.7035
standard | 1 | 10.1242
standard | 3 | 20.1478
standard | 3 | 20.1944
standard | 3 | 21.4350
standard | 10 | 58.5342
standard | 10 | 54.3505
standard | 10 | 58.0685
standard | 30 | 157.1361
standard | 30 | 154.9528
standard | 30 | 170.9790
standard | 100 | 546.5548
standard | 100 | 505.9724
standard | 100 | 527.0825
standard | 1000 | 5335.5053
standard | 1000 | 5038.5777
standard | 1000 | 5173.6566
