mhdelano-ai/ELISA/results/sensitivity_B-bed-TL__alp_hqdp.csv

parameter | unit | low | nominal | high | dlog10_LOD_at_low | dlog10_LOD_at_high | spearman_vs_logLOD | first_order_index
chem.nsb.nsb_effective_rate_constant | m/s | 8e-12 | 4e-11 | 4e-10 | -0.692 | 1.02 | 0.543 | 0.313
ma.nsb.surface_factor_packed_bed | fold | 1 | 3 | 30 | -0.458 | 1.01 | 0.432 | 0.219
chem.antibodies.koff_detection | 1/s | 3e-06 | 0.00086 | 0.0083 | -0.121 | 0.958 | 0.218 | 0.0838
chem.antibodies.kon_detection | 1/(M*s) | 9e+04 | 3.9e+05 | 1.2e+06 | 0.631 | -0.473 | -0.354 | 0.149
ma.nsb.label_factor_igg_enzyme_conjugate | fold | 0.01 | 0.04 | 0.15 | -0.598 | 0.581 | 0.372 | 0.153
ma.labelling.detection_on_capture_residual_factor | fold | 1 | 1 | 3 | 0 | 0.482 | 0.144 | 0.0383
chem.nsb.blank_CV_analog_electrochemical | fraction | 0.03 | 0.1 | 0.2 | -0.445 | 0.295 | 0.247 | 0.0875
ma.delivery.adsorptive_loss_fraction_with_carrier | fraction lost | 0.02 | 0.2 | 0.6 | -0.0881 | 0.301 | 0.0759 | 0.0304
chem.surfaces.igg_surface_density_monolayer | molecules/m^2 | 2e+15 | 1e+16 | 1.5e+16 | 0.22 | -0.00535 | -0.0783 | 0.0205
hw.reactors.packed_microbed_10uL.void_fraction | fraction | 0.35 | 0.4 | 0.6 | 0.0326 | -0.149 | -0.0917 | 0.041
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
