mhdelano-ai/ELISA/results/sensitivity_B-mag1-IDA__alp_hqdp.csv

parameter | unit | low | nominal | high | dlog10_LOD_at_low | dlog10_LOD_at_high | spearman_vs_logLOD | first_order_index
chem.antibodies.koff_detection | 1/s | 3e-06 | 0.00086 | 0.0083 | -0.39 | 1.96 | 0.453 | 0.343
chem.nsb.nsb_effective_rate_constant | m/s | 8e-12 | 4e-11 | 4e-10 | -0.525 | 0.991 | 0.456 | 0.214
ma.chemistries.alp_hqdp.free_product_impurity | mol/mol | 1e-07 | 1e-05 | 0.001 | -0.0011 | 0.855 | 0.157 | 0.0401
ma.nsb.surface_factor_tubing | fold | 1 | 3 | 30 | -0.0959 | 0.59 | 0.119 | 0.0519
chem.surfaces.igg_surface_density_monolayer | molecules/m^2 | 2e+15 | 1e+16 | 1.5e+16 | 0.587 | -0.116 | -0.224 | 0.064
ma.nsb.label_factor_igg_enzyme_conjugate | fold | 0.01 | 0.04 | 0.15 | -0.478 | 0.564 | 0.305 | 0.102
chem.antibodies.kon_detection | 1/(M*s) | 9e+04 | 3.9e+05 | 1.2e+06 | 0.556 | -0.309 | -0.237 | 0.0773
ma.labelling.detection_on_capture_residual_factor | fold | 1 | 1 | 3 | 0 | 0.467 | 0.0981 | 0.0234
chem.antibodies.kon_capture | 1/(M*s) | 9e+04 | 3e+05 | 1.2e+06 | 0.426 | -0.318 | -0.272 | 0.0894
ma.nsb.blank_igg_contamination_equivalent | M | 0 | 0 | 3e-15 | 0 | 0.418 | 0.0828 | 0.0294
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
