mhdelano-ai/ELISA/results/sensitivity_B-mag1-IDA__alp_hqdp__PLNO75.csv

parameter | unit | low | nominal | high | dlog10_LOD_at_low | dlog10_LOD_at_high | spearman_vs_logLOD | first_order_index
chem.antibodies.koff_detection | 1/s | 3e-06 | 0.00086 | 0.0083 | -0.39 | 1.96 | 0.454 | 0.349
chem.nsb.nsb_effective_rate_constant | m/s | 8e-12 | 4e-11 | 4e-10 | -0.449 | 0.981 | 0.443 | 0.199
ma.chemistries.alp_hqdp.free_product_impurity | mol/mol | 1e-07 | 1e-05 | 0.001 | -0.00195 | 0.976 | 0.178 | 0.0492
ma.nsb.surface_factor_tubing | fold | 1 | 3 | 30 | -0.0928 | 0.587 | 0.0899 | 0.0207
chem.surfaces.igg_surface_density_monolayer | molecules/m^2 | 2e+15 | 1e+16 | 1.5e+16 | 0.587 | -0.116 | -0.249 | 0.0777
chem.antibodies.kon_detection | 1/(M*s) | 9e+04 | 3.9e+05 | 1.2e+06 | 0.556 | -0.309 | -0.233 | 0.074
ma.nsb.label_factor_igg_enzyme_conjugate | fold | 0.01 | 0.04 | 0.15 | -0.416 | 0.555 | 0.266 | 0.0886
chem.enzymes.alp.kcat_conjugate_assay_conditions | 1/s | 100 | 1e+03 | 6e+03 | 0.497 | -0.0187 | -0.0901 | 0.0203
ma.labelling.detection_on_capture_residual_factor | fold | 1 | 1 | 3 | 0 | 0.459 | 0.126 | 0.0254
chem.antibodies.kon_capture | 1/(M*s) | 9e+04 | 3e+05 | 1.2e+06 | 0.426 | -0.318 | -0.256 | 0.0759
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
