mhdelano-ai/ELISA/results/fig_blank_breakdown.png

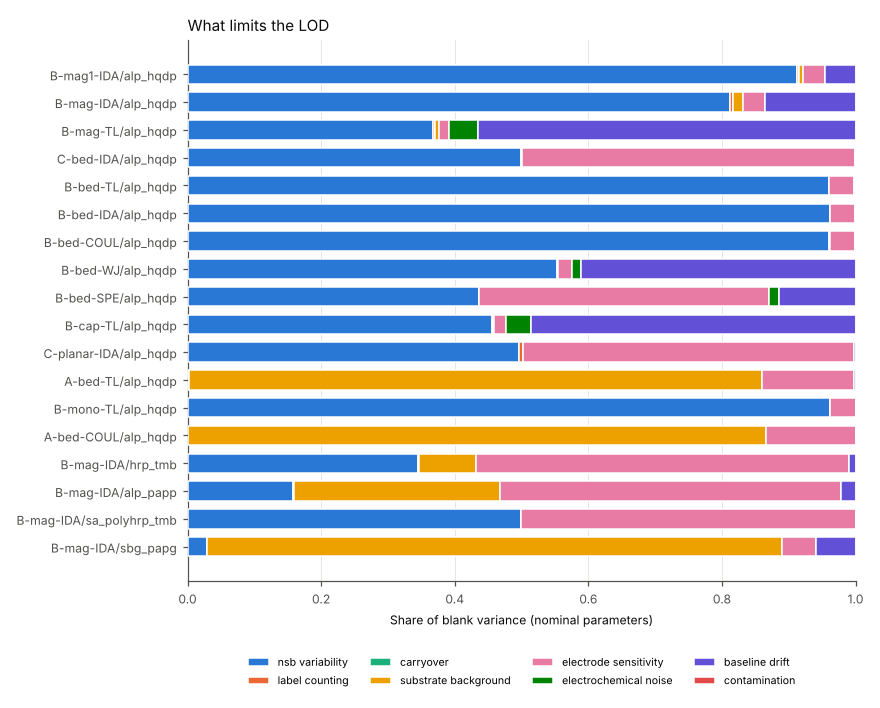
results/fig_blank_breakdown.png
