mhdelano-ai/ELISA/results/fig_calibration.png

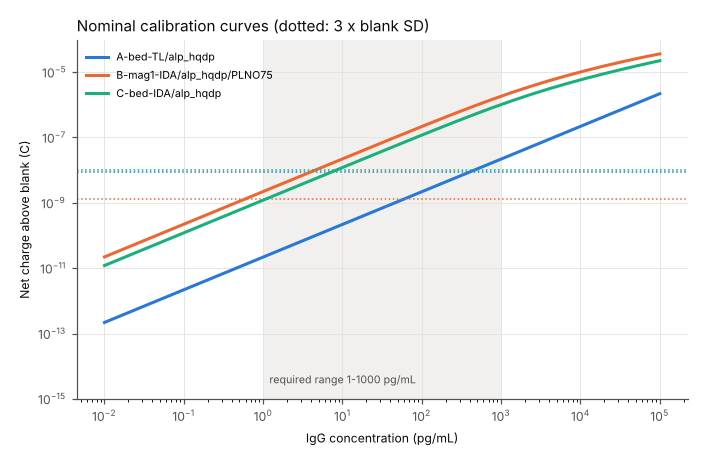
results/fig_calibration.png
