mhdelano-ai/ELISA/results/fig_lod_intervals.png

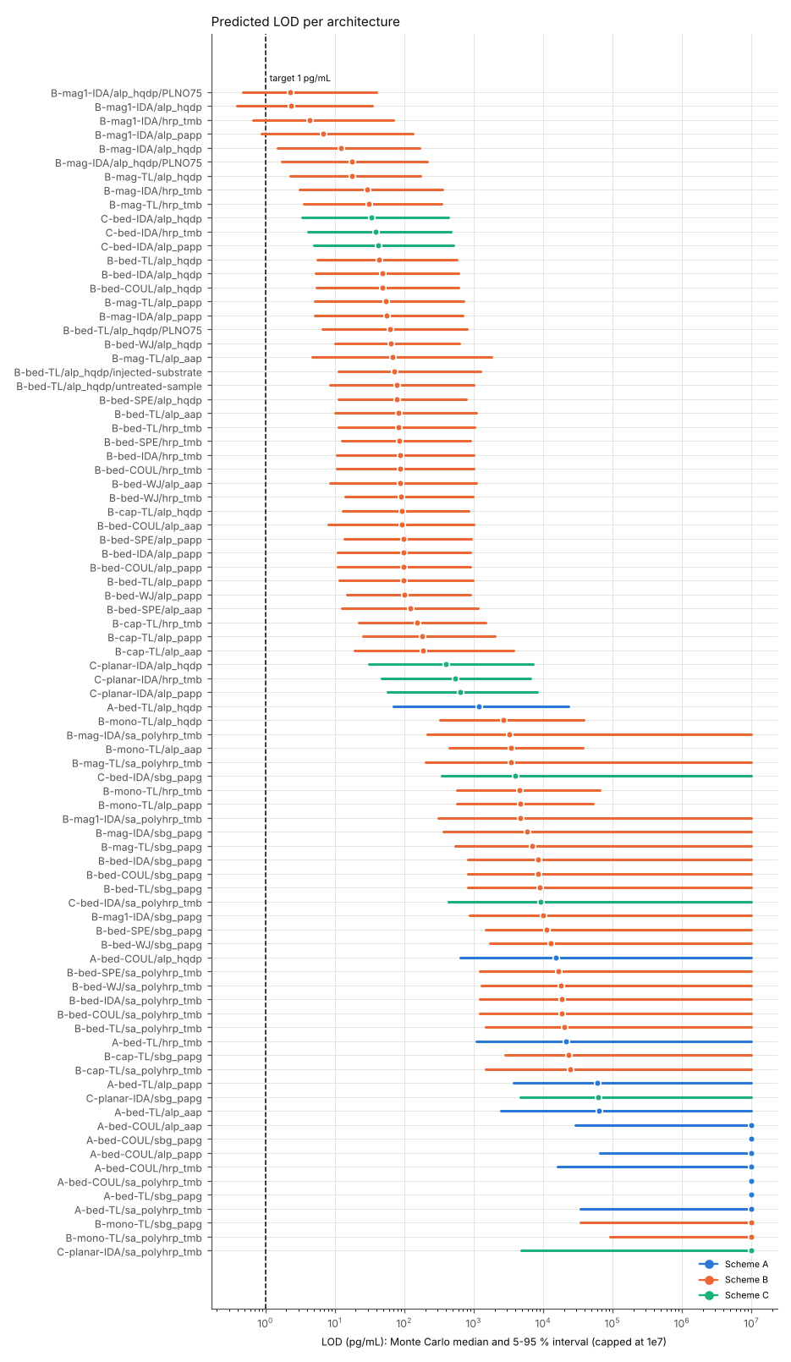
results/fig_lod_intervals.png
