mhdelano-ai/ELISA/results/fig_tornado.png

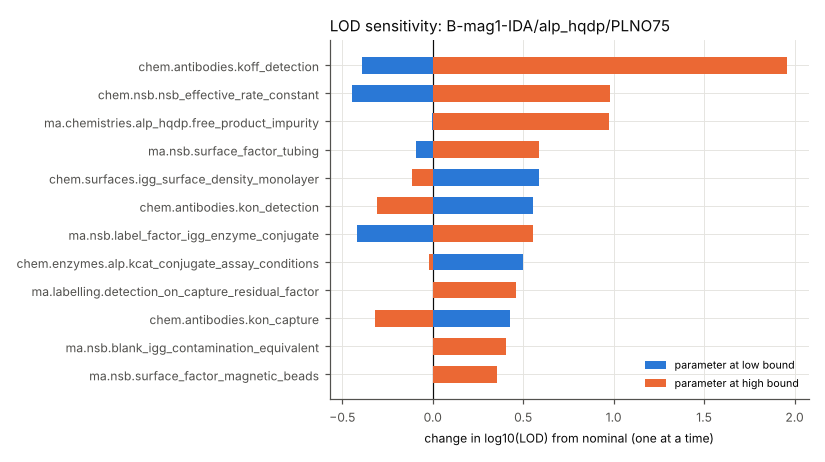
results/fig_tornado.png
