mhdelano-ai/ELISA/(commit log)

2026-11-11 Correct SM-FL to fixed-loop sample manager in project brief
    Claude-Session: https://claude.ai/code/session_01DhDzF5GsLHVink9bUBQDkt
2026-11-11 Add hardware, fluidics and automation review for fixed-loop SM-FL (task 2)
    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
    [hardware.yaml]
2026-11-11 Add LOD simulation package, tests, baseline results and model documentation (task 3)
    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
    [baseline_results.csv, reuse.csv, sensitivity_B-bed-TL__alp_hqdp.csv, sensitivity_B-mag1-IDA__alp_hqdp.csv, sensitivity_B-mag1-IDA__alp_papp.csv, sensitivity_B-mag1-IDA__hrp_tmb.csv, skipped_architectures.csv, validation.csv]
2026-11-11 Audit and recalibrate LOD model; apply installed configuration (100 uL loop, 1 uL/min)
    Corrects the conjugate non-specific-binding rate against its source data,
    fixes model errors, adds consistency checks and tests, regenerates baseline.
    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
    [baseline_results.csv, reuse.csv, sensitivity_B-bed-TL__alp_hqdp.csv, sensitivity_B-mag1-IDA__alp_hqdp.csv, sensitivity_B-mag1-IDA__alp_hqdp__PLNO75.csv, sensitivity_B-mag1-IDA__alp_papp.csv, sensitivity_B-mag1-IDA__hrp_tmb.csv, validation.csv]
2026-11-11 Work in progress: design optimisation scripts, results and partial decision report (task 4)
    Task interrupted by a usage limit; report not yet complete or reviewed.
    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
    [final_designs.csv, levers.csv, robustness.csv, trajectory_CAP__baseline.csv, trajectory_FRB__baseline.csv, trajectory_FRB__dab_screened.csv, trajectory_FRC__baseline.csv, trajectory_FRC__dab_screened.csv]
2026-11-11 Record user decisions: no pre-filled vials; 100 uL is injected volume
    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
2026-11-11 Fix Monte Carlo sampling nothing for architectures with pinned design values
    The parameter access log was lost on the copy made when design values are
    applied, so designs built with with_design() returned the nominal result on
    every draw. Adds a regression test.
    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
    [test_model.py]
2026-11-11 Add staged bench plan, bill of materials, automation skeleton and CLAUDE.md (task 5)
    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
    [blanks_calibration.csv, bli.csv, carryover.csv, detection_on_capture.csv, dissociation.csv, hardware_lab.example.yaml, hardware_sim.yaml, recovery.csv]
2026-11-11 Add final independent review; fix phosphate buffer in bench plan and E1.4 background subtraction
    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
    [detection_on_capture.csv]
2026-11-11 Work in progress: resolving final review findings (scripts and regenerated design tables)
    Task interrupted by a usage limit; documents, automation and the resolution
    table are not yet updated to match.
    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
    [final_designs.csv, final_designs_ida.csv]
2026-11-11 Resolve final review findings: single G1 rule, separate reagent reservoirs, automation fixes
    Phosphate-free wash line, bench-consistent gate table, fault latch and
    recovery cycle, tighter carryover criterion, sampled stirring factor,
    single-channel cell as Stage 3 default. Predictions regenerated; corrections
    and resolution table recorded in docs/08.
    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
    [hardware_lab.example.yaml, hardware_sim.yaml, trace.csv]
2026-11-12 Add chip generation phase 1 surveys (fabrication complete; requirements and literature in progress)
    docs/11: fabrication routes, foundries, valves, reagent storage and docking-station
    components for the second-generation cartridge. docs/09 and docs/10 are working
    drafts still being extended.
    Claude-Session: https://claude.ai/code/session_01DhDzF4bFqYqRczyUuJZPqd
2026-11-12 Work in progress: chip alternatives B/C draft and pre-electrolysis bench test (agents still extending)
    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
    [pre_electrolysis.csv]
2026-11-12 Add E1.2b pre-electrolysis bench test (informational, not a G1a/G1 input)
    docs/06: new Stage 1A experiment E1.2b with thresholds fixed before data; docs/07:
    consumables; automation: CSV template and informational gates.yaml block. The G1 rule
    is unchanged.
    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
2026-11-12 Complete chip alternatives B and C (docs/14); design A draft in progress (docs/13)
    C as specified is not viable (regeneration carry-over); revised C' renews the bed each
    run and moves valving to the dock. B fallback dossier with switch triggers.
    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
2026-11-12 Revise cartridge A design after review (docs/13 Revision B)
    Buildable laminate stack, reachable electrode contacts, drift-cancelling three-window
    read, rebuilt schedule (56.75 min, 14 determinations per card), post-high cleaning
    cycle and allocated carry-over budget. Headline numbers without pre-electrolysis credit.
    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
2026-11-12 Add cartridge decision document (docs/16) and close the design round
    docs/16: decision (A leads, B fallback, C' conditional), authoritative comparison,
    risk register, staged plan and gates. docs/15: resolution of findings. docs/06/07:
    approved pre-G1 read-background test M5a (informational, not a G1a/G1 input) and
    open items. CLAUDE.md: layout, status and cartridge-round decisions.
    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
    [m5a_read_background.csv]
2026-11-12 Add session record (docs/17) and the agents' working scripts and outputs (scripts/chip_round)
    docs/17: every question and answer of the round, agent tasks, orchestrator interventions,
    interruptions, commits and where each output is. scripts/chip_round: the calculation
    scripts behind docs/09-16 with their outputs, kept as a record (not runnable as they stand).
    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
2026-11-13 Add card-dock interface definition for cartridge A (docs/18, cad/elisa_cad/interface.py)
    Physical design round, phase 1: coordinates of all valves, ports, windows,
    datums and dock space claims; shared CAD export helpers; plan drawings.
    Claude-Session: https://claude.ai/code/session_01DhDzF5vCABzXoLN6nzpv9N
    [card_envelope.step, dock_space_claims.step]
2026-11-13 Add physical design of cartridge A for the C2 prototype (docs/19, cad/elisa_cad/card)
    Parametric CadQuery parts, STEP files, laser-cut profiles, die masks, renders.
    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
    [card_A_assembly.step, card_L0_foil.step, card_L1_channel_sheet.step, card_L1b_die_film.step, card_L1s_WE2_shim.step, card_L2_TPE.step, card_L3_body.step, card_L4_discs.step]
2026-11-13 Add dock lid and head design (docs/20, cad/elisa_cad/dock_upper); lower bay and base in progress
    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
    [V8_bush.step, assy_lower_bay_beadout_end.step, assy_lower_bay_collect_IC1.step, assy_lower_bay_drag_mid_IC1.step, assy_lower_bay_gather_IC1.step, assy_lower_bay_hold_RC.step, assy_lower_bay_load.step, base_assembly_with_claims.step]
2026-11-13 Add dock base, fluidics layout and enclosure design (docs/22, cad/elisa_cad/dock_base); lower bay in progress
    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
2026-11-13 Add dock lower bay design: nest, anvil, magnet bay, electrode bay (docs/21, cad/elisa_cad/dock_lower)
    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
    [assy_lower_bay_beadout_end.step, assy_lower_bay_collect_IC1.step, assy_lower_bay_drag_mid_IC1.step, assy_lower_bay_gather_IC1.step, assy_lower_bay_hold_RC.step, assy_lower_bay_load.step, part_Mc1_bracket.step, part_Mc1_carrier.step]
2026-11-13 Integrate card and dock modules (docs/23, interface Revision B, top-level assembly)
    Resolves the interface change requests of the four modules in interface.py
    Revision B, rebuilds all modules from it, adds the top-level assembly with
    cross-module interference checks against the real card model, and reduces
    cad/out to about 59 MB.
    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
    [V8_bush.step, assy_lower_bay_beadout_end.step, assy_lower_bay_collect_IC1.step, assy_lower_bay_drag_mid_IC1.step, assy_lower_bay_gather_IC1.step, assy_lower_bay_hold_RC.step, assy_lower_bay_load.step, base_assembly_with_claims.step]
2026-11-13 Resolve the review findings of the dock and cartridge design (interface Revision C, docs/24 §8)
    Carry-over budget closes on paper again (narrower sample line, incubation
    pumps beside the bay), cold-zone heat budget corrected and redesigned,
    slot valves and drag magnet holder changed for gate overlap and foil
    deflection, closing forces set at the real tip height, face-seal annulus
    removed, docking timeline added. All modules and the assembly rebuilt.
    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
    [V8_bush.step, assy_lower_bay_hold_RC.step, base_bottles_pneumatics.step, base_brackets.step, base_cold_compartment.step, base_drip_tray.step, base_electronics.step, base_enclosure_panels.step]
2026-11-13 Work in progress: module renders switched to the z-buffer renderer (rebuild still running)
    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
    [card_A_assembly.step, card_L0_foil.step, card_L1_channel_sheet.step, card_L1b_die_film.step, card_L1s_WE2_shim.step, card_L2_TPE.step, card_L3_body.step, card_L4_discs.step]
2026-11-13 Work in progress: fix base render helper; module rebuilds still running
    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
    [V8_bush.step, assy_lower_bay_hold_RC.step, base_bottles_pneumatics.step, base_brackets.step, base_cold_compartment.step, base_drip_tray.step, base_electronics.step, base_enclosure_panels.step]
2026-11-13 Work in progress: partial module outputs while rebuilds run
    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
    [base_bottles_pneumatics.step, base_brackets.step, base_cold_compartment.step, base_drip_tray.step, base_electronics.step, base_enclosure_panels.step, base_frame.step, base_gamry_route_bench.step]
2026-11-13 Rebuild base and card renders with the z-buffer renderer; lid and lower bay still running
    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
    [V8_bush.step, bridge.step, bridge_spacers.step, button_family.step, cam_eccentrics.step, cam_lever.step, cam_shaft.step, card_envelope_ref.step]
2026-11-13 Render all module views with the z-buffer renderer
    The depth-sorted module renders drew far faces over near ones (stray
    triangles on the card views). common.render_png and the base renderer now
    delegate to assembly/zrender.py; long titles are wrapped. Geometry and
    check results are unchanged.
    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
    [assy_lower_bay_hold_RC.step, part_Mc1_bracket.step, part_Mc1_carrier.step, part_Mc1_holder.step, part_Mc1_link_lower.step, part_Mc1_link_upper.step, part_Md_Zunit.step, part_Md_adapter.step]
2026-11-13 Add exploratory note on a multi-analyte affinity electrode chip (docs/26)
    Desk note outside the docs/00 scope: multi-site electrode die with ligands
    beside the metal for bioreactor samples on the gen-1 tubing rig, surface
    renewal options, and estimated electrochemical cleaning pulses (starting
    values for a bench test). No model run; no decision or parameter changed.
    Claude-Session: https://claude.ai/code/session_01DhDzF5EedqZ9PqYYodCi5N
